ZAN-Tech-bd/WRO_Rizwanul-Rafeeul-Luban/PCB design/hub/RELEASE-2026-10-28.md

# Hub — repour after the user's final edits, 2026-10-28

> **Historical snapshot:** the synchronization finding in this review was subsequently traced to
>25J3property mismatches and fixed; [strict DRC/ ERC now pass](SYNC-FIX-2026-10-28.md). The user also
> added a raster image. [Latest standard files and the image-export warning](fabrication/20261028-sync-fixed/README.md)
> supersede this folder for the current board. The previous geometry/hardware evidence remains relevant.

## Current files and release status

**The ground is restored and the new fabrication files are generated.** The geometric checks below
pass for a **two-layer, 1 oz, hand-soldered bare PCB**. This is a fabrication-review package, not an
unconditional production release: one schematic/PCB synchronization finding remains, and the switch
fit/contact sequence and full-load thermal performance have not been physically qualified.

- [Latest Gerber ZIP](fabrication/20261028-after-user-edits/WRO_HUB_GERBER_20261028_AFTER_USER_EDITS.zip)
- [Matching complete project](fabrication/20261028-after-user-edits/WRO_HUB_PROJECT_20261028.epro2)
- [Raw EasyEDA BOM](fabrication/20261028-after-user-edits/WRO_HUB_RAW_BOM_20261028.csv)
- [Native geometry/preservation audit](fabrication/20261028-after-user-edits/AUDIT.json)
- [Gerber/drill/BOM inspection](fabrication/20261028-after-user-edits/MANUFACTURING-INSPECTION.json)
- [Checksums](fabrication/20261028-after-user-edits/SHA256SUMS.txt)
- [Independent review and verification-tool follow-ups](fabrication/20261028-after-user-edits/REVIEW.md)

These supersede all October 27 Gerbers. Earlier files actually written by the old finalizer were
under the repository-root `exports/`, despite some old handoff links saying `PCB design/exports/`.
Use only the dated folder linked above for this revision. Do not fabricate a pour-removed checkpoint
or either failed custom-device import package.

Current editable project remains **WRO_HUB_REPAIR_ISOLATED_20261027**, local file
[recovered/WRO_HUB_REPAIR_ISOLATED_20261027.eprj2](recovered/WRO_HUB_REPAIR_ISOLATED_20261027.eprj2).
Project UUID `ea32443fed8f1fd5989b3f8520da07a81d65c35e38ca7f144b04f7dc31730e1f`,
PCB UUID `8efe5b895e7646ea`, schematic UUID `a013c67bfde245d3`.
The original WRO_HUB project has damaged device metadata and is not the working copy.

## What the user changed; what the repour changed

The fresh pre-pour backup is
[WRO_HUB_REPAIRED_user_edited_20261027-2358.epro2](WRO_HUB_REPAIRED_user_edited_20261027-2358.epro2).
Relative to the pour-removed editing checkpoint, the user moved R5 to **(1605, 1305) mil, rotation 90°**,
rerouted SERVO_IN, SD_SCK and part of +5V, and moved the SD_SCK via. Ten tracks were added, seven
removed; pad-net assignments remained unchanged. R5 remains outside the modeled microSD-module strip.
The previous agent placement at (1890, 1335) is historical, not the current pose.

The agent regenerated GND from these edited native footprints, pads, tracks and vias. It did **not**
restore old polygons or move any component/via/route. Final snapshot:
[WRO_HUB_REPAIRED_repoured_20261028-0009.epro2](WRO_HUB_REPAIRED_repoured_20261028-0009.epro2).

Preservation was checked across all **86 project documents**:

- **2,331 GND fills added:** 682 top, 1,649 bottom.
- All 633 copper track bodies match the user's backup exactly as a multiset.
- Two +5V track IDs changed while their bodies remained identical; a batch guard stopped first.
  Only after full geometry equality was established was the guard refreshed and the pour resumed.
- Other non-fill bodies, including all placements, pad nets, footprints, source nets, schematic and
  device metadata, are unchanged. Allocator records changed as expected when fills were created.

## Current measured checks

| Check | Current result |
|---|---|
| Parts / component plus mounting pads / copper tracks / vias | 77 / 274 / 633 / 280 |
| Named nets | 74; all named routed networks connected, including the regenerated GND |
| Current schematic versus current PCB | **256 named pin memberships match**, zero differences |
| Fresh ERC | **true**, detailed findings empty |
| Strict PCB DRC | **0 physical findings; 1 Netlist Error / Import Changes finding** |
| Saved GND versus foreign copper | 0 overlaps, 0 clearance violations, 0 disconnected GND items or floating fill-only islands |
| Minimum new-fill clearances | 11.8998 mil normal, 39.8989 mil left, 49.8996 mil isolated source nets |
| GND to edge / conservative antenna keep-out | 16.0 mil / 7.9131 mil |
| Minimum other-net copper spacing | 0.152001 mm; four legacy pairs are just below nominal 6 mil but above JLC 1 oz 0.10 mm |
| Existing non-fill copper to board edge | 0.9130 mm minimum |
| Drill spacing / hole-to-foreign-copper limits | zero violations against checked 0.20/0.45 mm and 0.20/0.28 mm limits |
| Minimum component PTH ring | Q1, approximately 0.1825 mm; absolute 0.18 mm met, recommended 0.25 mm not met |
| Minimum existing via ring | 0.1525 mm (reported separately from component PTH rings) |
| Visible text | 187 objects; native size/stroke >=40/6 mil, measured pad/text/edge bounds pass |
| Actual antenna extension | no existing copper or new GND in the modeled radiating projection |

The plane design targets remain **12 mil normal / 40 mil left-power region / 50 mil to
BAT+/BAT−/DC+/DC−/V12**. The small differences in measured minima are polygon simplification/rounding
covered by a 0.2 mil geometric tolerance. Native pad offsets are below 0.007 mil; this is also much
smaller than that tolerance. These large new-plane gaps do not imply every pre-existing trace/via
in the power area has 1 mm spacing. BAT− and DC− remain distinct from GND except through J3.

The morphological filter discourages narrow plane features; it is **not** proof that every local
neck or thermal path meets a specified current capacity. Geometric connectivity does not qualify 8 A.

Rules were checked against [JLCPCB capabilities](https://jlcpcb.com/capabilities/Capabilities), using
the previously reviewed two-layer 1 oz limits. Changing to 2 oz needs another review: the 0.152 mm
legacy gaps do not meet the cited 0.16 mm 2 oz spacing.

## What was checked in the actual manufacturing output

- ZIP integrity and the exact expected 11-file set.
- Gerber outline is one closed rectangle, **136.398 × 100.965 mm**, bounds x −17.145..119.253 mm,
  y 0..100.965 mm; stale native outline line records are not extra exported outlines.
- **All 548 round holes and six plated slots** match native positions and dimensions. The standard
  separate via-drill file contains the same 280-via subset already present in the through-drill file.
- J1/J2/J4 have their approved **4.0 mm** drills; J5 has **2.5 mm** drills. Corrected Q1 copper aperture
  is present in the actual top-copper Gerber, not merely in editor getters.
- All six J3 slots are explicitly marked **PLATED**, 1.8 mm diameter with a 6.0 mm tool-centre travel:
  **7.8 mm total slot length**, matching the custom footprint and all six preserved pad-net assignments.
  Complete capsule geometry, including orientation, is matched one-to-one against native slot shapes.
- Raw BOM quantity totals 77 and J3 identifies as KCD4-203-B, without the old C20088586 supplier number.

## Remaining release gates — do not hide these

1. **Synchronization:** strict DRC is not entirely clean. There is one generic Netlist Error. Current
   electrical membership matches at every named pin, and native preservation is proven, but the API
   cannot enumerate the exact ECO discrepancy here; the direct PCB netlist call timed out. J3's
   retained library association and old BOM footprint alias are known metadata debt, not proof that
   this is the sole reason for the finding. Inspect the proposed differences manually before any
   full production release; do not apply an ECO that replaces J3's six custom plated slots. No
   schematic import, rule suppression, device standardization or library modification was used.
2. **Real parts / assembly:** verify KCD4 blade fit with a 1:1 print or actual prototype, slot tolerance
   with the fabricator, mechanical support and break-before-make/centre-off behavior. Retain the six
   pin/net mapping in the spec. Confirm the actual microSD module envelope/underside clearance and
   Q1 lead order. The BOM's SS8050 library alias is not the approved user-supplied 2N2222A selection.
3. **Power qualification:** source-track width, GND connectivity and thermal spokes do not prove the
   intended ≈8 A worst-case load safe. Measure voltage drop and temperature, including connectors,
   switch, vias and thermal necks, on the assembled prototype. No switch or PCB current rating is claimed.
4. **Human fabrication review:** inspect JLC's rendered layer/drill/slot preview and the complete PCB
   visually. No order, payment or procurement has been performed.

The Gerber is suitable for **fabrication review of this prototype geometry**. It is not labeled
"all blockers resolved" or "unconditionally safe to order" while the above checks remain open.

An independent read-only review confirmed the current package geometry and prompted two strengthened
acceptance checks (slot orientation/bijection and fill-only island rejection). Both fixes were verified
RED→GREEN without changing the PCB. Two minor checker improvements remain explicitly deferred;
see [the review record](fabrication/20261028-after-user-edits/REVIEW.md).

## How to reproduce the checks

Read the source headers before running anything. The release scripts are intentionally pinned to
this revision; never replay a historical writer on a newer user layout.

The final full Hub model suite reports **54 tests: 41 passed, 13 skipped**. The skips are historical
archive-acceptance cases requiring explicit before/after fixture paths, not executed passing tests.
The current release is checked separately by the direct archive/pin/geometry/output audits. Four
focused release regressions cover identity/body preservation, metric drill parsing, rotated/reused
slot rejection and fill-only island rejection.

- [release_audit_20261028.py](../scripts/hub/release_audit_20261028.py): saved-body preservation,
  ground/track/hole/ring/edge/connectivity/text checks and current schematic pin-net comparison.
- [publish_fabrication_20261028.py](../scripts/hub/publish_fabrication_20261028.py): actual Gerber/drill
  inspection and uniquely named package; retains raw BOM and its aliases rather than inventing parts.
- Current evidence and test logs: [release_20261028](../scripts/hub/data/blocker_fix_20261027/release_20261028/).
- Reusable [PCB review lessons](../PCB-REVIEW-LESSONS.md), especially the recovery/API and release gates.

For another edit cycle: full backup, fresh native and live snapshots, recompute the plan from the
edited geometry, guard every write, inspect a new saved export, rerun current checks, create a new
dated manufacturing folder, and mark this folder superseded. Do not overwrite old review evidence.
