ZAN-Tech-bd/WRO_Rizwanul-Rafeeul-Luban/PCB design/station/REVIEW-2026-10-26.md

# Station manual-layout review — 2026-10-26

> **RELEASED 2026-10-28:** findings 1–2 closed (J1 designator moved off the HUB CABLE label;
> identifier corrected to "Station PCB V0.4"); finding 4 closed — fresh Gerber/drill exported and
> CAM-audited into [fabrication/20261028-final/](fabrication/20261028-final/README.md) with a
> clean strict DRC in the same run. Copper untouched (59 tracks / 1 via / 209 fills verified).
> Findings 3 and 5 remain **hardware gates for the user** (1:1 print fit, BC557 C/B/E, buzzer
> polarity, bring-up). Upload set: `STATION_GERBER_20261028_FINAL.zip`.

## Verdict

The redesigned routing and regenerated bottom ground plane **pass the electrical layout checks performed**. No
electrical routing blockers were found. This is a prototype layout review, **not unconditional manufacturing approval**:
one silkscreen overlap needs cleanup, physical component fit/pin order still need confirmation, and the exported
Gerber/drill files have not been independently audited for this revision.

## Changes made

- Added bottom-only GND copper, regenerated from the user's current geometry rather than restoring stale polygons.
- Added 209 static, hole-free GND fill pieces. Together these form one electrically continuous network, not 209
  disconnected islands. Area: approximately 1246.57 mm².
- Thermal reliefs on all seven THT GND pads: nominal 10 mil gap and 15 mil spoke width.
- Saved the editor document. Made full project backups before and after; both archives passed integrity checks.
- **Preserved:** all 59 user track segments, one DIN via, eleven components, pads, board outline and silk polylines.
  Before/after geometry comparisons passed. Silkscreen text was not edited.

## Verified results

| Check | Result |
|---|---|
| Actual outline | 50.8 × 31.877 mm, two layers |
| Current strict EasyEDA DRC | Passed; zero error categories, including no unrouted connections |
| Pad net assignments vs station spec | Match; 12 nets, 34 wired pads, J4.4 intentionally NC |
| All 11 non-GND nets | One physically connected copper network each |
| Ground connectivity, including actual read-back fills | One network; BZ1.2, J1.2, J2.2, J3.2, J4.2, R3.2, U2.2 joined |
| Track/pad/via clearance below 6 mil | None detected by independent geometry checks |
| Copper-to-edge, mounting-hole, drill-spacing checks | No reported violations |
| Checked JLC drill-to-other-net copper rules | No reported violations |
| 5V and 3V3 track widths | 1.0 mm throughout; no thin power segments flagged |
| Component-pad annular ring | Minimum approximately 9.85 mil |
| Ground fill vs other-net copper | Zero overlaps; zero gaps below 10 mil |
| Ground fill vs board edge | Minimum 12 mil (0.3048 mm) |
| Read-back fill shape vs generated plan | 209/209 matched; no shape differences above 0.3 mil |
| Ground floating islands | None detected |
| Connector / rotated BC557 C-B-E labels | Coordinate/pad-map spot-check agrees |
| Silkscreen text on pads, holes or beyond the edge | None reported |
| Live-geometry adapter regression tests | Seven passed |

## Findings and remaining work

1. **Silkscreen cleanup:** J1's reference text overlaps **HUB CABLE (1:1)**. Move one label before fabrication. This does
   not affect electrical connectivity. The review did not change the user's labels.
2. **Identification:** the team marking is present, but no board name/revision string was found among the live silk
   text. Add an identifier to distinguish this manual layout from the older v0.4 geometry.
3. **Physical checks:** print 1:1 and check the actual upright IR module, cable access, connector orientation and screw
   heads. Confirm the purchased BC557's actual C/B/E order and the active buzzer's polarity. Geometric net checks do
   not validate a different locally purchased transistor/module pin-out.
4. **Fabrication gate outstanding:** export fresh Gerber/drill files and independently inspect them, especially GND
   copper and thermal spokes. No manufacturing files were approved or ordered during this review.
5. **Bring-up still required:** continuity/short tests before power, verify 5V/3V3 rails, then test the sensors, buzzer
   and LED chain per the [station specification](STATION-SPEC.md). Current capability and signal integrity have not
   been physically measured; 1.0 mm power tracks are encouraging but are not a thermal test or regulator/cable audit.

## Important: static ground copper

The existing bridge/pour-engine limitation is handled with static fill primitives and an independent read-back check.
These fills do **not automatically move out of the way of later track, via, pad or outline edits**. Regenerate from a
fresh live snapshot and recheck them after every such change. Restoring old polygons or merely rebuilding native
copper is not a safe substitute. The newly generated writer checks its source geometry immediately before writing
and refuses intervening changes. Historical placement/route/fill scripts do not describe this manual revision.

## Decisions and provenance

- User's manual placement/routing is the baseline; do not redraw or optimize it during a pour/review request.
- Keep the previously requested bottom-only GND policy. No extra GND vias or top copper were added.
- Reuse the existing thermal/fill algorithms, but supply absolute live pad geometry, the shortened outline and moved
  mounting holes. The old layout model would have poured against incorrect geometry.
- Use the absolute pad API's drill state: component-pad proxy drill values differed from absolute pad values in this
  editor. The adapter explicitly rejects the proxy format and unknown geometry rather than silently estimating it.

## Files and reproducibility

- Full project: [before GND](station_pcb_manual_before_gnd_20261026.eprj2),
  [reviewed with GND](station_pcb_manual_gnd_reviewed_20261026.eprj2).
- Exact live state: [before](../scripts/station/data/snapshot_before_gnd_20261026.json),
  [after](../scripts/station/data/snapshot_after_gnd_20261026.json).
- Read-only capture: [31_snapshot](../scripts/station/31_snapshot.js).
- Snapshot-based model: [manual_model](../scripts/station/manual_model.py),
  [regression tests](../scripts/station/test_manual_model.py).
- Offline review/generation: [32_review_manual](../scripts/station/32_review_manual.py).
- Machine-readable result: [geometry review](../scripts/station/data/manual_review_20261026/snapshot_after_gnd_20261026_review.json),
  [strict DRC](../scripts/station/data/manual_review_20261026/drc_after.json),
  [silkscreen](../scripts/station/data/manual_review_20261026/silkscreen_after.json).
- Images: [pour preview](../scripts/station/data/manual_review_20261026/data/fill_preview.png),
  [editor view](../scripts/station/data/manual_review_20261026/editor_after_gnd.png).
- Generated writer and polygon plan are kept in the
  [review artifact folder](../scripts/station/data/manual_review_20261026/). Do not apply them to changed geometry.
