ZAN-Tech-bd/WRO_Rizwanul-Rafeeul-Luban/findings.md

# Project Audit Findings

## 2026-08-13 — Primary Hub synchronization baseline

- The requested direction is one-way: use [`firmware/hub-ota/`](firmware/hub-ota/) as the newest feature reference and update [`firmware/hub/`](firmware/hub/) with all non-OTA behavior.
- The explicit exclusion boundary includes BLE OTA service code, NimBLE, authentication/password constants used only by OTA, uploader tooling, OTA write/pause hooks, and the dual-slot custom partition table. Generated `.pio` content is never a synchronization source.
- Initial Git baseline is clean: both `git diff --stat` and `git diff --cached --stat` are empty. This makes the coming Hub-only changes attributable to this synchronization task.
- Existing planning records show that the newer copy contains at least one post-copy feature family not present in the primary Hub documentation: the Hub DHT11/MQ pin scan, firmware-served `/scan` page, `/api/sensors`, sensor-to-artifact-health mapping, and corresponding admin UI. Exact file-level differences still require source classification before porting.
- Exhaustive non-generated inventory found 11 byte-identical shared files, including every deployed file under [`firmware/hub/data/`](firmware/hub/data/), [`PhotoStore.h`](firmware/hub/include/PhotoStore.h), and [`PhotoStore.cpp`](firmware/hub/src/PhotoStore.cpp). The browser bundle and gallery layer therefore need no byte changes.
- Exactly five shared paths differ: [`README.md`](firmware/hub/README.md), [`MuseumState.h`](firmware/hub/include/MuseumState.h), [`config.h`](firmware/hub/include/config.h), [`main.cpp`](firmware/hub/src/main.cpp), and [`platformio.ini`](firmware/hub/platformio.ini).
- Exactly seven non-generated/newer-only files were found. Two are reusable sensor implementation files ([`HubSensors.h`](firmware/hub-ota/include/HubSensors.h) and [`HubSensors.cpp`](firmware/hub-ota/src/HubSensors.cpp)); five are OTA-only/generated exclusions ([`ble_ota.h`](firmware/hub-ota/include/ble_ota.h), [`ble_ota.cpp`](firmware/hub-ota/src/ble_ota.cpp), [`partitions.csv`](firmware/hub-ota/partitions.csv), [`ble_ota_upload.py`](firmware/hub-ota/tools/ble_ota_upload.py), and its Python bytecode cache).
- [`MuseumState.h`](firmware/hub-ota/include/MuseumState.h) extends health rows with per-channel validity and simulated/interpolated provenance, and adds the fixed-size per-pin sensor scan table. These are application-domain changes, not OTA mechanics, and belong in the primary Hub.
- [`config.h`](firmware/hub-ota/include/config.h) contains a large reusable sensor configuration section followed by a clearly isolated BLE-only tail. The sensor section must be ported; the `BLE_DEVICE_NAME`, `BLE_MTU`, `BLE_OTA_PASSWORD`, and `BLE_OTA_STALL_MS` tail must not be ported.
- One diagnostic `wc` command used shell brace syntax that the executor did not expand, so its line-count subcheck failed without changing files. Do not repeat that form; use explicit paths or a Python inventory. The surrounding diff/grep operations still completed and exposed the needed classification.
- Function-level comparison of [`main.cpp`](firmware/hub/src/main.cpp) identifies only three actual OTA couplings in the newer entry point: the [`ble_ota.h`](firmware/hub-ota/include/ble_ota.h) include, the [`bleOtaBegin()`](firmware/hub-ota/src/main.cpp:1123) setup call, and the [`bleOtaInProgress()`](firmware/hub-ota/src/main.cpp:1182) Core-1 pause guard. Two nearby `/scan` comments also mention BLE deployment but do not affect behavior. This makes a copy-then-remove strategy precise and reviewable.
- All other entry-point changes are reusable application features: 56-pixel chain ownership and brightness, whole-station 8-pixel indication, idle color-flow effect, synchronized red emergency double-flash, local sensor state integration, null-safe health JSON with provenance/air-quality verdicts, sensor JSON, firmware-resident scan UI, two new HTTP routes, sensor initialization/update, and seven-station measured/interpolated health filling.
- [`HubSensors.cpp`](firmware/hub-ota/src/HubSensors.cpp) has no OTA dependency. It implements separate safe paths for DHT11 timing probes and MQ D0/ADC1 observation, explicit continuity/electrical-result diagnostics, mapped artifact-health updates, and derived rows for unmapped/stale stations. It depends only on the reusable sensor/state/config declarations and belongs unchanged in the non-OTA target.
- The reusable [`config.h`](firmware/hub-ota/include/config.h:19) delta is larger than sensors alone: it changes the physical LED chain from one pixel per station to 56 pixels (seven 8-pixel boards), adds a global brightness cap, idle comet timing, and synchronized red emergency double-flash timing. The configured sensor loom is eight GPIOs with explicit DHT11/MQ roles, per-pin artifact mapping, D0 polling, gas threshold/calibration constants, and stale-data timing. The BLE-only section begins cleanly at line 213, after all shared gallery configuration.
- [`MuseumState.h`](firmware/hub-ota/include/MuseumState.h:14) is entirely reusable and has no OTA symbols. Its health model prevents unmeasured channels from appearing as zero, records measured-versus-derived provenance and freshness separately for temperature/humidity and gas, adds the complete Hub-local pin state, and exposes [`healthRowLocked()`](firmware/hub-ota/include/MuseumState.h:100) for safe partial-channel updates.
- README classification is clean: copy the newer wiring/sensor diagnostics and API schema, retain the primary target's USB build/flash instructions, and omit the entire Bluetooth update and custom dual-slot partition chapters. Two sensor/scan sentences that currently describe BLE-only deployment must be rewritten generically for a firmware-resident route; the API should not claim a “BLE-only update.”
- [`platformio.ini`](firmware/hub/platformio.ini) needs no dependency or partition change: its existing single [`env:hub`](firmware/hub/platformio.ini:11), default partition behavior, LittleFS setting, common include path, and Adafruit NeoPixel dependency are sufficient for all reusable features. The newer common-section refactor, custom partition selection, and NimBLE dependency are OTA infrastructure and must stay out.
- During integration review, the newer [`MSG_HEALTH`](firmware/hub/src/main.cpp:206) path was found to populate numeric fields without setting the new `hasTH`/`hasGas`, provenance, or freshness fields. Under the new JSON/derivation model this would hide valid remote readings as `null` and let synthetic fallback overwrite them. The primary non-OTA target now marks both channels measured/fresh when a valid ESP-NOW health packet arrives. This is a compatibility fix required by the newer state model rather than an OTA exclusion.
- A clean project-owned exclusion audit scanned all 18 files under [`firmware/hub/`](firmware/hub/) while pruning `.pio` and `__pycache__`. All four forbidden paths are absent; core source/configuration assertions found no BLE service symbols, NimBLE/Bluetooth dependency, BLE-only constants, custom partition selection, uploader protocol, or OTA pause hook.
- The scoped text audit found one generic `OTA` word in a multipart-upload explanatory comment, not executable integration. It was reworded as a normal WebServer file-upload comment so the final source-level exclusion audit can require zero BLE/OTA candidates without exceptions.
- Initial mechanical parity already proves exact path accounting (18 primary files versus 18 reusable reference paths), SHA-256 equality for all 14 ordinary reusable files, and exact equality between the primary configuration and the reference prefix before its BLE-only section. Its first entry-point normalization stopped because the audit encoded the wrong literal formatting for the three known seams; source search confirmed the reference uses an inline-commented include, a commented setup call, and a one-line pause guard.
- Corrected mechanical entry-point normalization asserted and removed exactly one include, one setup call, and one Core-1 pause guard from the reference. The complete residual diff has only four expected hunks: the intentional `MSG_HEALTH` validity/provenance/freshness correction, the generic multipart-upload comment rewrite, the firmware-resident `/scan` deployment comment rewrite, and deletion of the now-orphaned flash-write pause comment. No reusable executable behavior is missing.
- Clean firmware build succeeds on the default non-OTA partition: Flash 71.8% (941,741 / 1,310,720 B), RAM 14.8% (48,528 / 327,680 B). The PlatformIO dependency graph resolves `Adafruit NeoPixel @ 1.15.5` plus the Arduino Wi-Fi/WebServer/LittleFS/SD/DNS stack only; `h2zero/NimBLE-Arduino` is absent, proving the OTA dependency did not transfer.
- LittleFS image builds from the 318,566-B data tree (9 files) into a 1,441,792-B `littlefs.bin`, so the deployed web bundle and optional SD-backed gallery remain valid under the unchanged [`platformio.ini`](firmware/hub/platformio.ini:1).
- Final `git status` scope is seven modified paths plus two new sensor-module files; [`firmware/hub-ota/`](firmware/hub-ota/) is untouched, so the feature reference is preserved for future comparison.
- Full review of [`firmware/hub/README.md`](firmware/hub/README.md) confirms it documents the reusable 56-pixel station boards, double-flash emergency display, explicit DHT/MQ roles and electrical limits, station mapping and measured/derived health semantics, firmware-resident `/scan`, expanded `/api/sensors` schema, and ordinary USB firmware/filesystem deployment. Its omission of the reference copy's BLE update and custom-partition chapters is intentional.
- Synchronization is complete: all five HUB-SYNC phases done, both builds pass on the default non-OTA partition, and the working tree contains only the intended Hub product files and planning records.

## 2026-08-11 — Diagram 6 production restoration

- Locked outputs are [`diagrams/06_protocol_interface_contract_map.drawio`](diagrams/06_protocol_interface_contract_map.drawio) and [`diagrams/06_protocol_interface_contract_map.png`](diagrams/06_protocol_interface_contract_map.png), with exact title `06 — Protocol & Interface Contract Map`.
- This is the sixth and final new parent-suite page. Accepted Diagrams 1–5, every alternate Draw.io/PNG pair, and [`diagrams/README.md`](diagrams/README.md) are immutable. [`diagrams/09_message_reference.drawio`](diagrams/09_message_reference.drawio) is a non-authoritative, ownership-unknown reference only and will not be edited, cloned, renamed, or claimed.
- The restored visual system is 1600×900 off-white landscape with 28 px navy title, current-source authority chip, rounded tinted subsystem cards, restrained shadows, transport-colored orthogonal connectors, compact code-font pills, white-backed labels, and line/text status semantics that remain understandable in grayscale.
- The restored working-combo interface matrix requires explicit separation of effective Hub→Robot EMERGENCY, ignored Camera IMAGE_READY, senderless Robot LOCATION, active Robot↔Nano UART, active one-way Robot→Camera SHOOT, active Camera→Hub multipart upload, independent Hub and Robot SoftAP/HTTP services, and standalone Mega commands with no runtime sender.
- Diagram 6 will be organized by transport rather than by controller. A field-diagnostic matrix will identify payload/contract, emitted-by, accepted-by, consumed/effect, and status; a bottom strip will carry channel/common-ground/authority/no-link constraints.
- Fresh shared-header verification corrects an important checklist mismatch: current [`MuseumMessage`](firmware/common/MuseumProtocol.h:36) is packed and exactly 24 bytes by field arithmetic, with wire order/types `uint16_t magic`, `uint8_t version`, `uint8_t messageType`, `uint8_t nodeId`, `uint8_t stationId`, `uint8_t flags`, `uint8_t reserved`, `int16_t tempX10`, `int16_t humidX10`, `uint16_t gasRaw`, `uint16_t visitorCount`, `uint16_t sequence`, `uint32_t uptimeMs`, `uint16_t checksum`. It does **not** contain literal `robotMoving` or generic `value` fields; motion is encoded by `FLAG_ROBOT_MOVING`. The diagram must follow this current source rather than repeat a stale field list.
- Packet validity is exact-length enforcement at each current receiver plus [`isValidMessage()`](firmware/common/MuseumProtocol.h:75): magic `0x4D53`, protocol version `1`, and 16-bit additive checksum over every byte before the checksum field. The packed declaration has no explicit `static_assert(sizeof(...))`; the 24-byte result is the source layout's field sum and is also enforced by receiver `sizeof` checks.
- The shared declaration contains seven message types: `MSG_LOCATION=1`, `MSG_EMERGENCY=2`, `MSG_HEALTH=3`, `MSG_VISITOR_COUNT=4`, `MSG_IMAGE_READY=5`, `MSG_COMMAND=6`, and `MSG_HEARTBEAT=7`. Flags are emergency bit 0, obstacle bit 1, alert bit 2, online bit 3, and robot-moving bit 4. Diagram emphasis will remain on the four working-combo-relevant types while labeling the remaining declared types as dormant in this protected combination.
- Robot↔Nano is confirmed as 9600 8N1, newline-delimited, case-insensitive at the Nano. Robot emits `START`, `STOP`, `GET`, `SET ML n`, `SET MR n`, and `SAVE`; Nano additionally accepts manual aliases `MAN`, `1/F/G/W`, `0/S/X`, plus `LOAD`, but the protected Robot does not emit those aliases.
- Nano replies are `READY:STOPPED`, `STATE:RUNNING`, `STATE:STOPPED`, `TUNE ML=n MR=n`, `OK ML=n`/`OK MR=n`, `SAVED`, `LOADED` or `LOAD:NONE`, and `ERR:SYNTAX`/`ERR:KEY`/`ERR:UNKNOWN …`. Robot behaviorally consumes only READY/STATE, valid TUNE, and any `ERR:` (to clear pending); `OK`, `SAVED`, `LOADED`, and other lines are retained in the bounded event log but otherwise ignored.
- ML/MR are constrained to `0..255`; each valid SET emits `OK` then a complete `TUNE`, applies both channels immediately when already driving, and SAVE persists EEPROM magic `0x524C` plus both `int16_t` values. Robot's service UI treats only valid `TUNE` as confirmed; requested web values remain pending until the complete reported pair matches.
- Robot→Camera is source-proven one-way `SHOOT <station>\n`, station `1..7`, 9600 baud, Robot software TX GPIO14 to Camera UART RX GPIO13. Robot has no receive/acknowledgement path. This is the active correction to stale GPIO27 documentation.
- Robot's independent service SoftAP is `ESP32-MP3-RAIL` on channel 1. Its HTTP surface is `GET /`, `GET /api/state`, and POST `/api/volume?v=0..30`, `/api/motors?ml=0..255&mr=0..255`, `/api/motors/save?...`, and `/api/log/clear`; motor calls return pending HTTP 202 until Nano `TUNE` confirms, while log clear removes the bounded RAM event tape.
- Fresh Hub configuration verification fixes the browser/radio plane constants at SoftAP `MuseumHub`, WPA2 password `museum2026`, IPv4 `192.168.4.1`, and channel `1`; [`HUB_CHANNEL`](firmware/hub/include/config.h:12) is explicitly shared by SoftAP and ESP-NOW. [`STATION_COUNT`](firmware/hub/include/config.h:17) is `7`, [`GALLERY_MAX_PHOTOS`](firmware/hub/include/config.h:74) is `12`, and optional SD storage falls back to LittleFS rather than becoming an upload or motion dependency.
- Camera's shared dispatcher accepts service/bench commands `CAPTURE [station]`, `SHOOT [station]`, `SEND [station]`, `WIFI`, `AUTO <ms>`, `STATUS`, `LIST`, `INIT`, `FLASH ON|OFF`, and `HELP` from its USB console as well as its Robot-UART parser. The active Robot implementation emits only `SHOOT <station>`; Diagram 6 must not imply it emits the rest of the Camera service vocabulary. [`handleCommand()`](firmware/cam/src/main.cpp:405) also proves Robot-triggered `SHOOT` requires Hub Wi-Fi before capture, whereas `CAPTURE` can remain local-only.
- Camera capture is GC2145 RGB565 converted in software with `frame2jpg()`, retained as the latest JPEG in RAM, and optionally backed up to local SD. The active Camera→Hub contract is HTTP POST multipart/form-data to `http://192.168.4.1/api/image/upload?station=N`, exact part name `image`, filename `cam.jpg`, MIME `image/jpeg`, and boundary `----MuseumCamBoundary`; Camera treats HTTP `200` as success and does not consume the response JSON.
- After a successful HTTP upload, Camera optionally broadcasts a checksum-valid `MSG_IMAGE_READY` as node `10` over the unencrypted broadcast peer. Hub's exact-length/checksum ingress accepts and queues that packet, but [`processMessage()`](firmware/hub/src/main.cpp:172) has no `MSG_IMAGE_READY` case, so it has no behavioral effect and must be styled active-but-ignored rather than as upload confirmation or motion feedback.
- Current Hub packet behavior is deliberately narrower than the declared vocabulary: it consumes `MSG_LOCATION`, `MSG_EMERGENCY`, and `MSG_HEALTH`; actively emits `MSG_EMERGENCY`; and defaults all other valid types to no effect. No protected rail-Robot `MSG_LOCATION` sender exists, so that handler is senderless in the working combination. There is no packet authentication, encryption, sender allowlist, replay rejection, application acknowledgement, or guaranteed delivery.
- Hub HTTP groups are state (`GET /api/state`), visitor workflow (`POST /api/checkin`, `GET /api/enter`, `GET /api/request?id=...`, `POST /api/approve?id=...`, `POST /api/deny?id=...`), emergency/admin (`POST /api/emergency?on=N`, test-only `POST /api/robot/advance`), and images (`POST /api/image/upload?station=N`, `GET /api/image[?seq=N]`, `GET /api/gallery`, `POST /api/gallery/clear`) plus static/captive content. These Hub APIs are independent from the Robot's own SoftAP service APIs and have no direct Camera/HTTP authority over Nano motion.
- Hub multipart intake requires exact field `image` and MIME `image/jpeg`, enforces the source-defined `65,535`-byte maximum while streaming, checks saved-byte equality and JPEG SOI/EOI markers, then commits before returning HTTP `200` JSON `{ok,bytes,station,seq}`. This is framing/completeness validation, not a full JPEG decode. Current station parsing accepts `0..7`; an absent/out-of-range query retains station `0` rather than rejecting an otherwise valid upload.
- Fresh Hub setup/static verification confirms wildcard DNS on port `53`, exact SoftAP startup on channel `1`, a 16-entry ESP-NOW queue, an unencrypted AP-interface broadcast peer, and route registration matching the handler inventory. Static LittleFS responses are explicitly no-cache; recognized captive-probe paths redirect to `http://192.168.4.1/`, while unknown paths return `404`.
- The deployed browser adapter selects the real backend only when [`location.hostname === "192.168.4.1"`](firmware/hub/data/js/hub.js:14); every other host/file origin uses a localStorage mock. Real browser state uses `GET /api/state` every `1500 ms`; visitor check-in/request, approve/deny, emergency, test advance, gallery/image, and clear calls match the registered Hub methods. Mutating calls are fire-and-forget and ordinary polling refreshes the UI; there is no WebSocket/SSE push or route authentication in this interface.
- Fresh standalone-Mega verification confirms both USB `Serial` and link `Serial1` accept newline-delimited commands at `9600` baud and dispatch through the same case-insensitive parser. The vocabulary is `FACE [HAPPY|NEUTRAL|ALERT|SLEEPY]`, `LANG <0|1>`, `STATION <id> <moving 0|1>`, `MENU`, `EMERGENCY`, and `BOOT|RESET`; unknown commands are ignored and logged to USB.
- Mega's implementation is a standalone renderer with no Wi-Fi or ESP-NOW. `Serial1` uses Mega pins `18/19`; comments propose ESP32 GPIO17 TX→Mega RX1 pin 19 with a 1 kΩ series resistor and common ground. However, the protected rail Robot assigns GPIO16/17 to DFPlayer UART2 and a fresh search finds no display-command sender in [`ESP32_RFID_MP3_RAIL/`](ESP32_RFID_MP3_RAIL/). Diagram 6 must therefore render the vocabulary as standalone/no active Robot sender and explicitly flag the GPIO16/17 ownership conflict instead of presenting a live wire.
- Mega parser bounds are permissive and must be represented accurately: `LANG` maps exactly `1` to Bangla and every other parsed/missing value to English; `STATION` does not reject malformed/out-of-range ids before rendering and shows `Unknown` outside `1..7`; its moving argument is Booleanized by nonzero `toInt()`. `FACE` defaults to happy when the optional emotion is absent or unrecognized. There is no UART acknowledgement/reply contract back to a Robot despite TX1 being physically available.
- Repository-wide sender search distinguishes protected working-combo authority from legacy/skeleton projects: the protected rail Robot contains no `esp_now_send`, `makeMessage`, or `MSG_LOCATION` emission; the only protected current sends are Hub `MSG_EMERGENCY` and Camera `MSG_IMAGE_READY`. A different legacy [`ESP32_RFID_MP3_LFR/`](ESP32_RFID_MP3_LFR/) source does emit LOCATION, but it is not the audited rail Robot and must not be used to activate the Diagram 6 edge. Skeleton emergency/health projects likewise do not expand the five-project working combination.
- Fresh deployed-page search confirms native QR entry uses exact URL `http://192.168.4.1/api/enter`; the visitor page polls request state and subscribes to the shared Hub cache; the admin page invokes approve/deny, emergency toggle, test-only robot advance, gallery list/image/clear, and the same 1.5 s state subscription. This locks the Browser↔Hub section to deployed calls rather than generic REST claims.

## 2026-08-11 — Diagram 5 production completion

- Published locked targets: [`diagrams/05_hub_software_concurrency_data_architecture.drawio`](diagrams/05_hub_software_concurrency_data_architecture.drawio) (51,314 bytes; SHA-256 `1574c3aa5d1fc8fc8b0d1eff837ddcbc4432938ad8a4c9dea7712a9562be3f97`) and [`diagrams/05_hub_software_concurrency_data_architecture.png`](diagrams/05_hub_software_concurrency_data_architecture.png) (1604×889, 373,921 bytes; SHA-256 `9b2c98aea7f42cd2adfbda3a84fbec8c546f9159c7cbaba1bd0f904ce871ad34`).
- The page is a single uncompressed Draw.io page (ID `EFE4jHzBdEskxg9Ux6jI`, `pageWithNumber`, ~51,171 page bytes) authored through official `@drawio/mcp` 1.5.0 `open_drawio_csv` and persisted/exported by official Draw.io Desktop 31.1.8. No Draw.io XML, Graphviz, or Mermaid was hand-authored; a deterministic Python generator emitted the CSV and a layout/edge pass applied geometry + materialized edges from the same MCP-imported model.
- Composition: five layered vertical zones — External actors (Visitor/Admin browsers on SoftAP `MuseumHub` @ `192.168.4.1`, ESP32-CAM multipart STA upload, GPIO21 button, rail Robot consumer), Core 0 `webTask` (captive DNS, WebServer, grouped HTTP routes, MultipartImageHandler, state read model), Callback boundary + synchronized state (recv cb → 16-slot queue → `processMessage`, mutex-protected `MuseumState`), Core 1 `loop()` (drain, settle, button FSM, annunciation, `pumpEmergencyBroadcast`, LEDs), and Storage + outputs (LittleFS + PhotoStore SD→LittleFS, SEQ.TXT, GPIO outputs, ESP-NOW TX). A lower notes panel records SD fallback, bounded gallery, concurrency safeguards, and the two working-combo gaps; a legend defines line/status semantics.
- All 32 source-authoritative semantic assertions pass, including the exact title, `MuseumHub`/`192.168.4.1`, Core 0 vs Core 1 split, callback→16-slot queue→drain boundary, `gState` under one FreeRTOS mutex, grouped routes (`/api/state`, check-in/enter/request/approve/deny, `/api/emergency`, test-only `/api/robot/advance`, image upload/gallery/clear, static/captive), multipart-only `MultipartImageHandler` with 65,535-byte cap + SOI/EOI validation + commit, SD-preferred→LittleFS-fallback PhotoStore with strict 8.3 `/photos/I00012S3.JPG` names, `/photos/SEQ.TXT` floor, bounded retention = 12, GPIO21/4/15 outputs, 6-frame 60 ms burst then 2 s periodic, NO ACK/AUTH, senderless `MSG_LOCATION · NO SENDER`, ignored `MSG_IMAGE_READY · HUB IGNORES`, volatile RAM, and no registered ESP-NOW peers.
- Visual QA from the native XML + pixel analysis + OCR: 0 genuine content overlaps (non-nesting), 46/46 nodes in correct zones, 29/29 edges, 0 % near-black pixels (mean brightness 229), all five zones populated (10–53 % colored), OCR confirmed exact title + five readable zone headers + distinct colored borders + no clipping. (Vision MCP hallucinated opaque "black blocks" twice; pixel analysis proved 0 black pixels.)
- Final integrity gate passes: all 24 accepted/alternate diagram artifacts + [`diagrams/README.md`](diagrams/README.md) byte-for-byte unchanged; all 5 protected product trees match their pre-task aggregate SHA-256; Diagram 6 was not begun.

## 2026-08-11 — Diagram 5 Hub source refresh

- Current [`firmware/hub/src/main.cpp`](firmware/hub/src/main.cpp) still implements one Core-0 network task and the Core-1 Arduino loop. [`webTask()`](firmware/hub/src/main.cpp:657) only services captive DNS and the synchronous HTTP server, while [`loop()`](firmware/hub/src/main.cpp:918) drains the 16-slot ESP-NOW queue, settles robot motion, synchronizes emergency state, debounces/handles the physical button, advances the nonblocking siren, transmits emergency state, renders LEDs, and delays about 5 ms.
- The Wi-Fi receive callback boundary remains deliberately small: [`enqueueMessage()`](firmware/hub/src/main.cpp:154) accepts only an exact, checksum-valid 24-byte packet, copies it to a local value, and performs a zero-wait queue send. No state handler, LED, siren, filesystem, or ESP-NOW transmission runs directly in that callback; queue-full loss remains silent.
- [`processMessage()`](firmware/hub/src/main.cpp:172) consumes only location, emergency, and health. The Hub therefore implements a location receiver even though the audited rail Robot has no sender; Camera image-ready packets have no case and no behavioral effect. These interfaces must use inactive/senderless styling rather than active-flow arrows.
- Cross-core [`gState`](firmware/hub/include/MuseumState.h:16) access remains serialized by [`stateLock()`](firmware/hub/src/main.cpp:124) and [`stateUnlock()`](firmware/hub/src/main.cpp:125). HTTP handlers mutate or snapshot under that mutex; Core 1 reads/updates the same model under the mutex. [`gPhotos`](firmware/hub/src/main.cpp:35) and multipart upload context are Core-0-only and intentionally have no independent mutex.
- Browser/admin emergency mutation in [`handleEmergency()`](firmware/hub/src/main.cpp:337) changes only the shared Boolean under lock and marks a dirty flag. Core 1 remains the sole ESP-NOW sender and output authority: it adopts shared state, updates annunciation, and runs [`pumpEmergencyBroadcast()`](firmware/hub/src/main.cpp:226). The diagram must not make a browser or callback directly drive radio, LEDs, or siren.
- Current HTTP registration at [`setup()`](firmware/hub/src/main.cpp:883) confirms grouped routes for state/check-in/request decisions, emergency, test-only robot advance, image retrieval/gallery/clear, and the dedicated multipart image handler. Static LittleFS content and recognized captive-probe redirects fall through [`handleFile()`](firmware/hub/src/main.cpp:631).
- Camera ingestion remains multipart-only. [`handleImageUploadForm()`](firmware/hub/src/main.cpp:395) checks field/MIME, enforces the 65,535-byte bound before each write, and streams to LittleFS scratch. [`handleImageUploadComplete()`](firmware/hub/src/main.cpp:466) validates nonempty size plus JPEG SOI/EOI, commits through the photo abstraction, then updates latest-image metadata under the shared-state mutex; rejection removes scratch and preserves the prior newest image.
- Current [`firmware/hub/src/PhotoStore.cpp`](firmware/hub/src/PhotoStore.cpp) confirms a single Core-0-owned storage abstraction: three SD mount attempts, LittleFS fallback, strict 8.3 names such as `/photos/I00012S3.JPG`, newest-first RAM index reconstruction, persistent `/photos/SEQ.TXT` floor, configured bounded retention, and LittleFS `/upload.tmp` staging even when final storage is SD.
- [`PhotoStore::commitUploadTemp()`](firmware/hub/src/PhotoStore.cpp:350) evicts to the configured limit before commit, copies validated scratch to SD or renames within LittleFS, inserts metadata, and writes the sequence floor. [`PhotoStore::clear()`](firmware/hub/src/PhotoStore.cpp:414) removes gallery images but deliberately retains the issued sequence floor so normal immutable image URLs are not reused; the source-proven 65,000-sequence reset remains an exceptional limitation.

## 2026-08-11 — OTA Hub flash-capacity analysis

- The copied target is [`firmware/hub-ota/`](firmware/hub-ota/); the original [`firmware/hub/`](firmware/hub/) was not edited for this request.
- Arduino-ESP32's active default 4 MiB partition table provides two 0x140000-byte (1.25 MiB) OTA app slots and a 0x160000-byte (1.375 MiB) SPIFFS/LittleFS region. The OTA-enabled Hub image is 955,125 bytes, or 72.9% of either default app slot.
- Exact project-owned/deployed files under [`firmware/hub-ota/data/`](firmware/hub-ota/data/) total 308,483 bytes. The largest asset is the offline decoder [`jsQR.js`](firmware/hub-ota/data/js/vendor/jsQR.js) at 256,885 bytes.
- Built-in `min_spiffs` is unsuitable because its filesystem cannot hold the current web bundle. Built-in `huge_app`/`no_ota` layouts are unsuitable because they remove the two-image OTA update model. A project-specific table is therefore the correct optimization, not arbitrary use of the largest app partition.
- Final [`partitions.csv`](firmware/hub-ota/partitions.csv) is contiguous and exactly fills 0x400000 bytes: NVS 0x9000–0xDFFF; OTA metadata 0xE000–0xFFFF; app0 0x10000–0x18FFFF; app1 0x190000–0x30FFFF; LittleFS 0x310000–0x3EFFFF; coredump 0x3F0000–0x3FFFFF.
- Each app slot is 1,572,864 bytes. PlatformIO's linked-section metric leaves 617,739 bytes; the stricter 961,696-byte OTA transfer artifact leaves 611,168 bytes of slot headroom. LittleFS is 917,504 bytes; subtracting raw deployed payload leaves a partition-level 609,021 bytes before filesystem metadata for upload scratch and gallery fallback.
- The configured 65,535-byte image ceiling is an acceptance bound, not the expected QVGA size. Physically verified Camera JPEGs are about 1.8–2.0 KiB, so 12 normal fallback photos plus scratch fit comfortably. The preferred gallery backend remains microSD.
- Application capacity failure is deterministic: PlatformIO/OTA rejects an image that does not fit the inactive app slot. It does not intentionally install half an image. Filesystem pressure is also checked: scratch open/write, byte-count, JPEG markers, and final commit must all succeed before image state is published; failure returns an HTTP error and discards scratch.
- Dual slots protect the running image from an interrupted transfer because ArduinoOTA writes the inactive slot before selecting it. Automatic rollback after a valid new image boots and later fails is not claimed; that would require an additional ESP-IDF rollback/health-confirmation policy.
- Changing partition geometry still requires one USB deployment because an already-running image cannot safely redefine its own flash map over OTA. The documented first deployment is erase → USB firmware upload → LittleFS upload; later firmware builds use authenticated `espota` to `192.168.4.1:8266`.
- Final clean validation passes for both environments. `hub` and `hub-ota` each use 51,736/327,680 B RAM (15.8%) and 955,125/1,572,864 B application space (60.7%); each generated firmware binary is 961,696 bytes.
- The two environment binaries have identical logic/payload bytes. Their only 65 byte differences are the expected 32-byte app ELF identity plus the 33-byte checksum/hash trailer, because PlatformIO builds each named environment separately.
- PlatformIO's generated `partitions.bin` decodes exactly to NVS 20 KiB, OTA metadata 8 KiB, app0 1536 KiB, app1 1536 KiB, SPIFFS-subtype LittleFS 896 KiB, and coredump 64 KiB at the intended offsets.
- `buildfs` succeeds and emits a 917,504-byte image. Unpacking it with the exact PlatformIO geometry (`4096` block, `256` page) reproduces all nine source files byte-for-byte, totaling 308,483 bytes.

## 2026-08-11 — Diagram 4 restoration

- Locked outputs: [`diagrams/04_emergency_authority_evacuation_behavior.drawio`](diagrams/04_emergency_authority_evacuation_behavior.drawio) and [`diagrams/04_emergency_authority_evacuation_behavior.png`](diagrams/04_emergency_authority_evacuation_behavior.png).
- Preserve every ownership-unknown alternate artifact; [`diagrams/05_emergency_path.drawio`](diagrams/05_emergency_path.drawio) is reference-only.
- The received request is truncated after the admin emergency endpoint, so omitted requirements must be recovered before authoring.
- The user authorized recovering the missing contract directly from current source. Hub HTTP implements `POST /api/emergency?on=N` by parsing `on` as an integer; `0` clears and any nonzero value raises, then marks the state dirty for Core 1 transmission on its next roughly 5 ms pass.
- Hub also adopts any checksum-valid incoming `MSG_EMERGENCY` Boolean and relays a real change. There is no sender-MAC/node allowlist, encryption, acknowledgement, or sequence/replay rejection. Therefore Hub is the runtime state owner/relay, not the exclusive origin.
- Physical GPIO21 is HIGH when pressed with internal pull-down backup and 50 ms debounce. A rising edge latches ON. Holding continuously for 3,000 ms clears; release cancels hold timing.
- Hub emergency outputs are nonblocking: all seven pixels toggle red/dark at about 250 ms, while a passive buzzer alternates 600 and 1,200 Hz every 400 ms. Browser pages receive the shared Boolean through ordinary `/api/state` polling; there is no push channel.
- Each state transition is announced immediately and as six total frames at 60 ms intervals, then the current Boolean is broadcast every 2 s. The code comment says immediate plus six repeats, but the implementation decrements `burstLeft` before each send, yielding six total transition frames; the diagram must use the implementation result.
- Robot's ESP-NOW callback only validates fixed packet shape/magic/version/checksum and copies the requested Boolean. [`applyEmergencyState()`](ESP32_RFID_MP3_RAIL/ESP32_RFID_MP3.ino:612) is first in the main loop before RFID and DFPlayer handling, so a newly received emergency outranks card/audio work.
- On raise Robot cancels a pending photo, clears narration and resume state, clears the normal stop latch, stops DFPlayer, and sends Nano `START`. While emergency is active every mapped card including START and stations is ignored except END UID `A3 C0 38 15`.
- END during emergency cancels any photo, sets the normal stop latch, stops DFPlayer, sends Nano `STOP`, and marks `emergencyStopReached`. Hub emergency remains ON, so Hub siren/red LEDs/browser banner continue; the Robot remains emergency-stopped at END and ignores all other cards.
- On clear Robot again cancels photo/audio activity, clears the emergency-END marker, sets `railStopLatched=true`, sends Nano `STOP`, and requires a fresh START card before normal motion can resume. Clearing never auto-resumes the tour.
- Safety/risk boundary recovered from source: channel 1 must match; ESP-NOW initialization/interference/mismatch can prevent behavior with no end-to-end confirmation; periodic state can resynchronize a late or rebooted Robot; Hub boots emergency false and initially broadcasts false; evacuation has no obstacle/end-position sensor beyond RFID END; Nano START/STOP is commanded but not acknowledged before the state transition proceeds; Mega display has no active integration edge.
- Visual comparison of accepted Diagrams 1–3 locks a consistent suite system: 1600×900 logical canvas exported near 16:9, off-white page, 28 px navy title, subdued subtitle, top-right current-source chip, rounded navy-framed major regions, 8–12% subsystem tints, restrained shadows on focal controllers only, white-backed compact technical labels, orthogonal transport-colored connectors, and bottom legend/authority material.
- Accepted Diagram 3 is the best layout predecessor for Diagram 4: a left-to-right time arrow, five compact numbered phase headers, seven actor lanes, two independent nested lifecycle boxes, and a lower full-width alternatives strip. Diagram 4 should reuse the title/phase/lane grammar but split the main body into a dominant crimson raise/evacuate path and a distinct green clear/recovery path rather than copying Diagram 3's normal-tour columns literally.
- The reference [`diagrams/05_emergency_path.png`](diagrams/05_emergency_path.png) is coherent but unsuitable as a base. It is very tall/dense, uses an oversized prose-heavy sequence, omits external-radio origin and risk/state insets, and incorrectly claims Hub-exclusive decision authority. Reusable concepts only are the numbered raise→broadcast→Robot→END→clear chronology, END-only card rule, and prominent manual START recovery. All wording and geometry must be rebuilt from current source in the new locked target.

## 2026-08-11 — Diagram 4 production completion

- Published locked targets: [`diagrams/04_emergency_authority_evacuation_behavior.drawio`](diagrams/04_emergency_authority_evacuation_behavior.drawio) (42,499 bytes; SHA-256 `461c95e6633275011bc8011eb1fded09dfdbbbe8112c95af9000ba88bca13b57`) and [`diagrams/04_emergency_authority_evacuation_behavior.png`](diagrams/04_emergency_authority_evacuation_behavior.png) (1602×902, 296,499 bytes; SHA-256 `79f70e3f4a52e1533fb2a8224f458749d1db44837c619b089e632c6635fe5285`).
- The page is a single uncompressed Draw.io page (ID `heWvcBr53x5kuSaETKAw`, `pageWithNumber`, ~42,394 page bytes) authored exclusively through official `@drawio/mcp` 1.5.0 `open_drawio_csv` (`isError: false`), then persisted/exported by official Draw.io Desktop. No Draw.io XML was hand-written; no Graphviz/Mermaid was used.
- The official Draw.io MCP native tool surface was not exposed in this session (`mcp__drawio__*` absent), so the same official `@drawio/mcp` server was driven over stdio with a small MCP-SDK client (the prior session's `wro-call-drawio-mcp.mjs` pattern), calling the identical `open_drawio_csv` / `list_pages` / `get_page` `tools/call`. This remains official Draw.io MCP authoring/inspection.
- Native XML geometry QA from the persisted model: 0 genuine content-content overlaps, 0 out-of-page nodes, 0 dangling edge refs, and all 29 required semantic IDs present. A downscaled-thumbnail visual sanity check confirmed the crimson raise/evacuate band, the green clear/recover band, the state-machine inset, and the risk panel with no severe defects. (Vision MCP timed out on the full-page render, as it did for Diagram 3.)
- All 68 source-authoritative semantic assertions pass: title; three origins (button GPIO21 50 ms debounce / 3 s hold clear, unauthenticated admin POST `/api/emergency?on=N`, any checksum-valid external ESP-NOW); Hub adopts the Boolean as runtime owner + relay but is NOT the exclusive origin; nonblocking 7× red LED ~250 ms + 600↔1200 Hz @400 ms siren; transition cadence of 6 total frames × 60 ms then current state every 2 s; channel-1 broadcast `FF:FF:FF:FF:FF:FF` node 10 with NO ACK / NO AUTH / no replay filter; Robot callback validates shape/magic/ver/checksum and `applyEmergencyState()` runs FIRST (before RFID/DFPlayer); on raise cancel photo + clear narration/resume + clear normal stop latch + stop DFPlayer + Nano START; every card ignored except END `A3 C0 38 15`; END hard-brakes (Nano STOP, set stop latch, `emergencyStopReached`) while Hub stays ON; clear via 3 s hold / admin on=0 / radio false → Hub `noTone()`/FALSE → Robot cancel + `railStopLatched=true` + Nano STOP; post-clear latched stopped (never auto-resumes); fresh START `18 C4 0F BA` required; state-machine inset (Robot normal-tour / emergency-running / stopped-@-END / post-clear-latched; Hub false↔true); risk boundary (no ACK/auth/replay, channel-1 dependency, Hub reboot→false, no obstacle/end-position sensor, Nano START/STOP not acknowledged before transition, Mega no integration edge).
- Final integrity gate passes: all 17 ownership-unknown alternate artifacts + [`diagrams/README.md`](diagrams/README.md) and all 6 accepted parent-suite diagrams are byte-for-byte unchanged; all 5 protected product trees ([`ESP32_RFID_MP3_RAIL/`](ESP32_RFID_MP3_RAIL/), [`firmware/display/`](firmware/display/), [`firmware/cam/`](firmware/cam/), [`NANO_LFR_RAIL/`](NANO_LFR_RAIL/), [`firmware/hub/`](firmware/hub/)) match their pre-task aggregate SHA-256. Diagram 5 was not begun (only the read-only alternate `05_emergency_path` exists).

## 2026-08-11 — Diagram 3 production restoration and immutable baseline

- The locked parent-suite targets are absent before production: [`diagrams/03_normal_tour_narration_photo_sequence.drawio`](diagrams/03_normal_tour_narration_photo_sequence.drawio) and [`diagrams/03_normal_tour_narration_photo_sequence.png`](diagrams/03_normal_tour_narration_photo_sequence.png). The new page will not overwrite an existing target file.
- A fresh byte-level baseline is saved outside the repository in `/tmp/wro_diagram3_alternate_before.sha256`. It records SHA-256 for the eight ownership-unknown alternate Draw.io/PNG pairs plus [`diagrams/README.md`](diagrams/README.md): 17 identities total, all matching the prior reconciliation record.
- A fresh protected-source baseline is saved outside the repository in `/tmp/wro_diagram3_protected_before.sha256`. Aggregate SHA-256 values are `c9ce21d4373c63c75f9583630a680bef80e831179c438b4c39a722569442c1dd` for [`ESP32_RFID_MP3_RAIL/`](ESP32_RFID_MP3_RAIL/), `526833561b7d7199704f2bcb1c5f26953a0ff495037b951c164930e0102fa298` for [`firmware/display/`](firmware/display/), `a4bef0d6c9028481a6407c894ac1f4f968e168a7a285646316d6246aac1ef663` for [`firmware/cam/`](firmware/cam/), `e3892b08b190365623314ec9f240bb9ccfd72f36db7227dff2f6b7ba24776553` for [`NANO_LFR_RAIL/`](NANO_LFR_RAIL/), and `6c5952cd815466188d6a504b5e15aff41676666057e67b2c10acb4ba8976ea4a` for [`firmware/hub/`](firmware/hub/). Generated `.pio` trees are excluded.
- Existing product-tree modifications are protected concurrent work, not Diagram 3 changes. The current Git diff remains the previously recorded Robot/Hub/shared-header/planning baseline; final integrity will compare exact byte hashes rather than assume a clean repository.
- Accepted Diagram 1/2 visual review confirms the shared language to retain: off-white landscape canvas, dark navy title, top-right current-source chip, rounded cards with restrained shadows, subsystem tints and borders, transport-colored orthogonal arrows, compact technical labels on white grounds, status chips, and a small authority/legend block.
- Repository configuration identifies the official server as [`@drawio/mcp`](.vscode/mcp.json:5), launched through `npx -y`. The accepted workflow uses official MCP `list_pages`, `get_page`, and `open_drawio_csv`; it does not hand-author Draw.io XML.
- Official MCP initialization reports `drawio-mcp` version 1.5.0. Its read-only `list_pages` operation on [`diagrams/03_normal_tour_narration_photo_sequence.drawio`](diagrams/03_normal_tour_narration_photo_sequence.drawio) returned `file not found` with `isError: true`, confirming there is no current target document/page to overwrite. This expected absence is the required pre-mutation canvas inspection, not a production failure.
- Robot source fixes the sequence timing and latch semantics. [`AUDIO_MIN_MS`](ESP32_RFID_MP3_RAIL/ESP32_RFID_MP3.ino:100) is 1,500 ms; [`AUDIO_MAX_MS`](ESP32_RFID_MP3_RAIL/ESP32_RFID_MP3.ino:101) is 90,000 ms; duplicate-card debounce is 1,500 ms; tracks 2–8 map to stations 1–7; the station photo is scheduled non-blockingly for 2,000 ms only when `narrating` is actually true.
- The Robot clears the pending photo before emitting exactly one one-way `SHOOT <station>` command; it has no Camera acknowledgement path. If narration is no longer active before the due time, the pending photo is cancelled. Audio finish/error handling runs before the camera-trigger pump, so a same-loop completion cancels rather than taking a late shot.
- Every mapped audio path sends Nano `STOP` before playback. START UID `18 C4 0F BA` clears the stop latch, cancels any photo, stops old audio, plays track 1, schedules no photo, and can resume only after guarded completion. END UID `A3 C0 38 15` cancels the photo, sets the latch, stops audio, sends `STOP`, selects no track, and has no automatic restart.
- [`finishAudio()`](ESP32_RFID_MP3_RAIL/ESP32_RFID_MP3.ino:545) sends Nano `START` only when completion is allowed, `resumeAfterAudio` is true, and `railStopLatched` is false. DFPlayer offline, error, or 90 s timeout clears narration/resume and leaves the rail stopped.
- Camera command dispatch proves `SHOOT <station>` is not a blind local capture: [`handleCommand()`](firmware/cam/src/main.cpp:405) calls `ensureWifi()` first and performs no capture if MuseumHub Wi-Fi cannot be joined. Camera unavailability or Hub reachability therefore cannot affect Robot/Nano motion; the Robot never waits for a return message.
- On a valid Camera trigger, [`doCapture()`](firmware/cam/src/main.cpp:240) discards stale frames, captures GC2145 RGB565, converts with `frame2jpg()`, retains the latest JPEG in RAM, optionally writes an onboard-SD backup when mounted, and uploads from RAM when connected. Optional SD failure is non-fatal.
- The Camera upload contract is `multipart/form-data`, field `image`, `Content-Type: image/jpeg`, POST to `/api/image/upload?station=N`. A successful HTTP 200 may cause the Camera to broadcast `MSG_IMAGE_READY`, but current Hub code has no behavioral consumer; Diagram 3 must not require this ping or depict it as rail feedback.
- Hub Core 0 receives multipart chunks into a LittleFS scratch file, enforces size/type, validates JPEG markers, commits through [`PhotoStore::commitUploadTemp()`](firmware/hub/src/PhotoStore.cpp:350), updates image state, and returns HTTP 200 JSON only after successful commit. Failed uploads discard scratch and preserve the previous gallery image.
- Hub serves the newest or immutable sequence image through `/api/image[?seq=N]` and exposes newest-first metadata through `/api/gallery`; the browser can poll/fetch these APIs. Gallery persistence is SD when available with LittleFS fallback. This storage/UI branch is downstream of Camera HTTP and has no rail authority.

## 2026-08-11 — Diagram 3 production completion

- Published locked targets: [`diagrams/03_normal_tour_narration_photo_sequence.drawio`](diagrams/03_normal_tour_narration_photo_sequence.drawio) (58,302 bytes; SHA-256 `57ce4269e5c83f586c67398a233c70e6323e1a83f9c4052940ec12b500c1b084`) and [`diagrams/03_normal_tour_narration_photo_sequence.png`](diagrams/03_normal_tour_narration_photo_sequence.png) (1641×932, 228,926 bytes; SHA-256 `b578ebc1d0dc0a962c2984c08cd679a5e6fb57759fd633c9a609ca62ef189306`).
- The page is a single uncompressed Draw.io page (ID `JWw6mATQHweUHtqM2wP4`) with 82 semantic nodes and 28 individually styled source-contract edges. It was authored exclusively through official Draw.io MCP 1.5.0 `open_drawio_csv`; no Draw.io XML was hand-written, and no Graphviz/Mermaid was used.
- Geometry QA from the persisted XML confirmed zero event-card-on-event-card overlaps after correcting seven inverted edge connection points and repositioning one boot-sync label. All 66 remaining reported overlaps are container/child nesting only.
- All 17 ownership-unknown alternate artifacts and [`diagrams/README.md`](diagrams/README.md) are byte-for-byte unchanged (`sha256sum -c` 17/17 OK). All 5 protected product trees match their pre-task aggregate SHA-256. Git product diff remains the pre-existing Robot/Hub/shared-header baseline.

## 2026-08-11 — Diagram artifact forensics and suite reconciliation

- Context restoration confirms that the authoritative architecture audit locked a **six-page** suite: system context; hardware ownership/wiring; normal tour sequence; emergency sequence; Hub runtime/APIs/persistence; and ownership/protocols/fallbacks/gaps. Diagram 1 and the intended Diagram 2 were subsequently produced and verified under that plan.
- [`diagrams/README.md`](diagrams/README.md:3) now declares a separate **nine-sheet** suite and links `02_board_wiring_map`, `03_radio_and_networks`, `04_one_station_stop`, `05_emergency_path`, `06_robot_states`, `07_photo_pipeline`, `08_hub_two_jobs`, and `09_message_reference`. This index was not reported by the Diagram 2 production log and conflicts with that task's explicit Diagram-2-only boundary.
- The README's topics appear to repartition the same audited source material rather than extend the locked six-page plan: wiring, normal station flow, emergency behavior, robot state, photo pipeline, Hub concurrency, and protocol reference all overlap one or more planned pages. Topic overlap alone does **not** establish authorship, freshness, source authority, or safe reuse.
- Ownership remains unknown pending non-mutating Git, timestamp, hash, Draw.io metadata/text, and PNG inspection. Preserve every unexplained artifact by default; no overwrite/deletion/renumbering is authorized.
- Git has no tracked path under [`diagrams/`](diagrams/), and `git log --all -- diagrams` is empty. Every Draw.io/PNG pair, the diagram README, and the older Graphviz files are untracked at branch `feature/mp3-rfid-nano-firmware` / commit `a4b77aa9e302daf208384cdd414a953770d3e0b1`. Git therefore supplies no author, commit, or historical provenance for the unexplained files.
- Filesystem birth times prove the alternate suite did **not** predate Diagram 1. The alternate editable files appeared sequentially during the Diagram 2 window: `02_board_wiring_map.drawio` at 18:37:03, `03_radio_and_networks.drawio` at 18:39:40, `04_one_station_stop.drawio` at 18:43:26, `05_emergency_path.drawio` at 18:46:11, `06_robot_states.drawio` at 18:48:49, `07_photo_pipeline.drawio` at 18:50:37, `08_hub_two_jobs.drawio` at 18:52:54, and `09_message_reference.drawio` at 18:55:02 Asia/Dhaka. The intended Diagram 2 pair was born at 18:56:25; the nine-sheet README followed at 18:56:05; all alternate PNG exports followed as one 18:58:10–18:58:36 batch.
- That sequence is strong evidence of a separate, coordinated nine-sheet generation/export run concurrent with the intended Diagram 2 work, not old repository history. It cannot identify whether the actor was another user, agent, editor, or process, so ownership remains **unattributed concurrent work** and must be preserved.
- The intended Diagram 1 editable file still matches its accepted SHA-256 `660aab8f...aacc`, but its PNG no longer matches the production record: it is now 3202×1804 / 640,086 bytes / SHA-256 `6598e168...0843`, modified in the same 18:58 export batch, instead of the recorded 1626×927 / 260,863 bytes / `0fbc27f3...f1aa`. This is direct evidence that the concurrent exporter also overwrote a previously validated review PNG. The editable Diagram 1 source was not overwritten.
- The intended Diagram 2 pair still exactly matches its accepted evidence: editable SHA-256 `f4b1aaf0...80c7`; PNG 1630×930 / 313,525 bytes / `90512614...01a`. It was not touched by the later alternate PNG batch.
- Alternate artifact hashes are now recorded for identity: `02_board_wiring_map` = Draw.io `8e4296e5...e65f`, PNG `86916493...65b`; `03_radio_and_networks` = `b614fe00...a142`, `59d7b3d2...e9b`; `04_one_station_stop` = `530f0f04...02a`, `6fbc71eb...535`; `05_emergency_path` = `c9f19921...245`, `f5dbc9e1...965`; `06_robot_states` = `06c103fc...4ba`, `222a6414...e6c`; `07_photo_pipeline` = `b260cbb6...d89`, `1e9b0130...b62`; `08_hub_two_jobs` = `f891edca...032`, `701a4f89...50d`; `09_message_reference` = `1c3d623c...10e`, `22f9109b...0de8`; README = `e14a97b2...c04`.
- Alternate PNG dimensions vary substantially rather than using the locked 1600×900 export geometry: 3602×2162, 3282×1922, 3682×2842, 3602×3142, 3442×2122, 3602×2002, 3442×2082, and 3442×2542 respectively. Visual suitability remains unproven.
- Native Draw.io metadata strengthens the separate-producer conclusion. Both accepted artifacts declare `mxfile host="Electron"`, generic page name `pageWithNumber`, and MCP/Desktop page IDs. Every alternate artifact declares `mxfile host="Claude Code" type="device"` and coordinated IDs/names `wro_rrl_02-wiring` through `wro_rrl_09-messages`. This identifies a common Claude Code authoring/export process for the alternate suite, but not a human owner or authorization to replace parent-task work.
- All ten inspected Draw.io files are one-page, uncompressed editable XML. Alternate page titles are `02 — How Every Board Is Wired`, `03 — Who Talks To Whom Without Wires`, `04 — One Station Stop, Start To Finish`, `05 — The Emergency Button, Press To All-Clear`, `06 — Every State The Robot Can Be In`, `07 — The Life Of One Photo`, `08 — The Two Jobs The Hub Runs At Once`, and `09 — Every Message The Boards Send Each Other`. Their page names are `02-wiring`, `03-radio`, `04-station-stop`, `05-emergency`, `06-robot-states`, `07-photo-pipeline`, `08-hub-two-jobs`, and `09-messages`.
- Direct visual inspection of `02_board_wiring_map.png` shows a coherent, highly legible build-reference composition and substantial overlap with planned Page 2, but it is not a drop-in replacement for the accepted Diagram 2: it uses a different title/scope, much larger 1840×1120 canvas exported at 3602×2162, prose simplified to Nano “GO and STOP,” omits the accepted page's full tuning/reply contract and explicit power-domain treatment, and would require complete semantic/visual validation before any optional reuse.
- Direct visual inspection of `03_radio_and_networks.png` shows a coherent 1680×1000 network explainer, not the planned Normal Tour Runtime Sequence. It focuses on the two SoftAPs, channel 1, Hub→Robot emergency radio, and ignored camera ping. Its page topic is supplementary and overlaps planned Pages 1, 4, and 6; it cannot satisfy planned Page 3.
- Visual inspection also found at least one statement requiring source revalidation before reuse: the radio sheet says “The hub is the only board allowed to decide this,” while the audit proved Hub also accepts any checksum-valid incoming EMERGENCY packet and adopts it without sender authorization. This reinforces the rule that attractive/consistent presentation is not semantic acceptance.
- Direct visual inspection of `04_one_station_stop.png` shows the closest alternate match to planned Page 3: an eight-lane station sequence with RFID→Robot→Nano/DFPlayer→Camera→Hub→staff polling, 1.5 s duplicate/minimum-finish timing, 2 s photo scheduling, 90 s stop-safe timeout, and Hub scratch/gallery behavior. However, it covers only a **single station stop**. It omits the locked suite page's boot brake/STOP+GET, START-card intro/resume path, END-card latch, optional camera SD branch, ignored IMAGE_READY step, explicit Hub-Wi-Fi/no-capture branch, HTTP-failure RAM retention, and the full requested alternative fragments. It is therefore a useful reference/reuse candidate only after detailed semantic and visual validation, not a substitute for planned Diagram 3.
- The station-stop PNG is also portrait-tall at 1880×1460 logical / 3682×2842 export and uses a top-to-bottom five-step layout, unlike the locked Page 3 1600×900 left-to-right success band with lower failure fragments. Reusing its components would require a new artifact and material restructuring; the ownership-unknown original must remain untouched.
- Direct visual inspection of `05_emergency_path.png` confirms substantial overlap with planned Page 4: alarm raise, 50 ms debounce, six-frame 60 ms burst, 2 s periodic radio state, robot priority application, audio/photo cancellation, evacuation START, END-only stop, three-second clear, STOP latch, and manual START recovery. It is a strong content reference but not yet accepted: the subtitle/state text overstates exclusive Hub decision authority, and the locked Page 4 also requires external-radio origin, explicit state-machine inset, authentication/replay/channel/reboot/obstacle risks, and the Mega footnote. Preserve and validate rather than renumber/reuse directly.
- Direct visual inspection of [`diagrams/06_robot_states.png`](diagrams/06_robot_states.png) shows a readable combined normal/emergency state reference: parked, parked-and-talking, moving, failed-talk parked, alarm-driving, and alarm-stopped, with START/station/END transitions, duplicate-card suppression, 90-second fail-safe, and post-clear STOP latch. It overlaps planned Pages 3 and 4 and could inform their state insets, but it does not satisfy either page: it mixes two planned narratives, says alarm input arrives from the Hub without the required external-radio origin, omits explicit controller/state ownership and Page 4's radio risks, and uses a dense 1760×1100 troubleshooting layout rather than the locked 16:9 narrative geometry. Preserve it as an unvalidated cross-page reference only.
- Direct visual inspection of [`diagrams/07_photo_pipeline.png`](diagrams/07_photo_pipeline.png) shows a coherent camera-to-Hub photo pipeline with frame flushing, RGB capture, software JPEG conversion, RAM retention, optional camera SD, multipart upload, Hub scratch-file validation, bounded gallery storage, and browser polling. This is strong component-level overlap with planned Pages 3 and 5, but not a replacement for either: it begins at SHOOT rather than covering the normal tour, omits the ignored IMAGE_READY ping, and omits the rest of Hub task/API/emergency/persistence architecture. Its broad claim that a Wi-Fi-down shot always waits in camera RAM conflicts with the locked source-authoritative distinction between no Wi-Fi at SHOOT time (no capture) and an HTTP failure after capture (RAM JPEG retained), so semantic reuse requires correction in a newly owned artifact while this original remains untouched.
- Direct visual inspection of [`diagrams/08_hub_two_jobs.png`](diagrams/08_hub_two_jobs.png) shows the closest alternate match to planned Page 5. It clearly separates the potentially slow web/photo half from the nonblocking alarm half, depicts the 16-slot radio inbox, shared locked state, emergency-change flag, 2.5-second motion expiry, button/siren/radio/light loop, six-frame burst plus two-second repeat, and single-owner gallery. It is a strong runtime/concurrency reference, but it is not the planned Hub page: it omits the complete API/browser-polling map, explicit persistence/rebuild paths, exact task/core ownership labels, and the planned authority/failure notes. Its 1760×1080 three-column explainer is also denser and taller than the locked 1600×900 page. Preserve it untouched; only independently validated concepts may be re-expressed later.
- Direct visual inspection of [`diagrams/09_message_reference.png`](diagrams/09_message_reference.png) shows a dense protocol/API reference overlapping planned Pages 5 and 6: a 24-byte radio layout, message kinds/flags, Robot↔Nano UART vocabulary, one-way Robot→Camera command, inactive Robot→Display vocabulary, Hub/Robot web endpoints, and matching-configuration cautions. This is the strongest alternate reference for planned Page 6's contract register, but it is not a reusable planned page without source-by-source validation: it combines active, ignored, senderless, and unwired contracts in one page; gives them prose status rather than the locked active/inactive/fallback/gap hierarchy; and makes broad “every message”/“everything you need” claims that require exact verification. Its 1760×1310 logical canvas and reference-table density do not match the locked 16:9 ownership/fallback design. Preserve it untouched as a validation aid only.

### Six-page reuse and conflict map

| Existing artifact | Six-page overlap | Ownership-safe disposition |
|---|---|---|
| [`diagrams/01_working_combo_system_context.drawio`](diagrams/01_working_combo_system_context.drawio) | Page 1 exact editable source | Canonical and byte-identical. Its PNG is visually related but no longer the accepted export identity; preserve the drifted current PNG and defer any restoration/re-export. |
| [`diagrams/02_robot_hardware_communication_topology.drawio`](diagrams/02_robot_hardware_communication_topology.drawio) | Page 2 accepted implementation | Canonical pair; both files remain byte-identical to the completion record. |
| [`diagrams/02_board_wiring_map.drawio`](diagrams/02_board_wiring_map.drawio) | Page 2 duplicate/repartition | Preserve alternate pair. Coherent build reference, but not a replacement for accepted Page 2 and not approved for direct reuse. |
| [`diagrams/03_radio_and_networks.drawio`](diagrams/03_radio_and_networks.drawio) | Cross-cutting Pages 1, 4, and 6 | Preserve alternate pair. It is a radio explainer, not Normal Tour Diagram 3; authority wording requires correction before any concept is reused. |
| [`diagrams/04_one_station_stop.drawio`](diagrams/04_one_station_stop.drawio) | Page 3 strongest partial match | Preserve alternate pair. Reference candidate for the middle station-stop band only; boot/START/END and required failure branches must come from source in a new page. |
| [`diagrams/05_emergency_path.drawio`](diagrams/05_emergency_path.drawio) | Page 4 strong partial match | Preserve alternate pair. Reference candidate for timing and recovery, not a complete/accepted emergency page; authority, external origin, state, and risk omissions remain. |
| [`diagrams/06_robot_states.drawio`](diagrams/06_robot_states.drawio) | Pages 3 and 4 state/troubleshooting overlap | Preserve alternate pair. Possible state-inset reference only; it mixes two planned narratives and omits ownership/risk detail. |
| [`diagrams/07_photo_pipeline.drawio`](diagrams/07_photo_pipeline.drawio) | Pages 3 and 5 photo/storage overlap | Preserve alternate pair. Component reference only; ignored IMAGE_READY and wider page context are absent, and its Wi-Fi fallback statement is overbroad. |
| [`diagrams/08_hub_two_jobs.drawio`](diagrams/08_hub_two_jobs.drawio) | Page 5 strongest runtime partial | Preserve alternate pair. Concurrency reference only; API, polling, persistence, task/core, and authority coverage is incomplete. |
| [`diagrams/09_message_reference.drawio`](diagrams/09_message_reference.drawio) | Pages 5 and 6, strongest Page 6 contract partial | Preserve alternate pair. Validation aid only; active, ignored, senderless, and standalone contracts require explicit status separation and exact source checks. |
| [`diagrams/README.md`](diagrams/README.md) | Index for the alternate nine-sheet repartition | Preserve unchanged. It does not list the accepted Diagram 2 and is not the parent six-page suite's canonical index. |
| [`diagrams/system_architecture.dot`](diagrams/system_architecture.dot), [`diagrams/sequence.dot`](diagrams/sequence.dot), and [`diagrams/tour_workflow.dot`](diagrams/tour_workflow.dot), plus PNGs | Legacy coarse context/sequence material | Outside the unexplained eight-pair set and not validated for current-suite reuse. Preserve unchanged; do not treat as Draw.io source. |

**Whole-artifact reuse decision:** no ownership-unknown alternate Draw.io/PNG pair is approved as a drop-in canonical page. The visual review found coherent work but incompatible geometry/scope, and semantic comparison found omissions or overstatements in every nearest match. The strongest **reference-only** candidates are station stop for Page 3, emergency path for Page 4, Hub two-jobs for Page 5, and message reference for Page 6; robot states and photo pipeline can support localized insets/fragments. Any future page must be newly authored from current source, not made by mutating or claiming the alternate XML.

### Diagram 3 collision resolution and exact next path

- Existing [`diagrams/03_radio_and_networks.drawio`](diagrams/03_radio_and_networks.drawio) and [`diagrams/03_radio_and_networks.png`](diagrams/03_radio_and_networks.png) retain their names and bytes as ownership-unknown alternate-suite work. Their `03` prefix does not make them the parent plan's Diagram 3.
- The parent six-page suite will use the full semantic basename as identity. Its next editable target is exactly [`diagrams/03_normal_tour_narration_photo_sequence.drawio`](diagrams/03_normal_tour_narration_photo_sequence.drawio), paired with [`diagrams/03_normal_tour_narration_photo_sequence.png`](diagrams/03_normal_tour_narration_photo_sequence.png). Both paths are currently absent and were not created during forensics.
- The new page's exact title remains `03 — Normal Tour, Narration & Photo Sequence`, with the locked Page 3 swimlanes, full boot-to-END path, alternative fragments, 1600×900 geometry, and shared visual system. [`diagrams/04_one_station_stop.drawio`](diagrams/04_one_station_stop.drawio), [`diagrams/06_robot_states.drawio`](diagrams/06_robot_states.drawio), and [`diagrams/07_photo_pipeline.drawio`](diagrams/07_photo_pipeline.drawio) are references only; current source and the six-page specification remain authoritative.
- This decision resolves the collision without destructive cleanup: two differently named `03_*` pairs may coexist, while planning records—not the alternate [`diagrams/README.md`](diagrams/README.md)—identify which one belongs to the parent suite.

### Final integrity result

- A corrected final SHA-256 gate passed all **21** recorded identities: accepted Diagram 1/2 artifacts, all eight alternate Draw.io/PNG pairs, and [`diagrams/README.md`](diagrams/README.md). This proves no inspected diagram/index byte changed during reconciliation. The gate intentionally treats the current drifted Diagram 1 PNG hash as its read-only forensic baseline; it does not mislabel that export as the previously accepted PNG.
- Both locked future paths—[`diagrams/03_normal_tour_narration_photo_sequence.drawio`](diagrams/03_normal_tour_narration_photo_sequence.drawio) and [`diagrams/03_normal_tour_narration_photo_sequence.png`](diagrams/03_normal_tour_narration_photo_sequence.png)—remain absent, proving Diagram 3 production did not begin.
- `git diff --check -- task_plan.md findings.md progress.md`, `git diff --cached --check`, and the no-tracked-diff-under-[`diagrams/`](diagrams/) gate all pass. Final Git status still contains the protected pre-existing Robot/Hub/shared-header work and unrelated untracked paths; this task neither reverted nor modified them. The only intentional writes were to [`task_plan.md`](task_plan.md), [`findings.md`](findings.md), and [`progress.md`](progress.md).

## 2026-08-11 — Diagram 2 production checkpoint

- Diagram 2 target is exactly `02 — Robot Hardware & Communication Topology`, in a 1600×900 16:9 physical wiring-board layout. It must use Diagram 1's off-white canvas, navy title, subsystem tints, rounded/shadowed primary cards, transport colors, status chips, clean orthogonal routing, and compact bottom legend/authority notes.
- Official Draw.io MCP inspection was completed before mutation: Diagram 1 contains one editable page (`OEfmg6SatXvFtA5Rl8QF`, about 44,961 bytes), while `diagrams/02_robot_hardware_communication_topology.drawio` does not exist. There is no prior target page to overwrite.
- Required focal chain: MFRC522 → Robot ESP32 ↔ DFPlayer, Robot ESP32 ↔ Nano → L298N → left/right motors, Robot ESP32 → ESP32-CAM → GC2145/optional SD, service browser ↔ Robot SoftAP, and Hub → Robot emergency radio. Mega/TFT remains in a dashed standalone boundary and is not wired into the combo.
- Exact electrical contracts to preserve visually: MFRC522 VSPI SS5/SCK18/MOSI23/MISO19; Robot UART2 RX16/TX17 with ~1 kΩ in Robot TX→DFPlayer RX; Robot UART1 RX25 receives Nano D1 TX through 10 kΩ upper/20 kΩ lower divider, and Robot TX26 drives Nano D0 RX; camera one-way Robot GPIO14 TX→Camera GPIO13 RX at 9600; Nano L298N ENA10/IN1=8/IN2=7 and ENB5/IN3=11/IN4=12; Camera SD_MMC one-bit GPIO2/14/15 and flash GPIO4.
- The page must state common signal ground, Nano D0/D1 programming-disconnect caution, ESP32/DFPlayer/camera logic concerns without inventing unsupported regulator ratings, logic versus L298N motor-supply separation, stable 5 V for Camera, and safe boot: Robot sends STOP while Nano boots hard-braked.
- Wireless semantics: Hub and Robot each run a separate same-channel SoftAP while ESP-NOW is fixed to channel 1; Hub broadcasts EMERGENCY one-way with no ACK/authentication. Do not imply the Robot sends Hub LOCATION or drives the Mega display.
- Documentation drift must be explicit but contained: active camera wiring is Robot GPIO14→Camera GPIO13, not stale README GPIO27. The isolated Mega warning must say the documented Robot GPIO16/17 UART collides with the active DFPlayer UART and must not be wired in the current combo.
- Official Draw.io Desktop 31.1.8 source inspection confirms CSV is a supported input (`expArgs.csv = fileContent`), CLI export requires `-x`, and `drawio` is not a valid `-f` export value. The supported persistence path is therefore MCP-native CSV → official Desktop `-f xml` → a `.drawio`-named editable XML document; no Draw.io XML is hand-authored.
- Restoration after the conversion diagnosis reconfirmed the protected working-tree baseline: only the previously recorded Robot/Hub/shared-header/planning changes are present, and the repository still has no Diagram 2 target artifact. The current `/tmp` CSV is 26,623 bytes; the temporary `.drawio` is a known-invalid PDF and must be replaced before repository publication.
- Corrected persistence succeeded: official Draw.io Desktop converted the MCP-authored CSV with `-x -f xml` into a real one-page 39,205-byte editable Draw.io XML document, then exported a 1630×930 PNG (298,093 bytes). This proves the MCP-native CSV can be persisted without hand-authored XML.
- First full-page visual inspection accepts the overall 16:9 hierarchy, palette, focal Robot card, grouped zones, power separation, emergency dominance, optional-storage style, and dashed standalone boundary. Remaining defects are localized: three left-side UART/SPI labels slightly intrude on the Robot card; the Nano↔divider and Robot→Camera purple routes are unnecessarily long; the Robot→Camera label collides with the documentation note; actuator edge labels cover the L298N/motor card tops; and the standalone collision warning is too narrow/small.
- Final visual revision must also add the source-proven Camera programming caution (disconnect Robot GPIO14→Camera GPIO13 while flashing Camera), state 3.3 V logic on the one-way camera trigger, and render the 10 kΩ/20 kΩ divider as an explicit node-to-ground schematic rather than an ambiguous resistor-library outline.
- Second full-page inspection confirms the structured revision fixed all three source omissions and most collisions: the explicit divider now shows 10 kΩ from Nano TX to the ≈3.3 V node and 20 kΩ from that node to common signal ground; the Camera card states 3.3 V one-way trigger logic; and the drift note contains the Camera flashing-disconnect caution. Signal labels no longer cover Robot text, the camera contract has its own lane, and the standalone warning is readable. One final localized layout pass remains: route Robot→Nano away from the actuator-zone heading and widen the Nano→L298N and L298N→motor label gaps.
- Third full-page inspection accepts the 1630×930 composition as final: Robot→Nano now drops at the zone edge without crossing the actuator heading; Nano/L298N/motor cards have distinct connector gaps; every primary node remains readable; orthogonal connectors avoid node text; exact pin labels stay near endpoints; and no clipping is visible. The small motor output labels remain intentionally compact but legible at full-page export, matching the diagram's secondary local-wire hierarchy.
- Final official MCP inspection passes: the repository editable artifact has exactly one page (`ihgNECXcmDLuDw5KwnlD`, approximately 38,960 page bytes), and `get_page(page=0)` returned the complete editable model. Native validation found all 32 required stable nodes and exactly `w01`–`w16` with the intended endpoint/status tuples, optional SD styling, bidirectional browser HTTP, dominant emergency styling, and no Robot→Hub or Robot→Mega edge.
- Direct source validation reconfirms Robot DFPlayer GPIO16/17, Nano UART GPIO25/26 at 9600, Camera TX GPIO14 at 9600, Robot `sendNano("STOP")`, Nano L298N D5/D7/D8/D10/D11/D12 plus HIGH/HIGH and PWM 255 hard brake, Camera receive-only GPIO13 at 9600 and flash GPIO4, Hub channel 1, and the absence of Robot `esp_now_send`/`MSG_LOCATION`.
- Published artifacts: editable `diagrams/02_robot_hardware_communication_topology.drawio` (39,065 bytes; SHA-256 `f4b1aaf07125d0ad92ac3efc5b6461c8480851064931a6169b8e2be58cc780c7`) and review `diagrams/02_robot_hardware_communication_topology.png` (1630×930, 313,525 bytes; SHA-256 `905126148da2740fbc548b9d21dcec037b1eba0102f9a59a4a3b499059cf401a`).
- Final protected-code integrity passes. Unstaged product-target names are exactly the previously recorded Robot and Hub files; staged protected-target names are empty; Nano, Camera, and Display patch streams each hash to the empty SHA-256; both Git whitespace checks pass; and exactly the requested Diagram 2 `.drawio` and `.png` files were added. No Diagram 3 work was started.

## 2026-08-11 — Diagram 1 production checkpoint

- Re-read the locked Page 1 specification before any canvas mutation: 22 stable nodes, 22 mandatory edges plus one optional USB-test-console edge, exact active/inactive semantics, shared 1600×900 visual system, discrepancy register, and active/inactive edge matrix.
- Non-negotiable semantic gates for the rendered page are: Hub→Robot EMERGENCY is the only effective five-target ESP-NOW edge; Camera→Hub JPEG upload is solid HTTP; Camera→Hub `MSG_IMAGE_READY` is gray dash-dot and explicitly ignored; Robot→Hub `MSG_LOCATION` is gray dashed with `NO SENDER`; Robot→Mega is red dashed/conflicting because no sender exists and GPIO16/17 belong to DFPlayer; Mega remains visibly standalone and USB-testable outside the active boundary.
- The protected baseline remains the pre-existing robot, Hub, shared-header, and planning-file work recorded by the architecture audit. Diagram production may add only the requested editable/PNG artifacts and planning-log updates; it must not alter product code or older diagram assets.
- Final CSV construction strategy: one row per stable node ID, nested `parent` containers, exact hand-authored x/y/width/height fields, `libavoid` routing, and one fixed `# connect` directive per source-truth edge. Each edge also carries an `edge_id`/status metadata pair, while a positioned child edge label preserves the exact transport/pin/payload wording and avoids the duplicate-source style-inheritance bug. This remains Draw.io's native CSV importer path and does not hand-author Draw.io XML.
- Latest full-page PNG inspection found that the topology and status hierarchy are correct, but the temporary render is not final-quality: Draw.io's browser mockup injects `Page 1`/`http://www.draw.io`; the Camera↔Hub, Robot↔Nano, Nano→motors, and inactive center-lane labels collide with nodes or one another; every edge label is only 9 px; and the 48 px authority card clips its final line.
- The final correction must be structural rather than another relative-offset experiment: replace browser mockups with clean rounded UI cards, reserve explicit multiline label lanes, restore the exact checklist wording for all 23 edges, raise transport text to 10–11 px, and enlarge/reflow the authority note while preserving the already-correct emergency dominance and active/inactive line styles.
- Final targeted source spot checks reconfirm the critical visual claims without relying on diagram metadata: Robot defines DFPlayer RX16/TX17 and a write-only Camera TX14 at 9600; Camera config defines receive-only GPIO13 at 9600 plus `MuseumHub` and `http://192.168.4.1/api/image/upload`; Camera source sends `MSG_IMAGE_READY`; Hub config fixes SoftAP/ESP-NOW channel 1; Hub source consumes LOCATION/EMERGENCY and sends EMERGENCY, while no `MSG_IMAGE_READY` case exists.
- Nano source confirms the active 9600 8N1 newline contract, START/STOP/GET/SET/SAVE commands, READY/STATE/TUNE/error replies, exact L298N outputs D5/D7/D8/D10/D11/D12, active hard brake, and EEPROM-backed ML/MR tuning. Mega source/config confirms 9600 USB and Serial1 parsers, the FACE/LANG/MENU/STATION/EMERGENCY vocabulary, and a directly attached MCUFRIEND 16-bit shield; the Robot source search still contains no matching display command sender.
- Final native-model validation passes: exactly one Draw.io page; all 22 mandatory stable IDs exactly once; optional `usb_console` exactly once; all 23 metadata edges `e01`–`e23` with exact endpoint pairs and exact source-truth contracts; exactly five project controllers; Mega parented under the standalone boundary, not the active boundary; solid blue Camera→Hub HTTP; thick solid crimson Hub→Robot EMERGENCY; gray dash-dot ignored IMAGE_READY; gray dashed/crossed LOCATION; red dashed/crossed Robot→Mega; no solid Robot→Hub or Robot→Mega edge; and no stale GPIO27 text.
- Final visual QA accepts the 1626×927 PNG after replacing browser mockups, restoring every exact contract, moving edge text into deterministic 10–11 px label cards, separating active and inactive lanes, enlarging/reflowing the authority note, and moving standalone USB/TFT contracts into a non-overlapping bottom strip. The emergency path remains the dominant connector and the standalone boundary remains visibly outside the active runtime.
- Final artifacts: editable `diagrams/01_working_combo_system_context.drawio` (45,066 bytes; SHA-256 `660aab8fbb892d6d04d4b20bbdecf4c22d8d97a61be4fab00c0fe413a693aacc`) and review `diagrams/01_working_combo_system_context.png` (260,863 bytes; SHA-256 `0fbc27f30b459bca103beae09453b1e034622991d1da1f7a96982e137e92f1aa`). No Diagram 2 artifact exists.

## 2026-08-11 — Working-combo architecture discovery (source audit complete)

### Authority and protected baseline

- The sole product source of truth for this audit is the current working combination: [`ESP32_RFID_MP3_RAIL/`](ESP32_RFID_MP3_RAIL/), [`NANO_LFR_RAIL/`](NANO_LFR_RAIL/), [`firmware/cam/`](firmware/cam/), [`firmware/hub/`](firmware/hub/), and [`firmware/display/`](firmware/display/). Earlier plans and other firmware variants are historical only and cannot establish current links.
- Git restoration found protected uncommitted work in the robot controller/field console/docs/config and Hub emergency/config/source/docs, plus root planning files and the shared ESP-NOW compatibility-header move. No tracked diff was present in the Nano rail, camera, or display targets. Nothing will be reverted, staged, normalized, or overwritten.
- [`ESP32_RFID_MP3_RAIL/EspNowCompat.h`](ESP32_RFID_MP3_RAIL/EspNowCompat.h) and [`ESP32_RFID_MP3_RAIL/MuseumProtocol.h`](ESP32_RFID_MP3_RAIL/MuseumProtocol.h) are symlinks into [`firmware/common/`](firmware/common/). Their resolved shared files are therefore directly referenced protocol dependencies, not separate robot-owned copies.
- Generated `.pio` trees are build artifacts and are excluded from architecture inventory. The remaining five-target inventory contains 34 relevant files: firmware sources, local/shared headers, PlatformIO configurations, READMEs, the camera helper, and the complete Hub-deployed browser bundle.
- The minified/vendor QR decoder is a deployed third-party implementation detail. It must be acknowledged as an offline QR-decoding dependency, but its 10,101-line internals do not define system architecture; the project-owned caller and deployment reference are the relevant integration surface.

### Initial proven topology from current source

- The robot ESP32 is the tour/application orchestrator: MFRC522 RFID over VSPI, DFPlayer over UART2, Nano motion slave over UART1, camera trigger over a separate transmit-only software serial link, local field-console SoftAP/HTTP, and Hub emergency receive over ESP-NOW.
- The Nano is a sensor-free, command-driven rail actuator. It owns L298N output state and persisted ML/MR PWM values; it starts in active hard brake and moves only on an explicit recognized command.
- The camera is a distinct ESP32-CAM node. The actual robot source sends it `SHOOT <station>` over a physical one-way UART-style link; the camera captures GC2145 RGB565, converts to JPEG in software, optionally backs up to onboard SD, and uploads multipart JPEG to the Hub over Wi-Fi.
- The Hub is the track/server authority: MuseumHub SoftAP + HTTP/captive portal, photo gallery, visitor/admin state, station LEDs, passive-buzzer siren, physical emergency button, and outbound emergency ESP-NOW broadcasts.
- The display is a distinct Mega 2560 renderer with a documented 9600-baud command protocol, but current robot source allocates GPIO16/17 exclusively to DFPlayer UART2 and contains no display command sender. Therefore the display is **not integrated into this working runtime combination**; it is a separately working/testable subsystem and must be drawn with an explicit inactive/planned boundary, never as an active robot edge.

### Shared ESP-NOW contract

- The active shared packet in [`firmware/common/MuseumProtocol.h`](firmware/common/MuseumProtocol.h:36) is a packed 24-byte fixed-width `MuseumMessage`: magic `0x4D53`, protocol version 1, type/node/station/flags, fixed-point health fields, visitor count, 16-bit sequence, 32-bit uptime, and a final 16-bit additive checksum. All ESP-NOW members are fixed to channel 1 and broadcast address `FF:FF:FF:FF:FF:FF`.
- Declared message types are LOCATION, EMERGENCY, HEALTH, VISITOR_COUNT, IMAGE_READY, COMMAND, and HEARTBEAT; flags include emergency, obstacle, alert, online, and moving. Declared vocabulary does not imply an active edge: each target's send/receive handlers must prove actual use.
- Validation checks only size at each receiver plus magic/version/additive checksum. The protocol carries no sender authentication, MAC allowlist, encryption, acknowledgement, or replay/sequence rejection in the current working combo.
- [`firmware/common/EspNowCompat.h`](firmware/common/EspNowCompat.h:23) only normalizes the Arduino-ESP32 2.x versus 3.x receive-callback first-argument type. It adds no transport behavior or security.

### Camera node — code-authoritative inventory

- Hardware/configuration: classic ESP32-CAM profile with PSRAM; GC2145 DVP sensor on the AI-Thinker pin map; 10 MHz XCLK; RGB565; QVGA 320×240; one framebuffer; two stale-frame flushes separated by 40 ms; software JPEG quality 15. The GC2145 has no native JPEG path.
- Camera DVP consumes GPIO0/5/18/19/21/22/23/25/26/27/32/34/35/36/39. Optional SD_MMC deliberately uses one-bit mode on GPIO2/14/15, leaving GPIO4 for the normally-off flash LED and GPIO13 for the robot link.
- Active trigger edge: robot GPIO14 software TX → camera GPIO13 hardware UART1 RX, 9600 baud, 8N1, newline-delimited `SHOOT <station>`, one-way, shared ground. USB Serial at 115200 is an independent command source with its own bounded 96-byte buffer; the two streams cannot splice partial lines together.
- State owned in RAM: camera/SD readiness, detected PID/card type/flash state, last JPEG pointer+length, optional last SD path, last station, and auto-capture interval/timestamp. The last RAM JPEG is replaced only after a new conversion succeeds and supports `SEND` retry; it is lost on reset.
- Capture pipeline: reject when camera uninitialized → flush stale frames → acquire RGB565 → `frame2jpg()` → return camera framebuffer → replace retained RAM JPEG → optionally save+flush+reopen-size-verify `/photos/IMG_####.JPG` on SD → if Wi-Fi is already connected, upload multipart JPEG → on HTTP 200, broadcast `MSG_IMAGE_READY` best-effort. A successful capture does not depend on SD.
- SD persistence: SD is **not mounted at boot** in current source despite the README's capture-to-SD emphasis; boot explicitly says to run `INIT`. When mounted, each save rescans `/photos` for the largest `IMG_####.JPG` and uses +1, so filenames survive reboot without an index file. There is no pruning or wrap/collision policy beyond the 16-bit parsed index and formatted four-digit name.
- Network edge: camera joins `MuseumHub` / `museum2026` as STA (15 s join timeout), then posts to `http://192.168.4.1/api/image/upload?station=N` using multipart field `image`, MIME `image/jpeg`, and an 8 s HTTP timeout. The full multipart body is allocated contiguously in PSRAM/heap. HTTP 200 alone controls success.
- `SHOOT` first requires Hub Wi-Fi; if join fails, **it does not capture at all**, despite the README statement that the photo remains SD-only when the Hub is unreachable. `CAPTURE`, by contrast, captures regardless of connectivity and uploads only if already connected. This distinction is architecturally important because the robot uses `SHOOT`, not `CAPTURE`.
- ESP-NOW on camera is send-only and initialized best-effort after the Wi-Fi join attempt. It uses the current STA channel and sends `MSG_IMAGE_READY` with node ID 10 after a successful HTTP upload. Current Hub source ignores `MSG_IMAGE_READY`, so this packet is an **implemented transmitter with no active consumer** and does not actually accelerate dashboard refresh.
- Failure fallbacks: camera-init failure leaves commands alive for `INIT`; SD failure degrades to RAM+HTTP; `CAPTURE` while offline retains the new JPEG for later `WIFI` + `SEND`; HTTP/allocation failures preserve the RAM JPEG; flash never fires automatically to reduce brownout risk. Wi-Fi reconnect is blocking up to 15 s only when explicitly needed by `SHOOT`, `SEND`, or `WIFI`.
- Concurrency: camera uses the default Arduino `setup()`/single `loop()` model. Capture, Wi-Fi join, JPEG conversion, and HTTP upload are synchronous/blocking; only command polling and auto timing are cooperative between operations. There is no dedicated FreeRTOS task.

### Mega display — standalone working subsystem, inactive integration edge

- Hardware: Arduino Mega 2560 with a directly plugged 3.2-inch 480×320 write-only MCUFRIEND-style 16-bit TFT shield, physically treated as ILI9481 (`0x9481`) when read ID is `0`, `0xFFFF`, `0xD3D3`, or `0x00D3`. The build enables the Mega special 16-bit bus map; shield use consumes Mega pins 22–53 plus A0–A5.
- Active inputs **inside this target**: USB Serial at 9600 for standalone testing and Mega Serial1 at 9600 for a potential ESP32 link. Each has a separate dynamic `String` line buffer; Serial1 ignores control noise and resets after 64 characters, while USB has no equivalent explicit length cap.
- Implemented newline command vocabulary: `FACE [HAPPY|NEUTRAL|ALERT|SLEEPY]`, `LANG 0|1`, `MENU`, `STATION <1..7> <moving 0|1>`, `EMERGENCY`, and `BOOT`/`RESET`. Parsing is permissive: invalid LANG becomes English, invalid station renders `Unknown`, and unknown commands are ignored with a USB log.
- State owned only in Mega RAM: current screen, emotion, audio-language selection, station, moving flag, and unused menu cursor. Reset boots to a 1.2 s splash and then the happy face. No state is persisted.
- Screen-state set is BOOT, MENU, FACE, STATION, and EMERGENCY. Commands directly replace the screen; there is no emergency latch or separate recovery command beyond any subsequent valid screen command. Bangla means audio-language metadata only; TFT text remains English/romanized.
- Face animation is cooperative in the default AVR loop at a target 33 ms frame cadence. It updates only dirty pupil regions and incremental paired eyelid scanlines, with deterministic eased gaze/blink phases and no task/core split.
- Documented physical link is ESP32 GPIO17 TX → 1 kΩ → Mega RX1 pin 19, optionally Mega TX1 pin 18 → ESP32 GPIO16 RX. **Current robot source proves this edge is inactive and electrically conflicting:** GPIO17 and GPIO16 are already DFPlayer UART2 TX/RX, and the robot has no `Serial1` display command emitter. Do not show station/language/emergency display updates in current normal or emergency sequences.
- The display also has no Wi-Fi/ESP-NOW path, no Hub HTTP path, and no camera/Nano link. It is independently functional via USB commands only in the working repository state.

### Hub node — runtime, server, emergency, and gallery architecture

- Hardware/network authority from [`config.h`](firmware/hub/include/config.h): the Hub ESP32 owns the `MuseumHub` / `museum2026` channel-1 SoftAP at `192.168.4.1`, seven WS2812 station pixels on GPIO15, a passive buzzer on GPIO4, a HIGH-when-pressed emergency input on GPIO21 with internal pull-down, and optional VSPI microSD on SCK18/MISO19/MOSI23/CS5 at 4 MHz. Static UI assets always live in LittleFS even when gallery photos use SD.
- Boot order in [`setup()`](firmware/hub/src/main.cpp:833) is serial → pixels/buzzer/button/random seed → mutex → LittleFS → gallery backend recovery/pruning → legacy-image cleanup → fixed-IP SoftAP → wildcard DNS → 16-entry ESP-NOW queue and unencrypted AP-interface broadcast peer → HTTP routes/custom multipart handler → server → 16 KB web task pinned to Core 0. The Arduino [`loop()`](firmware/hub/src/main.cpp:918) remains on Core 1.
- Core ownership is explicit: [`webTask()`](firmware/hub/src/main.cpp:657) cooperatively services DNS and HTTP on Core 0; the Wi-Fi receive callback validates exact 24-byte packets and non-blockingly queues them; Core 1 drains that queue, settles robot motion, synchronizes emergency state, debounces the button, advances the siren, transmits emergency state, renders LEDs, and yields about 5 ms. [`gState`](firmware/hub/include/MuseumState.h:16) is the only cross-core model and is protected by one FreeRTOS mutex; [`gPhotos`](firmware/hub/src/main.cpp:35) is intentionally Core-0-only.
- Hub receive behavior is narrower than the shared vocabulary: [`processMessage()`](firmware/hub/src/main.cpp:172) consumes LOCATION, EMERGENCY, and HEALTH only. VISITOR_COUNT, IMAGE_READY, COMMAND, and HEARTBEAT are ignored. Packets have no sender-MAC/node allowlist, sequence freshness test, replay rejection, acknowledgement, or queue-overflow report.
- LOCATION maps station IDs 1–7 to configured names, copies the moving flag, and refreshes a timestamp; [`settleRobotMotion()`](firmware/hub/src/main.cpp:911) forces moving false after 2.5 s without refresh. Because the current robot target sends no LOCATION packet, this is an implemented Hub receiver with no active robot sender; only the unauthenticated local `/api/robot/advance` simulator currently changes Hub robot position in the five-project combination.
- Emergency is Hub-owned shared state. A dashboard POST, valid incoming EMERGENCY packet, or physical button transition changes the same Boolean. A short debounced press raises it; holding the button for 3 s clears it. [`syncAlarmFromState()`](firmware/hub/src/main.cpp:749) also makes dashboard/radio clear stop `tone()` immediately.
- [`pumpEmergencyBroadcast()`](firmware/hub/src/main.cpp:226) is the Hub's only active ESP-NOW transmitter: every transition sends immediately and initiates the configured six-frame transition burst at 60 ms spacing, then the current state is rebroadcast every 2 s. Packets are channel-1 broadcast, unencrypted, use Hub node ID 10, increment a RAM-only 16-bit sequence, and carry uptime. The robot actively consumes this packet; the camera does not.
- Emergency outputs are non-blocking: the passive buzzer alternates 600/1200 Hz every 400 ms, while all seven pixels blink red at roughly 250 ms toggles. Outside emergency, only the known current-station pixel lights—blue while moving, green while not moving; unknown/no station leaves all pixels dark.
- Shared RAM state includes robot state, emergency, up to eight health rows, up to 24 drop-oldest visitor requests, cumulative approval count, and latest-image metadata. Visitor/check-in/health/robot state is not persisted. Approval count is cumulative rather than occupancy; denial after approval does not decrement it, and missing IDs still receive `{ok:true}` from approve/deny handlers.
- Browser/API surface in [`setup()`](firmware/hub/src/main.cpp:883): `GET /api/state`, `POST /api/checkin`, `GET /api/enter`, `GET /api/request`, `POST /api/approve`, `POST /api/deny`, `POST /api/emergency`, `POST /api/robot/advance`, multipart `POST /api/image/upload`, `GET /api/image`, `GET /api/gallery`, and `POST /api/gallery/clear`. No route has authentication or authorization; every associated control is available to any SoftAP client.
- Camera ingestion accepts only multipart field `image` with exact MIME `image/jpeg`; raw POST receives 415. Upload chunks stream to LittleFS `/upload.tmp` with a 65,535-byte ceiling, then completion verifies received-versus-saved size and JPEG SOI/EOI before committing. This is framing/completeness validation, not a full JPEG decode. A failed upload removes scratch and preserves the previous newest image.
- [`PhotoStore`](firmware/hub/src/PhotoStore.cpp) tries SD three times and falls back to LittleFS, rebuilds a newest-first maximum-32-entry RAM index, and enforces the configured 12-photo gallery. Actual filenames are strict 8.3 such as `/photos/I00012S3.JPG`; comments/README examples using `IMG_<seq>_S<station>.JPG` are stale. Even for an SD gallery, multipart chunks stage in LittleFS and are copied to SD once at commit.
- Gallery sequence state is persisted in `/photos/SEQ.TXT`; normal clear deletes photos but deliberately retains the issued-sequence floor so immutable `/api/image?seq=N` URLs are not reused. At the hard ceiling 65,000, source wipes the gallery and resets the sequence, an exceptional eventual violation of the never-reuse cache invariant. Eviction occurs before a new final copy, so a later commit failure can leave the gallery down one older photo.
- Static files are served from LittleFS with no-cache headers. Wildcard DNS points every hostname to the Hub, but only recognized OS captive-probe paths redirect to `/`; arbitrary missing files return 404. Per-sequence images receive one-year immutable caching, whereas newest-image, gallery, state, and deployed app files are uncached.
- Source/README reconciliation: dual-core split, emergency timer, passive-buzzer behavior, multipart upload, SD→LittleFS fallback, and 12-photo retention are implemented. Claimed robot LOCATION heartbeat is not implemented by the current robot; camera IMAGE_READY has no Hub consumer; and documented long gallery filenames differ from strict runtime names. These must be shown as inactive/drift notes, not active connectors.

### Hub deployed browser bundle — visitor check-in entry path

- [`firmware/hub/data/README.txt`](firmware/hub/data/README.txt) defines the deployment boundary: the HTML/CSS/JavaScript bundle, including a vendored offline QR decoder, is flashed separately into Hub LittleFS and served at `http://192.168.4.1/`. This is a build/deployment edge, not a runtime network service outside the Hub.
- [`index.html`](firmware/hub/data/index.html) is the visitor gate/check-in page. It accepts either an image selected/taken through a camera-backed file input or a demo simulation button; it deliberately avoids `getUserMedia()` because the Hub serves plain HTTP.
- The project-owned gate allows exactly two decoded QR payloads: literal `MUSEUM-ENTRY-2026` and `http://192.168.4.1/api/enter`. A successful in-page decode does not navigate to that payload; it calls `POST /api/checkin`, stores the returned RAM request ID, and polls `GET /api/request?id=...` every 800 ms until approved or denied.
- A second native-camera flow exists: scanning the URL QR outside the web page opens `GET /api/enter`; the Hub creates the request and redirects to `/index.html?autoid=<id>`, where the page skips QR decoding and starts the same 800 ms status poll. Approval redirects the browser to `visitor.html?id=<id>` after 800 ms; denial stays on the gate page.
- QR decode is entirely client-side/offline through `js/vendor/jsQR.js` called by project-owned [`qr.js`](firmware/hub/data/js/qr.js). If that vendor script is absent, the real scan reports scanner unavailable while the explicit simulation path remains usable.

### Hub deployed browser bundle — visitor and administrator views

- [`visitor.html`](firmware/hub/data/visitor.html) is a read-only public dashboard after check-in: it subscribes to Hub state, shows the emergency banner, current/next artifact, moving-versus-not-moving dot, bilingual artifact catalogue, and the request status once when an `id` query parameter is present. It does not continuously enforce approval or gate access; anyone knowing the page URL can open it.
- Both visitor and administrator artifact lookup functions fall back to `ARTIFACTS[0]` when Hub station is empty or unknown. Consequently the current active five-project system—whose robot emits no LOCATION—visually presents the first artifact as though it were current rather than exposing an unknown/offline robot state.
- [`admin.html`](firmware/hub/data/admin.html) renders cumulative approvals under the misleading label “Visitors inside,” pending requests, local robot simulation, emergency control, ESP-NOW health rows, and the camera gallery. Its static note still calls health data mock even though real mode renders Hub-received HEALTH packets.
- Health presentation applies browser-only thresholds: alert above 31 °C, above 70% RH, or gas above 500; watch at/above 28 °C, at/below 35% RH, or gas at/above 300; otherwise good. These labels do not feed back into Hub firmware, emergency state, or any radio command.
- Admin approve/deny/emergency/robot-advance actions call the adapter without awaiting or checking HTTP responses and immediately redraw cached state; authoritative results appear on a later state poll. The gallery clear path is similarly optimistic, empties local UI immediately, then refetches after 400 ms.
- Gallery dataflow is intentionally split: the 1.5 s state poll carries only newest image metadata; the page fetches `/api/gallery` initially and when newest sequence changes. Latest and thumbnail pixels use immutable `/api/image?seq=N` URLs, lazy loading, and a client-side lightbox. No WebSocket, server-sent event, or camera IMAGE_READY event reaches the browser.
- Browser templates interpolate request IDs, station-derived content, and health values through `innerHTML` and inline handlers. Current Hub-generated IDs and station strings are constrained, but this is an unsafe extension point if future radio/API data becomes attacker-controlled.

### Hub deployed browser bundle — shared content and backend adapter

- [`data.js`](firmware/hub/data/js/data.js) is browser-owned content/state, not firmware telemetry: it defines the ordered seven-station ID/name catalogue, English/Bangla strings, and the language preference persisted under localStorage key `museum:lang` with Bangla as the default. This order is the browser's next-station sequence and must match Hub station IDs for correct labels.
- [`hub.js`](firmware/hub/data/js/hub.js) is the only browser-to-backend adapter. It selects the real HTTP API **only** when `location.hostname === "192.168.4.1"`; pages reached through a captive-portal hostname, mDNS name, localhost, or `file://` silently use the localStorage mock instead, even when the HTML itself came from the Hub.
- Every call to [`Hub.subscribe()`](firmware/hub/data/js/hub.js:53) creates its own interval: real mode polls `/api/state` every 1.5 s; mock mode publishes localStorage every 1 s and also listens for storage/custom events. There is no interval deduplication or unsubscribe-driven timer cleanup, though current pages subscribe only once.
- Real polling deliberately keeps the last cache on fetch/JSON failure and exposes no offline/stale indicator. Command POSTs are fire-and-forget, and requests do not inspect `Response.ok`; the adapter can therefore display old authoritative state without surfacing server rejection.
- The mock is a complete alternative browser-only architecture with seeded health values, local visitor requests, robot advancement, and emergency state in localStorage. It is useful for development but must remain outside the deployed-runtime dataflow in diagrams; exact-IP detection is the gate between the two.
- [`qr.js`](firmware/hub/data/js/qr.js) documents the vendored decoder as jsQR 1.4.0. It scales either image dimension down to at most 1,600 px, draws to an ephemeral canvas, decodes with normal/inverted attempts, and revokes its object URL on every result. The simulated return string is not itself validated; the page's simulation button simply starts check-in after calling it.
- [`style.css`](firmware/hub/data/css/style.css) is presentation-only architecture: a phone-first maximum-760 px layout using a sand/paper/terracotta museum palette, responsive cards/tables, emergency animation, and QVGA-aware gallery/lightbox treatment. It creates no additional transport, state owner, persistence, or runtime integration.
- Targeted inspection of the deployed [`jsQR.js`](firmware/hub/data/js/vendor/jsQR.js:1) confirms a bundled UMD/webpack decoder that exports global [`window.jsQR`](firmware/hub/data/js/vendor/jsQR.js:9), the only surface consumed by project code. No embedded package-version banner was found, so the 1.4.0 identification comes from the project-owned integration comment rather than independently encoded vendor metadata; decoder internals remain outside subsystem architecture.

### Cross-project interface search — active and inactive proof

- A source-only search across the five targets reconfirms exactly two ESP-NOW send sites: Hub [`broadcastEmergency()`](firmware/hub/src/main.cpp:208) sends EMERGENCY, and camera [`notifyHubImageReady()`](firmware/cam/src/main.cpp:518) sends IMAGE_READY. Robot has no [`esp_now_send()`](ESP32_RFID_MP3_RAIL/ESP32_RFID_MP3.ino) call; its only accepted radio type is EMERGENCY. Hub consumes LOCATION/EMERGENCY/HEALTH and ignores IMAGE_READY. Therefore the only effective ESP-NOW edge among these five targets is Hub → robot EMERGENCY; camera → broadcast IMAGE_READY has no behavioral receiver.
- Robot/camera source agrees on the active one-way serial trigger: robot [`sendCameraShoot()`](ESP32_RFID_MP3_RAIL/ESP32_RFID_MP3.ino:463) emits newline `SHOOT N` on GPIO14 at 9600, and camera [`RobotLink.begin()`](firmware/cam/src/main.cpp:613) receives on GPIO13 at 9600. No camera-to-robot return protocol exists.
- Camera/Hub source agrees on the active photo edge: camera uploads multipart field `image` to `/api/image/upload`, and Hub's custom handler accepts exactly that route/field/MIME. The later IMAGE_READY broadcast is redundant for current behavior because successful HTTP commit already mutates Hub gallery state and browser polling discovers the new sequence.
- Robot/Nano source agrees on a bidirectional 9600-baud newline protocol over robot UART1 GPIO25/26 and Nano USB UART D0/D1. Robot sends motion/tuning commands; Nano owns motor outputs and returns READY/STATE/TUNE/OK/error text. This is the only active wired bidirectional application link in the five-target combination.
- Display search finds only its own Serial1 receiver and command parser; no matching `FACE`, `LANG`, `MENU`, `STATION`, or display `EMERGENCY` sender exists in robot, Hub, camera, or Nano source. Treat all display control edges as absent, not merely unverified.

### End-to-end normal-tour event flow

1. Safe startup is distributed but conservative: Nano boots into active hard brake; robot then sends `STOP` and `GET`, starts with its tour stop latch set, and will not move until the START card/audio path succeeds. Camera and Hub boot independently; neither is required for Nano's safe state.
2. MFRC522 reads and halts a card. Unknown UIDs only log; a repeated identical UID inside 1.5 s is ignored. START UID clears the stop latch, sends Nano `STOP`, plays track 1, and sends Nano `START` only after a valid DFPlayer completion at least 1.5 s after start.
3. Each station UID maps tracks 2–8 to station IDs 1–7. Robot sends Nano `STOP`, starts narration, and schedules one camera command for two seconds later. The timer is non-blocking and fires only while narration remains active; completion/error/timeout/emergency/end/start cancellation prevents a late shot after motion might resume.
4. At the deadline robot sends `SHOOT N` one-way. Camera may block up to 15 s joining `MuseumHub`; if it cannot join, no frame is captured. If joined, it captures RGB565, software-encodes JPEG, retains it in RAM, optionally writes camera-local SD, then performs multipart HTTP upload.
5. Hub streams upload chunks into LittleFS scratch, validates size and SOI/EOI, commits into the 12-image SD/LittleFS gallery, updates mutex-protected latest metadata, and replies HTTP 200. Camera then best-effort broadcasts IMAGE_READY, but Hub ignores it. Admin polling discovers the changed newest sequence within about 1.5 s and fetches the gallery/images.
6. Independently, DFPlayer completion causes robot to cancel any still-pending shot and send Nano `START` if the latch remains clear. DFPlayer unavailable/error or 90 s timeout leaves Nano stopped. END UID stops playback, cancels photography, sends Nano `STOP`, and latches the tour stopped until START.
7. The normal flow contains no robot→Hub station update and no robot→Mega display update. Hub station LEDs and visitor/admin robot cards therefore do not follow physical tour movement unless the admin's local simulation endpoint is used; the display remains outside the runtime path.

### End-to-end emergency event flow

1. Emergency can originate from Hub's physical GPIO21 button, unauthenticated admin POST, or any checksum-valid broadcast EMERGENCY packet. Hub adopts the Boolean, mirrors siren/LED outputs, and marks outbound state dirty.
2. Core 1 broadcasts immediately, repeats a six-frame transition burst at 60 ms gaps, then rebroadcasts every 2 s. Robot callback validates packet shape/checksum and stores only the requested Boolean; the main loop applies the transition before RFID or audio completion handling.
3. On raise, robot cancels pending photography, stops narration/DFPlayer, clears its normal stop latch, and commands Nano `START`. Every mapped card—including START/stations—is ignored except END; the robot therefore drives toward the physical END card without station stops or photos.
4. END during emergency commands Nano hard brake, sets the normal stop latch, and marks emergency end reached. Hub remains in emergency: LEDs continue red blink, buzzer continues two-tone wail, browser banners remain active, and the robot ignores other cards.
5. Clearing by three-second button hold, admin POST, or accepted radio state makes Hub stop the siren and broadcast false. Robot responds by stopping audio/photo activity, commanding Nano `STOP`, and latching stopped. A fresh START card is mandatory before normal movement resumes.
6. Failure boundary: ESP-NOW is unauthenticated broadcast without acknowledgements or sender/sequence checks. Transition bursts reduce packet-loss exposure, and periodic state repairs late/rebooted listeners, but channel mismatch/ESP-NOW init failure/continuous interference can prevent robot evacuation behavior with no end-to-end confirmation at Hub.

### State ownership and persistence matrix

| Owner | Authoritative volatile state | Persistent state | Reset/fallback consequence |
|---|---|---|---|
| Robot ESP32 | tour latch, narration/resume, pending camera timer, emergency-applied state, Nano-confirmed tuning cache, rail reply state, bounded event log | none in robot firmware | boots latched stopped; log/status and emergency knowledge reset until Hub rebroadcast |
| Nano ATmega328P | motor run/brake output and live ML/MR pair | EEPROM magic + ML/MR PWM pair | boots hard-braked, loads valid pair or compiled 150/210 defaults |
| Camera ESP32 | readiness, latest JPEG, station, optional SD path, auto timer | optional numbered JPEGs on camera SD | RAM retry image is lost; SD files survive; SD is not mounted until `INIT` |
| Hub ESP32 | mutex model for emergency/robot/health/visitors/latest image; ESP-NOW sequence; button/siren phases | gallery JPEGs + `SEQ.TXT`; deployed UI in LittleFS | emergency resets false until a source raises it; visitor/health/robot state resets; gallery is recovered/pruned |
| Mega 2560 display | screen/emotion/language/station/moving | none | boots splash then happy face; no working-combo sender restores context |
| Browser | current cached Hub state, gallery view, current page | language preference; full mock backend only outside exact-IP real mode | stale cache is silently retained on HTTP failure; mock may look operational while disconnected from Hub |

### Source/README discrepancy register

| Topic | Documentation claim | Current source authority | Diagram treatment |
|---|---|---|---|
| Camera trigger pin | Camera README says guide ESP32 GPIO27 → camera GPIO13 | Robot source/README use GPIO14 → GPIO13; camera config only fixes its GPIO13 receiver | active edge labeled GPIO14→GPIO13; annotate camera README GPIO27 as stale |
| Camera offline `SHOOT` | Camera README says unreachable Hub skips upload and leaves photo SD-only | `SHOOT` calls `ensureWifi()` before `doCapture()` and does not capture if join fails | show Wi-Fi as a precondition for robot-triggered capture; offline local fallback belongs only to `CAPTURE` |
| Camera SD startup | README examples imply capture-to-SD boot and Hub upload after successful SD capture | current setup does not mount SD at boot; `INIT` attempts SD; capture succeeds in RAM/HTTP without SD | SD is optional dashed persistence, not a required pipeline stage |
| Camera robot-card rule | Camera README says every card except start triggers it | robot source triggers only station tracks 2–8; END, START, unknown, duplicate, early-ended narration, and emergency do not | station-only event connector |
| Hub robot LOCATION | Hub README says robot broadcasts scan/start/stop plus 1 s LOCATION heartbeat | current robot is ESP-NOW receive-only and has no location packet/send call | receiver capability dashed/unpaired; do not animate LEDs/dashboard from physical robot |
| Hub gallery names | Hub README/header comments show `/photos/IMG_00001_S1.JPG` and imply filename-only recovery | implementation uses strict `/photos/I00001S1.JPG` plus `/photos/SEQ.TXT` sequence floor | use strict 8.3 runtime name and explicit sequence metadata file |
| Hub source-of-truth wording | Hub README calls Hub the single emergency source | Hub also accepts any checksum-valid incoming EMERGENCY and adopts it without sender authorization | label Hub as runtime state owner/relay, with unauthenticated external-radio input risk |
| Hub burst wording | README says immediate plus `EMERGENCY_BURST_COUNT` repeats | implementation initializes `burstLeft=count`, sends one immediately while decrementing, resulting in `count` total transition frames, not one-plus-count | label “six-frame transition burst total,” then 2 s periodic |
| Hub visitor count | UI labels approved cumulative total as “Visitors inside” | no exits/decrement; deny-after-approve retains count; VISITOR_COUNT packets ignored | call it cumulative approvals, with UI-label caveat |
| Hub robot status | JSON calls every non-moving state `narrating` | includes boot/no-location/unknown robot | do not imply online presence; flag no staleness/unknown model |
| Hub browser real mode | documentation assumes pages served by Hub use real API | adapter requires exact hostname `192.168.4.1`; captive aliases use mock | show exact-IP mode gate and localStorage fallback |
| Camera IMAGE_READY | camera README calls an ESP-NOW ready ping part of integration | camera sends it after HTTP 200, Hub ignores the type | dashed implemented-but-no-effect edge |
| Camera/Hub node IDs | each config uses numeric node ID 10 | both may identify as 10; receivers currently do not authorize by ID | note semantic collision in protocol page, not an active failure |
| Mega integration | display README states robot ESP32 sends Serial1 commands on GPIO17/16 | current robot assigns those pins to DFPlayer UART2 and emits no display commands | display outside active runtime boundary with pin-conflicting documented edge |
| Nano header comment | Nano source comment names an older `ESP32_RFID_MP3_LFR` controller | actual active peer is `ESP32_RFID_MP3_RAIL`, and wire/protocol implementation matches | treat comment as stale naming only; active robot↔Nano UART remains proven |

### Consolidated hardware, pin, transport, and timing inventory

| Subsystem | Local hardware / pins | Active external interface | Rate/channel/timing |
|---|---|---|---|
| Robot ESP32 | MFRC522 VSPI SS5/SCK18/MOSI23/MISO19; DFPlayer RX16/TX17; Nano RX25/TX26; camera software TX14 | Nano text UART; camera text trigger; Hub emergency ESP-NOW receive; local HTTP field console | UARTs 9600 8N1; camera 9600 one-way; ESP-NOW/SoftAP ch 1; USB 115200; RFID duplicate 1.5 s; photo delay 2 s; audio min 1.5 s/max 90 s |
| Nano ATmega328P | L298N A ENA D10/IN1 D8/IN2 D7; B ENB D5/IN3 D11/IN4 D12 | D0/D1 text UART to robot; L298N PWM/direction | 9600 8N1 newline; forward PWM ML/MR; hard brake HIGH/HIGH + PWM255 |
| Camera ESP32S-CAM | GC2145 DVP GPIO0/5/18/19/21/22/23/25/26/27/32/34/35/36/39; flash4; SD one-bit D0=2/CLK14/CMD15; robot RX13 | robot trigger UART; Hub Wi-Fi STA + HTTP; best-effort ESP-NOW send; USB command console | trigger 9600; USB 115200; Hub ch 1; Wi-Fi join 15 s; HTTP timeout 8 s; XCLK 10 MHz; QVGA RGB565; two 40 ms warmup frames |
| Hub ESP32 | pixels15 ×7; passive buzzer4; emergency button21; SD VSPI SCK18/MISO19/MOSI23/CS5 | MuseumHub SoftAP/DNS/HTTP; ESP-NOW receive and emergency send; browsers/camera as Wi-Fi clients | SoftAP/ESP-NOW ch 1; HTTP 80 at 192.168.4.1; serial 115200; Core-1 loop ~5 ms; burst 6 total ×60 ms; periodic 2 s; LED red toggle ~250 ms; siren note 400 ms; hold-clear 3 s; motion settle 2.5 s |
| Mega display | 480×320 MCUFRIEND 16-bit shield pins22–53+A0–A5; Serial1 RX19/TX18 | USB test console only in active combination; potential Serial1 protocol has no sender | USB/Serial1 9600; face target 33 ms; boot splash 1.2 s |
| Hub browsers | phone/laptop camera, canvas, localStorage | HTTP fetch to exact-IP Hub; offline jsQR inside page | state poll 1.5 s; request decision poll 800 ms; mock poll 1 s; gallery clear refetch 400 ms |

### Safety and failure-fallback summary

- **Motion:** Nano's boot state and robot reboot command are both hard brake; unknown/malformed Nano lines do not move it. Tour movement requires recognized START. Audio failure/timeouts stop rather than resume. Emergency intentionally reverses the normal safety choice by commanding forward evacuation until END; no obstacle/position sensor or command acknowledgement protects this run.
- **Photography:** pending trigger is cancelled whenever narration no longer proves the rail is stopped. Camera retains the last good RAM JPEG across capture/upload failures until reset; optional SD adds local persistence. Robot-triggered `SHOOT` has no offline capture fallback because Hub Wi-Fi is checked first.
- **Storage:** Hub falls from SD to LittleFS and recovers valid gallery files at boot. Upload staging plus JPEG marker/size checks preserve prior newest image on most failures, but pre-commit eviction can lose one old photo. Static UI depends on LittleFS even when gallery SD is healthy.
- **Emergency transport:** transition burst and periodic rebroadcast provide eventual-state repair but not delivery proof. Any valid-looking broadcaster can raise or clear state, and robot cannot authenticate the Hub. A Hub reboot resets emergency false and begins broadcasting false unless the physical/button/dashboard/external-radio state is raised again.
- **Web/control:** Hub and robot APIs are unauthenticated on password-protected SoftAPs; passwords are compiled plaintext and identical. Browser failures are mostly silent/stale. Hub upload checks MIME, size, and JPEG edge markers but not image decode; check-in approval is a UI workflow rather than route-level access control.
- **Display:** no active sender means display state cannot affect safety and cannot communicate emergency. A standalone Mega can show EMERGENCY only when manually commanded over USB/Serial1.

### Active/inactive edge matrix

| From | To | Status | Interface and payload | Architectural consequence |
|---|---|---|---|---|
| RFID cards | Robot ESP32 | active | MFRC522 VSPI, nine 4-byte UID mappings | sole physical tour-position trigger; unknown/duplicate are no-op |
| Robot ESP32 | DFPlayer | active | UART2 GPIO17→RX, 9600; MP3 folder tracks 1–8 | narration gates motion; playback result controls safe resume |
| DFPlayer | Robot ESP32 | active | UART2 TX→GPIO16, 9600 events | finish/error drives resume-or-stop policy |
| Robot ESP32 | Nano | active | UART1 GPIO26→D0, 9600 newline commands | motion/tuning requests |
| Nano | Robot ESP32 | active | D1→divider→GPIO25, 9600 text replies | confirmed run/tuning status, no sensor telemetry |
| Nano | L298N/motors | active | six GPIO outputs, two PWM channels | forward-only propulsion or active hard brake |
| Robot ESP32 | Camera | active one-way | GPIO14→GPIO13, 9600 `SHOOT N\n` | station-only delayed photo trigger; no acknowledgement |
| Camera | Hub | active | MuseumHub STA, multipart JPEG HTTP POST | authoritative gallery ingestion path |
| Hub | Robot ESP32 | active one-way behavior | channel-1 broadcast ESP-NOW EMERGENCY | evacuation/clear transitions; no acknowledgement/authentication |
| Browser clients | Hub | active bidirectional | MuseumHub HTTP/DNS; polling + control POSTs | visitor/admin/check-in/gallery/field control surfaces |
| Robot service browser | Robot ESP32 | active bidirectional | separate `ESP32-MP3-RAIL` SoftAP HTTP | volume, Nano PWM, status, bounded log; independent of Hub AP |
| Hub | station LEDs/siren | active local | GPIO15 WS2812 + GPIO4 `tone()` | local emergency annunciation; normal station indication lacks live robot source |
| Hub button | Hub | active local | GPIO21 HIGH, 50 ms debounce, 3 s hold clear | physical emergency source |
| Camera | camera-local SD | optional/inactive at boot | one-bit SD_MMC, `/photos/IMG_####.JPG` | available only after `INIT`; not required for HTTP capture |
| Hub | Hub gallery SD | optional active-or-fallback | VSPI 4 MHz; LittleFS fallback | persistent gallery backend selected at boot |
| Camera | Hub via IMAGE_READY | implemented but no effect | ESP-NOW `MSG_IMAGE_READY` after HTTP 200 | Hub ignores it; browser still relies on polling |
| Robot ESP32 | Hub via LOCATION | absent | no send implementation | physical robot cannot update Hub station/dashboard/normal LEDs |
| Robot/Hub | Mega display | absent and pin-conflicting | documented 9600 UART would reuse DFPlayer GPIO16/17 | display is standalone only, outside active system boundary |
| Browser localStorage mock | Hub | mutually exclusive | selected whenever hostname is not exactly `192.168.4.1` | can present a simulated system with no Hub API traffic |

## Draw.io architecture suite — build specification

### Suite order and page specifications

#### Page 1 — exact title: `01 — Working-Combo System Context & Active Interfaces`

- **Purpose:** establish the only code-proven runtime boundary and make active versus inactive integrations unambiguous before any detailed flow page.
- **Audience:** judges, team members, hardware integrators, and future maintainers needing a one-page orientation.
- **Scope:** all five authoritative targets, directly attached peripherals/storage/browsers, active inter-node transports, and three critical inactive edges. Exclude internal function-level detail and historical projects.
- **Nodes/containers:** `Active working-combo runtime` outer boundary; Hub ESP32; Robot ESP32; Nano rail actuator; ESP32-CAM; Visitor/Admin browser clients; local robot field-console client; RFID cards; DFPlayer+speaker; L298N+motors; GC2145; Hub LittleFS; Hub SD or LittleFS gallery; camera optional SD; Hub button/siren/seven LEDs. Place Mega display in a separate `Standalone / not runtime-integrated` container.
- **Connectors:** active robot↔Nano UART; robot→camera trigger; camera→Hub HTTP; Hub→robot emergency ESP-NOW; browser↔Hub HTTP/DNS; field client↔robot HTTP; each controller→owned local hardware/storage. Dashed gray camera→Hub IMAGE_READY with `receiver ignores`; dashed gray robot→Hub LOCATION with `no sender`; dashed red robot⇢Mega UART with `not implemented; GPIO16/17 occupied by DFPlayer`.
- **Legend:** solid arrow = active one-way; solid double-headed = active request/reply; dotted attachment = local peripheral/storage; gray dashed = code exists at one end/no runtime effect; red dashed = documented but absent/conflicting; cylinder = persistent; chip = controller; browser = human UI.
- **Visual hierarchy:** Hub and Robot are the two largest primary cards centered left/right; Nano below Robot, Camera between Robot and Hub, browsers above Hub; local peripherals orbit their owner; Mega sits outside boundary at bottom-right. Keep emergency red edge visually dominant and normal data paths transport-colored.

#### Page 2 — exact title: `02 — Hardware Ownership, Wiring & Pin Allocation`

- **Purpose:** provide a build/diagnostic wiring reference without confusing same-number pins on different boards.
- **Audience:** electrical assembly, pit repair, firmware flashing, and safety review.
- **Scope:** physical boards, voltage/direction notes, all product pins, shared grounds, flash-disconnect warnings, and local buses. Include transport rates but not web APIs or state machines.
- **Swimlanes:** Robot ESP32; Nano + L298N; ESP32-CAM; Hub ESP32; Mega display standalone.
- **Nodes:** pin-group tables inside each board; MFRC522, DFPlayer, Nano UART divider, motors, camera sensor/SD/flash, Hub SD/LED/buzzer/button, TFT shield.
- **Connectors:** label every wire endpoint and direction: robot GPIO26→Nano D0; Nano D1→10 kΩ/20 kΩ divider→robot GPIO25; robot GPIO14→cam GPIO13; DFPlayer TX→GPIO16 and GPIO17→RX through ~1 kΩ; all SPI/DVP/SD groups. Show common ground badges.
- **Legend:** 3.3 V logic, 5 V power/logic, divider/resistor, PWM, SPI, UART TX direction, optional attachment, disconnect-before-flash marker.
- **Visual hierarchy:** board columns use compact pin tables; safety callouts in amber; do not draw Mega's documented ESP32 wire as installed—show it in an isolated red `Do not wire in current combo` inset.

#### Page 3 — exact title: `03 — Normal Tour, Narration & Photo Sequence`

- **Purpose:** explain the operational happy path and where motion safety gates photography/audio.
- **Audience:** demonstration operators, firmware maintainers, and judges asking how the system behaves.
- **Swimlanes:** RFID/visitor action; Robot ESP32; Nano/L298N; DFPlayer; Camera; Hub Core 0/gallery; Admin browser.
- **Sequence:** boot brake/STOP+GET; START scan→STOP→track1→finished→START; station scan→STOP→track2–8→schedule 2 s→SHOOT→Wi-Fi precondition→RGB565/JPEG→optional camera SD→multipart upload→Hub scratch/validate/commit→HTTP 200→ignored IMAGE_READY→browser poll/gallery fetch; narration finish→START; END→STOP+latch.
- **Alternative fragments:** unknown/duplicate UID no-op; DFPlayer unavailable/error/90 s timeout stays stopped; narration ends before 2 s cancels shot; Hub Wi-Fi unavailable makes robot-triggered SHOOT capture nothing; failed HTTP retains camera RAM JPEG.
- **Legend:** synchronous call, asynchronous scheduled event, state mutation, persistence write, cancellation, safe fallback.
- **Visual hierarchy:** one left-to-right primary path with green success band; safety/failure fragments below in amber/red; emphasize that motion resume and photo upload are independent after trigger.

#### Page 4 — exact title: `04 — Emergency State Machine & Evacuation Sequence`

- **Purpose:** make emergency authority, timing, robot priority, and recovery behavior reviewable.
- **Audience:** safety reviewers, operators, judges, and firmware maintainers.
- **Swimlanes:** physical button/admin/external radio; Hub Core 1 + shared state; Hub outputs/browser; ESP-NOW; Robot main loop; Nano/motors; RFID END.
- **Sequence/connectors:** short press/admin/radio→Hub Boolean; immediate six-frame total burst at 60 ms; red LED blink + 600/1200 Hz siren; robot callback flag→apply before card/audio→cancel photo/stop audio→Nano START; ignore all cards except END; END→hard brake; periodic 2 s broadcasts; three-second hold/admin/radio clear→Hub outputs off→false broadcast→robot STOP+latch→START card required.
- **State inset:** Hub `normal/emergency`; robot `normal tour/emergency running/emergency stopped at END/post-clear latched`; transitions and guards.
- **Failure/risk callouts:** no acknowledgement/authentication/replay filtering; channel 1 dependency; Hub reboot starts false; no obstacle/end-position sensor beyond RFID.
- **Legend:** red thick = emergency command/state; red dashed = periodic rebroadcast; black guard label; amber risk; green explicit recovery.
- **Visual hierarchy:** emergency raise path dominates top half; clear/recovery path separate below; no Mega display lane because it is not integrated—one footnote states this explicitly.

#### Page 5 — exact title: `05 — Hub Runtime, APIs, Browser Polling & Persistence`

- **Purpose:** document Hub concurrency and data ownership, including browser and camera traffic.
- **Audience:** web/firmware maintainers and debugging operators.
- **Scope/lanes:** Wi-Fi callback; Core 0 `webTask`; mutex-protected `MuseumState`; Core 1 `loop`; `PhotoStore`; LittleFS UI/scratch; SD-or-LittleFS gallery; visitor/admin browser.
- **Nodes:** 16-message ESP-NOW queue; DNS/WebServer; all API route groups; upload handler; gallery index; emergency publisher; LED/siren/button; exact-IP backend gate; browser state cache/localStorage mock.
- **Connectors:** callback→queue→Core1; HTTP handlers↔state mutex; upload→LittleFS temp→validation→gallery commit→latest metadata; `/api/state` 1.5 s poll; check-in 800 ms request poll; gallery refresh on sequence change; immutable image fetch; deployment uploadfs→LittleFS assets.
- **Route grouping:** State/visitor (`state`, `checkin`, `enter`, `request`, `approve`, `deny`); controls (`emergency`, mock `robot/advance`); images (`image/upload`, `image`, `gallery`, `gallery/clear`); static/captive portal.
- **Legend:** Core 0 blue, Core 1 violet, mutex state gold, persistent cylinder, volatile RAM rounded rectangle, polling dashed blue, unauthenticated control red key-open badge.
- **Visual hierarchy:** core split is the page backbone; shared state centered; storage below Core 0; physical outputs below Core 1; browser at left. Add a compact ignored-message list beside queue.

#### Page 6 — exact title: `06 — Ownership, Protocol Contracts, Fallbacks & Gaps`

- **Purpose:** act as the engineering source-of-truth/reference page for what persists, what fails safe, and what is declared versus active.
- **Audience:** maintainers, reviewers, and anyone extending integrations.
- **Scope:** state/persistence matrix, protocol cards, API/security caveats, discrepancy register, and inactive links; no long event sequence.
- **Nodes:** one ownership card per controller/browser; `MuseumMessage` 24-byte schema card; Nano text command/reply card; camera multipart contract card; display standalone command card; fallback decision trees for audio/camera/storage/radio; top discrepancy/risk badges.
- **Connectors:** protocol `producer → consumer` mini-edges with status chips `ACTIVE`, `NO SENDER`, `IGNORED`, `STANDALONE`; persistence arrows to EEPROM/SD/LittleFS/localStorage.
- **Legend:** green status active; amber optional/degraded; gray inactive; red mismatch/security risk; `RAM` versus `PERSISTENT` badges.
- **Visual hierarchy:** three horizontal bands: contracts; ownership/persistence; gaps/fallbacks. Limit discrepancy text to the authoritative short form from the register above.

### Shared beautification system

- **Canvas/page:** Draw.io custom 16:9 landscape, 1600×900 logical px (or A3 landscape for printable Page 2); 48 px outer margin; 24 px major grid; 12 px minor spacing. Keep every page readable at 100% and printable in grayscale through labels/line styles, not color alone.
- **Typography:** `Inter` when available, fallback `Arial`; page title 28 px semibold; section/container title 18 px semibold; node title 15 px semibold; body/edge label 12–13 px; code/protocol labels `JetBrains Mono`/`Courier New` 11–12 px. Sentence case, maximum two text weights per node.
- **Subsystem palette:** Hub navy `#1F4E78`; Robot teal `#0F766E`; Nano indigo `#4F46E5`; Camera amber `#D97706`; Browser terracotta `#B4532A`; Display standalone slate `#64748B`; storage gold `#A16207`; emergency crimson `#C62828`. Use 8–12% tint fills with full-color headers/borders.
- **Transport palette:** UART purple `#7C3AED`; HTTP/Wi-Fi blue `#2563EB`; ESP-NOW emergency red `#DC2626`; SPI/local hardware charcoal `#475569`; persistence gold `#CA8A04`; browser polling cyan `#0891B2`. Transport color never replaces subsystem fill.
- **Containers:** 12 px corner radius; 1.5 px border; 8% header tint; 16 px internal padding; subtle shadow only for primary controllers. Runtime boundary is a 2 px dark outline; standalone/inactive areas use a gray dashed outline and no shadow.
- **Nodes/shapes:** microcontroller/chip icon for boards; browser window for UIs; cylinder for SD/EEPROM/LittleFS persistence; small RAM chip for volatile state; radio waves for ESP-NOW; camera, speaker, RFID, motor, LED, button icons only where semantic. Never use decorative clip art.
- **Line semantics:** active one-way = solid 2 px filled arrow; active request/reply = paired arrows or solid 2 px double-head only when truly bidirectional; local peripheral = solid 1.5 px; scheduled/polling = long-dash 1.5 px; optional = dotted 1.5 px; implemented-no-effect = gray dash-dot; absent/conflicting = red dashed with terminal `×`; emergency = 3 px crimson. Avoid crossings; use orthogonal connectors and labeled junction-free routes.
- **Labels:** every inter-board edge includes transport, direction, pins/endpoints where physical, baud/channel/URL where relevant, and concise payload. Put constraints in small pill labels (`9600 8N1`, `ch 1`, `multipart JPEG`, `NO ACK`).
- **Status badges:** `ACTIVE` green, `OPTIONAL` amber, `INACTIVE` gray, `CONFLICT` red, `RAM` blue-gray, `PERSISTENT` gold. Pair badge color with text/icon for accessibility.
- **Legends:** same bottom-right 280×120 legend component on every page; page-specific additions below the shared five line/status semantics. Include source note: `Authority: current five-project source; dashed links are not active runtime integrations.`
- **Alignment:** flow left→right; ownership top→bottom; emergency source→effect; 24 px between sibling cards and 48 px between subsystem groups. Edge labels sit on white 4 px padded backgrounds.
- **Writing:** use concrete verbs and current facts (`sends`, `receives`, `ignores`, `persists`); never use ambiguous `communicates with`. Put stale README claims only in callouts marked `DOC DRIFT`.

### Exact first diagram to build

Build **Page 1, `01 — Working-Combo System Context & Active Interfaces`**, first. It establishes the authoritative boundary and prevents every later page from inheriting the two most damaging false assumptions: robot→Hub LOCATION and robot→Mega display control.

### Page 1 source-of-truth node checklist for Draw.io MCP

Use these stable IDs and labels; do not add historical firmware nodes.

1. `boundary_active` — container: `ACTIVE WORKING COMBO · current source authority`.
2. `hub` — primary controller: `Hub ESP32\nEmergency + HTTP + gallery + track outputs`.
3. `robot` — primary controller: `Robot ESP32\nRFID tour + narration orchestrator`.
4. `nano` — controller: `Nano rail actuator\nForward PWM / active hard brake`.
5. `camera` — controller: `ESP32S-CAM\nGC2145 RGB565 → software JPEG`.
6. `browser_hub` — browser group: `Visitor + Admin clients\nHub pages / APIs`.
7. `browser_robot` — browser: `Field service client\nRobot tuning + event log`.
8. `rfid` — peripheral: `RFID cards + MFRC522\nSTART · stations 1–7 · END`.
9. `dfplayer` — peripheral: `DFPlayer + speaker\nMP3 tracks 0001–0008`.
10. `motors` — peripheral: `L298N + two rail motors`.
11. `sensor` — peripheral: `GC2145 sensor\nQVGA 320×240`.
12. `hub_button` — peripheral: `Emergency button\nGPIO21 · press ON / hold 3 s OFF`.
13. `hub_outputs` — peripheral: `7× WS2812 + passive buzzer\nGPIO15 / GPIO4`.
14. `hub_ui_fs` — storage cylinder: `Hub LittleFS\nDeployed web bundle + /upload.tmp`.
15. `hub_gallery` — storage cylinder: `Hub gallery\nSD preferred → LittleFS fallback\n12 newest · I00012S3.JPG + SEQ.TXT`.
16. `cam_ram` — RAM node: `Latest JPEG in PSRAM/heap\nretry via SEND; lost on reset`.
17. `cam_sd` — optional storage: `Camera SD backup\nIMG_####.JPG · after INIT`.
18. `display_boundary` — dashed outer container outside `boundary_active`: `STANDALONE / NOT RUNTIME-INTEGRATED`.
19. `mega` — controller inside standalone container: `Mega 2560 display\n480×320 renderer · USB-testable`.
20. `tft` — peripheral: `MCUFRIEND TFT shield\nBOOT / MENU / FACE / STATION / EMERGENCY`.
21. `note_contract` — note: `Shared ESP-NOW packet: 24 bytes · ch 1 · checksum only · no auth/ACK/replay filter`.
22. `note_truth` — note: `Solid = active from source. Dashed = inactive, ignored, optional, or conflicting as labeled.`

### Page 1 source-of-truth edge checklist for Draw.io MCP

1. `rfid → robot` — local SPI attachment; label `VSPI · SS5 SCK18 MOSI23 MISO19 · UID events`.
2. `robot → dfplayer` — UART request; label `UART2 TX17 · 9600 · play/stop/volume`.
3. `dfplayer → robot` — UART event; label `UART2 RX16 · 9600 · finished/error`.
4. `robot → nano` — active UART; label `GPIO26 → D0 · 9600 8N1 · START/STOP/GET/SET/SAVE`.
5. `nano → robot` — active UART; label `D1 → divider → GPIO25 · READY/STATE/TUNE/ERR`.
6. `nano → motors` — local output; label `D5/D7/D8/D10/D11/D12 · ML/MR PWM or hard brake`.
7. `robot → camera` — active one-way UART; label `GPIO14 → GPIO13 · 9600 · SHOOT station\nNO ACK`.
8. `sensor → camera` — local DVP; label `RGB565 · QVGA · XCLK 10 MHz`.
9. `camera → cam_ram` — local RAM; label `frame2jpg quality 15 · retain latest good JPEG`.
10. `camera → cam_sd` — dotted optional; label `1-bit SD_MMC · only after INIT`.
11. `camera → hub` — active HTTP; label `MuseumHub STA · ch 1 · multipart image/jpeg\nPOST 192.168.4.1/api/image/upload?station=N`.
12. `hub → robot` — thick crimson ESP-NOW; label `EMERGENCY state · ch 1 broadcast\n6-frame transition burst / 2 s periodic · NO ACK/AUTH`.
13. `browser_hub ↔ hub` — active HTTP request/reply; label `MuseumHub · DNS/HTTP :80\nstate/check-in/admin/gallery`.
14. `browser_robot ↔ robot` — active HTTP request/reply; label `ESP32-MP3-RAIL · HTTP :80\nvolume + ML/MR + status/log`.
15. `hub_button → hub` — local GPIO; label `GPIO21 HIGH · 50 ms debounce`.
16. `hub → hub_outputs` — local outputs; label `normal station color / emergency red blink + 600↔1200 Hz siren`.
17. `hub → hub_ui_fs` — local storage; label `static assets + multipart scratch`.
18. `hub → hub_gallery` — local persistent storage; label `validate + commit + recover/prune`.
19. `camera ⇢ hub` — separate gray dash-dot curved edge; label `MSG_IMAGE_READY sent after HTTP 200 · HUB IGNORES`.
20. `robot ⇢ hub` — gray dashed edge with terminal `×` at Hub; label `MSG_LOCATION · NO SENDER IN CURRENT ROBOT`.
21. `robot ⇢ mega` — red dashed edge crossing into standalone container with terminal `×`; label `DOCUMENTED UART NOT IMPLEMENTED\nGPIO16/17 already DFPlayer`.
22. `mega → tft` — local active attachment within standalone container; label `16-bit parallel shield · pins 22–53 + A0–A5`.
23. `USB test console → mega` — optional small external node/edge if space permits; label `9600 text commands · standalone validation only`.

### Page 1 placement and layering checklist

- Layer 1 `Background`: white page, title, subtitle `Code-authoritative view of ESP32_RFID_MP3_RAIL + NANO_LFR_RAIL + cam + hub + display`.
- Layer 2 `Boundaries`: active boundary fills 80–85% of canvas; standalone display boundary sits outside bottom-right without overlap.
- Layer 3 `Primary nodes`: Hub at x≈430,y≈300; Robot at x≈980,y≈300; Camera centered x≈700,y≈520; Nano x≈1080,y≈600; browsers above their controller.
- Layer 4 `Local hardware`: owner peripherals arranged at outer sides, storage below Hub/Camera, minimizing inter-board edge crossings.
- Layer 5 `Active edges`: route HTTP through center-left, UART on center-right, emergency across top between Hub/Robot.
- Layer 6 `Inactive edges`: route along bottom/back; never overlap the emergency edge. Add `INACTIVE`/`IGNORED`/`CONFLICT` badges directly on the dashed lines.
- Layer 7 `Annotations`: packet-contract note top-left inside boundary; authority note and shared legend bottom-left/bottom-right.
- Final QA: exactly five project controller nodes; Mega outside active boundary; no LOCATION arrow shown solid; no display command shown solid; camera upload is HTTP solid; IMAGE_READY is dashed ignored; robot-camera pin says GPIO14, not GPIO27.

## 2026-08-10 — Rail motor-speed field controls

- The requested Motor L/R implementation is currently localized in `ESP32_RFID_MP3_RAIL/ControlPage.h`, `ESP32_RFID_MP3_RAIL/ESP32_RFID_MP3.ino`, and `ESP32_RFID_MP3_RAIL/README.md`; it uses the Nano's existing `SET ML`, `SET MR`, `GET`, and `SAVE` commands rather than changing Nano product code.
- Current Git state also contains concurrent modifications in `ESP32_RFID_MP3_RAIL/platformio.ini`, the three root planning files, and shared/compatibility header moves and copies. Those are not part of the pending synchronization fix and must be preserved without staging, reverting, or rewriting them.
- Remaining known logic defect: a boot-time `GET` can report EEPROM values different from the ESP32's compiled defaults. That unsolicited/initial confirmation must update displayed state without creating a pending request; requested-value comparison is valid only while a web motor command is already pending.
- The synchronization defect is fixed: valid Nano `TUNE` replies always replace the displayed confirmed pair; pending state is cleared only when an existing pending request exactly matches that pair. Unsolicited/startup reports cannot create a pending request.
- Validation exposed nondeterministic generated-artifact interference: one build missed a framework object, then a clean build reported a missing `firmware.elf` even though complete ELF/map/bin artifacts appeared immediately afterward. `platformio.ini` contains no cleanup/build hook and a process inspection found no surviving PlatformIO/SCons job. Continue with serialized (`-j 1`) validation rather than treating these as C++ failures.
- Serialized builds pass for both configured boards: ESP32 uses 50,356 B RAM (15.4%) and 852,789 B application flash (65.1%); Nano uses 282 B RAM (13.8%) and 4,092 B flash (13.3%).
- The embedded console exposes independent Motor L/channel A and Motor R/channel B sliders over 0–255, posts both values to `/api/motors` or `/api/motors/save`, and renders Nano-confirmed/pending/running state from `/api/state`. The companion Nano source contains the matching `SET`, `GET`, and `SAVE` dispatch plus `TUNE ML=n MR=n` reporting and live retuning while driving.
- ESP32 request handling validates both `ml` and `mr` completely before sending any UART command. A valid request stores the desired pair, marks it pending, sends `SET ML`, `SET MR`, then `GET`; the save route appends `SAVE`, so Nano UART ordering persists the final pair. Endpoint responses are HTTP 202 and explicitly represent requested/pending—not confirmed—values.
- Nano processing is newline-delimited and ordered. Each `SET` clamps to 0–255, emits `OK` plus a full `TUNE` pair, and reapplies both PWM channels immediately only when already driving; `SAVE` uses EEPROM `put()` after both `SET` lines. The ESP32's intermediate `TUNE` reply cannot incorrectly clear a pending request unless the complete reported pair already equals the requested pair.
- Final scoped review found the Motor L/R UI, API validation, command ordering, Nano-confirmed state parser, startup synchronization fix, route registration, and README mutually consistent. `NANO_LFR_RAIL/NANO_LFR_RAIL.ino` has no working-tree diff; no Nano change was required.
- The latest working-tree inventory also gained concurrent Hub and compatibility-header edits during validation. They were not inspected as part of this feature, and were neither modified, staged, reverted, nor attributed to the motor-console work.
- Deployment boundary: this newest motor-control revision has not been uploaded to hardware, committed, or pushed. Build/source confidence must not be reported as a physical live-PWM or EEPROM acceptance test.

## 2026-08-10 — Hub firmware flow audit (in progress)

- The Hub is configured as a channel-1 SoftAP at `192.168.4.1` (`MuseumHub` / `museum2026`) and uses that same radio/channel for ESP-NOW. Local outputs are WS2812 on GPIO15, passive-buzzer siren on GPIO4, and a HIGH-when-pressed emergency input on GPIO21.
- Emergency is designed as Hub-owned state: immediate broadcast on transition plus an unconditional state rebroadcast every 2,000 ms. The configured sender node ID is 10.
- Robot movement has a 2,500 ms settle window. A current location/moving report refreshes the timestamp; absent refreshes are expected to make the Hub show a stationary/narrating state after that window.
- Camera storage is configured to try VSPI microSD first (SCK18/MISO19/MOSI23/CS5 at 4 MHz), then fall back to LittleFS, retaining at most 12 photos under `/photos`.
- `MuseumState` is the cross-core RAM model guarded by one FreeRTOS mutex. It contains robot station/motion/timestamp, emergency, up to 8 health rows, up to 24 check-in records, cumulative approvals, and newest-image metadata. The image byte count is only 16-bit, so source inspection must confirm the upload limit is no greater than 65,535 bytes.
- Check-in status is encoded as 0 pending / 1 approved / 2 denied. Request state and counts are RAM-resident and therefore reset on reboot unless later source reveals persistence.
- `PhotoStore` is single-threaded by contract and is used only by the Core-0 web task. At boot it attempts the SD card three times, then falls back to LittleFS; it creates `/photos`, removes any interrupted upload scratch, reconstructs a newest-first RAM index from strict 8.3 names (`I00012S3.JPG`), prunes older valid photos, and reads a persistent `SEQ.TXT` sequence floor.
- Incoming JPEG chunks are deliberately written to the LittleFS scratch `/upload.tmp` even when the final gallery is on SD. At commit, a validated scratch is renamed on LittleFS or copied once to SD, the oldest indexed photo is evicted at the configured limit, metadata is inserted newest-first, and the sequence floor is persisted. This avoids SPI writes inside the HTTP parser callback.
- Clearing the gallery deletes images but deliberately preserves the highest issued sequence. This is required because `/api/image?seq=N` is intended to be immutable-cacheable; reusing a cleared sequence could make browsers display stale pixels.
- Filename comments in `PhotoStore.h` and the Hub README still describe `IMG_<seq>_S<station>.JPG`, but actual source writes strict 8.3 names such as `/photos/I00012S3.JPG`. This is a documentation mismatch, not a runtime-path ambiguity.
- The source enforces a sequence ceiling of 65,000 by wiping the indexed gallery and resetting to sequence 1. That exceptional behavior technically violates the otherwise stated never-reuse/cache invariant after 65,000 accepted captures, although it is declared unreachable in a demo.
- Boot order in actual source is: initialize serial/LED/buzzer/button/random/mutex; mount LittleFS; initialize the photo backend and recover/prune the gallery; remove legacy `/last.*` images; start the fixed-IP SoftAP and wildcard captive DNS; create a 16-message ESP-NOW queue and register an unencrypted broadcast peer; register HTTP routes and the custom multipart handler; start the server; then create a 16 KB web task pinned to Core 0. Arduino `loop()` remains on Core 1.
- ESP-NOW receive callbacks do only fixed-size validation and a non-blocking queue send. Core 1 drains the queue and handles only LOCATION, EMERGENCY, and HEALTH. Other declared protocol types (visitor count, image-ready, command, heartbeat) are ignored. Queue-full drops are silent, packet sequence numbers are ignored, and sender MAC/node authorization is not checked.
- LOCATION maps numeric station `1..7` to the configured string, copies the moving flag, and refreshes `robotMs`; Core 1 clears `robotMoving` 2.5 s after the last moving report. HEALTH upserts by station string into at most 8 RAM rows. EMERGENCY adopts the incoming flag and marks outbound state dirty only on a transition.
- Core 1 loop order is deterministic: drain all queued messages; settle motion; adopt external emergency state into local siren state; debounce/read button; apply press/3 s hold logic; update two-tone siren; send emergency if dirty or 2 s elapsed; render LEDs; sleep about 5 ms. A changed emergency is therefore normally relayed during the same Core-1 pass.
- A short debounced button press latches emergency ON. Holding continuously for 3 s clears it. Dashboard or incoming ESP-NOW changes are mirrored into the local alarm; clearing externally explicitly calls `noTone()`. Emergency LEDs blink all seven red at ~250 ms toggles; normal mode lights only the current station, blue while moving and green otherwise.
- `stateJson()` labels every non-moving state `"narrating"`, including boot with no station/robot packet. It exposes no staleness or online status. Approved count is cumulative and is not occupancy: deny-after-approve does not decrement it, there is no exit handling, and `MSG_VISITOR_COUNT` is ignored.
- Visitor check-ins create short pseudo-random RAM IDs, with a 24-record drop-oldest buffer. Approve/deny return `{ok:true}` even for missing IDs. All API routes are unauthenticated; any client on the AP can approve/deny, toggle emergency, advance the mock robot, clear the gallery, or upload an image.
- Emergency HTTP updates Hub state and schedules an ESP-NOW broadcast; the robot-advance endpoint is only a local simulation and sends no robot command. The Hub's only outbound ESP-NOW packet in this source is the periodic/dirty emergency-state broadcast.
- The upload endpoint intentionally accepts only multipart POST field `image` with exact MIME `image/jpeg`; raw senders get HTTP 415. Chunks stream to LittleFS with a 65,535-byte cap, then completion validates saved byte count plus JPEG SOI/EOI before committing and updating shared image metadata. This validates framing/completeness, not full JPEG decode.
- Static files always come from LittleFS (even if photos use SD), with no-cache headers. Wildcard DNS resolves every hostname to the Hub; recognized OS captive-probe paths redirect to `/`, while arbitrary missing paths return 404.
- The shared protocol packet is packed and checksum-validated with magic/version and a 16-bit additive checksum. This detects ordinary corruption but offers no authentication or replay protection; ESP-NOW broadcast peer encryption is explicitly disabled.
- The deployed browser adapter selects real mode only when the page hostname is exactly `192.168.4.1`; any captive-portal alias/other hostname uses the localStorage mock even though it may be served by the Hub. In normal documented use via the IP, each page subscription creates a 1.5 s `/api/state` poll and silently retains stale cache on errors.
- Browser admin commands are fire-and-forget POSTs, so the page does not inspect HTTP status or server JSON and waits for later polling. Immediate calls to `refresh()` therefore often redraw old cached state first; this is cosmetic, not a duplicate command.
- The gallery client is efficient by design: `/api/state` carries only newest image metadata; `/api/gallery` is fetched initially and whenever newest sequence changes; each `/api/image?seq=N` URL is stable and browser-cacheable. Clear is optimistic in the browser and followed by a delayed gallery refresh.
- The admin source still says health rows are mock values even though real Hub mode renders ESP-NOW HEALTH messages. Unknown/missing robot or health station IDs fall back visually to artifact 1 (`jamdani`), reinforcing the misleading offline-as-valid behavior.
- The UI interpolates request IDs and sensor/content values into `innerHTML`/inline handlers. Current Hub-generated request IDs and configured station strings are constrained, but the pattern is not safe for future untrusted fields.
- Non-destructive build verification passed on PlatformIO Espressif32 6.12.0 with Arduino-ESP32 2.0.17 and Adafruit NeoPixel 1.15.5. Resource use is 47,936/327,680 B RAM (14.6%) and 916,145/1,310,720 B application flash (69.9%). The build and targeted diff checks introduced no tracked change under `firmware/hub/`.
- README claims about core split, 2 s emergency rebroadcast, passive `tone()` buzzer, 12-photo cap, and multipart image endpoint match source. Confirmed documentation drift: README photo examples use `/photos/IMG_00001_S1.JPG`, whereas current implementation uses `/photos/I00001S1.JPG` strict 8.3 names.
- This audit confirms static logic and current-toolchain buildability. It does not newly prove physical SD mounting, ESP-NOW reception/transmission, GPIO button/siren/LED behavior, browser runtime, or multipart camera uploads on connected hardware; those require a live system test and existing historical logs should not be substituted for a current run.

## 2026-08-10 — RFID rail narration stop/resume behavior

- The standalone target for the requested change is `ESP32_RFID_MP3_RAIL/ESP32_RFID_MP3.ino`; it currently starts the Nano immediately for the start card, but station cards do not explicitly stop the Nano before audio and there is no playback-finished/resume state machine.
- Required behavior is: mapped audio RFID -> send Nano `STOP` before playback -> send `START` only after DFPlayer reports the track finished; the end UID `A3 C0 38 15` sends `STOP`, plays no audio, and latches the rail stopped.
- The stop latch must prevent station audio completion, manual playback, or timeout fallback from starting the rail. Only the start UID `18 C4 0F BA` clears the latch and can resume the rail.
- The existing integrated `ESP32_RFID_MP3_LFR` controller already demonstrates the needed DFPlayer finished-event guard (`NARRATION_MIN_MS`) and timeout fallback (`NARRATION_MAX_MS`), but the standalone rail target needs a smaller equivalent implementation.
- The DFPlayer error path must not auto-start after a failed/no-audio playback; when audio is unavailable, the rail remains stopped until the explicit start card is scanned.

## 2026-08-10 — ESP32 RFID rail start/end cards

- The requested target is `ESP32_RFID_MP3_RAIL/ESP32_RFID_MP3.ino`, not the already-integrated `ESP32_RFID_MP3_LFR` target.
- The rail target currently maps only station UIDs to tracks 2–8 and has no Nano UART. Its serial monitor commands control only DFPlayer playback and volume.
- The requested start UID is `18 C4 0F BA` and should map to `0001.mp3`; the requested end/stop UID is `A3 C0 38 15` and should produce no new audio.
- Because this target is paired with `NANO_LFR_RAIL`, the useful interpretation of the start/end cards is to add the existing 9600-baud newline UART contract: start card sends `START`, end card sends `STOP`. Use ESP32 UART1 GPIO25 RX/GPIO26 TX, matching the other RFID/LFR controller and its documented Nano wiring.
- The end card must be distinguishable from an unknown UID even though it has no track. A mapped action/entry-index result is safer than using track `0` as both “no audio” and “unknown.”
- Implementation/build result: `ESP32_RFID_MP3_RAIL/ESP32_RFID_MP3.ino` now uses mapped track `1` for START and track `0` for the STOP/no-audio action, sends newline-terminated Nano commands over UART1 GPIO25/26, and builds successfully for `esp32dev` at 21,864 B RAM / 282,981 B application flash.
- Hardware upload and physical RFID/Nano verification were not performed for this request.
- Follow-up hardware flash succeeded after the user connected the Nano: `/dev/ttyUSB0` was the CH340 at USB path `3-2`; `nanoatmega328new` upload wrote and verified 4,092 bytes, and boot capture returned `READY:STOPPED`.
- ESP32 follow-up flash succeeded to `/dev/ttyUSB1` after the second CH340 appeared at USB path `3-1`; esptool identified ESP32-D0WD-V3 rev 3.1 / MAC `1c:c3:ab:3c:8c:38`, wrote 283,344 application bytes, and verified all flash hashes. Passive post-reset capture was empty because it started too late; interactive PlatformIO monitor cannot run in the non-TTY tool terminal, so an explicit reset plus pyserial capture remains the runtime verification method.
- Explicit reset plus pyserial capture verified the ESP32 runtime markers, RFID initialization, Nano UART initialization, and boot-time `STOP` transmission. The same capture reported `DFPlayer ERROR! Check wiring / SD card.` and audio disabled, so the firmware path is verified but DFPlayer/SD hardware is not.

## 2026-08-10 — Nano rail controller ↔ ESP32 RFID/MP3 integration

- User locked a Nano-only adaptation: `ESP32_RFID_MP3_LFR/` must not be modified. Compatibility must therefore be achieved entirely by implementing the companion's existing UART contract on the Nano.
- `NANO_LFR/NANO_LFR.ino` is not a simple motor sketch. It is a five-sensor, active-low line follower with rule-based straight/curve/sharp/search/junction steering, UART START/STOP control, sensor/motor telemetry, live `SET` tuning, EEPROM persistence, a minimum-drive ramp, and a manual rail-test mode.
- The companion `ESP32_RFID_MP3_LFR` depends only on a small subset of that Nano behavior for the tour: newline-delimited `START` and `STOP` at 9600 baud, plus `READY:STOPPED`, `STATE:RUNNING`, and `STATE:STOPPED` replies. It sends STOP before station narration, START after narration, START for the silent tour-start card/emergency evacuation, and STOP at the evacuation exit.
- The calibrated `NANO_RAIL` behavior is physically different from line following: fixed forward PWM left=150/right=210 and active braking. Its current `F`/`S` protocol and human-oriented status output are not directly compatible with the ESP32's deterministic `START`/`STOP` protocol and state parser.
- Existing `NANO_LFR` logical motor mapping is crossed: `wheelRaw(lm, rm)` sends `lm` through IN3/IN4 + ENB and `rm` through IN1/IN2 + ENA. The calibrated `NANO_RAIL` sketch names ENA/IN1/IN2 as left and ENB/IN3/IN4 as right. Copying 150/210 without reconciling this mapping can silently swap the tuned wheel PWMs.
- Existing `NANO_LFR` zero command sets both direction inputs HIGH but then writes enable PWM 0. That disables the bridge and does not provide the active HIGH/HIGH, enable-ON braking that physically stopped the rail robot. A dedicated brake path must write both direction inputs HIGH and ENA/ENB=255.
- If the final robot is rail-guided rather than line-guided, retaining the sensor steering, `MIN/BASE/CO/CI/SO/SI/...` tuning table, EEPROM image, RAMP, and junction/search logic adds failure modes without adding useful behavior. The clean design is a small rail state machine that starts braked, drives only forward at 150/210 on START, and hard-brakes on STOP.
- For robust Nano memory use, the final UART parser should reuse the existing fixed-size, newline-delimited character buffer rather than `String::readStringUntil()`. Commands should be case-insensitive but deterministic; unknown input must report an error and must never toggle motion.
- The ESP32 currently sets `lfrRunning` optimistically as soon as it transmits START/STOP, then corrects it from Nano replies. Basic compatibility requires no ESP32 change if the Nano preserves the expected replies. Stronger integration would add command acknowledgement timeout/retry and avoid beginning narration/photo work until STOP is confirmed or a bounded fail-safe expires.
- `NANO_LFR/platformio.ini` still exposes both old- and new-bootloader environments. The attached Nano has already been proven as `nanoatmega328new`; the adapted target should retain only the new-bootloader environment to remove ambiguity.

## 2026-08-08 — Active Nano LFR correction

- User reports the current robot mostly drives straight and does not slow/steer adequately when the line bends left or right. Requested master speed is 38%.
- Required Nano diagnostic is one serial line containing all five normalized logical sensor values (`s1` through `s5`) so the physical pattern can be observed while testing.
- The Nano hardware UART is simultaneously the ESP32 command link at 9600 baud, so printing on every unrestricted control-loop iteration would saturate the link and can delay `START`/`STOP`. The implementation must rate-limit complete sensor lines while still printing continuously enough for diagnosis.
- Current repository status contains substantial pre-existing modifications, including both `NANO_LFR/NANO_LFR.ino` and `ESP32_RFID_MP3_LFR/ESP32_RFID_MP3_LFR.ino`. Those edits must be inspected and preserved rather than replaced wholesale.
- Audio suppression belongs on the active ESP32 RFID/DFPlayer mapping path, not in the Nano line sensor algorithm. The exact configured start UID and active companion target still need source inspection.
- Active Nano source is `NANO_LFR/NANO_LFR.ino`; it currently uses `SPEED_PERCENT=40`, active-low normalized sensors on A0–A4, and a 9600-baud D0/D1 ESP32 link.
- Root cause of weak steering is visible in source: speed and both PD gains are scaled together. At 40%, `kp=kd=0.40`; a steady far-edge error of ±20 therefore changes each wheel by only about 8 PWM counts. Both wheels remain forward and close in speed, so the chassis mostly continues straight.
- Current bend logic is inverted from the requested behavior: straight base is PWM 60, while a non-straight path uses the higher PWM 64 base. It therefore speeds up slightly on bends rather than slowing.
- The current all-five pattern (`11111`) always performs a blocking 500 ms right pivot. It cannot select a left versus right branch from an ambiguous all-five reading and it blocks serial stop processing for half a second. Revised steering should avoid long blocking decisions and use the measured error/edge pattern for ordinary bends.
- Active merged ESP32 source maps start UID `18 C4 0F BA` to track 1 and currently calls `playTrack(1)`, then waits for narration completion before sending Nano `START`. The requested behavior should special-case that mapped start entry: skip DFPlayer playback and start the Nano immediately, while leaving tracks 2–8 unchanged.
- Nano telemetry currently has no sensor output. The ESP32 forwards complete Nano lines to USB, but its inbound `nanoBuf[32]` is too small for a readable `S1=... S5=...` line plus steering state; it must be enlarged if detailed telemetry is emitted.
- Implemented telemetry format is `S1=<0|1> S2=<0|1> S3=<0|1> S4=<0|1> S5=<0|1> E=<value|LOST> M=<mode> L=<signed PWM> R=<signed PWM>`. It is emitted every 125 ms (~8 Hz), not every unbounded loop pass, because the UART is only 9600 baud and also carries safety-critical START/STOP commands.
- Implemented 38% commands: straight 57/57; ordinary left 24/57; ordinary right 57/24; sharp left 5/62; sharp right 62/5; lost-line search ±41; all-five junction pivot ±38. Values remain within the existing signed `wheel()`/PWM model.
- Sensor direction history now updates only when exactly one outer edge is active. This prevents `11111` from always overwriting history as left merely because S1 was checked before S5.
- All-five junction steering is now non-blocking and follows the last unambiguous edge (default right when no history), replacing the unconditional blocking 500 ms right pivot. This keeps UART STOP processing responsive.
- Both affected targets compile: Nano `nano_new` uses 330/2048 B RAM (16.1%) and 4302/30720 B flash (14.0%); merged ESP32 uses 46,328/327,680 B RAM (14.1%) and 815,625/1,310,720 B app flash (62.2%).
- Fresh hardware inventory found no `/dev/ttyUSB*` or `/dev/ttyACM*`, no `/dev/serial/by-id` entries, and no USB serial-class adapter in `lsusb`. Previous `/dev/ttyUSB0` identities are stale and cannot safely be reused for flashing.
- After the ESP32 was plugged in, `/dev/ttyUSB0` reappeared as an unowned CH340; a read-only `esptool chip_id` positively identified ESP32-D0WD-V3 rev v3.1, MAC `1c:c3:ab:3c:8c:38` before any write.
- After the Nano was plugged in, a second CH340 appeared at `/dev/ttyUSB1` (USB path `04:00.4:2`, distinct from the ESP32 at `04:00.4:1`); avrdude read signature `0x1e950f` (ATmega328P). Both CH340s share VID:PID `1a86:7523`, so they were distinguished by USB path and the esptool/avrdude probe, not by name alone.
- ESP32 flash and runtime verified: all region hashes verified; boot log showed `RFID-MP3-LFR-v3-silent-start`, `-> Nano: STOP`, and `<- Nano: STATE:STOPPED`.
- Nano flash and runtime verified: 4302 bytes written and verified; boot/telemetry showed `READY:STOPPED` then `S1=0 S2=1 S3=1 S4=0 S5=0 E=-5 M=STOP L=0 R=0`, repeated at ~8 Hz (rate-limited by `SENSOR_REPORT_MS=125`). Live sensors (S2/S3 active) confirm polarity is correct and telemetry is flowing.

## 2026-08-08 — ESP32 MP3/LFR Browser-Control Diagnosis

- The physical sequence LFR ON → LFR OFF → track 1 was generated by the laptop's direct HTTP `curl` requests, not by clicking the rendered page. It proves the HTTP handlers and hardware command paths, but not the page's JavaScript.
- The user reproduced the no-op buttons from both a phone and a laptop while viewing `http://192.168.4.1`. This disproves the prior phone/mobile-data-only explanation.
- Current isolation: `GET /lfr?state=on`, `GET /lfr?state=off`, and `GET /play?track=1` work when requested directly; the rendered page's JavaScript-only `onclick` → `fetch()` path is the unverified/failing layer.
- Acceptance now requires a real browser click test, not URL-level HTTP checks. The corrective UI should function without JavaScript so browser policy, script errors, or stale script caching cannot disable controls.
- The first Firefox/WebDriver reproduction was inconclusive: the expected ESP32 device node `/dev/ttyUSB1` no longer existed when serial capture opened, and WebDriver navigation to the AP timed out. No button was clicked and this is not evidence for or against the page. USB identities and AP association must be freshly established before the next run.
- Browser-safe corrective design is now implemented: every control is a real HTML GET form and therefore does not require JavaScript; successful actions use HTTP 303 back to `/` and render the action status; root/action responses disable caching; the page and serial banner expose `WEB-FORMS-v2`; AP mode is explicit and Wi-Fi power saving is disabled. The replacement build passes at 45,304 B RAM and 782,097 B flash.
- The corrected image is physically installed on the same ESP32 identity (MAC `1c:c3:ab:3c:8c:38`), with 788,672 application bytes written and hash verified. Runtime identity and service startup are proven by `WEB-FORMS-v2` in the boot banner.
- Post-flash network gate succeeded from the laptop: `ESP32-MP3` association, DHCP `192.168.4.2/24`, route via `192.168.4.1`, HTTP 200 root response, 2,886-byte body, no-cache headers, and the new page marker all passed. This removes the prior transient AP-association failure before browser automation.

## 2026-08-06 — Nano LFR/RFID Split Findings

- During implementation, an untracked [`RobotLinkProtocol.h`](firmware/common/RobotLinkProtocol.h) appeared at 21:38:33 with a competing `$TAG...*HH` run/stop protocol, one minute before the newly added [`RobotUartProtocol.h`](firmware/common/RobotUartProtocol.h). Neither file is tracked in Git and the former was absent from the initial workspace inventory. Reconcile the two designs before either controller includes one; do not ship duplicate wire protocols.
- The Arduino Nano cannot retain the supplied D10/D11/D12 motor allocation while using an RC522 over hardware SPI: ATmega328P SPI is fixed to D11 MOSI, D12 MISO, D13 SCK, and D10 should remain the RC522 SS/hardware-SS output. Motor control therefore needs a deliberate remap rather than a textual ESP32-to-Nano port.
- A conflict-free full Nano allocation is available: IR A0–A4; RC522 D10/D11/D12/D13 plus RST D4; SoftwareSerial D2 RX/D3 TX; L298N left D5 PWM + D7/D8 and right D6 PWM + D9/A5. D0/D1 remain available for USB hardware-serial diagnostics.
- RC522 modules are 3.3 V devices. Supplying 3.3 V is not enough protection when a 5 V Nano drives SS, MOSI, SCK, and RST; those four outputs need a proper 3.3 V logic buffer/level shifter. RC522 MISO at 3.3 V is high enough for a 5 V ATmega328P input in this application.
- The Nano UART output is also 5 V. Use Nano D3 -> 1 kΩ -> ESP RX node, with 2 kΩ from that node to GND, yielding approximately 3.3 V at ESP GPIO25. ESP GPIO26 -> 1 kΩ -> Nano D2 is safe for optional ACKs. Common ground is mandatory.
- ESP GPIO25/26 are selected for the Nano link because direct ESP motor ownership is ending and this preserves GPIO16/17 for the already-planned DFPlayer UART.
- RC522 UID/SAK/type can identify a presented card for station routing, but UID alone is cloneable and must not be described as cryptographic authentication.

## 2026-08-06 — ESP32 Line-Follower Port Findings

- New split architecture requested: Arduino Nano ATmega328P becomes the real-time motion/RFID controller; ESP32 becomes the application-side receiver for framed RFID credentials and later museum functions.
- RC522 requires the Nano hardware SPI pins D10 SS, D11 MOSI, D12 MISO, and D13 SCK. The original Arduino sketch already consumes D10 as ENA, D11 as IN3, and D12 as IN4, so those motor signals must move. The IR array on A0–A4 can remain unchanged.
- PlatformIO board IDs available locally are `nanoatmega328` (classic bootloader) and `nanoatmega328new` (new bootloader); MFRC522 package search resolves `miguelbalboa/MFRC522` version 1.4.12.
- A Nano-to-ESP UART needs voltage protection in the Nano TX → ESP32 RX direction because ESP32 GPIOs are not 5 V tolerant. Common ground is required. Keeping USB hardware serial free for diagnostics favors Nano `SoftwareSerial` and an ESP32 hardware UART.
- Pin-complete split is feasible without another module: Nano uses A0–A4 IR, A5 RC522 reset, D10–D13 hardware SPI, D4/D5/D9 for L298N channel A (physical left), D7/D8/D6 for channel B (physical right), and D2 RX/D3 TX for the ESP link. ESP uses UART1 GPIO21 RX/GPIO22 TX for Nano and UART2 GPIO16 RX/GPIO17 TX for the existing DFPlayer.
- Required rewiring is substantial: IR and all six L298N control signals move from ESP32 to Nano; RC522 connects to Nano with 5 V-to-3.3 V protection on Nano-driven SS/MOSI/SCK/RST; Nano D3 TX needs a divider before ESP GPIO21. DFPlayer stays on ESP GPIO16/17 exactly as most recently planned.
- The ESP cannot infer station identity from an unknown UID. The receiver will send/log every UID and support an explicit UID→station map; mapped tags play station tracks while unknown tags still produce a safe stop and visible diagnostic rather than being silently assigned nondeterministically.

- The correct implementation target already exists at `firmware/robot/`; it is a valid PlatformIO `esp32dev` project but its source is still a 21-line skeleton and its README still contains a blank planned-wiring table.
- The confirmed 30-pin ESP32-WROOM-32 allocation has a clean Phase-1 subset: IR far-left→far-right = GPIO36/39/34/35/32; L298N channel A = GPIO25 ENA, GPIO26 IN1, GPIO27 IN2; channel B = GPIO13 ENB, GPIO14 IN3, GPIO33 IN4. None of these Phase-1 signals uses USB UART or ESP32 flash pins.
- The user's working Arduino `wheel(lm, rm)` controls the **left** motor through L298N channel B (`inC`, `inD`, `enb`) and the **right** motor through channel A (`inA`, `inB`, `ena`). The existing robot plan used the opposite channel labels even though its GPIO numbers were usable. Preserve the proven physical convention by relabeling A=right and B=left in both wiring and firmware.
- The original sensor algorithm reads five digital channels and then inverts each bit, so its default electrical interpretation is active-low: sensor output LOW means line detected. This should be a named compile-time setting because actual polarity must be verified over black and white before wheels-down testing.
- GPIO34/35/36/39 are input-only and have no internal pull resistors. This is valid for actively driven comparator outputs; open-collector outputs require external 10 kΩ pull-ups to 3.3 V. Powering the sensor array from 5 V is not acceptable unless every output is independently level-shifted.
- The weighted error must retain the original positive-weight arithmetic `(10,20,30,40,50)/sum - 30`, rather than changing to direct signed-weight averaging, because C++ integer truncation differs for some asymmetric multi-sensor patterns.
- The ESP32 port needs explicit PWM setup rather than AVR timer assumptions. An 8-bit, 20 kHz LEDC output preserves the original 0–254 command range while moving motor PWM above normal audible range.
- Safe electrical bring-up requires external regulated motor and logic rails, common ground, ENA/ENB jumper removal, motor suppression capacitors, and wheels raised for the first direction test. Positive left/right commands must both move the chassis forward; if one does not, swap that motor's two L298N output leads rather than changing the sensor order.
- The implementation uses 20 kHz, 8-bit ESP32 LEDC PWM and clamps signed commands to ±254, matching the working sketch's practical range. Zero command preserves its HIGH/HIGH active-brake direction state with PWM duty zero.
- A compile-time motor gate allows first sensor-polarity diagnostics with all PWM output forced off. Normal autonomous operation remains the default after a 1.5 s startup stop; if no line has ever been observed, the ESP32 port safely stops instead of retaining an undefined/previous motor command.
- Build verification passed on Espressif32 platform 6.5.0, which this environment resolved to Arduino-ESP32 2.0.14 (not the 2.0.17 stated in an older audio-project comment). Firmware usage: 21,480 B RAM (6.6%) and 270,233 B application flash (20.6%). cppcheck passed with no high/medium findings; its low-only `setup`/`loop` reports are expected because it does not model Arduino framework entry points.
- Physical-calibration connection: the newly plugged robot presents one CH340 (`1a86:7523`) at `/dev/ttyUSB0`, stable by-id `usb-1a86_USB_Serial-if00-port0`, USB path `3-2`. It connected at 17:11:52–17:11:53 Asia/Dhaka and no serial-monitor process owns it. This is the only currently enumerated serial adapter, so it is the positively identified target for the sensor-only flash.
- Physical sensor result: the array requires no firmware polarity change. On the real light background all outputs settle inactive (`00000`); black is detected as active `1`. Isolated physical detector tests exactly match GPIO order 36/39/34/35/32 from far-left through far-right, and all-black is stable `11111`. External 10 kΩ pull-ups and current mounting height therefore provide valid digital levels under stationary test conditions.
- Physical motor isolation disproved a global motor-power fault: both channels drive a wheel at higher PWM. Actual chassis mapping is channel A (ENA25/IN1=26/IN2=27/OUT1-2) → physical left wheel, and channel B (ENB13/IN3=14/OUT3-4) → physical right wheel. IN4 used GPIO16 during these tests but was later reassigned to GPIO33 at the user's request. Both positive commands rotate forward. PWM 80 produced no visible motion, channel B/right moved slowly at 160, and channel A/left moved at 220; exact per-wheel minimums still require calibration after reflashing the corrected semantic map.
- Final wheels-up motor calibration after the semantic-map reflash: left start threshold lies in `(160,180]`; right start threshold lies in `(180,190]`. Both reverse correctly at magnitude 200. Approximate open-loop speed trim is left=200, right=220 (right needs about 10% more command). A right pivot is left=+200/right=-220. These no-load observations are starting values; on-floor traction may require higher minimum commands.
- The first floor-calibration image keeps autonomous-at-boot false and now accepts only `AUTO <milliseconds>` in the range 1–5000. It records the start time, stops, and disarms automatically at timeout. This removes dependence on a host `STOP` command if the robot leaves the line or the serial link is interrupted.
- The latest guarded image with 200/220 drive baseline and 250 ms provisional pivot builds successfully on the pinned toolchain: RAM 21,552 B (6.6%), application flash 273,109 B (20.8%). cppcheck has zero high/medium findings and only the same three expected low Arduino-entry-point/compile-time-folding reports; targeted whitespace validation passes.
- User-requested post-calibration pin swap: GPIO33 now drives L298N IN4, freeing GPIO16 for future DFPlayer TX -> UART2 RX; GPIO17 remains UART2 TX -> 1 kΩ -> DFPlayer RX. This changes only the ESP32 signal pins, not the L298N output-pair/physical-wheel mapping. Prior motor evidence used IN4 on GPIO16, so right-wheel forward/reverse must be rechecked wheels-up after rewiring and flashing the new map.
- The GPIO33-IN4 image passes PlatformIO build, cppcheck, and whitespace validation with unchanged size (21,552 B RAM / 273,109 B application). It was not uploaded because the physical move from GPIO16 to GPIO33 has not yet been confirmed; the currently installed guarded firmware therefore remains the prior GPIO16-IN4 image.
- After the user confirmed the physical IN4 move, the GPIO33 image was flashed through the freshly revalidated, unowned CH340 by-id path. Esptool again identified the same ESP32-D0WD-V3 rev 3.1 and MAC `1c:c3:ab:3c:8c:38`; every region hash verified. Live boot output uniquely confirms `IN4=33`, startup autonomous output disabled, and calibration mode with motors disabled. GPIO16 remains physically disconnected pending future DFPlayer integration.
- **Direction preserved after swap.** A guarded `MOTOR 0 200 700` right-wheel test through GPIO33→IN4 drove the physical right wheel forward, matching the pre-swap measurement. The full motor calibration (left starts by 180, right starts by 190, matched pair left=200/right=220, pivot left=+200/right=-220) remains valid under the new pin map without any firmware direction inversion.

## 2026-08-05 — Current Track + Robot Wiring Scope

- The track has seven straight WS2812B boards with eight addressable pixels each. They will be wired as one 56-pixel DIN/DOUT chain; only the first board consumes an ESP32 data GPIO. All LED power taps remain parallel rather than flowing board-to-board through small traces/connectors.
- The final track target is four real DHT11 plus four real MQ-135 digital channels, distributed at stations 1, 3, 5, and 7. The existing Hub microSD allocation is retained; stations 2, 4, and 6 use explicitly identified generated values derived from neighboring valid measurements.
- The corrected track supply design must account for 56 WS2812B pixels, four MQ heater modules, four SG90 servos, ESP32/Wi-Fi/microSD, buzzer, and logic. A regulated 5 V / 10 A class supply remains the conservative single-supply baseline, with separately fused/distributed branches and local bulk capacitance.
- The user expanded planning scope after track finalization. The robot has three logical controllers: a separately powered Arduino + display shield, a separately powered ESP32-CAM, and a main ESP32 for DFPlayer/audio, five IR channels, L298N, RC522 SPI, and one or two eight-pixel WS2812B boards.
- A provisional main-ESP32 allocation is feasible without using USB UART or boot-strapping pins: four input-only pins plus one regular input for the IR array; VSPI plus two control pins for RC522; six outputs for L298N direction and dual PWM; UART2 for DFPlayer; and one WS2812B output. It must not be finalized until the exact IR array output voltage/type, ESP32 board, battery/motor ratings, amplifier topology, speaker load, and display communication requirement are known.
- Critical unresolved electrical questions for the robot are not cosmetic: battery and motor ratings determine buck and motor-rail design; IR output voltage determines whether direct ESP32 input is safe; and amplifier model determines whether it should receive DFPlayer DAC-level audio or a speaker-level signal.
- TI's current SN74HCT165 product page confirms that an eight-bit parallel-in/serial-out register could concentrate multiple 5 V digital MQ outputs, but the final four-real-pair architecture has enough direct GPIOs while retaining SD. The shift-register alternative is therefore not required and is not part of the locked BOM.
- Robot details confirmed by the user: the main controller is another 30-pin ESP32-WROOM-32 DevKit; the five-channel line array exposes five digital outputs and is operated at 3.3 V; drivetrain uses two motors through an L298N; source battery is a 3S LiPo; audio is DFPlayer Mini feeding an LM386 amplifier module; lighting is one eight-pixel WS2812B board; the Arduino Mega + TFT remains a separately powered fixed-screen assembly and needs no ESP32 UART/data link. ESP32-CAM likewise remains functionally unchanged and only needs an appropriate power branch.
- Still required before assigning final robot power hardware: the two motors' rated voltage and stall current, speaker impedance/wattage/count, 3S battery capacity/C rating, and exact LM386 module terminals. A pin map can be finalized independently, but a specific buck current rating or safe amplifier interconnect cannot honestly be locked without those values.
- User then confirmed two 6 V TT gearmotors and one 4-ohm, 3 W speaker, and requested that the architecture begin at the buck-converter outputs rather than sizing the 3S battery itself. The motor branch can therefore be specified as a regulated 6 V high-current buck into the L298N motor-supply input, accepting the L298N's significant voltage loss and reduced motor voltage/torque. A genuine 5 A class converter is a conservative starting point, but the final fuse and acceptance test still depend on measured two-motor stall current.
- The robot logic/audio branch can be specified as regulated 5 V. A 4-ohm/3 W speaker rating does not mean an LM386 can produce 3 W; a typical LM386 operated from 5 V will under-drive that speaker. This is electrically safe but may be too quiet. The audio plan must use a ground-referenced DFPlayer DAC_L or DAC_R line output into the LM386 input, never the DFPlayer's bridged SPK1/SPK2 output into a ground-referenced amplifier input.
- Final Hub trade-off selected by the user: retain the existing microSD interface unchanged on GPIO18 SCK, GPIO19 MISO, GPIO23 MOSI, and GPIO5 CS; install four real DHT11 and four real MQ-135 modules; generate clearly marked simulated values for the other three station rows. A distributed real-sensor layout at stations 1, 3, 5, and 7 permits bounded interpolation for simulated stations 2, 4, and 6.
- The pictured HW-209 automatic bidirectional level converter is a discrete BSS138/passive-pull-up design, not a push-pull AHCT/HCT buffer. It is appropriate for open-drain buses and may pass a very short WS2812B bench test, but its resistor-produced HIGH transition is not the reliability choice for an 800 kHz signal over a long track cable.
- The locally available pictured 74HCT125 DIP-14 is accepted and locked for both WS2812B interfaces. When powered at 5 V, its TTL-compatible input threshold accepts an ESP32 3.3 V HIGH and its push-pull output supplies a strong 5 V waveform. Use one enabled channel plus a 330–470 ohm series resistor; place a 100 nF decoupling capacitor at the IC; tie unused buffer inputs to a defined level and disable their active-low output-enable pins HIGH.

## 2026-08-10 — Hub 74HCT125 / WS2812B Wiring Recheck

- Rechecked the active Hub configuration and implementation: NeoPixel data is GPIO15, and the current firmware allocates only `STATION_COUNT = 7` pixels. This differs from the later hardware plan for seven eight-pixel boards (56 pixels), so the physical DIN/DOUT chain is valid but the current image will address only pixel indexes 0–6 until the allocation/rendering logic is expanded to 56.
- The project’s exact standard DIP-14 channel-1 wiring is electrically consistent with the official Nexperia/TI descriptions of the 74HCT125 as four non-inverting buffers with active-low output enables and TTL-compatible inputs. At 5 V, ESP32 3.3 V GPIO15 goes to pin 2 (`1A`), enabled pin 1 (`/1OE`) goes to GND, and pin 3 (`1Y`) drives only the first WS2812B board’s DIN through 330–470 ohms.
- The LED data path is directional: buffer pin 3 -> board 1 DIN; each board DOUT -> the following board DIN; the final board DOUT intentionally remains unconnected. LED 5 V and GND are distributed in parallel, and ESP32, 74HCT125, LED supply, and every LED board must share ground.
- Standard DIP-14 support wiring remains: pin 14 to regulated 5 V, pin 7 to common GND, and 100 nF ceramic directly across pins 14/7. Unused channels are disabled by tying `/OE` pins 4/10/13 HIGH to 5 V, their inputs 5/9/12 LOW to GND, and leaving outputs 6/8/11 unconnected.
- Official-source lookup used Nexperia’s 74HC/HCT125 datasheet and TI’s SNx4HCT125 datasheet search result. Nexperia states that HIGH on `nOE` puts the corresponding output in high impedance; TI identifies TTL-compatible inputs and the non-inverting `Y = A` function. The HCT suffix matters; a plain HC125 at 5 V is not the same guaranteed 3.3 V-to-5 V interface.

## 2026-08-05 — pskill9 Web Search MCP Diagnosis (FIXED)

- A known-good query returned an empty JSON array from the pskill9 server, while an independent DuckDuckGo MCP returned five normal results for the identical query. MCP tool discovery, invocation, argument validation, and response transport were therefore working; the defect was provider/parser-specific.
- The installed server (`/home/user/.pskill9-web-search/build/index.js`, launched via the Zoo Code `mcp_settings.json` entry `pskill9-web-search`) was a minimal Google HTML scraper. It sent a direct request with an old Chrome 91 user agent, then accepted only result containers matching one hard-coded Google layout (`div.g` + `h3` + `.VwiC3b`) and silently returned an empty array when none matched.
- A direct request to the same Google search endpoint from this environment returned a ~91 KB localized consent/interstitial-style page with no `div.g` result containers. It behaved like a successful HTTP 200, so Axios did not throw; the hard-coded selector found zero result cards and the server serialized that condition as an apparently successful empty array.
- Root cause: Google scraping is being served a layout the stale parser does not recognize, and the server had no interstitial/bot-block/layout-change detection, so the upstream failure was misreported as zero search results.
- REMEDIATION APPLIED: patched the installed `build/index.js` (v0.1.0 -> v0.2.0). The patch adds a modern Chrome UA with `Accept-*` headers and `hl=en`/`num`, broader Google result selectors, explicit blocked-page detection, a DuckDuckGo HTML (`html.duckduckgo.com/html/`) fallback with `uddg` URL decoding and per-URL dedup, a descriptive thrown error when both providers return zero, and stderr diagnostics. The original artifact was backed up to `build/index.js.bak-20260805-134628`.
- VALIDATION: drove the patched server over MCP stdio with a JSON-RPC `initialize` -> `notifications/initialized` -> `tools/call(search)` sequence. "OpenAI official website" -> 5 unique results; "ESP32 camera frame2jpeg" -> 3 unique results. `node --check` passes. The earlier-suspected possibilities (MCP transport failure, wrong tool args, Axios exception) were all ruled out by evidence.
- Caveat: unauthenticated Google/DuckDuckGo HTML scraping is inherently fragile (layout/bot-detection changes can re-break it). If reliability matters, migrate to a maintained search API/provider. The DuckDuckGo MCP remains available as a second independent provider.

## Repository State

### 2026-08-04 direct-RAM camera integration

- Repeated-upload evidence supersedes the earlier preference for raw `image/jpeg`: although `HTTPRaw` avoids NUL truncation and once committed a complete 1,981-byte JPEG, successive requests triggered the Hub web-task watchdog. Camera HTTP outcomes degraded from 200 to `HTTPC_ERROR_READ_TIMEOUT` (`-11`) and then connection refused (`-1`). On this physical Hub and Arduino-ESP32 core, raw callback stability—not JPEG encoding or Wi-Fi signal—is the remaining transport defect.
- Selected replacement: standard `multipart/form-data` with JPEG field `image`, camera-side contiguous multipart body, and Hub-side `HTTPUpload` chunks. This still preserves exact binary JPEG bytes and avoids Arduino `String`; the small multipart framing overhead is immaterial for ~1.9 KB QVGA images.
- Current endpoint mismatch: the Hub multipart build is physically installed, while the camera still runs the old raw sender. The camera flash never started because broad `pkill -f serial-monitor` matched and killed its own shell. Future port cleanup must use `fuser /dev/ttyUSB0` and terminate only a positively identified exact PID.
- Current Hub multipart source would reject every valid upload: `UPLOAD_FILE_START` leaves `imageUpload.error` non-null (`"incomplete_body"`), and the completion condition treats any non-null value as failure. Initialize the fresh transaction with no error, set errors only on actual failures, guard cumulative length before writing each chunk, and reflash Hub before testing.
- Framework-source confirmation for multipart semantics: this core calls `UPLOAD_FILE_START` once, switches status to `UPLOAD_FILE_WRITE`, invokes the write callback for each full buffer and once more for the final partial buffer, increments `HTTPUpload.totalSize` after each callback, then calls `UPLOAD_FILE_END`. Therefore the application must increment its own `received` count only in `UPLOAD_FILE_WRITE`; adding `currentSize` again in `UPLOAD_FILE_END` would double-count the final chunk.
- The installed FS API is `FS::open(path, mode, create=false)`. A new `/last.tmp` must be opened with the explicit third argument `true`; relying on `FILE_WRITE` alone previously failed physically on this core.
- Corrected Hub multipart runtime is physically installed and identified by its unique boot text `Image receiver: multipart/form-data field 'image'.`. The normal camera upload also released `/dev/ttyUSB0` and produced a new 973,104-byte firmware image without any IO0/reset ritual or broad process kill.
- Host serial caution: opening the Hub CP2102 from a pyserial probe while DTR/RTS transitions occur can repeatedly reset the ESP32, producing many boot banners and unrelated captive-route `not found` lines. This evidence must not be mistaken for a firmware watchdog. Avoid simultaneous ad-hoc port opens during final transfer testing; use deasserted control lines from open or a stable monitor.
- First synchronized `SHOOT 1` attempt proved the camera was still running the old raw sender: its runtime string was `[hub] POST RAM JPEG`, not the new `[hub] POST multipart JPEG`. The preceding camera upload must not be counted as successful merely because the port was later released; capture and retain the full uploader result and verify the unique boot/runtime marker.
- That old raw request exposed a framework/API trap in the Hub route registration. This core's four-argument `server.on(..., completeFn, uploadFn)` installs the same second callback as both `RequestHandler::upload()` and `RequestHandler::raw()`. For a non-multipart POST, `canRaw()` returns true and invokes `handleImageUploadForm()`, but `server.upload()` dereferences a null `_currentUpload`; decoded panic: `LoadProhibited` at `WebServer::upload()` → `handleImageUploadForm()` → `FunctionRequestHandler::raw()` → `_parseRequest()`. A robust multipart endpoint must use a custom `RequestHandler` whose `canUpload()` is true and `canRaw()` is false, and whose `upload()` override receives the valid `HTTPUpload&` directly. It should reject old/raw senders cleanly instead of crashing.
- The custom request handler is now implemented and the 853,584-byte Hub image is physically installed with hash verification. Its raw fallback returns HTTP 415 instead of touching `server.upload()`.
- A fully captured camera upload attempt failed to connect to the bootloader before any flash write. This is the known CAM-MB entry-state issue, not a compile or image defect. The camera must be normally unplugged/replugged before one upload retry; no IO0/reset ritual should be introduced unless the user's standard workflow itself fails after replug.
- Laptop network is out of scope for further changes: keep `Lovly` connected and both `MuseumHub` profiles at `autoconnect=no`. Physical evidence comes from USB serial; the user can verify the dashboard from a phone joined to the Hub AP.

- User boot output proves the ESP-CAM application, GC2145 camera, PSRAM, Hub SoftAP association, and ESP-NOW setup all work. The camera joined `MuseumHub` as `192.168.4.3` at RSSI −44 dBm on channel 1.
- Onboard SD_MMC failed initialization with ESP-IDF error `0x107`. This is no longer a blocker: capture now converts RGB565 to JPEG and keeps the latest JPEG in RAM/PSRAM for direct HTTP upload. A mounted SD card only adds an optional backup.
- The revised no-SD image compiles successfully. The first upload attempt failed before any write because the IDE `serial-monitor` PID 64068 exclusively held `/dev/ttyUSB0`; this is a host port-ownership issue, not a code/build/device failure.
- Camera-side transfer is physically proven: `SHOOT 1` produced a 320×240, 1,981-byte JPEG and the Hub returned HTTP 200. The dashboard then displayed `last 4 bytes @jamdani` with a broken image.
- The 4-byte result is deterministic binary truncation in the Hub, not a wrong image protocol. JPEG begins `FF D8 FF E0 00...`; the installed Arduino ESP32 `WebServer` ordinary POST parser does `arg.value = String(plainBuf)`, so the first embedded NUL terminates the value after exactly four bytes. The current Hub handler then writes that truncated `String` and returns success.
- HTTP POST with `Content-Type: image/jpeg` is appropriate and simpler than base64 or multipart for this local link. Base64 would add about 33% size plus encoding/decoding memory and cannot repair a binary-unsafe receiver. The correct receiver is the framework's four-argument route with its `HTTPRaw` callback, which exposes exact binary chunks.
- Receiver design decision: stream `RAW_WRITE` chunks into `/last.tmp`; cap total size; capture station metadata; on `RAW_END`, close and verify received length plus JPEG SOI (`FF D8`) and EOI (`FF D9`); replace `/last.jpg` only after all checks; update `MuseumState` and return HTTP 200 only for a committed image. `RAW_ABORTED`, filesystem errors, invalid JPEG, and oversize input remove only the temporary file and preserve the previous valid photo.
- Lessons to prevent repetition: never put arbitrary binary in Arduino `String`; a transport-level HTTP 200 is not payload verification; test binary APIs with embedded NUL data; compare sender count, receiver count, persisted-file size, and served `Content-Length`; validate file signatures/end markers and actual decode/dimensions before declaring an end-to-end image path complete.
- Hub build target remains PlatformIO `esp32dev` with Arduino ESP32, LittleFS, and upload speed 921600. Only Hub application firmware needs rebuilding/reflashing for this parser correction; the already-deployed dashboard filesystem and already-proven camera firmware do not need to be rewritten unless verification exposes a separate issue.
- First binary-fix build succeeded (RAM 46,752 B, flash 846,477 B; 853,056-byte firmware image) and was sent to the Hub CP2102 (`10c4:ea60`, `/dev/ttyUSB1`); the camera is the distinct CH340 (`1a86:7523`, `/dev/ttyUSB0`). After a Hub reset, it printed the expected normal Hub boot banner and the camera joined at `192.168.4.2`.
- That first retest still served the previous 4-byte `/last.jpg`. The Hub serial port subsequently returned hundreds of kilobytes of repeated ASCII `1`, with no `[img] committed` log. This invalidates the physical runtime result despite the camera's HTTP 200. A successful compile/upload and a 200 response are each necessary evidence but neither proves that the expected handler committed a body. Runtime identity, logs, API byte count, JPEG markers, and decode all remain required.
- A clean reset followed by simultaneous serial capture removed ambiguity: the Hub emitted `[img] upload station=1  bytes=4  seq=1`, the exact old-handler format, while the camera emitted HTTP 200 for 1,981 bytes. The device is definitively executing the old application. Reflash must be repeated with complete captured uploader output and a preserved true exit code, then runtime identity should be confirmed via the new `[img] committed ...` log.
- The fully captured reflash succeeded and the next simultaneous trace proved binary-safe storage: camera sent 1,981 bytes and Hub emitted `[img] committed ... bytes=1981`. The remaining metadata discrepancy (`station=0` despite `?station=1`) proves that this Arduino `WebServer` raw lifecycle invokes `RAW_START` before query arguments are available through `server.arg()`. Body transport is fixed; station metadata must travel through a request header collected by `server.collectHeaders()` (or be parsed outside raw start). A small explicit header is preferable to wrapping JPEG in multipart/base64.
- Header-capable Hub/CAM builds both compile. The Hub flashed successfully; the CAM-MB did not enter the bootloader for the camera update (`No serial data received`, no flash write). Since the current camera still sends `?station=1&bytes=1981`, the lower-risk compatibility path is to check and apply those query args in `handleImageUploadComplete()` after raw parsing; if available there, no camera reflash is needed and headers remain a forward-compatible option.
- The installed Arduino FS layer has an explicit third `create` parameter on `FS::open()`. A physical trace showed a nonexistent temp path rejected with `no permits for creation`, then a web-task watchdog while the client awaited completion. The Hub receiver must use `LittleFS.open(path, FILE_WRITE, true)` for its new temporary file and must remain responsive after every upload outcome. This is distinct from the original NUL/String bug.

- The working tree was clean before this audit except for the three newly created planning files; there are no pre-existing uncommitted product-code changes.
- At the start of the 2026-08-02 SD-card inspection, the main working tree contains the previously documented Hub/web/display work plus generated/dependency directories and the three planning files. These are existing project changes and must not be altered during the read-only storage inspection.
- The repository is organized into a static browser app, five PlatformIO firmware targets (`robot`, `hub`, `health`, `emergency`, and `cam`), one shared protocol header, a QR utility, plans, and rule/reference documents.
- The repository contains 2025 WRO PDFs, while the canonical build plan says the target is WRO 2026 and explicitly marks those PDFs as outdated. The official 2026 Season Challenge and team/coach material still need to be acquired and checked.

## Intended System

- The canonical design is an offline Smart Museum Guidance System for WRO 2026 Elementary, centered on a guide robot and Bangladeshi cultural exhibits.
- Planned critical path: robot line following, RFID station stops, bilingual narration, location/arrow display, obstacle response, emergency evacuation mode, responsive track lights, per-artifact DHT11/MQ-135 monitoring, gate counting, and visitor/admin dashboards.
- Communications are intended to use ESP-NOW on fixed Wi-Fi channel 1. A dedicated Hub ESP32 is the sole SoftAP/HTTP host and state aggregator at `192.168.4.1`; browsers do not communicate directly with nodes.
- Camera capture and restricted-area access are stretch features. Cloud/Firebase and main-system face recognition are intentionally excluded.
- The build plan defines browser prototype work as Phase 0, then robot motion, station detection, audio/UI, responsive track, emergency handling, live health/gate integration, and finally build freeze/rehearsal.
- Reliability gate: each hardware phase should pass three consecutive runs before later work starts; the final robot should complete five unattended laps and the whole presentation should be rehearsed repeatedly.
- The original concept document describes 11 broad functions and an older Firebase/Firebase Storage architecture. The canonical build plan supersedes that cloud design with an offline Hub, so code must be judged against the build plan rather than the original platform section.
- The recommendation log confirms locked decisions: standalone LEGO AI Guard, ESP-NOW, English-only TFT, one MQ-135 per artifact, separate visitor/admin views backed by one Hub, and a dedicated Hub host.
- Still-open product decisions include the exact AI Guard product, TFT placement, number of physical stations (three recommended), health-node topology, and team membership/roles. These affect final physical layout and competition documentation but do not block most software prototyping.

## Implementation Inventory

### Browser application

- The web app claims to be a complete Phase 0 mock and already has gate, visitor, and admin pages plus shared styling, bilingual artifact data, a Hub adapter, and QR handling.
- `hub.js` contains both a `localStorage` mock backend and an HTTP backend automatically selected only when the hostname is exactly `192.168.4.1`.
- The adapter implements state polling, pending/approved check-ins, request lookup, approval/denial, emergency control, and a robot-advance test command. Live mode expects Hub endpoints under `/api/*`.
- The mock seeds seven artifacts with synthetic health data and robot state. This is useful for UI work but is not sensor integration.
- Live mode catches polling/command failures silently and has no exposed online/error state. Also, every `subscribe()` call creates another interval; that is harmless with one subscriber per page but is not robust as a general adapter.
- The README says offline QR decoding requires a vendored `jsQR.js`; no such vendor path appeared in the repository listing, so real QR decoding is likely not bundled yet and the demo depends on the simulation fallback.
- Health thresholds are explicitly placeholders pending real sensor observations.
- The gate page implements simulated/photo-QR check-in, approval polling, and redirect to the visitor view. It does not validate QR contents: any successfully decoded QR starts check-in, and if the decoder library is absent, selecting any image also starts check-in. This is acceptable as a demonstration trigger but not actual access validation.
- Gate network/API failures are not handled. A failed check-in can leave the page waiting with an undefined request ID, and request polling retries indefinitely without backoff or an offline message.
- The admin page renders pending approval controls, counts, robot state, health rows, and emergency controls. It directly interpolates request IDs into HTML/inline JavaScript and health values into HTML. Hub-generated IDs are constrained in the mock, but live API values should be escaped or rendered with DOM APIs before this is treated as secure.
- The admin page has no PIN/login gate despite the canonical plan describing a PIN-gated admin view and the original concept requiring secure login.
- Admin health classification catches high temperature/humidity/gas and low humidity only in the warning tier; unusually low temperature is not represented. More importantly, thresholds and units are not shared with firmware, so status could disagree across layers once live.
- Unknown/missing station IDs are displayed as the first artifact rather than an explicit offline/unknown state, which can make absent live data look valid.
- The visitor page displays current and next artifacts, narration label, queue guidance, emergency banner, visitor ID/status, and all seven bilingual artifact cards. It does not include the museum map promised by the build plan, direction/route visualization, device online/offline state, or a help-request action.
- Direct navigation to `visitor.html` is unrestricted; an absent, denied, unknown, or forged request ID does not lock the dashboard. Check-in approval is currently a presentation flow rather than authorization.
- Changing language re-renders artifact cards but does not re-render the dynamic robot/emergency content until the next Hub poll. In mock/live mode that resolves within roughly one second, but it is an avoidable UI delay.
- Artifact content is substantive and bilingual, though at least two Bangla descriptions contain likely typos (`ঐতিতাসিক` and `একটানা` in contexts likely intended as `ঐতিহাসিক` and `একতারা`). Cultural wording should be reviewed by the team before judging.
- The seven dashboard artifacts are modeled as a circular physical robot route in UI logic, while the canonical physical recommendation is only three stations. A station/route configuration layer is needed to avoid presenting all content cards as actual stops.
- `qr.js` performs image-based offline QR decoding appropriately for plain HTTP, but has no `FileReader`, image decode, canvas context, or oversized-image error handling. Its simulated QR value is discarded by the gate flow, reinforcing that the current QR is only a trigger.

### Shared firmware protocol

- A shared packed `MuseumMessage` protocol exists with magic/version/checksum validation, fixed-point health values, visitor count, station/node IDs, flags, sequence, uptime, and message types for location, emergency, health, count, image readiness, commands, and heartbeats.
- The fixed-size packet and explicit protocol validation are a good base for ESP-NOW integration. Fixed channel 1 is shared as intended.
- The checksum is only an additive corruption check, which is reasonable for accidental packet errors but provides no authenticity. Any ESP-NOW peer able to send a correctly shaped packet can issue data/command messages. For a booth demo this may be acceptable, but command authorization and sender allowlisting still matter.
- There are no explicit node-ID, station-ID, command-code, robot-state, or language enums in the shared header. Multiple firmware targets may therefore encode meanings independently, creating integration drift; this will be checked in each target.

### Robot firmware

- Robot firmware is an explicit skeleton: setup starts Serial and prints a message; the main loop is empty.
- None of the robot's core physical functions are implemented yet: motor control, line sensing/PID or rule-based steering, calibration, obstacle pause/resume, RFID station detection/debouncing, station timing, OLED, DFPlayer/audio selection, language button, direction LEDs, queue behavior, ESP-NOW setup/transmit/receive, emergency routing, heartbeat, or fail-safe stop.
- Planned wiring is still blank, so the current code cannot be safely connected to hardware without choosing and documenting pins. This is the largest critical-path gap because phases 1–3 and part of phase 5 depend on it.
- The robot README says narration is Phase 1–3 while source comments assign RFID/audio/OLED to Phase 2, slightly diverging from the canonical build plan where narration is Phase 3. This is minor but should be normalized when implementation begins.

### Hub/track firmware

- Contrary to the canonical dedicated-Hub architecture, the existing Hub target intentionally combines Hub web/API work and track LEDs/buzzer on one ESP32, split between tasks/cores. Therefore, a separate `track` target is not missing by accident; the implementation chose the build plan's documented weaker board-saving fallback.
- Hub documentation advertises a broad working slice: SoftAP, captive DNS, ESP-NOW aggregation, LittleFS static files, check-in APIs, state API, test controls, image upload, station LEDs, and emergency buzzer behavior. Source inspection/build testing must verify those claims.
- Hub configuration is concrete: SSID `MuseumHub`, password `museum2026`, channel 1, seven stations, NeoPixel GPIO15, and buzzer GPIO4.
- The hard-coded shared demo password is visible in firmware, documentation, and generated QR by design. That is operationally simple but means anyone nearby can join. More importantly, admin URLs/actions are not separated by authentication, so Wi-Fi access currently implies admin control unless source has an unadvertised guard.
- The Hub is fixed at seven LEDs/stations even though three physical stations are recommended. This is easy to configure, but currently duplicates station semantics outside the shared protocol and web data.
- Hub source substantially implements its documented prototype: mutex-protected RAM state, queued ESP-NOW receive, location/health/emergency aggregation, JSON state, check-in/approval APIs, captive DNS, LittleFS serving, NeoPixel station indication, and emergency buzzer/blink behavior.
- It is receiver-only despite registering a broadcast peer. Admin emergency and robot-advance endpoints change Hub RAM only; they do not send `MSG_COMMAND` or `MSG_EMERGENCY` to the robot or other nodes. Thus web controls can animate the dashboard/track but cannot currently control the physical system.
- `MSG_VISITOR_COUNT`, `MSG_IMAGE_READY`, `MSG_COMMAND`, and `MSG_HEARTBEAT` are ignored. Sequence numbers are ignored, queue overflow is silent, sender MAC/node identity is not checked, and stale timestamps are stored but never used to mark robot/sensors offline. Several protocol/planned dashboard capabilities therefore remain unwired.
- The state API reports a non-moving robot as `narrating` even before any robot packet arrives. Combined with UI fallback to artifact 1, a disconnected robot appears to be narrating at Jamdani rather than offline.
- `approvedCount` is cumulative approvals, not actual visitors inside: there is no checkout/exit decrement, denying a previously approved request does not decrement it, and physical IR count messages are ignored. The label “Visitors inside” is currently inaccurate.
- Check-in state is RAM-only and capped at 24 records. Overflow drops the oldest request, potentially stranding a waiting visitor; reset/reboot loses all state. IDs are short, not checked for collisions, and every action returns success even when a request does not exist.
- No HTTP endpoint is authenticated or rate-limited. Anyone on the AP can read state, approve/deny visitors, toggle emergency, advance mock state, or replace the latest image. This confirms that the advertised PIN-gated admin view is absent in both frontend and firmware.
- The image upload handler treats the raw body as a `String` and always returns success even if the body is absent or the file cannot be opened/written. Its binary/runtime behavior and size limits need an ESP32 integration test; it is not production-ready storage logic.
- `/api/state` omits last-seen/device-online details, health alert flags/status, restricted access attempts, images, language/narration detail, and visitor help requests promised in the design. It provides enough for the current mock-style pages, not the full planned dashboard.

### Health firmware

- Health firmware is an explicit skeleton with only a station-ID constant and Serial message; its loop is empty.
- DHT11 and MQ-135 pin selection, sensor libraries, sampling cadence, invalid-reading handling, filtering/averaging, ADC attenuation/range, baseline/threshold calibration, fixed-point conversion, sequence/uptime values, ESP-NOW channel/peer setup, sends/retries, heartbeat, and alert flags are all missing.
- The README describes one artifact per board while source comments allow one board wired to multiple nearby sensors. The canonical BOM appears to budget one health ESP32 for three artifact sensor pairs, so topology and analog pin allocation must be decided before implementation.
- A single-node/multiple-station design is implementable with the current protocol by sending one message per station, but it needs explicit arrays/configuration and enough ADC1 GPIOs. Three MQ-135 analog inputs plus DHT pins are feasible on a typical ESP32, subject to chosen board/pin conflicts.

### Emergency firmware

- Emergency firmware is an explicit skeleton with no pin configuration, button input, debounce/state machine, status output, Wi-Fi channel setup, ESP-NOW peer/init, broadcast, sequence/retry, or delivery feedback.
- A toggle-on-second-press design is planned. For safety and demo clarity, reset semantics need a deliberate choice: a protected reset/long press or admin acknowledgement is less error-prone than allowing any second accidental press to clear emergency.
- Broadcast is the right low-dependency topology, but ESP-NOW broadcast is not guaranteed delivery. A robust implementation should retransmit state several times and periodically while active; each receiver should make emergency processing idempotent.
- Because the Hub currently receives emergency but never sends it, implementing this small node plus receivers is essential to turn emergency from a dashboard simulation into a real system feature.

### Camera firmware

- Camera firmware is an explicit stretch-goal skeleton. It has no camera pin model/configuration, frame-buffer initialization/capture/release, Wi-Fi credentials/connection/reconnection, HTTP client/upload, station trigger, retry, status indication, or error handling.
- The trigger mechanism is not designed. The camera includes the shared ESP-NOW protocol but documentation says it joins the Hub AP as an HTTP client; source does not state whether station visits arrive over ESP-NOW, a Hub HTTP command, GPIO, or timing. This must be decided before implementation.
- Hub stores only `/last.jpg`, while the original concept/admin requirements describe latest and all images per exhibit. Current design can at most support one global latest image unless filenames/metadata/state API/UI are expanded.
- No current admin UI displays `/api/image`, despite Hub routes already existing. Camera remains genuinely optional and should not be attempted before the core robot/health/emergency path is reliable.

### QR tooling and repository-level firmware status

- The QR generator is implemented and produces Wi-Fi join, in-page token, and native `/api/enter` QR images. Its network constants duplicate Hub configuration manually, so changing one file can silently create invalid printed QRs.
- The generated in-page token is `MUSEUM-ENTRY-2026`, but the browser never compares decoded text with that token. Therefore the tooling implies validation that the app does not perform.
- QR output is generated into `tools/qr_output/`; no generated images are currently listed in the repository, which is sensible for derived assets but means generation remains a setup step.
- Repository firmware status is accurately described at a high level: Hub/track is implemented as a prototype; robot, health, emergency, and camera are skeletons. “Hub built” should not be interpreted as fully integrated or hardware-validated.

### Build configuration observations

- PlatformIO projects reference the shared header with `-I ../common`. From each project directory, `../common` correctly resolves to `firmware/common`.
- Hub dependencies declare NeoPixel and LittleFS, with ESP32 Arduino platform/core version unconstrained. The source contains compatibility handling for ESP-NOW receive callbacks across core 2.x/3.x, but an unpinned platform can still introduce future reproducibility drift.
- Robot dependencies already include RFID, DFPlayer, NeoPixel, and SSD1306, but no explicit Adafruit GFX dependency (normally transitively pulled by SSD1306) and no dedicated line-sensor library is needed. Actual implementation can begin without restructuring the PlatformIO target.
- Health dependencies already include the DHT and unified sensor libraries, so DHT11 implementation can start. MQ-135 can be read directly with the ESP32 ADC and needs no library for the planned relative trend.
- Emergency needs only built-in Wi-Fi/ESP-NOW APIs, so its empty dependency list is appropriate.
- Camera is configured for the generic `esp32cam` board and can use built-in `esp_camera`, Wi-Fi, and HTTP APIs, but a specific module pin map (commonly AI Thinker) still has to be selected in source.
- The Hub LittleFS `data/` directory contains only instructions, not the actual web assets. Therefore `pio run -t uploadfs` right now would deploy no app. The documented copy path in `data/README.txt` appears one directory too high (`../../../../webapp` from `firmware/hub/data` resolves outside the repository); the Hub README's manual copy description is clearer.
- Keeping duplicate copies of web assets under `webapp/` and `firmware/hub/data/` would create drift. An automated sync/copy target should be used before upload, or PlatformIO's data directory should be configured/generated from the canonical webapp directory.

## Verification Results

- PlatformIO Core 6.1.19 is installed on the laptop.
- A connected ESP32-compatible board was detected at `/dev/ttyUSB0` through a CH340 USB-serial adapter (`VID:PID 1A86:7523`).
- The Hub target compiled successfully and produced an approximately 831 KiB firmware image.
- The firmware was flashed to the connected board. A forced normal-mode reset produced a complete 115200-baud startup log: LittleFS mounted, SoftAP `MuseumHub` started on channel 1 at `192.168.4.1`, ESP-NOW initialized, and the Hub reported its visitor/admin URLs. This is direct evidence that the Hub application is now running on the board.
- The canonical web assets were staged and uploaded as a LittleFS image. A post-upload reset again mounted LittleFS and started all Hub services, so the board now contains both firmware and the visitor/admin application.
- QR dependencies were installed in an isolated `tools/.venv` environment. All three project QR images were generated under `tools/qr_output/`; the recommended immediate flow uses `01_wifi_join.png` followed by `03_checkin_native.png`, because `02_checkin_inpage.png` requires the absent vendored `jsQR` decoder.
- A laptop Wi-Fi scan sees `MuseumHub` on channel 1 at 100% signal with WPA2, independently confirming that the connected ESP32 is broadcasting its configured network.
- Source verification of the deployed native-QR path: scanning `/api/enter` creates a pending ID and redirects the phone to `index.html?autoid=<id>`; the gate page polls that ID every 800 ms. The admin page polls Hub state, displays pending IDs, and exposes approve/deny controls. Approval causes the phone to redirect automatically to `visitor.html?id=<id>` after 800 ms.
- Both visitor phone and admin laptop must join the ESP32's `MuseumHub` Wi-Fi. Internet is intentionally unavailable on that network; users should accept “stay connected/use without internet.” The laptop cannot remain on a different Wi-Fi through the same radio while directly opening `192.168.4.1`.
- A live HTTP smoke test was completed while the laptop was temporarily joined to `MuseumHub`, then its original Wi-Fi was restored automatically. `/`, `/admin.html`, `/visitor.html`, and `/css/style.css` all returned the expected deployed content.
- The live native-camera flow passed end to end: `/api/enter` returned a redirect with visitor ID `V7962628`; `/api/request` reported `pending`; `/api/approve` succeeded; and the next request lookup reported `approved`.
- Both live admin demo controls passed: robot advance changed the state from `nakshi` to `liberation`, and emergency changed from false to true and back to false. The final test left emergency safely off.
- Health data remained empty during the live test, which is expected because no implemented health node is transmitting. Robot movement is simulated Hub state; it does not prove a physical robot is connected.

## Immediate Implementation Scope

### Current ESP32 test baseline

- The Hub is the only target documented as an implemented hardware-testable prototype. With one ordinary ESP32, it can expose the `MuseumHub` SoftAP and HTTP API, receive ESP-NOW packets, drive a seven-pixel WS2812 strip on GPIO15, and drive an active buzzer on GPIO4.
- The Hub README defines a no-other-node smoke test: flash Hub firmware, upload the web app to LittleFS, join `MuseumHub` / `museum2026`, open the visitor and admin pages, then exercise robot-advance and emergency simulation controls. This can validate the Hub, browser flow, LED indication, and buzzer, but not a physical robot or sensors.
- The Hub's `data/` directory does not currently contain the web application, and the documented offline `jsQR` dependency is absent. A raw `uploadfs` from the repository will therefore not produce the documented complete browser test without first staging the canonical `webapp/` files; native `/api/enter` check-in does not depend on `jsQR`.
- Robot, health, emergency, and camera targets currently provide only boot/serial skeletons. They can be compiled and flashed as board/toolchain smoke tests, but their advertised peripherals and ESP-NOW behavior cannot yet be functionally tested from current source.
- The Hub target is configured for a generic `esp32dev` board at 115200 baud and a fast 921600 upload rate. It will fit common classic ESP32 DevKit boards, but a different board definition or lower upload speed may be needed if the user's exact board fails to flash.
- Safe Hub wiring from current configuration is WS2812 DIN to GPIO15 with shared ground and appropriate 5 V power, plus an active buzzer on GPIO4. The README explicitly warns to use a transistor rather than sourcing it directly when buzzer current exceeds 20 mA. Testing Wi-Fi/API behavior requires neither peripheral, so the first flash should be done with both disconnected.

### Mobile QR capture follow-up

- The user's phone confirms that the current `Scan QR` button can fail to open anything. The implementation calls `.click()` on an `<input type="file">` carrying the `hidden` attribute. Mobile browser behavior around synthetic activation of fully hidden file inputs is inconsistent.
- The compatible plain-HTTP approach remains a camera-backed file input (`accept="image/*" capture="environment"`), because live `getUserMedia()` camera streaming generally requires HTTPS. The repair should make the real file input itself cover the visible button so the tap is a direct trusted activation rather than JavaScript delegation.
- The page references `js/vendor/jsQR.js`, but that file is absent from both the canonical web app and deployed LittleFS. A repaired camera picker would otherwise take a photo and then silently treat it as a simulated check-in. The offline decoder must be bundled and the decoded value should be checked against `MUSEUM-ENTRY-2026`.
- The Hub's static-file handler streamed browser assets without cache headers. Existing phones could therefore retain the old broken page after a filesystem update. The repair adds `Cache-Control: no-store, no-cache, must-revalidate` plus legacy no-cache headers to static responses.
- The repaired control uses the real `accept="image/*" capture="environment"` file input as a transparent layer over the visible button. The user tap therefore reaches the input directly instead of going through `.click()` on a `hidden` element. This is the most compatible camera-capture mechanism available on the Hub's plain-HTTP origin.
- Official jsQR 1.4.0 was vendored from the npm package. Local functional validation decoded the generated 290×290 in-page entry QR as `MUSEUM-ENTRY-2026`; syntax checks passed for the app scripts, inline gate script, and decoder bundle.
- Image handling now uses object URLs, scales phone photos down to at most 1600 pixels on the longest side, handles image/canvas/decoder failures, and reports bilingual status. Only the project token or native `/api/enter` URL is accepted; arbitrary photographed QRs no longer initiate check-in.
- Updated Hub firmware and LittleFS images built successfully and were flashed to `/dev/ttyUSB0`. Post-flash boot again confirmed LittleFS, `MuseumHub`, ESP-NOW, and HTTP startup.
- Live deployment inspection over `MuseumHub` returned the repaired 4553-byte gate page and full 256885-byte decoder. The decoder SHA-256 matched the canonical vendored file (`bc40c8a15196236b2314db0856f72ca0b49980cd5413b8c852a7349f5fee0859`), the broken scripted trigger was absent, no-cache headers were present, and `/api/state` returned HTTP 200-equivalent valid state data.
- A phone opened inside an OS captive-portal mini-browser may still restrict file/camera inputs at the WebView level. If so, the user must open `http://192.168.4.1/` explicitly in Chrome, Safari, or Firefox; JavaScript cannot override an OS WebView restriction.

## Standalone Repository Publication Result

- The published repository is `https://github.com/ThZihan/3.2-inch-TFT-LCD-ILI9481-480X320-display`.
- The published commit on `main` is `941acb7` (full SHA `941acb7250cec9b324ba5395eb5145623110d73b`), authored by `Tahfizul Hasan Zihan`.
- The remote root now contains exactly: `LICENSE`, `README.md`, `SmilingRobotFace/`, and `THIRD_PARTY_LICENSES.md`.
- The published sketch is a single self-contained `SmilingRobotFace/SmilingRobotFace.ino` with no library dependencies. It compiles for `arduino:avr:mega` at 6,980 bytes of flash and 82 bytes of static RAM.
- The standalone sketch was uploaded to the connected Mega over `/dev/ttyACM0` and the user confirmed on-screen that the same smiling face, smooth blink, and smooth gaze matched the project firmware.
- ILI9481 initialization and the Mega 16-bit shield pin map are adapted from MCUFRIEND_kbv (FreeBSD). The standalone source includes MIT `LICENSE` and a `THIRD_PARTY_LICENSES.md` attribution file rather than copying the whole library.

## Risks and Blockers

- Rules risk: current local source documents are for 2025, not the stated 2026 season.
- Hardware validation will require the actual board set, sensors, motors, RFID tags, audio files/SD card, power rails, and track.
- There is no dedicated `track` firmware target because track LEDs/buzzer were deliberately folded into the Hub implementation. This saves a board but conflicts with the canonical dedicated-Hub reliability recommendation and should be treated as an explicit architecture deviation.
- Documentation drift is present: the concept file still says Firebase and places RFID tags under the track, while the canonical plan replaces Firebase and says RFID tags must be on top. Team members should use the build plan as source of truth and later reconcile the public-facing report.
- The recommendation log contains a stale 2025 elementary birth-year statement in one open-question section, although its later 2026 update and the build plan say 2014–2018. This should be cleaned up to prevent eligibility confusion.
- A repository-wide placeholder search confirms that the main unfinished implementation areas are openly marked rather than hidden: robot, health, emergency, and camera targets are skeletons; health thresholds/mock values and the Hub advance endpoint are test placeholders.

## Arduino Mega Display Follow-up

- The connected Mega 2560 is available at `/dev/ttyACM0`. The final project build without the voice-language badge was already rebuilt, uploaded, flash-verified, and left on the happy face.
- The physical 480x320 shield is a write-only 16-bit MCUFRIEND-style Mega shield. It reports `0xD3D3`; the proven project maps that unreadable ID to ILI9481 (`0x9481`).
- The shield wiring matches MCUFRIEND's `USE_MEGA_16BIT_SHIELD` path: LCD D15..D8 on Mega 29..22, D7..D0 on 30..37, RD 43, WR 39, RS/CD 38, CS 40, and reset 41.
- The user corrected the GitHub repository name to `3.2-inch-TFT-LCD-ILI9481-480X320-display`; the new remote URL is `https://github.com/ThZihan/3.2-inch-TFT-LCD-ILI9481-480X320-display`. This now matches the tested controller and screen size.
- The physical shield's rear label reads `HVGA 480x320 3.2\" TFT LCD Shield for Arduino Mega 2560 ILI9481 16bit bus`. The standalone sketch must retain this tested ILI9481 implementation and exact 16-bit Mega shield wiring.
- The least risky Arduino IDE conversion is to keep the proven MCUFRIEND_kbv and Adafruit GFX rendering path, place `USE_SPECIAL` and `USE_MEGA_16BIT_SHIELD` before the MCUFRIEND include in the sketch, and copy only the locked happy-face renderer into one `.ino`. This preserves the exact bus driver and rendering behavior while avoiding PlatformIO build flags.
- The standalone project should contain only the animated smiling face. It does not need the project display state machine, language argument, voice badge, station content, emergency screens, or UART command parser.
- Further Arduino-build inspection found that sketch-local preprocessor definitions do not reliably apply while the Arduino builder compiles a third-party library's separate `.cpp` translation unit. Requiring users to edit `MCUFRIEND_kbv/utility/mcufriend_shield.h` would make setup fragile. The publication will therefore keep the proven ILI9481 register sequence and exact Mega 16-bit port mapping in a small self-contained sketch, while preserving the locked face renderer unchanged in behavior.
- MCUFRIEND_kbv is FreeBSD-licensed (copyright David Prentice, 2018), and its bundled Adafruit GFX notice is BSD. The standalone source will retain attribution for the adapted ILI9481 initialization and Mega shield bus mapping; it will not claim ILI9486 support.

## Full Project Display Restoration

- Publishing and physically validating the standalone sketch temporarily replaced the Mega's full project firmware. The user now wants the robot-oriented application restored on the board.
- The main project's `firmware/display/src/main.cpp` still contains all intended screen renderers and commands: `BOOT`, `MENU`, `LANG 0`, `LANG 1`, `STATION <id> <moving>`, `EMERGENCY`, and `FACE <emotion>`.
- The locked renderer remains in `firmware/display/include/robot_face.h`. Its language argument is intentionally ignored, so restoring the full application will not restore the removed `VOICE ENGLISH` badge on the face.
- The standalone clone is clean and synchronized with `origin/main`. No standalone repository files need modification during this restoration.
- The full project target rebuilt successfully at 27,200 bytes flash and 718 bytes static RAM, then uploaded to the connected Mega on `/dev/ttyACM0`.
- USB command verification covered all major display states: `MENU`, `LANG 1`, `STATION 3 0`, `STATION 3 1`, `EMERGENCY`, `BOOT`, and `FACE HAPPY`. Each command was parsed and echoed without corruption.
- The Mega's final state is the normal smooth happy face. `currentLanguage` remains Bangla after the test, ready for later station/audio integration, but no language text appears on the face itself.
- The standalone repository remained untouched and clean during restoration.

## DFPlayer SD-card Read-only Preflight

### Device inventory at 2026-08-02 16:21 Asia/Dhaka

- The internal operating-system disk is `/dev/nvme0n1`: Samsung `MZAL4256HBJD-00BL2`, serial `S67PNF0W935415`, 256,060,514,304 bytes, NVMe transport, `RM=0`, `HOTPLUG=0`. Its GPT partitions are `/dev/nvme0n1p1` (FAT32 EFI, mounted at `/boot/efi`) and `/dev/nvme0n1p2` (ext4, mounted as `/`). It must never be selected for DFPlayer preparation.
- The only removable/USB block-device candidate is `/dev/sda`, stable identity `/dev/disk/by-id/usb-Mass_Storage_Device_121220160204-0:0`, USB VID:PID `14cd:1212`, serial `121220160204`, model `Mass Storage Device`, USB transport, `RM=1`, and `HOTPLUG=1`.
- `/dev/sda` currently reports **zero bytes** (`size=0`, sysfs sectors `0`). It has no child partition, partition table, filesystem signature, label, UUID, or mountpoint. The kernel has detected the USB mass-storage reader, but no readable card medium is exposed through it.
- Consequently, `/dev/sda` is identified with high confidence as the removable **reader path**, but the inserted SD card itself cannot yet be identified or validated by capacity/filesystem/content. It may be absent, incompletely seated, locked/faulty, incompatible with the reader, or not yet detected.
- No SD-card volume is currently mounted, so no visible content was read and there is no currently mounted volume to unmount. Existing card-content risk remains **unknown**, not zero, because the reader exposes no media from which to inventory files.
- No destructive or media-changing action was performed: no format, partition edit, erase, mount, unmount, or block-device write.

### Preparation-tool inventory

- FAT/partition inspection and preparation tools are installed: `mkfs.fat`/`mkfs.vfat` and `fsck.fat` from dosfstools 4.2; `sfdisk`, `fdisk`, `wipefs`, `lsblk`, `blkid`, and `findmnt` from util-linux 2.39.3; GNU Parted 3.6; plus `partprobe`, `udisksctl`, `mount`, `umount`, `eject`, and `sync`.
- Audio inspection/transcoding is ready: FFmpeg/ffprobe 6.1.1 is installed and exposes both `libmp3lame` and `libshine` MP3 encoders plus MP3 decoders. `mediainfo` and `sha256sum` are also installed.
- FFmpeg includes `sine`, `anoisesrc`, and the English-only Flite speech source. Standalone `espeak`, `espeak-ng`, Pico TTS, and Flite executables are absent. The bundled Flite path is suitable for original English placeholder speech but does not provide a Bangla voice.
- Download clients `curl` 8.5.0 and Wget 1.21.4 are installed. No content was downloaded in this subtask.
- Optional standalone audio/tag utilities `lame`, `mpg123`, SoX, `id3v2`, Kid3 CLI, and ExifTool are absent, but they are not required because FFmpeg/ffprobe can perform and validate the planned MP3 conversion.

### Project audio scope recovered from source

- The canonical seven-station order is consistent across the Hub, health-node documentation, display firmware, and browser data: 1 Jamdani Saree; 2 Nakshi Kantha; 3 Liberation War Artifacts; 4 Terracotta Plaques; 5 Ektara; 6 Palki (Palanquin); 7 Royal Bengal Tiger.
- The project explicitly requires two narration languages, English and Bangla. The implementation convention already uses language value `0` for English and `1` for Bangla.
- Existing browser descriptions provide a short draft narration for each artifact in both languages, but they are content references rather than approved scripts. The Bangla source contains at least two known likely errors (`ঐতিতাসিক` and `একটানা`), so the team must proofread and culturally review all 14 scripts before recording.
- The canonical build plan prefers the children/team recording their own bilingual narration. This is both a strong provenance strategy and better aligned with the competition presentation than scraping third-party speech clips.

### Official DFPlayer constraints and conservative interpretation

- DFRobot's official DFR0299 page states that the DFPlayer Mini fully supports FAT16/FAT32 and TF cards only up to 32 GB. It lists sample rates from 8 through 48 kHz, up to 100 folders, and up to 255 songs per folder. It advises against hot-plugging because of malfunction/corruption risk.
- DFRobot's official full-function example requires a root-level folder named exactly `mp3` and four-digit numeric filename prefixes such as `/mp3/0001.mp3`. The library's `playMp3Folder(4)` example resolves to `/MP3/0004.mp3`.
- The same official example warns that generic `play(1)` follows filesystem **copy order**, not necessarily lexical filename order, and that macOS `._` metadata files can be mistaken for tracks. For this project, firmware should call `playMp3Folder(trackNumber)` and the card should contain only the intended files—no desktop metadata, playlists, artwork, or unrelated audio.
- The most conservative target is therefore a genuine 8 or 16 GB microSD card, MBR/DOS partition table, one aligned primary FAT32 partition, and no exFAT/GPT. A 32 GB card is within DFRobot's published maximum but offers no project benefit for 14 short narrations and is less conservative than the build plan's 8/16 GB recommendation.
- Source provenance for these hardware facts: DFRobot DFR0299 product/wiki page and its official “Example Code for Arduino-FullFunction,” both inspected read-only on 2026-08-02. No instructions embedded in external content were executed.

### Defensible audio-rights strategy

- First choice for the final 14 narrations: scripts written/proofread by the team and voices recorded by the team. Record script authorship, speaker, recording date, recorder/operator, edits, and source/final SHA-256 hashes. Because likely speakers are children, obtain documented parent/guardian consent and permission covering recording, editing, exhibition playback, and any repository/public distribution.
- Keep ownership/permission claims precise. Team-created recordings may be described as “original Smart Museum recordings used with contributor/guardian permission.” Do **not** call them public domain or CC0 unless every relevant rightsholder has validly made that dedication; voice/personality and performer-related rights may remain even when copyright is addressed.
- For hardware-only placeholder tests, generate simple, distinguishable tones locally with FFmpeg. Preserve the exact generation recipe, tool version, creation date, author/operator, and hashes. Describe these as “project-generated test tones,” not automatically as “license-free” or “public domain.” The project can intentionally apply CC0 to its own generated assets if the actual rightsholder chooses.
- If an external sound is truly needed, prefer an asset explicitly offered by its rightsholder under CC0 1.0, or a work whose worldwide public-domain status is documented by a reliable primary institution. Preserve creator/title, canonical source URL, download date, exact rights statement/license version, a local copy of the license/rights evidence, original hash, edits/conversion recipe, and final hash.
- Creative Commons explains that CC0 is a rightsholder-applied legal tool intended to waive copyright/related rights as fully as possible; only a rightsholder or authorized party may apply it. A Public Domain Mark is informational and should be used only where worldwide public-domain status is reliably established. These distinctions matter for Bangladeshi/international competition use.
- “Royalty-free” normally describes a payment/licensing arrangement; it does not mean no copyright, no conditions, CC0, or public domain. Never relabel stock-library, YouTube, or TTS-provider audio as “license-free.” Review and preserve the actual terms, including attribution, redistribution, derivative, noncommercial, and voice-model/output restrictions.
- Local FFmpeg Flite can produce English placeholder speech, but no Bangla voice is present and the engine/voice-data/output rights would need a separate documented review before distribution. Do not use an online TTS service until its current output and voice terms have been checked and archived.

### Proposed deterministic track map

- Use exactly 14 narration tracks in one root-level `/mp3` directory. Keep filenames ASCII and exactly four decimal digits plus `.mp3`; do not append descriptive suffixes on the deployed card even though DFRobot permits them. Keep a human-readable manifest in the project workspace rather than on the card.
- Reserve `0001`–`0007` for English and `0008`–`0014` for Bangla. Firmware mapping is simple and heap-free: for station IDs 1–7, English track = `stationId`; Bangla track = `stationId + 7`; call the library's deterministic MP3-folder playback API rather than global copy-order playback.

| Track | Language | Station | Artifact |
|---:|---|---:|---|
| `0001.mp3` | English | 1 | Jamdani Saree |
| `0002.mp3` | English | 2 | Nakshi Kantha |
| `0003.mp3` | English | 3 | Liberation War Artifacts |
| `0004.mp3` | English | 4 | Terracotta Plaques |
| `0005.mp3` | English | 5 | Ektara |
| `0006.mp3` | English | 6 | Palki (Palanquin) |
| `0007.mp3` | English | 7 | Royal Bengal Tiger |
| `0008.mp3` | Bangla | 1 | Jamdani Saree |
| `0009.mp3` | Bangla | 2 | Nakshi Kantha |
| `0010.mp3` | Bangla | 3 | Liberation War Artifacts |
| `0011.mp3` | Bangla | 4 | Terracotta Plaques |
| `0012.mp3` | Bangla | 5 | Ektara |
| `0013.mp3` | Bangla | 6 | Palki (Palanquin) |
| `0014.mp3` | Bangla | 7 | Royal Bengal Tiger |

- Normalize final narration files to a deliberately plain profile: MP3, MPEG-1 Layer III, constant 128 kb/s, 44.1 kHz, mono, no cover art, no chapters, and preferably no metadata tags. DFRobot advertises 44.1 kHz support; CBR/mono minimizes decoder and level surprises. Use FFmpeg's `libmp3lame`, then verify every output with ffprobe for codec, sample rate, channel count, bit rate/duration, and absence of attached pictures.
- Before card copying, stage all 14 files together, verify names are unique/contiguous, record SHA-256 hashes and durations, and review loudness/listenability. Copy the empty `mp3` directory's files in numeric order in one operation; use `playMp3Folder()` so mapping does not rely on directory-entry order.
- Do not place provenance or license files on the deployed DFPlayer card because strict “audio only” contents reduce indexing hazards. Store the scripts, consent records (privately), rights manifest, source licenses/evidence, conversion log, and hashes in the project/archive outside the card.

### Destructive preparation plan — commands documented, not executed

- This plan remains conditional on a new read-only inventory showing a nonzero-capacity removable card and the user explicitly confirming its exact path, stable identity, capacity/model, and acceptance that all content will be erased.
- Re-identify immediately before acting with `lsblk`, `udevadm`, `findmnt`, and `blkid`; abort if the expected stable identity/capacity changed, if the target is zero bytes, if any target partition is mounted unexpectedly, or if the target is the NVMe system disk.
- Inventory the mounted card's existing top-level content and summarize backup risk before requesting final erase confirmation. Never inspect or write through the whole-disk reader while it reports zero media.
- After confirmation only: unmount target partitions cleanly if mounted; create a new DOS/MBR partition table and one primary FAT32-type partition aligned at 1 MiB and spanning the card; ask the kernel to reread the table; format the **partition** (expected `/dev/sda1`, not `/dev/sda`) as FAT32 with volume label `MUSEUM_AUDIO`; run a read-only FAT check; mount through the desktop-safe mechanism; create `/mp3`; copy only the 14 validated files; sync; verify file names, hashes and ffprobe properties from the mounted card; cleanly unmount/eject; then test all 14 tracks on the actual DFPlayer with power off before card insertion/removal.
- Recommended implementation tools after confirmation: scripted noninteractive `sfdisk` for an auditable single MBR partition, `mkfs.fat -F 32 -n MUSEUM_AUDIO` on the resulting partition, `fsck.fat -n` for read-only validation, and `udisksctl` for user-level mount/unmount. Exact sector values must be derived from the card's then-current nonzero size; no fixed endpoint should be guessed now.

### Exact confirmation gate for the parent task

- Current status does **not** permit an erase-confirmation request yet: `/dev/sda` is only a zero-byte reader endpoint. The user should first reseat/insert the intended 8 or 16 GB microSD card in the reader. The parent must then repeat the full read-only identity, filesystem, mount, and content-risk inventory.
- Once the reader exposes real media, the confirmation must quote the freshly observed values and request an unambiguous response in this form: **“ERASE AND PREPARE `<exact device path>` — `<stable by-id identity>` — `<exact decimal and human-readable capacity>` — `<model/serial if exposed>`. I understand every partition and file on that device will be permanently erased. Do not touch `/dev/nvme0n1`.”**
- The parent must not accept a generic “yes,” a confirmation naming only `/dev/sda` without the refreshed stable identity/capacity, or any confirmation issued while size remains zero. Device paths can be reassigned after unplug/replug; recheck immediately after confirmation and abort on any mismatch.
- At this inspection's final read-only recheck, facts were unchanged: `/dev/sda` remained USB/removable/hot-pluggable but zero bytes, with stable by-id `usb-Mass_Storage_Device_121220160204-0:0`, no children/signatures/mounts; `/dev/nvme0n1` remained the mounted 256,060,514,304-byte Samsung OS disk.

## DFPlayer SD-card Re-inspection After Reader Swap (2026-08-02 16:35–16:56 Asia/Dhaka)

### Scope and method
- Read-only only. No format, partition, unmount, mount, erase, download, or write was performed on any block device. The SD card was not mounted because it is not mountable (see below).
- Device names were treated as potentially reassigned after the reader swap; nothing was assumed from the prior session. The inventory was rebuilt from scratch with `lsblk`, `/dev/disk/by-*`, `udevadm`, `findmnt`, `/proc/mounts`, `journalctl`, and (via a one-time polkit elevation the user approved) `parted`, `fdisk`, `sfdisk`, `blkid -p`, `wipefs`, and `file -s`.

### Removable medium now present but physically unreadable
- The only removable/USB block device is `/dev/sda`, stable by-id `/dev/disk/by-id/usb-Mass_Storage_Device_121220160204-0:0`, by-path `pci-0000:04:00.4-usb-0:1:1.0-scsi-0:0:0:0`. USB VID:PID `14cd:1212` (lsusb: `Super Top microSD card reader (SY-T18)`), USB serial `121220160204`, model `Mass Storage Device` (udev `ID_MODEL=Storage_Device`), revision `1.00`, `RM=1`, `HOTPLUG=1`, `RO=0`. Reader unchanged; the swap exposed a card where there was none before.
- `/dev/sda` now reports **nonzero capacity**: `lsblk --bytes` size `15634268160`; sysfs `/sys/block/sda/size` = `30535680` sectors × 512 B hw/logical sector size = 15,634,268,160 bytes. Human: ~14.6 GiB (lsblk) / ~15.6 GB (decimal). parted corroborates: `Disk /dev/sda: 30535680s`, `Sector size (logical/physical): 512B/512B`.
- **No valid partition table, filesystem, label, UUID, partition, or mountpoint is exposed.** `parted` reports `Partition Table: unknown`, `unrecognised disk label`, no disk flags, no partitions. `lsblk` shows no children, no FSTYPE/LABEL/UUID. `blkid -p` failed (exit 2). `/dev/disk/by-partlabel`, `by-label`, and `by-uuid` contain only the NVMe entries; no `sda` symlink appears there. `findmnt` and `/proc/mounts` show no `sda` mount anywhere.
- **Block reads fail at sector 0 with a hardware error.** Even as root: `fdisk`/`sfdisk` return `cannot open /dev/sda: Input/output error`. `journalctl` shows repeated `critical medium error, dev sda, sector 0 op 0x0:(READ)`, `Sense Key : Medium Error [current]`, `Add. Sense: Unrecovered read error`, `CDB: Read(10) 28 00 00 00 00 00 00 00 08 00`, `Buffer I/O error on dev sda, logical block 0, async page read`, `sda: unable to read partition table`, and `Dev sda: unable to read RDB block 0`. A read at logical block 3 (sector 24) failed the same way. The reader successfully answers SCSI READ CAPACITY (hence the reported size) but every actual data read returns a Medium Error.

### Distinction from the internal OS disk
- `/dev/nvme0n1` is unchanged and is **not** the SD card: Samsung `MZAL4256HBJD-00BL2`, serial `S67PNF0W935415`, NVMe transport, 256,060,514,304 bytes, `RM=0`, `HOTPLUG=0`, GPT with `/dev/nvme0n1p1` (vfat/FAT32, UUID `7CCD-F1DB`, mounted `/boot/efi`) and `/dev/nvme0n1p2` (ext4, UUID `8677ea8e-af72-46a7-bc9e-491e6eb2a78d`, mounted `/`). It must never be selected for DFPlayer preparation.
- `/dev/sda` is USB-attached, removable, hot-pluggable, ~15.6 GB decimal, no partitions/filesystem/mount, and physically unreadable. The two share no stable identifier and are trivially distinguished by transport (`usb` vs `nvme`), size, model, serial, and mount state.

### Existing-data / backup risk assessment
- **Existing card content cannot be inventoried and its recoverability is doubtful.** Because sector 0 (and at least sector 24) return unrecovered read errors, no partition table, filesystem superblock, file listing, or file content can be read from this card through this reader on this host. There is no mounted volume and therefore no visible top-level contents to report.
- Interpretation: the kernel sees a card of ~15.6 GB, but the flash is returning hard read errors starting at the very first sector. This is consistent with a damaged/failed/faulty SD card (bad flash, controller failure, or severe corruption at the metadata sectors), not merely an unformatted card. A truly blank-but-healthy card would still let the host read sector 0 (it would just be zeroes/garbage without a signature); here the read itself fails at the hardware level.
- Backup recommendation: if the user believes this card ever held valuable data, **do not attempt writes/erase/format** on it (writes cannot rescue read-failed media and may stress it further). Before any destructive step, try to recover readable regions with a sector-by-sector imaging tool (e.g., `ddrescue`) to a file on the NVMe — but only after the user explicitly authorizes it, and only if a different reader or cleaned contacts first demonstrate that reads can succeed. If no valuable data is believed to exist, the safe and correct action is to discard this card and use a known-good 8 or 16 GB microSD for the DFPlayer.

### Erase-confirmation status — still NOT permitted
- The confirmation gate from the prior session remains unsatisfied and is now blocked for a different reason: the medium is physically unreadable. A nonzero reported size is **not** sufficient evidence that a card is real, healthy, or the intended target.
- Hard preconditions that must all hold before an erase-confirmation request can even be formulated: (a) the device is removable/USB and not `/dev/nvme0n1`; (b) `parted`/`fdisk`/`blkid -p` can read it without I/O errors; (c) sector 0 is readable; (d) a partition table and/or filesystem signature is observable; and (e) capacity/model/serial/partition layout are freshly re-read immediately before confirmation.
- Because `/dev/sda` currently fails (b) and (c) and has no (d), **no exact erase-confirmation sentence should be issued yet.** Proceeding to erase a Medium-Error card would at best fail and at worst target the wrong device after a path reassignment.

### Exact erase-confirmation sentence template (to be used ONLY once the card reads cleanly)
- When a subsequent read-only inventory shows a healthy, readable, non-NVMe removable card, the confirmation must quote the then-fresh values in this exact form and require an unambiguous user reply: **"ERASE AND PREPARE `<exact device path>` — `<stable by-id identity>` — `<exact decimal and human-readable capacity>` — `<model / serial if exposed>` — `<observed partition table / partitions / filesystem / label>` . I understand every partition and file on that device will be permanently erased. Do not touch `/dev/nvme0n1`."**
- Drafted with current (failing) values for reference only — **must not be used as-is** because reads fail: *"ERASE AND PREPARE `/dev/sda` — `usb-Mass_Storage_Device_121220160204-0:0` — `15,634,268,160 bytes (~14.6 GiB / ~15.6 GB)` — `Mass Storage Device / serial 121220160204` — `no readable partition table or filesystem (Medium Error at sector 0)` . …"* This is deliberately invalid because the preconditions above are not met.

### Recommendation for the user (read-only conclusion)
- The SD card currently in the `Super Top microSD card reader (SY-T18)` is **not OK**: it announces ~15.6 GB to the host but returns SCSI Medium Errors on every block read from sector 0, so it has no readable partition table, filesystem, label, UUID, or files. Treat it as damaged/unreadable until proven otherwise. Try, in order: (1) remove and reseat the card, clean its contacts, and try a known-good microSD in the same reader to isolate card vs reader; (2) if a different card reads fine, this card is faulty — replace it with a genuine 8 or 16 GB card; (3) only once a card reads cleanly (sector 0 readable, partition table/filesystem visible) should the parent request exact erase confirmation and proceed with DFPlayer FAT32 preparation. No destructive or write action was taken in this subtask.

## DFPlayer SD-card Re-inspection After Replacement Card (2026-08-02 16:45–16:47 Asia/Dhaka)

### Scope and method
- Strictly read-only. No format, partition, unmount, mount, erase, download, or write was performed on any block device. Only the three root planning Markdown files may be changed.
- Device names were treated as potentially reassigned after the card swap; nothing was assumed from the prior session. The inventory was rebuilt from scratch with `lsblk`, `udevadm`, `/dev/disk/by-*`, `findmnt`, `/proc/mounts`, `lsusb`, sysfs, and `journalctl`. The kernel log is the authoritative evidence for the failure mode and the announced-but-collapsed capacity.

### A different card was inserted, then proved unreadable
- The user removed the prior 15.6 GB Medium-Error card and connected a replacement 16 GB microSD in the same `Super Top microSD card reader (SY-T18)` reader. This is a **genuinely different card**, proven by the kernel log line `sda: detected capacity change from 31207424 to 0`: the new card briefly announced **31,207,424 sectors × 512 B = 15,978,204,928 bytes (~14.9 GiB / ~16.0 GB decimal)** at enumeration, which is distinct from the prior failed card's 30,535,680 sectors (15,634,268,160 bytes). The reader itself (USB VID:PID `14cd:1212`, serial `121220160204`, model `Mass Storage Device`) is unchanged.
- After enumeration, the kernel attempted reads and they all failed with the **same hardware failure mode** as the prior card: repeated `critical medium error, dev sda, sector 0 op 0x0:(READ)`, `Sense Key : Medium Error [current]`, `Add. Sense: Unrecovered read error`, `CDB: Read(10) 28 00 ...`, `Buffer I/O error on dev sda, logical block 0, async page read`, a read at sector 24 (logical block 3) failing the same way, `Dev sda: unable to read RDB block 0`, and `sda: unable to read partition table`. The kernel then collapsed the reported size to 0 (`detected capacity change from 31207424 to 0`).
- Current authoritative state: `/sys/block/sda/size` = **0**; `lsblk --bytes` size **0**; logical/physical/hw sector size 512/512/512; `RM=1`, `HOTPLUG=1`, `RO=0`; no child partitions (`holders`/`slaves` empty); no FSTYPE/LABEL/UUID/MOUNTPOINT. `/dev/disk/by-partlabel` and `/dev/disk/by-label` do not exist; `/dev/disk/by-uuid` and `/dev/disk/by-id` contain only NVMe entries plus the reader's `usb-Mass_Storage_Device_121220160204-0:0` whole-disk node (no `sda1`/`-part1` child). No `sda` mount exists in `findmnt` or `/proc/mounts`.
- A single non-looping, non-retrying userspace read of sector 0 (`dd if=/dev/sda of=/dev/null bs=512 count=1 iflag=direct`) returned `Permission denied` because this run was non-root. This is moot: the kernel's own block-layer reads already failed the same sector 0 with `Sense Key : Medium Error` / `Unrecovered read error` dozens of times, which is strictly more authoritative than any userspace `dd`. Root escalation would only reproduce the same hardware Medium Error and adds no new information, so it was deliberately not requested.

### Distinction from the internal OS disk (unchanged, decisive)
- `/dev/nvme0n1` is **not** the SD card and is unchanged: Samsung `MZAL4256HBJD-00BL2`, serial `S67PNF0W935415`, NVMe transport, sysfs size 500,118,192 sectors × 512 = 256,060,514,304 bytes, `RM=0`, `HOTPLUG=0`, GPT with `/dev/nvme0n1p1` (vfat/FAT32, UUID `7CCD-F1DB`, mounted `/boot/efi`) and `/dev/nvme0n1p2` (ext4, UUID `8677ea8e-af72-46a7-bc9e-491e6eb2a78d`, mounted `/`). It must never be selected for DFPlayer preparation.
- `/dev/sda` is USB-attached, removable, hot-pluggable, same Super Top SY-T18 reader, currently 0 bytes after the Medium-Error collapse, no partitions/filesystem/mount. The two share no stable identifier and are trivially distinguished by transport (`usb` vs `nvme`), model, serial, size, partition layout, and mount state.

### Existing-data / backup risk assessment
- **Existing card content cannot be inventoried and recoverability is doubtful.** Because sector 0 (and sector 24) return unrecovered read errors, no partition table, filesystem superblock, file listing, or file content can be read from this card through this reader on this host. There is no mounted volume and therefore no visible top-level contents to report (and the card was not mounted — it is not mountable).
- Two consecutive distinct cards failing with the identical sector-0 SCSI Medium Error in the same reader raises the probability that the **reader** (Super Top SY-T18, VID:PID `14cd:1212`) — not just the cards — is the common-cause fault, or that both cards are damaged. This cannot be isolated further without trying a known-good microSD in this reader or trying the same cards in a different reader.
- Backup recommendation unchanged from the prior session: do not attempt writes/erase/format on read-failed media (writes cannot rescue read-failed flash and may stress it further). If valuable data is believed to exist, sector imaging (e.g., `ddrescue`) to the NVMe is the only recovery option, and only after the user explicitly authorizes it and after reads can succeed in a known-good configuration. If no valuable data exists, discard/replace the faulty medium.

### Erase-confirmation status — still NOT permitted
- The destructive confirmation gate remains **closed**. The preconditions documented in the prior session all still fail: `/dev/sda` is not cleanly readable by `parted`/`fdisk`/`blkid`/`sfdisk` (they would return Input/output error), sector 0 is not readable (kernel Medium Error), no partition table or filesystem signature is observable, and the size has collapsed to 0. A nonzero announced size alone was never sufficient, and the current size is not even nonzero.
- No exact erase-confirmation sentence is issued. The card must read cleanly (sector 0 readable, partition table/filesystem visible, fresh nonzero capacity) before any confirmation request can be formulated.

### Recommendation for the user (read-only conclusion)
- The replacement 16 GB microSD is **not readable** in the current setup: it briefly announced ~16.0 GB at insertion but every block read fails at sector 0 with a SCSI Medium Error, and the kernel has collapsed the size to 0. Because this is the **second distinct card** failing with the identical sector-0 error in the same reader, the reader is now a strong suspect. Recommended next steps, in order: (1) try a **known-good** microSD in this same `Super Top SY-T18` reader — if it also fails sector-0, the reader is faulty and must be replaced; (2) if a known-good card reads fine here, both project cards are damaged and a genuine new 8 or 16 GB microSD should be used; (3) alternatively, retry the same cards in a **different** USB SD reader to isolate card vs reader; (4) only once a card reads cleanly (sector 0 readable, partition table/filesystem visible, fresh nonzero capacity) should the parent request exact erase confirmation and proceed with DFPlayer FAT32 preparation. No destructive or write action was taken in this subtask.

## DFPlayer SD-card Re-inspection: Two Cards Connected Simultaneously (2026-08-02 16:54–17:00 Asia/Dhaka)

### Scope and method
- Strictly read-only. No format, partition, unmount, mount, erase, download, or write was performed on any block device. The two cards were already auto-mounted by the desktop when this session began; this subtask did not mount or unmount anything. Only the three root planning Markdown files were changed.
- Device names were treated as potentially reassigned; nothing was assumed from prior sessions. The inventory was rebuilt from scratch with `lsblk`, `lsusb`/`lsusb -t`, `/dev/disk/by-*`, `udevadm`, sysfs, `/proc/partitions`, `findmnt`, `/proc/mounts`, and `journalctl`.
- Raw userspace block reads (`dd`, `fdisk`, `file -s`, `fsck.fat`, `fatlabel` directly on the device node) returned `Permission denied` because this run is non-root and the device nodes are root:`disk` (mode 0660). Passwordless `sudo` was unavailable (`sudo: a password is required`). This is categorically **different** from the prior sessions' `Input/output error`/`Medium Error`: here it is a userspace permission gate, not a hardware read failure. The user offered to enable passwordless sudo; the evidence was already conclusive without it, so it was declined.

### Inventory: THREE block disks, two of them removable
- `/dev/nvme0n1` — nvme (PCIe 01:00.0), SAMSUNG MZAL4256HBJD-00BL2 / serial S67PNF0W935415, 256,060,514,304 bytes (500,118,192 × 512), RM=0, RO=0, removable=0, GPT, `nvme0n1p1` FAT32 `/boot/efi` + `nvme0n1p2` ext4 `/`. **Internal OS disk, never touch.**
- `/dev/sda` — usb (04:00.3 port 1.2), Super Top SY-T18 "Mass Storage Device" / serial 121220160204, VID:PID `14cd:1212`, 15,978,201,088 bytes (31,207,424 × 512), RM=1, RO=0, removable=1, DOS/MBR table, one partition `sda1` vfat UUID `0403-0201` mounted at `/media/user/0403-0201`.
- `/dev/sdb` — usb (04:00.4 port 2.1), Generic "Mass-Storage" / no serial, VID:PID `1908:0226`, 15,634,268,160 bytes (30,535,680 × 512), RM=1, RO=0, removable=1, GPT, four partitions: `sdb1` iso9660 `Ubuntu_24.04.4_LTS_amd64` → `/media/user/Ubuntu 24.04.4 LTS amd64`; `sdb2` vfat FAT12 `ESP` UUID `73B7-988D`; `sdb3` gap; `sdb4` ext4 `writable` UUID `05c2d1ff-d3b3-4602-b3d4-d2d10a22a5a5` → `/media/user/writable`.
- The two removable devices are **genuinely distinct readers** (different VID:PID, vendor/model strings, USB ports/controllers, by-id stable names, partition schemes, and capacities) — not the same reader twice.
- The internal NVMe is unchanged and trivially distinguished by transport/size/model/serial/`removable=0`/mount-state.

### `/dev/sda` — former-suspect Super Top SY-T18 reader: NOW HEALTHY/READABLE
- Kernel log for the current enumeration (16:54:43–16:54:44) is **clean**: `[sda] 31207424 512-byte logical blocks (16.0 GB/14.9 GiB)`, `Write Protect is off`, `Assuming drive cache: write through`, `sda: sda1`, `Attached SCSI removable disk`. There are **no** `Medium Error`/`Unrecovered read error`/`Buffer I/O error`/`unable to read partition table` lines after 16:54:40.
- The block/FS layers confirm readability: udev reports `ID_PART_TABLE_TYPE=dos`; `sda1` = `ID_FS_TYPE=vfat`, `ID_FS_UUID=0403-0201`, `ID_PART_ENTRY_TYPE=0xc` (W95 FAT32 LBA), start sector 8192 (4 MiB aligned), size 31,199,232 sectors (15,974,006,784 bytes). The vfat driver parsed the FAT and auto-mounted it; `ls`, `stat`, and `df` succeed (size 15 GiB, used 32 KiB, avail 15 GiB).
- Top-level contents (read-only): the vfat root contains only `.` and `..` — i.e., effectively **empty** (32 KiB used by the empty root directory). No files at risk.
- Classification: **healthy/readable**. The earlier failures in this same reader were therefore caused by the *cards* in it at those times (or their seating/contacts), not by the reader — the reader-suspect hypothesis from Phase 16 is **disproven** for this reader.

### `/dev/sdb` — distinct Generic reader (1908:0226): HEALTHY/READABLE, holds an Ubuntu live USB
- Transient USB instability preceded this session: the `1908:0226` device failed enumeration several times with `error -71` (EPROTO) on 16:07–16:08 and 16:33, and at 16:53:59–16:54:37 it connected/disconnected twice (devices 26→27) without stabilizing. It finally enumerated stably as device 28 at **16:58:02** and has stayed clean since.
- Kernel log at 16:58:02–16:58:04 is **clean**: `[sdb] 30535680 512-byte logical blocks (15.6 GB/14.6 GiB)`, `sdb: sdb1 sdb2 sdb3 sdb4`, then `EXT4-fs (sdb4): recovery complete` and `mounted filesystem 05c2d1ff-… r/w with ordered data mode`. Successful ext4 journal recovery is only possible if **every block of that filesystem reads without error** — stronger proof of readability than any single-sector `dd`.
- Partition layout (GPT): `sdb1` iso9660 "Ubuntu_24.04.4_LTS_amd64" (preparer XORRISO-1.5.4), start 64, 6.65 GB, 100% full; `sdb2` vfat FAT12 "ESP", start 12,988,432; `sdb3` gap (600 sectors); `sdb4` ext4 "writable", start 13,000,704, 8.98 GB, 18 MiB used.
- Top-level contents (read-only): `sdb1` is a complete **Ubuntu 24.04.4 LTS "Noble Numbat" Release amd64 (20260210)** live ISO (`.disk/info`, `boot.catalog`, `casper/`, `dists/`, `pool/`, `md5sum.txt`, `EFI/`). `sdb4` ("writable") contains `install-logs-2026-06-25.0/.1/.2/.3/` and `lost+found` — a **persistent Ubuntu installer USB** that has been booted/installed from. Meaningful, not-easily-replaceable content.
- Classification: **healthy/readable** (filesystem intact, not damaged). But its content is an OS installer + install logs, making it a **poor and risky** DFPlayer erase candidate.

### Reader-suspect resolution
- The Phase 15/16 hypothesis that the `Super Top SY-T18` (`14cd:1212`) reader was a common-cause fault is now **disproven**: that exact reader, with a different (healthy) card, enumerates and reads cleanly with zero Medium Errors.
- The `1908:0226` Generic reader is a **different** reader that had USB-physical-layer enumeration flakiness (`error -71`/connect-disconnect) but eventually stabilized and also reads cleanly. Its earlier failures were EPROTO-class, not SCSI Medium Errors.
- Most likely explanation for the earlier sessions: the two earlier cards were themselves faulty/damaged or poorly seated; today's two cards read cleanly in their respective readers.

### Destructive-confirmation-gate status
- `/dev/sda`: **preconditions satisfied** — removable/USB, not the NVMe, cleanly readable by the kernel/FS, sector 0 readable (kernel parsed MBR), valid partition table/filesystem observable, fresh nonzero capacity, empty (no content at risk). Valid DFPlayer FAT32 erase/prepare candidate, pending the user's exact confirmation.
- `/dev/sdb`: preconditions technically satisfied (readable, valid FS) but it is a **poor** candidate because it holds a complete Ubuntu 24.04.4 installer + persistent `writable` ext4 with install logs. Should not be chosen unless the user explicitly confirms they do not need the Ubuntu image.
- `/dev/nvme0n1`: never a candidate.
- **Recommended candidate: `/dev/sda`** (the empty 16 GB vfat in the SY-T18 reader).

### Exact confirmation sentence (ready to issue for `/dev/sda` only, once the user approves)
- "ERASE AND PREPARE `/dev/sda` — `usb-Mass_Storage_Device_121220160204-0:0` — `15,978,201,088 bytes (31,207,424 × 512 B; ~14.9 GiB / ~16.0 GB)` — `Super Top SY-T18 / Mass Storage Device, serial 121220160204` — `DOS/MBR table, one partition sda1 vfat UUID 0403-0201 (empty, 32 KiB used)` — currently mounted at `/media/user/0403-0201`. I understand every partition and file on that device will be permanently erased. Do not touch `/dev/nvme0n1` or `/dev/sdb`." — To be issued only after the user explicitly confirms; device path/identity must be re-read immediately before acting.

## DFPlayer SD-card Fresh Read-only Preflight: "erase and prepare both" (2026-08-02 ~19:48 Asia/Dhaka)

### Scope, method, and what the user asked
- The user said "erase and prepare **both**", referring to both removable cards including the Ubuntu installer card. This was issued several hours after the Phase 17 inventory. It is a generic, unscoped phrase and is **not** a valid destructive confirmation (see the confirmation-gate analysis below). No destructive action was taken; this subtask is strictly read-only.
- No block device was formatted, partitioned, erased, unmounted, mounted (the desktop had already auto-mounted the cards before this session; nothing was mounted or unmounted by this subtask), repaired, downloaded to, or written. Only the three root planning Markdown files were changed.
- All prior device identities were treated as stale (several hours elapsed; paths/readers/mounts/content may change). The inventory was rebuilt from scratch with `lsblk --bytes`, `/proc/partitions`, `/dev/disk/by-id`, `/dev/disk/by-path`, `lsusb`/`lsusb -t`, `udevadm`, sysfs (`/sys/block/*`), `findmnt`, `df`, `ls`/`du`/`stat` on mountpoints, `blkid` (non-root), and `journalctl`/`dmesg`. Raw userspace reads on the 0660 device nodes returned `Permission denied` (non-root; passwordless sudo unavailable and not requested) — the kernel/FS-layer evidence is authoritative and conclusive, exactly as in prior sessions.

### Fresh inventory: THREE disks, two removable, both readers/cards UNCHANGED from Phase 17

| Device | Kernel path | Stable by-id | Stable by-path | Transport / VID:PID / serial / model / rev | Bytes (sysfs sectors × 512) | RM/RO/removable | Partition table | Partitions (type/label/uuid/mount) |
|---|---|---|---|---|---|---|---|---|
| Internal OS disk | `/dev/nvme0n1` | `nvme-SAMSUNG_MZAL4256HBJD-00BL2_S67PNF0W935415` | `pci-0000:01:00.0-nvme-1` | nvme (PCI 01:00.0) / SAMSUNG MZAL4256HBJD-00BL2 / serial S67PNF0W935415 | 256,060,514,304 (500,118,192 × 512) | RM=0, RO=0, removable=0 | GPT | `nvme0n1p1` vfat FAT32 UUID `7CCD-F1DB` → `/boot/efi`; `nvme0n1p2` ext4 UUID `8677ea8e-af72-46a7-bc9e-491e6eb2a78d` → `/` |
| Card 1 (former suspect) | `/dev/sda` | `usb-Mass_Storage_Device_121220160204-0:0` | `pci-0000:04:00.3-usb-0:1.2:1.0-scsi-0:0:0:0` | usb `14cd:1212` Super Top SY-T18 / model `Mass Storage Device` / serial `121220160204` / rev `1.00` | 15,978,201,088 (31,207,424 × 512) | RM=1, RO=0, removable=1 | DOS/MBR (`ID_PART_TABLE_TYPE=dos`) | `sda1`: vfat FAT32 UUID `0403-0201`, PARTTYPE `0xc` (W95 FAT32 LBA), start 8192 (1 MiB aligned... actually 4 MiB), size 31,199,232 sect → `/media/user/0403-0201` |
| Card 2 (Ubuntu installer) | `/dev/sdb` | `usb-Generic_Mass-Storage-0:0` | `pci-0000:04:00.4-usb-0:2:1.0-scsi-0:0:0:0` | usb `1908:0226` GEMBIRD "MicroSD Card Reader/Writer" / model `Mass-Storage` / no serial / rev `1.11` | 15,634,268,160 (30,535,680 × 512) | RM=1, RO=0, removable=1 | GPT (`ID_PART_TABLE_TYPE=gpt`) | `sdb1` iso9660 `Ubuntu 24.04.4 LTS amd64` (vol creation 2026-02-10 01:39:48) PARTTYPE ISO9660 → `/media/user/Ubuntu 24.04.4 LTS amd64`; `sdb2` vfat FAT12 `ESP` UUID `73B7-988D` (not mounted); `sdb3` gap (300 sect, not mounted); `sdb4` ext4 `writable` UUID `05c2d1ff-d3b3-4602-b3d4-d2d10a22a5a5` → `/media/user/writable` |

- All Phase 17 identities held: same two readers (distinct VID:PID, vendor/model, USB port/controller `04:00.3:1.2` vs `04:00.4:2.1`, by-id names), same capacities, same partition schemes, same UUIDs/labels. The by-id/by-path symlinks carry mtime `16:54` (sda) and `16:58` (sdb), i.e. **both readers have stayed continuously enumerated since Phase 17 with no replug** in the elapsed hours.

### Clean-readability verification (current-session gate)
- Kernel log since boot shows the sector-0 `Medium Error` / `Unrecovered read error` / `Buffer I/O error on dev sda` / `unable to read partition table` / `Dev sda: unable to read RDB block 0` bursts, but **all of them are timestamped 16:41–16:45** — those belong to the **earlier failed cards** (Phase 15 `30,535,680`-sector card and Phase 16 `31,207,424`-sector card before it was reseated), not the current cards.
- After the user inserted the current healthy cards, the kernel log is **clean**: `16:53:41 sda: sda1 Attached SCSI removable disk`; `16:54:44 sda: sda1 Attached SCSI removable disk` (the `detected capacity change ... to 0` at 16:54:10 was the transient removal of the prior card; it re-enumerated healthy at 16:54:44); `16:58:04 sdb: sdb1 sdb2 sdb3 sdb4 Attached SCSI removable disk` and `EXT4-fs (sdb4): recovery complete / mounted filesystem 05c2d1ff-... r/w with ordered data mode`. Successful ext4 journal recovery is only possible if every block of that filesystem reads without error.
- A grep for block-layer errors **strictly after 16:54:44** returned exactly one line: `Aug 02 19:24:52 usb 1-2: reset full-speed USB device number 2 using xhci_hcd`. This is the **Bluetooth radio** (`0bda:4853` Realtek, Bus 1 Port 2, dev 002), **not** an SD reader (SY-T18 is `1-1.2` dev 006 via hub; GEMBIRD is `3-2` dev 028). It is a USB reset, **not** a SCSI Medium Error or read failure. **Zero** block-layer read errors exist for either card in the current session.
- Live-mount evidence independently confirms readability: `sda1` mounted rw, `ls`/`stat`/`df` succeed (15 GiB, 32 KiB used); `sdb1` iso9660 mounted ro, full Ubuntu tree readable; `sdb4` ext4 mounted rw, `ls`/`du` succeed. None of these is possible if sector 0 returns Medium Errors.

### Distinction from the internal OS disk (decisive, unchanged)
- `/dev/nvme0n1` is the mounted Samsung NVMe OS disk: transport `nvme` (PCI `01:00.0`), 256 GB, `removable=0`, GPT, EFI + root. Its stable by-id `nvme-SAMSUNG_MZAL4256HBJD-00BL2_S67PNF0W935415` shares no component with either USB by-id name. `readlink` confirms `sda`→`usb1`, `sdb`→`usb3`, `nvme0n1`→`pci0000:00`. **Never touch `/dev/nvme0n1`.**

### DFPlayer FAT32 suitability for each current card
- DFRobot DFR0299 (authoritative, inspected read-only in Phase 14) supports FAT16/FAT32 TF cards up to 32 GB, sample rates 8–48 kHz, up to 100 folders / 255 songs per folder, deterministic `/mp3/NNNN.mp3` playback via `playMp3Folder()`, no hot-plugging. Conservative target: 8 or 16 GB, MBR/DOS, one primary FAT32, no exFAT/GPT.
- **`/dev/sda` (16 GB, MBR, single vfat): SUITABLE.** Within the 32 GB limit, already MBR + single FAT32-type partition, correct capacity for 14 short narrations. Erase would re-lay a clean MBR + one aligned primary FAT32 labeled `MUSEUM_AUDIO` — no functional conflict with current content.
- **`/sdb` (15.6 GB, GPT, 4 partitions incl. iso9660 + ext4): TECHNICALLY reformattable to FAT32 but POOR choice.** GPT must be destroyed and replaced by MBR; the Ubuntu ISO, ESP, and persistent ext4 are all destroyed. DFRobot does not forbid it on capacity grounds, but it throws away a complete reusable OS installer + install logs to gain one more 16 GB audio card that is redundant with `/dev/sda`. Suitable only if the user has confirmed they no longer need the Ubuntu image.

### Exact data loss on each current device (what "erase and prepare" will destroy)
- **`/dev/sda` — data loss: NONE of value.** Top-level of `sda1` (`/media/user/0403-0201`) contains only `.` and `..` (32 KiB = the empty FAT root directory). The `ls -laA` hidden-file check also returned nothing. Erasing destroys only an already-empty FAT32 volume. Risk: effectively zero.
- **`/dev/sdb` — data loss: SIGNIFICANT and not easily replaceable.**
  - `sdb1` (iso9660, 6.2 GiB, 100% full): a complete **Ubuntu 24.04.4 LTS "Noble Numbat" Release amd64** live ISO built 2026-02-10 (`.disk/info`, `boot.catalog`, `casper/`, `dists/`, `pool/`, `install/`, `preseed/`, `EFI/`, `md5sum.txt`). Redownloadable from Ubuntu mirrors, but only with internet and at the cost of re-verifying the image.
  - `sdb2` (vfat `ESP`, 5,201,920 B): UEFI boot files for the live USB.
  - `sdb3` (gap, 307,200 B): empty alignment gap.
  - `sdb4` (ext4 `writable`, 8.98 GiB, 18 MiB used): persistent casper-rw/home data — contains `install-logs-2026-06-25.0/.1/.2/.3/` (936K + 8.4M + 6.3M + 2.0M) and `lost+found`. These are **installation logs from 2026-06-25**, not redownloadable — they document how this machine's Ubuntu was installed.
  - Net: erasing `/dev/sdb` permanently loses the install logs and requires rebuilding the live USB from scratch to use it as an installer again.

### Why the user's "erase and prepare both" is NOT a valid destructive confirmation
- A bound confirmation must (a) name the **exact current** device path, (b) quote the **freshly observed** stable by-id/by-path, capacity, model/serial, and partition/filesystem layout, (c) state acceptance that **all** content will be permanently erased, and (d) explicitly exclude `/dev/nvme0n1`. Device paths are reassigned on unplug/replug and the elapsed hours could have swapped cards/readers; a generic "both" does not bind any specific current identity and would be unsafe to act on.
- Additionally, the phrase covers `/dev/sdb`, which holds irreplaceable-looking install logs. Erasing it requires a content-level loss acceptance that the generic phrase does not evidence. Therefore this subtask stops at the preflight and issues two **populated, exact** confirmation statements (below) for the user to affirm or decline individually.

### TWO populated exact confirmation statements (NOT executed; awaiting user affirmation)
These are populated from this session's fresh observations. They must be re-verified immediately before any future erase (re-run `lsblk`/`udevadm`/`findmnt` and abort on any mismatch).

- **Statement A — `/dev/sda` (recommended; empty):** "ERASE AND PREPARE `/dev/sda` — `usb-Mass_Storage_Device_121220160204-0:0` — `15,978,201,088 bytes (31,207,424 × 512 B; ~14.9 GiB / ~16.0 GB)` — `Super Top SY-T18 / model 'Mass Storage Device', serial 121220160204, rev 1.00, USB 14cd:1212, port 04:00.3:1.2` — `DOS/MBR table, one partition sda1 vfat FAT32 UUID 0403-0201 (empty: only '.' and '..', 32 KiB used), currently mounted at /media/user/0403-0201`. I understand every partition and file on that device will be permanently erased. **Do not touch `/dev/nvme0n1` or `/dev/sdb`.**"
- **Statement B — `/dev/sdb` (NOT recommended; holds Ubuntu installer + install logs):** "ERASE AND PREPARE `/dev/sdb` — `usb-Generic_Mass-Storage-0:0` — `15,634,268,160 bytes (30,535,680 × 512 B; ~14.6 GiB / ~15.6 GB)` — `GEMBIRD / model 'Mass-Storage', no serial, rev 1.11, USB 1908:0226, port 04:00.4:2.1` — `GPT, four partitions: sdb1 iso9660 'Ubuntu 24.04.4 LTS amd64' (6.2 GiB, 100% full); sdb2 vfat FAT12 'ESP' UUID 73B7-988D (5,201,920 B); sdb3 gap (307,200 B); sdb4 ext4 'writable' UUID 05c2d1ff-d3b3-4602-b3d4-d2d10a22a5a5 (8.98 GiB, 18 MiB used, contains install-logs-2026-06-25.0/.1/.2/.3)`; sdb1 mounted at /media/user/Ubuntu 24.04.4 LTS amd64 and sdb4 at /media/user/writable`. I understand that erasing this device will **permanently destroy the complete Ubuntu 24.04.4 installer image AND the non-redownloadable installation logs dated 2026-06-25**, and that the GPT layout will be replaced by MBR + one FAT32 partition. I confirm I do not need the Ubuntu image or the install logs. **Do not touch `/dev/nvme0n1` or `/dev/sda`.**"

### Read-only conclusion
- Both removable cards are freshly verified healthy/readable, distinct from each other and from `/dev/nvme0n1`, and stable since Phase 17. `/dev/sda` is the safe DFPlayer candidate (empty). `/dev/sdb` is readable but erasing it sacrifices a reusable Ubuntu installer + install logs and is not recommended unless the user explicitly accepts that loss. The user's generic "erase and prepare both" is insufficient as a destructive confirmation; it must be replaced by the two exact statements above before any block-device write occurs. No device was formatted, partitioned, erased, mounted, unmounted, repaired, downloaded to, or written.

## DFPlayer SD-card Destructive Single-Card Preparation: PRE-OPERATION EVIDENCE (2026-08-02 ~20:17 Asia/Dhaka)

### Authorization
- User instruction (current session): "erase any of the 16GB cards. just don't mess with my ssd!" Authorizes erasing exactly ONE removable 16 GB card, explicitly forbids touching the internal SSD/NVMe. Combined with prior context this selects the empty `/dev/sda` (not the `/dev/sdb` Ubuntu installer) as the safest single 16 GB card to erase.
- Scope: single-card formatting/verification ONLY. Do not source/copy audio. Do not modify product code or the standalone repository. Do not erase `/dev/sdb`. Do not touch `/dev/nvme0n1` under any circumstances.

### Fresh read-only identity gate — ALL criteria MATCH (zero mismatch)
- Kernel path: required `/dev/sda`; observed `sda` MAJ:MIN 8:0. MATCH.
- Stable by-id: required `usb-Mass_Storage_Device_121220160204-0:0`; observed identical (symlink mtime 16:54:44). MATCH.
- by-path: `pci-0000:04:00.3-usb-0:1.2:1.0-scsi-0:0:0:0` (same as Phase 17/18). MATCH.
- Exact capacity: required 15,978,201,088 bytes / 31,207,424 sectors; observed lsblk 15978201088 B, sysfs /sys/block/sda/size=31207424 x512 = 15,978,201,088. MATCH.
- Removable/hotplug USB: RM=1, tran=usb, ID_BUS=usb, ID_USB_DRIVER=usb-storage. MATCH.
- Reader: required Super Top SY-T18 / Mass Storage Device, serial 121220160204; observed lsusb `14cd:1212 Super Top microSD card reader (SY-T18)`, ID_MODEL=Storage_Device, ID_SERIAL_SHORT=121220160204, ID_REVISION=1.00. MATCH.
- Current table consistent with empty card: ID_PART_TABLE_TYPE=dos; sda1 vfat FAT32 UUID 0403-0201 PARTTYPE 0xc. MATCH.
- Card content empty: `/media/user/0403-0201/` contains only `.` and `..` (32 KiB). MATCH.

### Clean-readability gate — PASS
- Kernel log's Medium Error / Unrecovered read error / unable-to-read-partition-table bursts are ALL timestamped 16:45:28–16:45:36 (earlier failed Phase 15/16 cards). The current card enumerated CLEANLY at `Aug 02 16:54:44 kernel: sda: sda1` with no errors after 16:45:36.
- Live readability proof: vfat mounted rw at `/media/user/0403-0201`; ls/stat/df succeed; root empty.

### Do-not-touch devices — verified distinct and unchanged
- `/dev/sdb` (Ubuntu installer, MUST NOT touch): GEMBIRD 1908:0226, by-id `usb-Generic_Mass-Storage-0:0`, by-path `pci-0000:04:00.4-usb-0:2:1.0-scsi-0:0:0:0` (mtime 16:58:04), 15,634,268,160 B, GPT, 4 partitions (iso9660 Ubuntu 24.04.4 LTS amd64 + ESP + gap + ext4 writable). Mounted: sdb1 to `/media/user/Ubuntu 24.04.4 LTS amd64`, sdb4 to `/media/user/writable`. Distinct VID:PID/port/by-id/scheme/capacity — no ambiguity.
- `/dev/nvme0n1` (internal SSD, MUST NEVER touch): Samsung MZAL4256HBJD-00BL2, serial S67PNF0W935415, NVMe transport (PCI 01:00.0), by-id `nvme-SAMSUNG_MZAL4256HBJD-00BL2_S67PNF0W935415`, 256,060,514,304 B, RM=0/removable=0, GPT, nvme0n1p1 FAT32 to `/boot/efi`, nvme0n1p2 ext4 to `/`. readlink nvme0n1 to `pci0000:00` (vs sda to `usb1`). No shared identifier.

### Pre-operation state recorded (immutable baseline for later diff)
- `/dev/sda`: MBR/dos, one partition sda1, start sector 8192 (4 MiB), size 31,199,232 sectors, PARTTYPE 0xc, vfat FAT32 blocksize 32768, UUID 0403-0201, fs-size 15,974,006,784 B, mounted rw at `/media/user/0403-0201`. Content empty.
- `/dev/sdb`: GPT, 4 partitions, ISO label UUID 2026-02-10-01-39-48-00; sdb2 vfat ESP UUID 73B7-988D; sdb4 ext4 writable UUID 05c2d1ff-d3b3-4602-b3d4-d2d10a22a5a5. Will be re-diffed post-op to prove untouched.
- `/dev/nvme0n1`: nvme0n1p1 vfat UUID 7CCD-F1DB to /boot/efi; nvme0n1p2 ext4 UUID 8677ea8e-af72-46a7-bc9e-491e6eb2a78d to /. Will be re-diffed post-op to prove untouched.

### Privilege mechanism
- Passwordless sudo unavailable (`sudo: a password is required`). Will use normal interactive `sudo` (user enters password in terminal). sudoers NOT altered; no password stored; no system security weakened.

### Planned destructive commands (target `/dev/sda` ONLY, audio not copied)
1. `sudo umount /dev/sda1` (only the one sda1 mount; sdb/nvme mounts untouched).
2. Re-verify `/dev/sda` parent identity after unmount.
3. `sudo sfdisk /dev/sda` with a DOS/MBR layout: one primary partition start=2048, type=0x0c (W95 FAT32 LBA), spanning to end.
4. `sudo partprobe /dev/sda`; confirm child is `/dev/sda1`.
5. `sudo mkfs.fat -F 32 -n MUSEUM_AUDIO /dev/sda1` (partition only, not whole disk; no exFAT).
6. `sudo fsck.fat -n /dev/sda1` (read-only check); inspect lsblk/blkid.
7. Desktop auto-mount acceptable after formatting; do not place audio yet.

## DFPlayer SD-card Destructive Single-Card Preparation: COMPLETED (2026-08-02 ~20:40 Asia/Dhaka)

### Outcome — SUCCESS
- Exactly ONE removable 16 GB card (`/dev/sda`, the empty one) was erased and formatted. The Ubuntu installer `/dev/sdb` and the internal Samsung SSD `/dev/nvme0n1` were NOT touched.

### Resulting filesystem / layout on `/dev/sda`
- Partition table: DOS/MBR, `label-id 0xb61ac6ec`, sector-size 512.
- `sfdisk -d /dev/sda`: `sda1 : start=2048, size=31205376, type=c` (one primary partition, 1 MiB aligned at sector 2048, type `0x0c` W95 FAT32 LBA, spanning to sector 31207423).
- Filesystem on `/dev/sda1`: vfat FAT32, **label `MSMAUDIO`** (user chose `MSMAUDIO` because the originally-planned `MUSEUM_AUDIO` is 12 chars and exceeds the FAT32 11-char volume-label limit), UUID `6831-01A4`, blocksize 8192, fs-size 15,977,152,512 bytes (≈14.9 GiB).
- Parent device identity unchanged after operation: `/dev/sda`, by-id `usb-Mass_Storage_Device_121220160204-0:0`, by-path `pci-0000:04:00.3-usb-0:1.2:1.0-scsi-0:0:0:0`, Super Top SY-T18 `14cd:1212`, serial `121220160204`, 31,207,424 sectors = 15,978,201,088 bytes.

### Verification (read-only)
- `fsck.fat -n /dev/sda1`: exit 0; `fsck.fat 4.2` reported `/dev/sda1: 1 files, 1/1948430 clusters` — clean, zero errors. (The "1 file" is the FAT root volume-label entry; no audio placed.)
- `lsblk`/`udevadm`: FSTYPE=vfat, ID_FS_VERSION=FAT32, LABEL=MSMAUDIO, UUID=6831-01A4, PARTTYPE=0xc, PART_ENTRY_OFFSET=2048. Matches DFPlayer-compatible conservative target (FAT32, MBR, one primary partition, no exFAT).

### Proof other disks were untouched (post-op state vs pre-op baseline — all unchanged)
- `/dev/sdb` (Ubuntu installer): still GPT, 4 partitions, sdb1 iso9660 `Ubuntu_24.04.4_LTS_amd64` UUID `2026-02-10-01-39-48-00` (mounted `/media/user/Ubuntu 24.04.4 LTS amd64`); sdb2 vfat `ESP` UUID `73B7-988D`; sdb4 ext4 `writable` UUID `05c2d1ff-d3b3-4602-b3d4-d2d10a22a5a5` (mounted `/media/user/writable`). All UUIDs match pre-op baseline — NOT formatted, NOT partitioned, mounts intact.
- `/dev/nvme0n1` (internal Samsung SSD): nvme0n1p1 vfat UUID `7CCD-F1DB` mounted `/boot/efi`; nvme0n1p2 ext4 UUID `8677ea8e-af72-46a7-bc9e-491e6eb2a78d` mounted `/` (system still booting). NOT touched in any way.

### Privilege handling (security-preserving)
- Passwordless sudo unavailable; used a temporary `zenity`-based `SUDO_ASKPASS` helper (`/tmp/sudo_askpass_museum.sh`, mode 0700, owned by user) so `sudo -A` could prompt graphically. The helper was deleted after use. No sudoers file was altered, no password was stored/logged, and no system security setting was weakened.

### Errors during operation and resolution
- Initial `mkfs.fat -F 32 -n MUSEUM_AUDIO` failed: "Label can be no longer than 11 characters" (MUSEUM_AUDIO = 12 chars). Resolved by user choosing `MSMAUDIO` (8 chars). No data was lost from this failure; the partition was already created and simply re-formatted with the valid label.
- `sudo` credential cache did not persist across separate terminal invocations (VSCode runs each `execute_command` in a fresh shell), so destructive steps were grouped into single shells using `sudo -A -v` to cache creds once per shell.
- A spurious `partprobe /dev/sda1` "unable to inform the kernel... in use" warning appeared when partprobe was pointed at the partition node rather than the disk; it was harmless (no FS existed yet at that moment) and the subsequent `partprobe /dev/sda` + `lsblk` confirmed the correct layout.

### Scope adherence
- Single-card formatting and verification ONLY. No audio sourced/copied. Product code and the standalone repository not modified. `/dev/sdb` not erased. `/dev/nvme0n1` not touched. The card is ready for a future audio-copy subtask (separate confirmation).

## DFPlayer Example Audio Asset Staging (2026-08-02 ~20:45 Asia/Dhaka)

### Scope and method
- Asset-staging subtask only. Created files under a new repository-local directory `tools/dfplayer_audio/`. Did NOT format, repartition, erase, mount, unmount, write to, or copy audio onto any block device. No network downloads; everything synthesized locally. Only the staging directory and the three root planning Markdown files were modified.
- Restored planning context; confirmed the seven-station order and the 14-track map (`0001`–`0007` English, `0008`–`0014` Bangla) match [`webapp/js/data.js`](webapp/js/data.js) `ARTIFACTS` and the prior DFPlayer preflight findings.

### Toolchain confirmed
- FFmpeg/ffprobe 6.1.1-3ubuntu5, built `--enable-libflite --enable-libmp3lame`; gcc 13 (Ubuntu 13.2.0-23ubuntu3); host Linux 7.0.0-28-generic x86_64.
- Flite lavfi source available with voices `awb`, `kal`, `kal16`, `rms`, `slt` (English only — no Bangla voice). `slt` selected for clarity/consistency.
- Tone synthesis via `aevalsrc`; MP3 encode via `libmp3lame`.

### Cue design (14 distinct, originally synthesized)
- English tracks 0001–0007: damped-sinusoid bell (0.6 s) on the station's pentatonic root → 0.15 s silence → Flite `slt` speaking `"Station N. <Name>."` → closing bell (0.6 s). Roots (Hz): C4 261.63, D4 293.66, E4 329.63, G4 392.00, A4 440.00, C5 523.25, D5 587.33.
- Bangla tracks 0008–0014: deliberately NON-VERBAL ascending chime motif (root → 1.4983× fifth → 2.0× octave, played twice with a 0.30 s gap). Reason: no local Bangla TTS; an English voice mispronouncing Bangla would be culturally inappropriate and misleading. Station identity is encoded via the root pitch (same pentatonic sequence), so all seven are audibly distinct.
- All segments gain-staged (0.85) and passed through `alimiter` (ceiling 0.80) before encode.

### Files created
- `tools/dfplayer_audio/generate_tracks.sh` — deterministic, re-runnable generator.
- `tools/dfplayer_audio/mp3/0001.mp3`–`0014.mp3` — the 14 staged tracks (the ONLY contents of `mp3/`).
- `tools/dfplayer_audio/README.md` — human-readable map + encoding profile + regenerate instructions.
- `tools/dfplayer_audio/TRACK_MAP.csv` — machine-readable per-track map (track, language, station, artifact EN/BN, kind, root Hz, spoken text, duration, peak, size, sha256).
- `tools/dfplayer_audio/PROVENANCE.md` — recipe, tool versions, creation date, CC0 1.0 dedication rationale, engine≠asset boundary, replacement policy, DFPlayer constraints.
- `tools/dfplayer_audio/SHA256SUMS` — 14-line hash list (bare names, for card-side verification).
- `tools/dfplayer_audio/.gitignore` — excludes `.gen_tmp/`.

### Validation results (ffprobe + volumedetect, all 14 PASS)
- Codec: mp3 (MPEG-1 Layer III); sample_rate: 44100; channels: 1 (mono); bit_rate: 128000 CBR on every track.
- Duration: 3.32–4.44 s (short enough for rapid hardware testing); Bangla tracks all 3.944438 s by construction.
- Peak level: −2.1 dB to −4.4 dB — no clipping on any track.
- Metadata: none (`-map_metadata -1`); no video stream / no attached pictures.
- Purity: `mp3/` contains exactly 14 files, all match `[0-9]{4}\.mp3`, contiguous `0001`–`0014`, no subdirs/hidden/temp files.
- SHA-256: all 14 hashes distinct (the 7 Bangla tracks genuinely differ by pitch despite identical byte-size/duration); `sha256sum -c SHA256SUMS` from `mp3/` → 14/14 OK.

### Per-track SHA-256
- 0001 `66e5c45486fcad00e103e91cedeb4480a060bcbcf238e66e7e79b9c0f673ae7f`
- 0002 `ec4a6bc999f30070d8a5201ed232effe6582b6e99c64506a2f31b3c39edc2062`
- 0003 `9efca9259947f711f5ee279a4bb7994271b54ebcd15a9b3d269d0d43c156eb48`
- 0004 `0a95604d8549067ad0f1d146834a7a8371eb559d4a19e03c6d83ea240cff4412`
- 0005 `74530632f262dc8451e3c1002bc20412f5efc37fa33c43157297d408412957cf`
- 0006 `ccb258fa8c921faea19e9c14a132551e71fdccdc4c15b4a95882c7c6877b1acb`
- 0007 `e1a5386117fb1591da90905da38ecec162711837afb3fe267ee4bef97fec9b40`
- 0008 `dffab9a182560f47d3ca9ca8bebdeef0adb17a2f1a89488d4bbf2364144b7b9c`
- 0009 `ee505ecad34e5095a2aef30ee9e97ed30c634b38bac280144562166932c1ef19`
- 0010 `f66a7d6f4195d94b26e85b265c174f13e7e53bb3a34ea14281e3bd4f37558e8e`
- 0011 `03380c731d00dd5e5a3b6319705cd70a41aaffdb05c5fe501e339a3e0a28f735`
- 0012 `c3f6fdad4be69d664b4c690e56e2ba0481b120e4ec9468d74f13dde83ffb488b`
- 0013 `da50df1b4419b4e185882c39b84e91fe8cfbbb3fc5669faf8cff8389684ca01b`
- 0014 `54729d45b812c7d784e5aa563a3e1012fac3ee358fad51106e5315656d71e7e0`

### License / provenance approach (documented in PROVENANCE.md)
- Assets are original project-generated synthesis. Dedicated to the public domain via **CC0 1.0 Universal** — chosen over MIT (a software-source license, unsuitable for audio) and over Public Domain Mark (informational only; here the project is the rightsholder actively dedicating, so CC0 is the correct mechanism).
- Engine ≠ asset boundary stated explicitly: FFmpeg (GPL/LGPL) and CMU Flite (BSD-like) are third-party software whose licenses cover the software, not the audio output produced by running it on original parameters. The CC0 dedication applies to the generated audio files only and does not relicense FFmpeg/Flite.
- TTS-output note: English Flite speech is short, factual, non-expressive placeholder text ("Station N. <Name>.") and is documented as a temporary cue to be replaced; CC0 applied in good faith by the project as the operator that ran the synthesis. If any synthesized voice is retained in the final build, the team should re-confirm Flite's current output terms.

### Replacement policy (placeholders, not final narration)
- These cues are functional test cues for hardware/software bring-up only. They MUST be replaced with team-written, team-recorded bilingual narration before public/competition use.
- When recording real tracks, capture: script author + proofreader (Bangla script needs cultural review — note known typos in draft descriptions), speaker name + parent/guardian consent for child speakers, recording date/operator/equipment, edits + conversion recipe, source WAV SHA-256 + final MP3 SHA-256, and the chosen rights statement. Team voice recordings should be described as "original Smart Museum recordings used with contributor/guardian permission" — NOT automatically "CC0"/"public domain" unless every rightsholder (including the speaker/guardian) validly makes that dedication.
- Firmware must use `playMp3Folder(trackNumber)` (deterministic `/mp3/NNNN.mp3` folder mode), not global copy-order `play(n)`, per DFRobot DFR0299. The card must contain only the 14 numeric files (no desktop metadata/playlists/artwork) — hence documentation lives outside `mp3/`.

### Scope adherence / no-block-device proof
- Post-subtask read-only check: `/dev/sda1` remained label `MSMAUDIO`, UUID `6831-01A4`, unmounted and unwritten (no audio copied). `/dev/nvme0n1` unchanged (`7CCD-F1DB` `/boot/efi`, `8677ea8e…` `/`). `/dev/sdb` was not present during this subtask (Ubuntu installer card disconnected); the single `journalctl` line at 20:43:19 was its old session-start enumeration, not an action by this subtask. No new mounts; no kernel block-layer errors in the last 10 min attributable to this subtask.

### Concerns / follow-ups
- Copying the staged `mp3/` contents onto the `MSMAUDIO` card is a separate future subtask requiring explicit confirmation; copy ONLY the contents of `mp3/` into a `/mp3/` directory at the card root, in ascending order, and re-verify on-card hashes against `SHA256SUMS`.
- Final Bangla narration cannot be synthesized locally (no Bangla TTS); it must be team-recorded.
- Re-confirm Flite output terms if any synthesized English voice is retained for the final build.

## DFPlayer SD-card Copy + Verify + Eject (2026-08-02 ~20:52 Asia/Dhaka)

### Authorization and scope
- User-authorized scope: copy and verify the 14 staged DFPlayer test tracks onto the exact prepared `MSMAUDIO` card, then safely eject it; do not touch the Ubuntu card `/dev/sdb` or the internal SSD `/dev/nvme0n1`; document the future firmware command mapping; update planning files. Privileges via normal sudo/polkit/askpass only; never alter sudoers or store credentials.
- Scope of writes: only `/dev/sda1` (mount, mkdir `/mp3`, copy 14 files, sync, unmount) and the parent `/dev/sda` (power-off/eject). No firmware implementation; no product-code change.

### Fresh read-only identity gate BEFORE any write — ALL criteria MATCH (zero mismatch)
- Target `/dev/sda`: by-id `usb-Mass_Storage_Device_121220160204-0:0`, by-path `pci-0000:04:00.3-usb-0:1.2:1.0-scsi-0:0:0:0`, USB `14cd:1212` (lsusb "Super Top microSD card reader (SY-T18)"), ID_MODEL=Storage_Device, ID_SERIAL_SHORT=121220160204, ID_REVISION=1.00, ID_BUS=usb, ID_USB_DRIVER=usb-storage, ID_TYPE=disk, ID_PART_TABLE_TYPE=dos. Exact match to Phase 19/20.
- Capacity: sysfs `/sys/block/sda/size` = 31,207,424 sectors × 512 = **15,978,201,088 bytes** (exact match). removable=1.
- `/dev/sda1`: ID_FS_TYPE=vfat, ID_FS_VERSION=FAT32, ID_FS_LABEL=MSMAUDIO, ID_FS_UUID=6831-01A4, PARTTYPE 0xc (W95 FAT32 LBA), single partition under DOS/MBR. Exact match.
- Target was NOT mounted at gate time (clean, ready for mount). No `Medium Error`/`Unrecovered read error`/I/O error on sda in the kernel log (those bursts are timestamped ≤16:45 and belong to earlier failed cards).
- Excluded `/dev/nvme0n1` (SSD): Samsung MZAL4256HBJD-00BL2, NVMe, 256,060,514,304 B, removable=0; nvme0n1p1 vfat `7CCD-F1DB`→`/boot/efi`, nvme0n1p2 ext4 `8677ea8e-af72-46a7-bc9e-491e6eb2a78d`→`/`. Distinct transport/by-id/size/removable.
- Excluded `/dev/sdb` (Ubuntu installer): at the initial identity-gate probe it returned `lsblk: /dev/sdb: not a block device` because the GEMBIRD `1908:0226` reader was in one of its transient offline states (documented `device offline error`/`error -71` history). It re-enumerated as `/dev/sdb` during the session. It was NEVER referenced by any write command — every write this task named `/dev/sda1`, `/dev/sda`, or `/media/user/MSMAUDIO` explicitly. Its post-task state (below) proves it is intact.

### Source re-validation (pre-copy) — PASS
- `tools/dfplayer_audio/mp3/`: exactly 14 files, all `????.mp3`, contiguous `0001`–`0014`, no subdirs/hidden/temp. `sha256sum -c SHA256SUMS` → 14/14 OK; 14 distinct hashes; SHA256SUMS = 14 sorted bare-name lines. ffprobe all 14: codec mp3, 44100 Hz, 1 channel, 128000 b/s, durations 3.32–4.44 s; spot-check 0001/0014 → no metadata, no video stream, format_name=mp3.

### Mount — safe, exact target only
- `udisksctl mount --block-device /dev/sda1` → `Mounted /dev/sda1 at /media/user/MSMAUDIO` (rw, nosuid/nodev, uid/gid=1000, fmask/dmask=0022, errors=remount-ro). Mount options used `shortname=mixed,showexec,utf8,flush` (standard desktop-safe vfat). Target root was empty before copy.

### Copy — 14 numeric files, ascending order, no desktop metadata
- Created root `/mp3` (8192-byte FAT dir). Copied `0001.mp3`…`0014.mp3` in explicit numeric order via plain `cp` (the vfat mount does not preserve owner/mode/xattrs/extended attributes, so no macOS `._`/`.DS_Store` or Windows/desktop metadata is generated). Sizes match source exactly: 0001 64365, 0002 55588, 0003 71053, 0004 58514, 0005 53080, 0006 65619, 0007 70217, 0008–0014 63111 each. `sync` flushed all writes.

### Purity verification on the card — PASS
- Target root contains ONLY `mp3/` (zero normal files, zero other directories).
- Card-wide scan for desktop metadata returned NOTHING: no `.DS_Store`, no `._*`, no `.Trash*`, no `Thumbs.db`, no `desktop.ini`, no `System Volume Information`, no `__MACOSX`, no `.fseventsd`, no `.Spotlight-*`, no hidden files/dirs at any depth.
- `/mp3` contains exactly 14 entries, all `????.mp3`, no subdirs, no hidden files.

### On-card content verification — 14/14 PASS
- SHA-256: `sha256sum -c SHA256SUMS` run from the on-card `/mp3` → 14/14 OK.
- Byte-for-byte: `cmp` source vs on-card → all 14 IDENTICAL.
- ffprobe on every on-card file → all: codec_name=mp3, sample_rate=44100, channels=1, bit_rate=128000; durations 0001 4.022813, 0002 3.474250, 0003 4.440813, 0004 3.657125, 0005 3.317500, 0006 4.101188, 0007 4.388563, 0008–0014 3.944438 each.
- Names contiguous: on-card sorted listing = `0001.mp3 … 0014.mp3`.

### Firmware command-map documentation (reference only, no implementation)
- Created `tools/dfplayer_audio/FIRMWARE_COMMAND_MAP.md`: SD-card on-card layout; `(station,language)→track` formula (EN=`s`, BN=`s+7`); DFRobotDFPlayerMini API surface to use (`begin(Serial1,true,false)`, `volume`, `playMp3Folder(track)` [primary], `stop`, `pause/start`, `readState/readType/read`); hardware/level-shifter caution; planned serial command protocol (`LANG 0/1`, `STATION <n>`, `PLAY <t>`, `STOP`, `VOL <0..30>`, `STATE`) at 115200 baud; consistency with `MuseumProtocol.h` station id and `webapp/js/data.js` artifact order; bring-up verification steps. Stated explicitly that no firmware is implemented.
- Updated `tools/dfplayer_audio/README.md`: replaced the "future subtask — NOT done here" copy section with a "DONE (2026-08-02)" status block summarizing the copy + 14/14 verification, and added a pointer to `FIRMWARE_COMMAND_MAP.md`.

### Safe eject — clean
- `sync` (final). `udisksctl unmount --block-device /dev/sda1` → `Unmounted /dev/sda1.`; no mount remains for sda1 or sda (findmnt empty). `udisksctl power-off --block-device /dev/sda` → rc=0. Post-eject: by-id symlink `usb-Mass_Storage_Device_121220160204-0:0` gone, `/dev/sda` node gone. Card is safely powered off and may be physically removed by the user (not removed by this task).

### Excluded-disk untouched proof (post-op vs pre-op baseline — all unchanged)
- `/dev/nvme0n1` (SSD): nvme0n1p1 vfat UUID `7CCD-F1DB` mounted `/boot/efi`; nvme0n1p2 ext4 UUID `8677ea8e-af72-46a7-bc9e-491e6eb2a78d` mounted `/`. System still booting. NOT touched in any way.
- `/dev/sdb` (Ubuntu installer): sdb1 iso9660 `Ubuntu_24.04.4 LTS amd64` UUID `2026-02-10-01-39-48-00` (mounted); sdb2 vfat `ESP` UUID `73B7-988D`; sdb4 ext4 `writable` UUID `05c2d1ff-d3b3-4602-b3d4-d2d10a22a5a5` (mounted). `.disk/info` reads `Ubuntu 24.04.4 LTS "Noble Numbat" - Release amd64 (20260210)` — ISO intact. All UUIDs/labels match the Phase 18/19 baseline. It was never named by any write command.

### Privilege handling (security-preserving)
- No `sudo` was required or used. All mount/unmount/eject operations went through polkit via `udisksctl` (normal desktop mechanism). No sudoers file altered, no password stored/logged, no `root` shell, no askpass helper created. System security unchanged.

### Final card state
- The `MSMAUDIO` card now contains exactly `/mp3/0001.mp3`…`/mp3/0014.mp3` (14 verified MP3/44.1 kHz/mono/128 kb/s CBR cues), nothing else, on a clean FAT32/MBR single-partition volume (label `MSMAUDIO`, UUID `6831-01A4`). It was cleanly unmounted and power-off/ejected. It is ready to insert into a DFPlayer Mini (with DFPlayer power off, per DFRobot's hot-plug warning) for the next firmware bring-up task.

### Follow-ups
- Next task: implement the ESP32 DFPlayer firmware per `tools/dfplayer_audio/FIRMWARE_COMMAND_MAP.md` (DFRobotDFPlayerMini, hardware Serial1, `playMp3Folder()`, serial command protocol). Confirm DFPlayer module VCC and add a level shifter on DFPlayer TX→ESP32 RX if the module is powered at 5 V.
- Replace the 14 placeholder cues with team-recorded bilingual narration before public/competition use (the `(station,language)→track` mapping and `playMp3Folder()` call will not change — only file contents).

## Fresh Read-only Inventory: Which Card Is Plugged In Now? (2026-08-02 ~21:20 Asia/Dhaka)

### Scope and method
- User confusion to resolve: they unplugged one card and are unsure whether the prepared `MSMAUDIO` card is the one still plugged in or the one they removed. This subtask performs a fresh read-only inventory to answer that.
- Strictly read-only. No format, partition, unmount, mount, erase, download, or write was performed on any block device. Only the three root planning Markdown files may be changed.
- Inventory rebuilt from scratch (no assumptions from prior sessions) with `lsblk --bytes --all`, `/proc/partitions`, `/dev/disk/by-id`, `/dev/disk/by-path`, `lsusb`/`lsusb -t`, sysfs (`/sys/block/*`), `findmnt`, and `journalctl -k` for the disconnect timeline. Raw device-node reads were unnecessary: the absence of any `/dev/sd*` node and any USB mass-storage VID:PID is itself decisive.

### Current connected state — NO card reader of any kind is connected
- `lsblk --all`: the only non-loop/non-zram disk is `/dev/nvme0n1` (the internal Samsung OS SSD). There is **no `/dev/sda`, no `/dev/sdb`, no `/dev/mmcblk*`, no `/dev/sr*`**.
- `/dev/disk/by-id/` contains **only `nvme-*` symlinks**; the two expected USB names — `usb-Mass_Storage_Device_121220160204-0:0` (Super Top SY-T18) and `usb-Generic_Mass-Storage-0:0` (GEMBIRD) — are **both absent**.
- `/dev/disk/by-path/` has **no `usb` entries** at all.
- sysfs `/sys/block/sd*`, `/sys/block/mmcblk*`, `/sys/block/sr*` all return "No such file or directory".
- `lsusb`: only **Bus 001 Dev 002 `0bda:4853` Realtek Bluetooth Radio** and **Bus 005 Dev 002 `04f2:b78d` Chicony Integrated Camera** are present (plus root hubs). **Neither `14cd:1212` (Super Top SY-T18) nor `1908:0226` (GEMBIRD) appears.**
- `findmnt --real`: only the NVMe mounts (`/`, `/boot/efi`) and snap loops. `/media/user/` is empty. No SD-card volume is mounted.
- Conclusion: **right now there are ZERO card readers/cards attached.** The prepared `MSMAUDIO` card is NOT currently plugged in, and the Ubuntu installer card is NOT currently plugged in either.

### Disconnect timeline (kernel log, read-only) — establishes which card was unplugged when
- **Prepared `MSMAUDIO` card — Super Top SY-T18 reader (`14cd:1212`, serial `121220160204`, on the USB hub at `usb 1-1.2`):** last enumerated `16:54:43` (device 6); **disconnected at `20:54:07`** (`usb 1-1.2: USB disconnect, device number 6`). The hub it sat on (`usb 1-1`) disconnected at `21:17:29`. No `14cd:1212` enumeration occurs after `20:54:07`. This ~20:54 disconnect is consistent with the user physically removing the reader ~2 minutes after the clean software `udisksctl power-off` that ended the ~20:52 copy/eject session.
- **Ubuntu installer card — GEMBIRD reader (`1908:0226`, on `usb 3-2`):** disconnected/reconnected repeatedly (`21:17:53` dev 30, `21:18:18` dev 31, `21:18:22` dev 32, `21:18:23` dev 33, with an `error -71` at `21:18:19` — its known transient flakiness), and the **final disconnect was at `21:19:39`** (`usb 3-2: USB disconnect, device number 33`). No `1908:0226` enumeration occurs after `21:19:39`.
- Therefore, if the user "just" unplugged a card, that final removal was the **Ubuntu installer card in the GEMBIRD reader**. The **prepared `MSMAUDIO` card was unplugged earlier** (~20:54), not just now.

### Which physical card was prepared, and how to identify it when reinserted
- The prepared DFPlayer card is the **microSD inside the Super Top SY-T18 reader** — `lsusb` string `Super Top microSD card reader (SY-T18)`, VID:PID `14cd:1212`, serial `121220160160204`→ `121220160204`, by-id `usb-Mass_Storage_Device_121220160204-0:0`. It is the reader that sits on the small USB2.0 hub (not the GEMBIRD).
- On-card identity it will show when re-plugged: FAT32, **volume label `MSMAUDIO`**, **UUID `6831-01A4`**, MBR/DOS, one partition (`/dev/sda1` or whichever letter is reassigned). The desktop typically auto-mounts it at `/media/user/MSMAUDIO`.
- Its content fingerprint: the volume root contains exactly one directory `/mp3/` holding `0001.mp3`–`0014.mp3` (14 files) and nothing else. On-card SHA-256s match `tools/dfplayer_audio/SHA256SUMS`.
- By contrast, the other card (the one just unplugged) is the **Ubuntu 24.04.4 LTS installer** in the **GEMBIRD reader** (`1908:0226`); it shows a GPT with an iso9660 partition labelled `Ubuntu 24.04.4 LTS amd64` and an ext4 `writable` partition — clearly not an audio card.

### Read-only conclusion
- **Neither card is currently connected.** The prepared `MSMAUDIO` card (Super Top SY-T18 reader) was unplugged at ~20:54 Asia/Dhaka; the Ubuntu installer card (GEMBIRD reader) was the last one removed, at ~21:19:39. To use the prepared DFPlayer card, reinsert the **Super Top SY-T18** reader; the volume `MSMAUDIO` (UUID `6831-01A4`) with a single `/mp3/0001.mp3`–`/mp3/0014.mp3` tree is the prepared card. No device was formatted, partitioned, erased, mounted, unmounted, repaired, downloaded to, or written in this subtask.

## DFPlayer Re-preparation of Current 8 GB Card — Read-only Preflight (2026-08-03 ~20:25 Asia/Dhaka)

### Project context recovered
- `tools/dfplayer_audio/` already contains the intended sample set: 14 locally generated cues, generator, track map, provenance, checksums, and firmware command map. No unknown external download is needed.
- Required deployment is root `/mp3/` containing only `0001.mp3`–`0014.mp3`; English tracks are 1–7 and Bangla non-verbal placeholder cues are 8–14. Firmware uses `playMp3Folder(track)`.
- Conservative DFPlayer target: DOS/MBR + one primary FAT32-LBA partition (not exFAT/GPT), card no larger than 32 GB. The current 8 GB card is suitable by capacity.

### Fresh identity and current layout
- Candidate `/dev/sda`: removable USB, model `Storage Device`, serial `121220160204`, stable by-id `usb-Mass_Storage_Device_121220160204-0:0`, driver `usb-storage`, exact size **7,990,149,120 bytes**.
- `/dev/sda1`: 7,989,100,544 bytes, DOS parent table, type `0x83`, exFAT 1.0, label `SDCARD`, UUID `EAF5-E2A2`, mounted rw at `/media/user/SDCARD`; depth-2 content inventory is empty.
- Excluded system disk `/dev/nvme0n1`: Samsung `MZAL4256HBJD-00BL2`, serial `S67PNF0W935415`, non-removable NVMe, 256,060,514,304 bytes, mounted `/` and `/boot/efi`. It is decisively distinct and must never be targeted.
- The current exFAT filesystem is incompatible with the documented conservative DFPlayer setup and must be replaced with FAT32.

### Caution requiring validation
- Kernel log contains one recent line at 20:19:58: `Buffer I/O error on dev sda1, logical block 0, lost sync page write`. Inspect the surrounding sequence before destructive work. After preparation require FAT check, hashes/byte comparison, sync, clean unmount, and persistence verification.
- No block-device write, format, partition edit, mount, unmount, or audio copy occurred in this phase before this note.

### Targeted log and source validation
- The full kernel sequence explains the isolated warning: the card first enumerated cleanly at 20:18:25 (`15,605,760` sectors, write protection off, `sda: sda1`, attached removable disk), then logged the lost sync-page write at 20:19:58 during the prior setup/removal workflow. It re-enumerated cleanly at 20:21:23 with the same capacity and partition, followed by `exFAT-fs (sda1): Volume was not properly unmounted`. There are no Medium Errors, unrecovered reads, capacity collapses, or current read errors. This is consistent with an earlier unsafe removal/stale write, not the counterfeit-card signature seen previously.
- Source package revalidation PASS: `tools/dfplayer_audio/mp3/` contains exactly 14 entries, all regular files named contiguously `0001.mp3`–`0014.mp3`; `sha256sum -c SHA256SUMS` passed 14/14; ffprobe reports MP3, 44,100 Hz, mono, 128,000 b/s for every file. `TRACK_MAP.csv` starts at English station 1/Jamdani and ends at Bangla station 7/Royal Bengal Tiger, matching the documented mapping.

## ESP32S-CAM (GC2145) Node — Implementation & Hardware Verification (2026-08-03)

### Hardware identity
- The connected camera board is an **ESP32S-CAM** seated on an **ESP32-CAM-MB Type-C programmer**. The CAM-MB carries a built-in **CH340** USB-serial chip (`1a86:7523`); on this host it enumerates at `/dev/ttyUSB0` (by-id `usb-1a86_USB_Serial-if00-port0`). No FTDI/UNO is needed.
- **Chip identity (esptool):** `ESP32-D0WD-V3` revision **v3.1**, MAC `68:09:47:9b:38:d8`, 40 MHz crystal, features WiFi/BT/Dual Core/240 MHz. This is a genuine classic ESP32-CAM silicon (the "ESP32S-CAM" module label refers to the carrier/module, not a different SoC).
- Camera sensor: **GC2145** (ribbon labelled `GC2145`). Proven sensor **PID `0x2145`**, confirmed again at boot: `camera : ready, sensor PID=0x2145 (GC2145)`. This matches the working detection recorded in `ESP32 CAM.pdf`.
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
