ZAN-Tech-bd/WRO_Rizwanul-Rafeeul-Luban/diagrams/01_working_combo_system_context.png

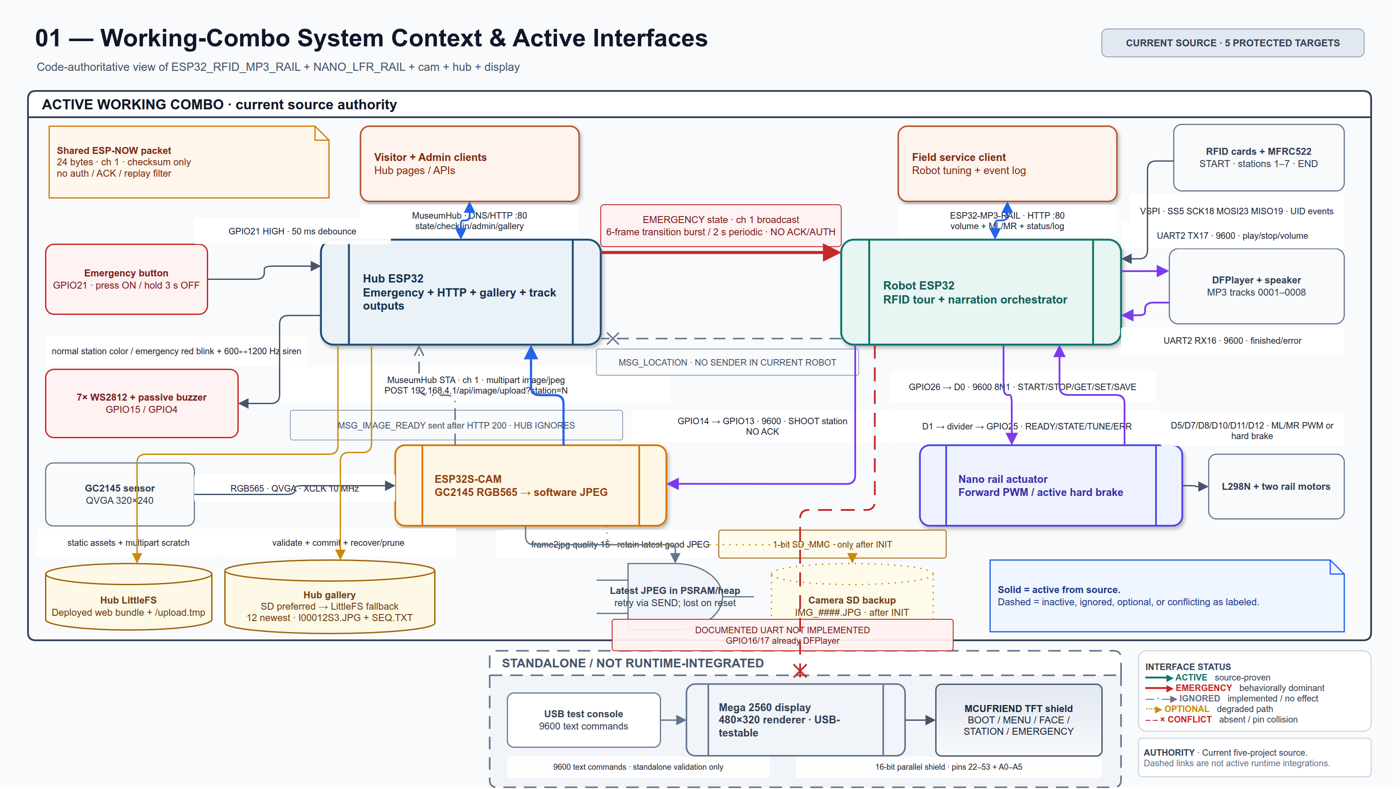
diagrams/01_working_combo_system_context.png
