ZAN-Tech-bd/WRO_Rizwanul-Rafeeul-Luban/diagrams/02_robot_hardware_communication_topology.png

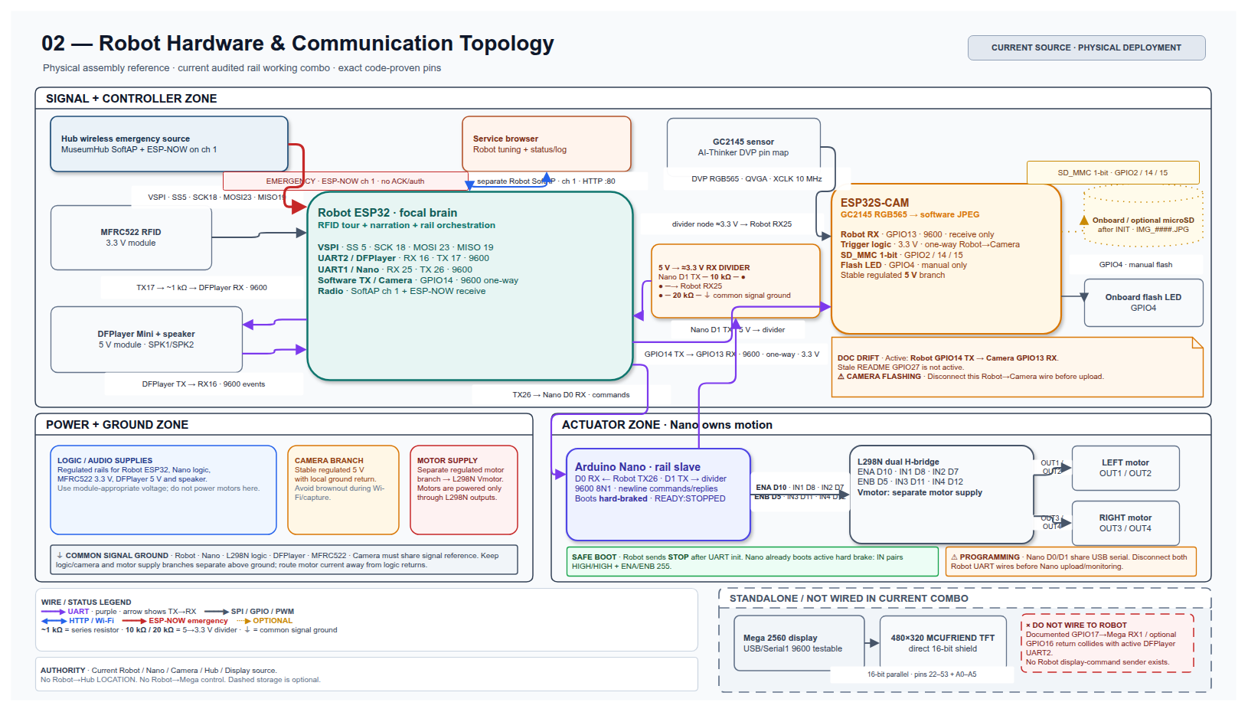
diagrams/02_robot_hardware_communication_topology.png
