ZAN-Tech-bd/WRO_Rizwanul-Rafeeul-Luban/diagrams/03_normal_tour_narration_photo_sequence.png

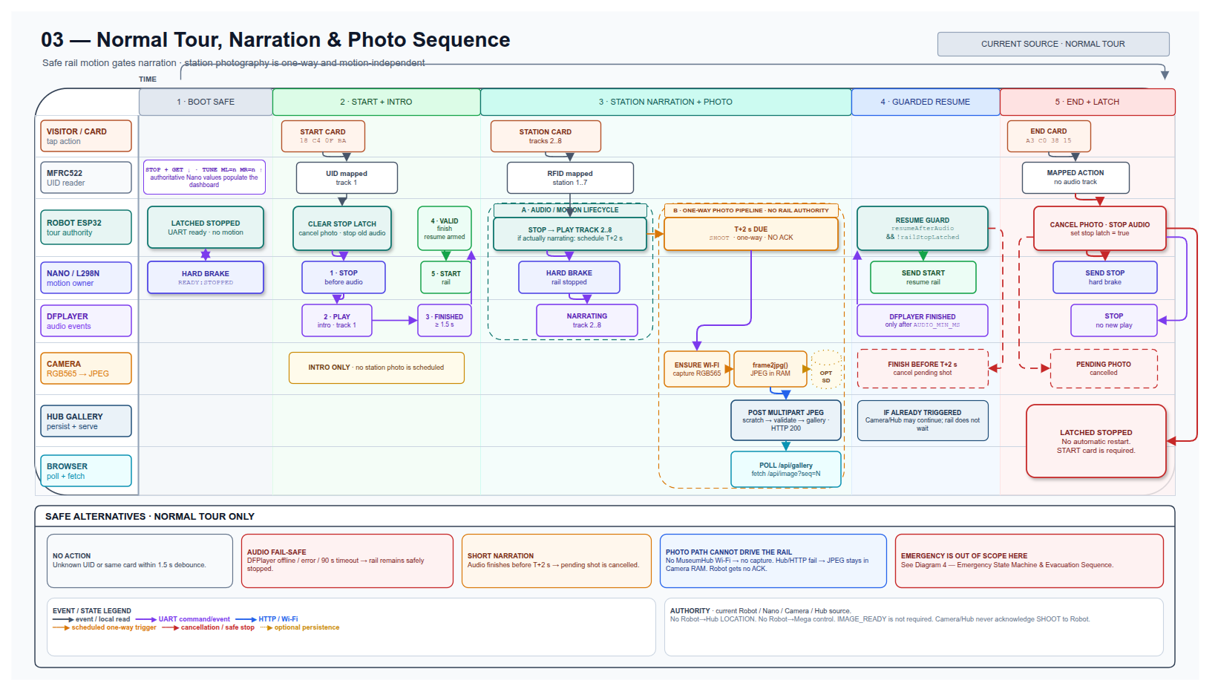
diagrams/03_normal_tour_narration_photo_sequence.png
