ZAN-Tech-bd/WRO_Rizwanul-Rafeeul-Luban/diagrams/03_radio_and_networks.png

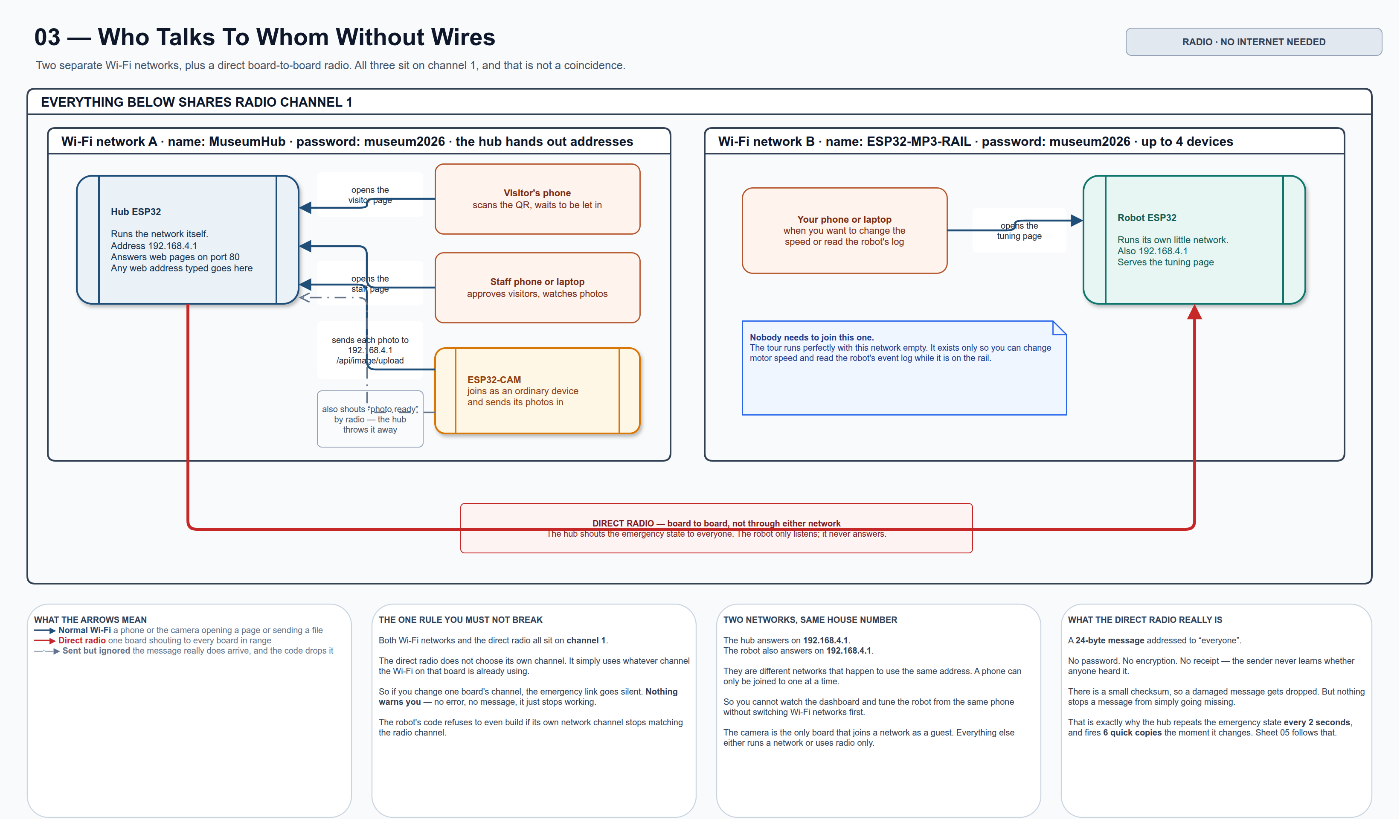
diagrams/03_radio_and_networks.png
