ZAN-Tech-bd/WRO_Rizwanul-Rafeeul-Luban/diagrams/04_emergency_authority_evacuation_behavior.png

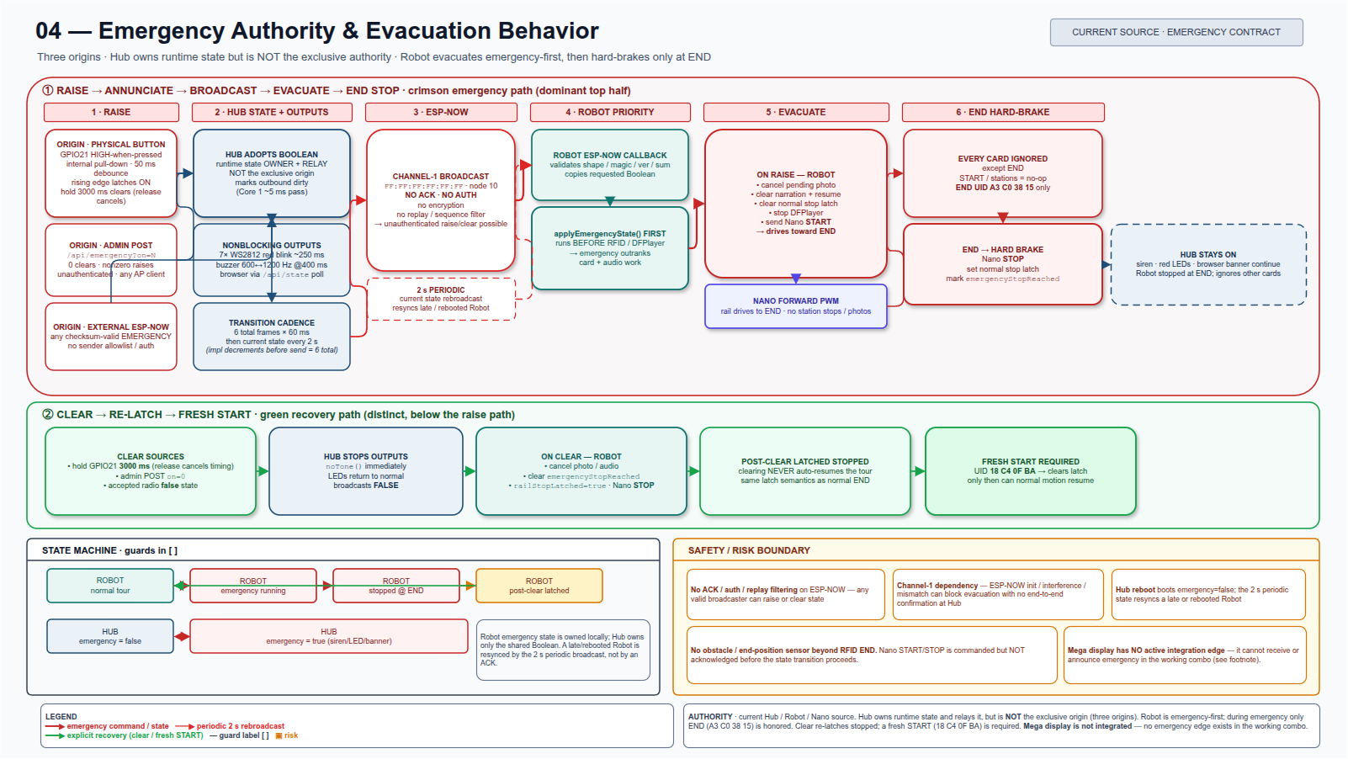
diagrams/04_emergency_authority_evacuation_behavior.png
