ZAN-Tech-bd/WRO_Rizwanul-Rafeeul-Luban/diagrams/04_one_station_stop.png

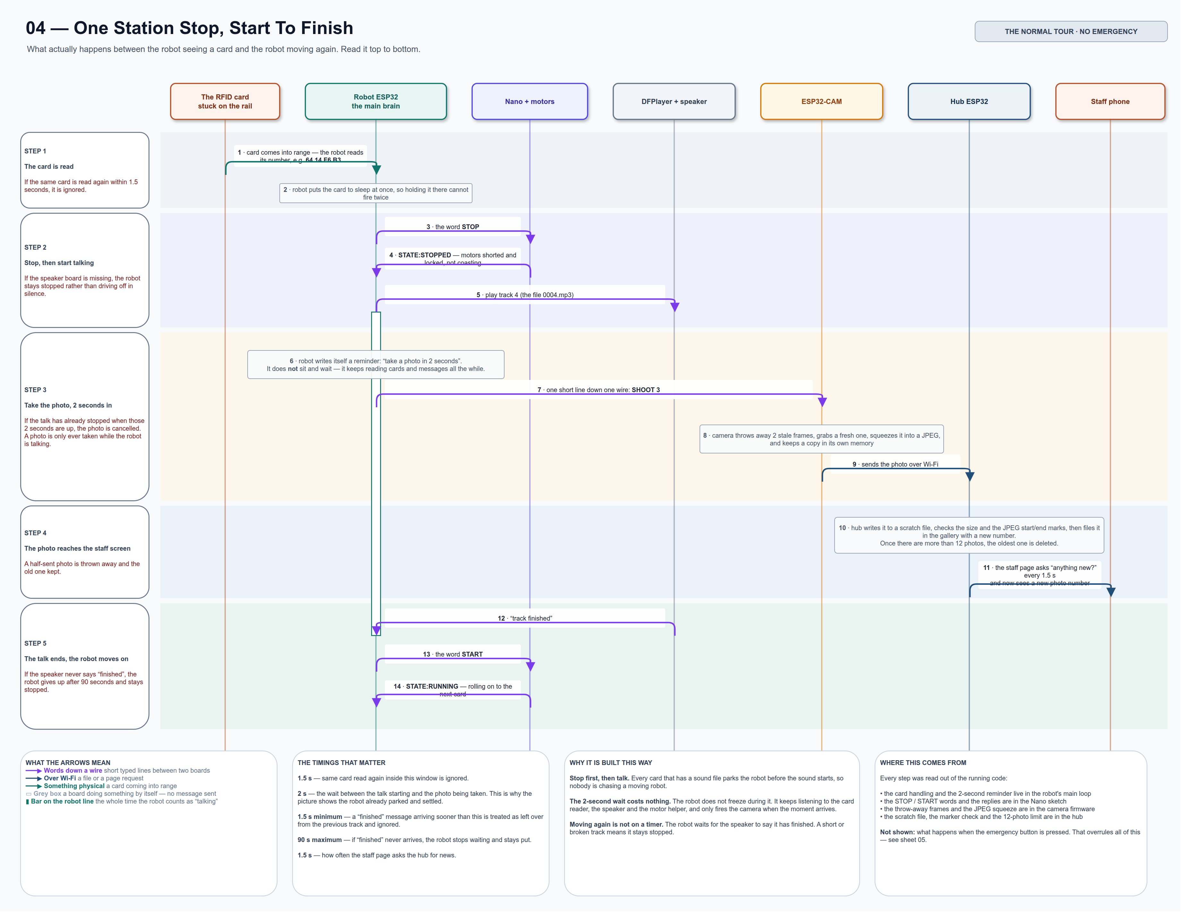
diagrams/04_one_station_stop.png
