ZAN-Tech-bd/WRO_Rizwanul-Rafeeul-Luban/diagrams/05_emergency_path.png

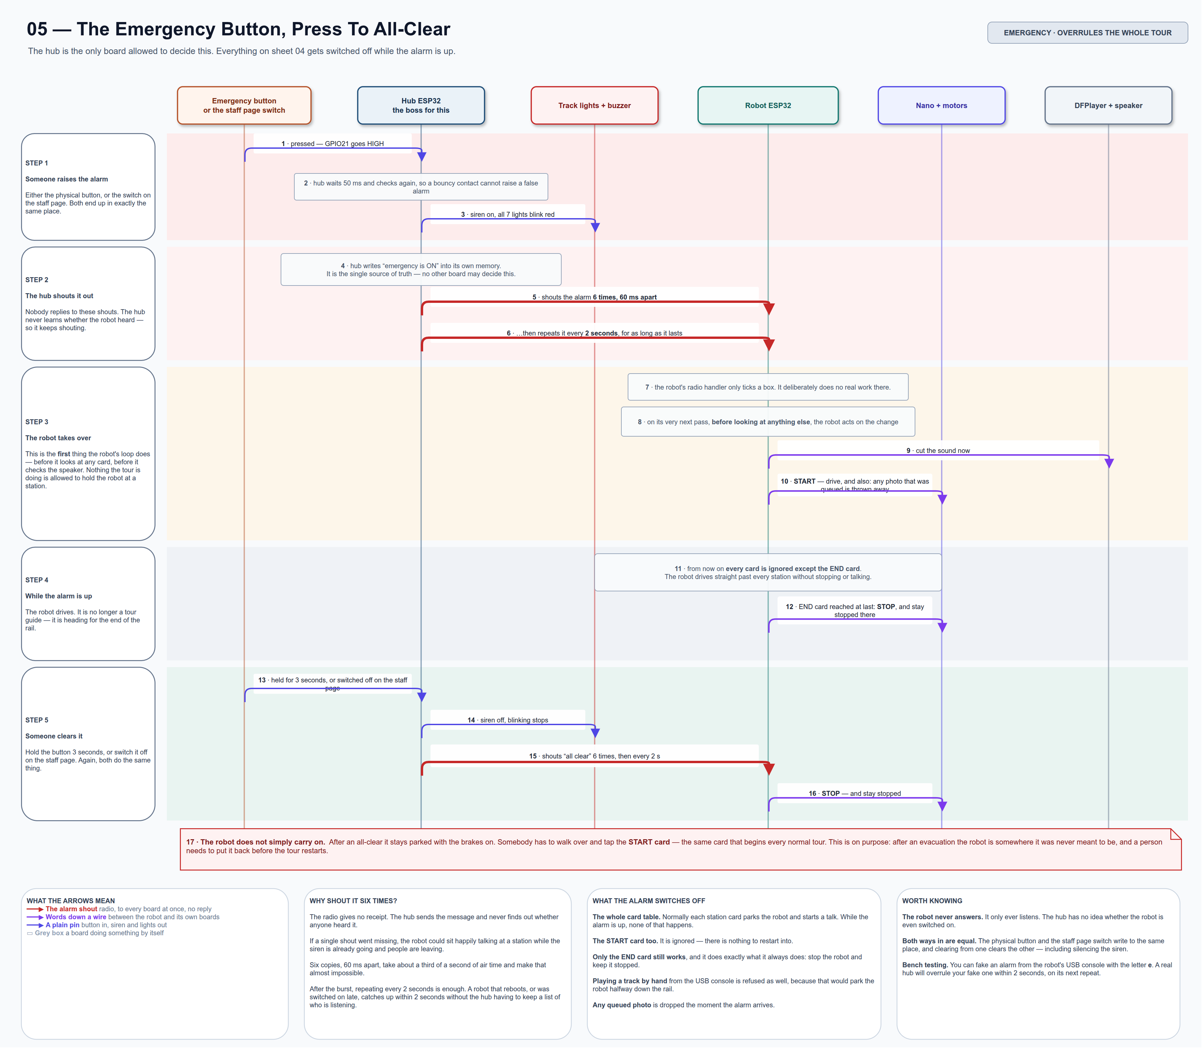
diagrams/05_emergency_path.png
