ZAN-Tech-bd/WRO_Rizwanul-Rafeeul-Luban/diagrams/05_hub_software_concurrency_data_architecture.png

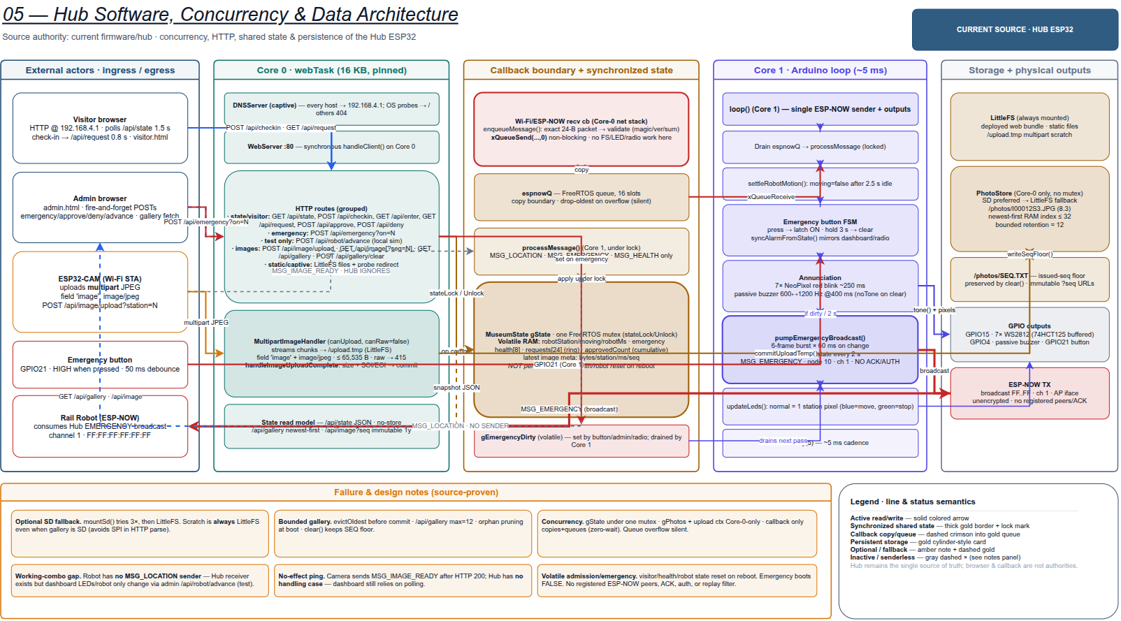
diagrams/05_hub_software_concurrency_data_architecture.png
