ZAN-Tech-bd/WRO_Rizwanul-Rafeeul-Luban/diagrams/06_robot_states.png

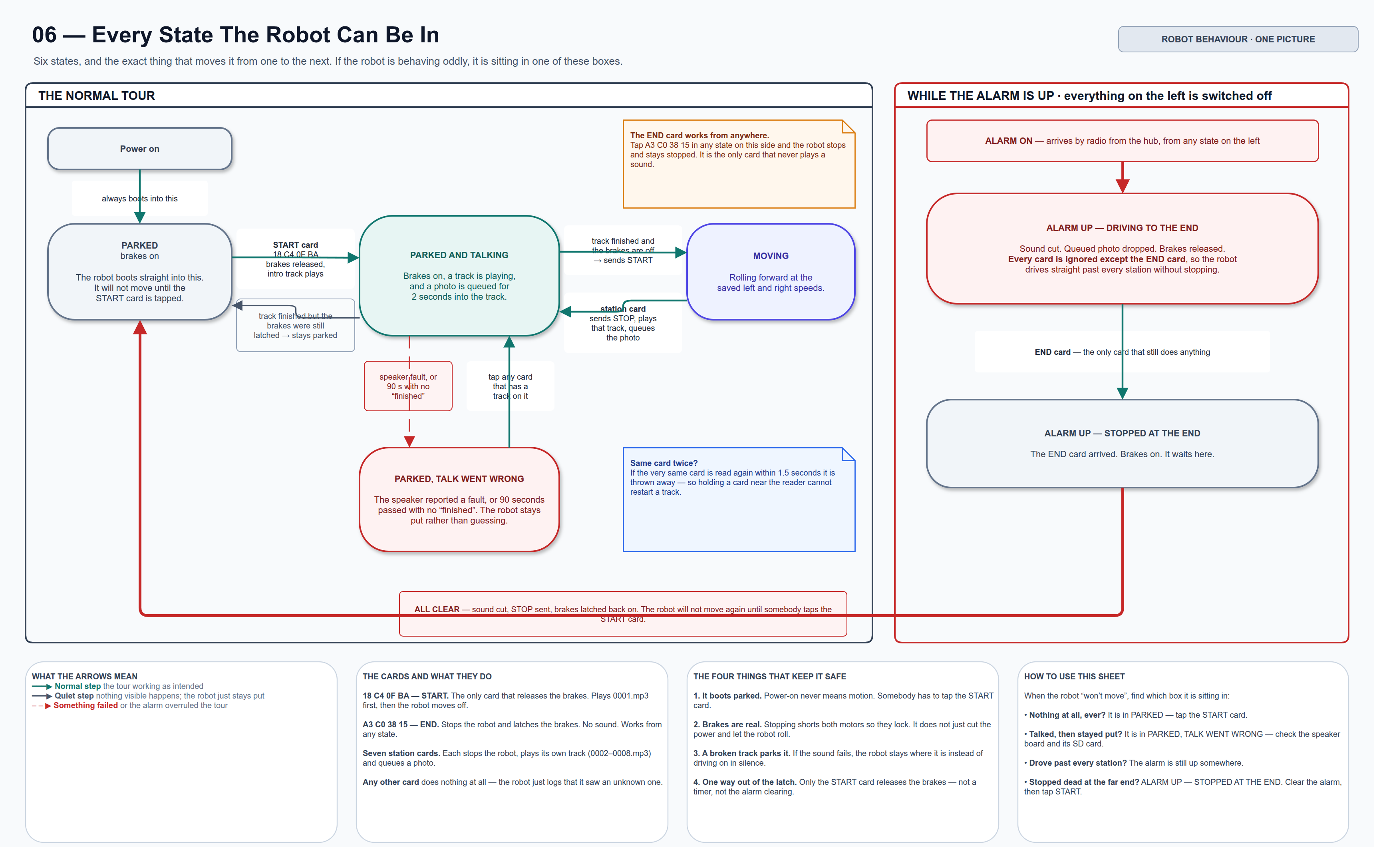
diagrams/06_robot_states.png
