ZAN-Tech-bd/WRO_Rizwanul-Rafeeul-Luban/diagrams/07_photo_pipeline.png

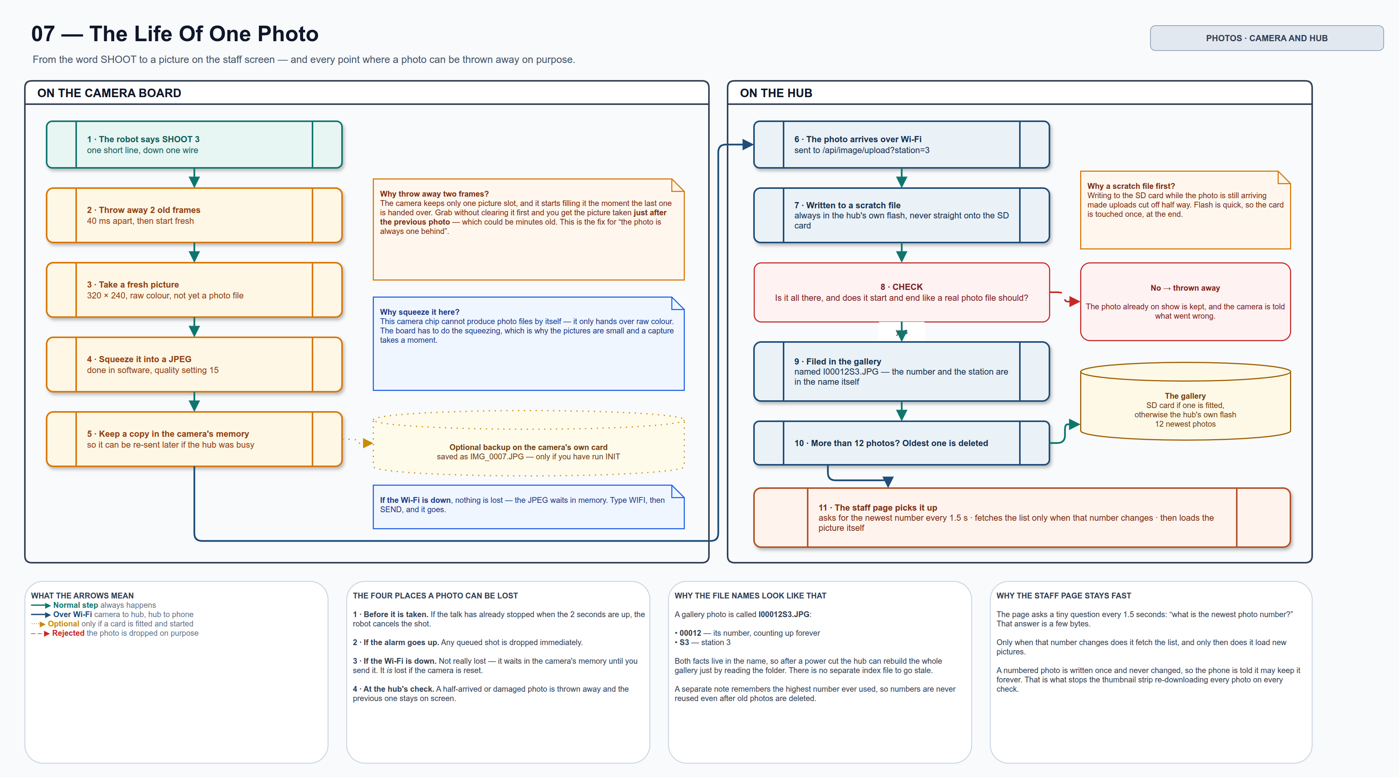
diagrams/07_photo_pipeline.png
