ZAN-Tech-bd/WRO_Rizwanul-Rafeeul-Luban/diagrams/08_hub_two_jobs.png

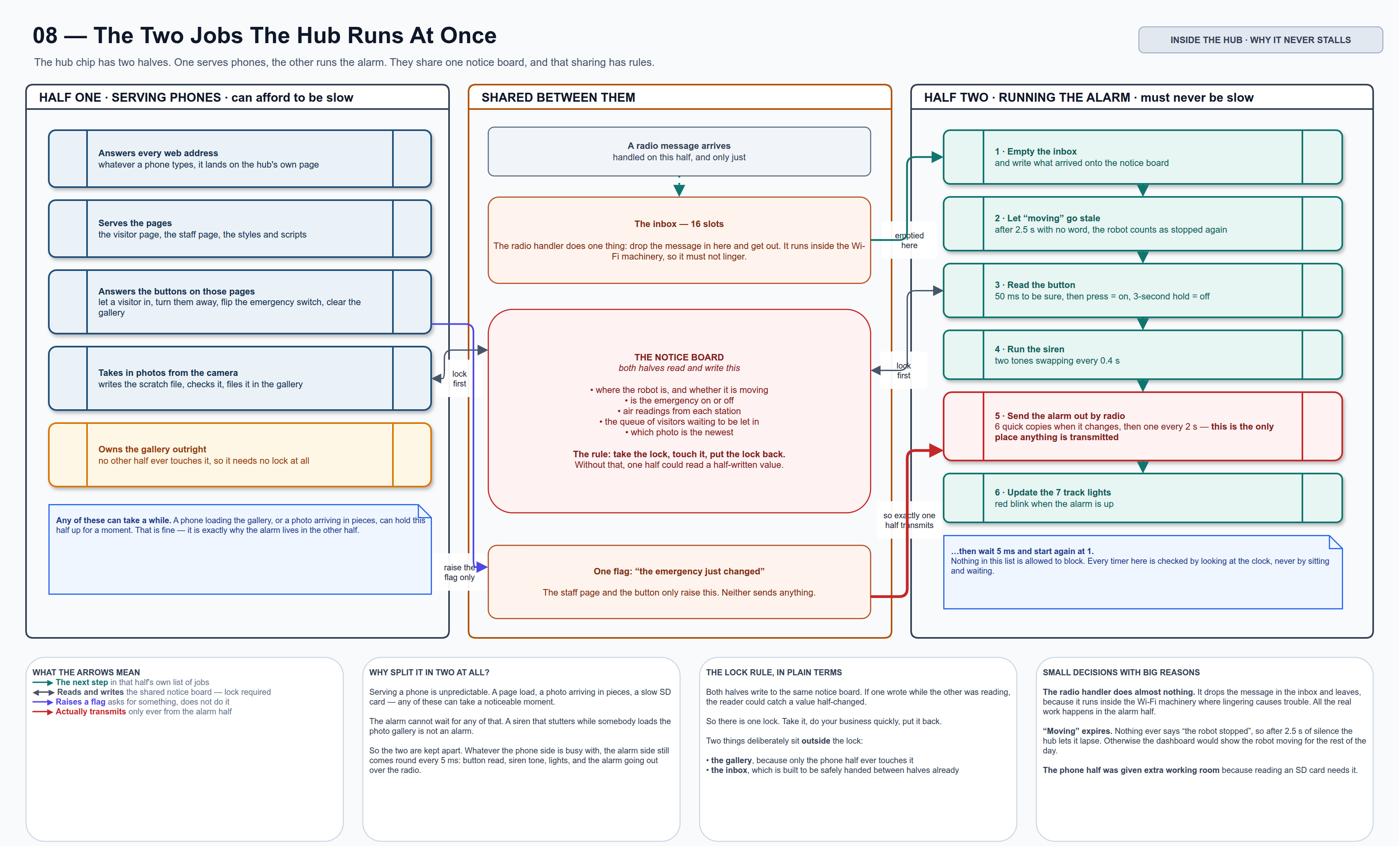
diagrams/08_hub_two_jobs.png
