ZAN-Tech-bd/WRO_Rizwanul-Rafeeul-Luban/diagrams/09_message_reference.png

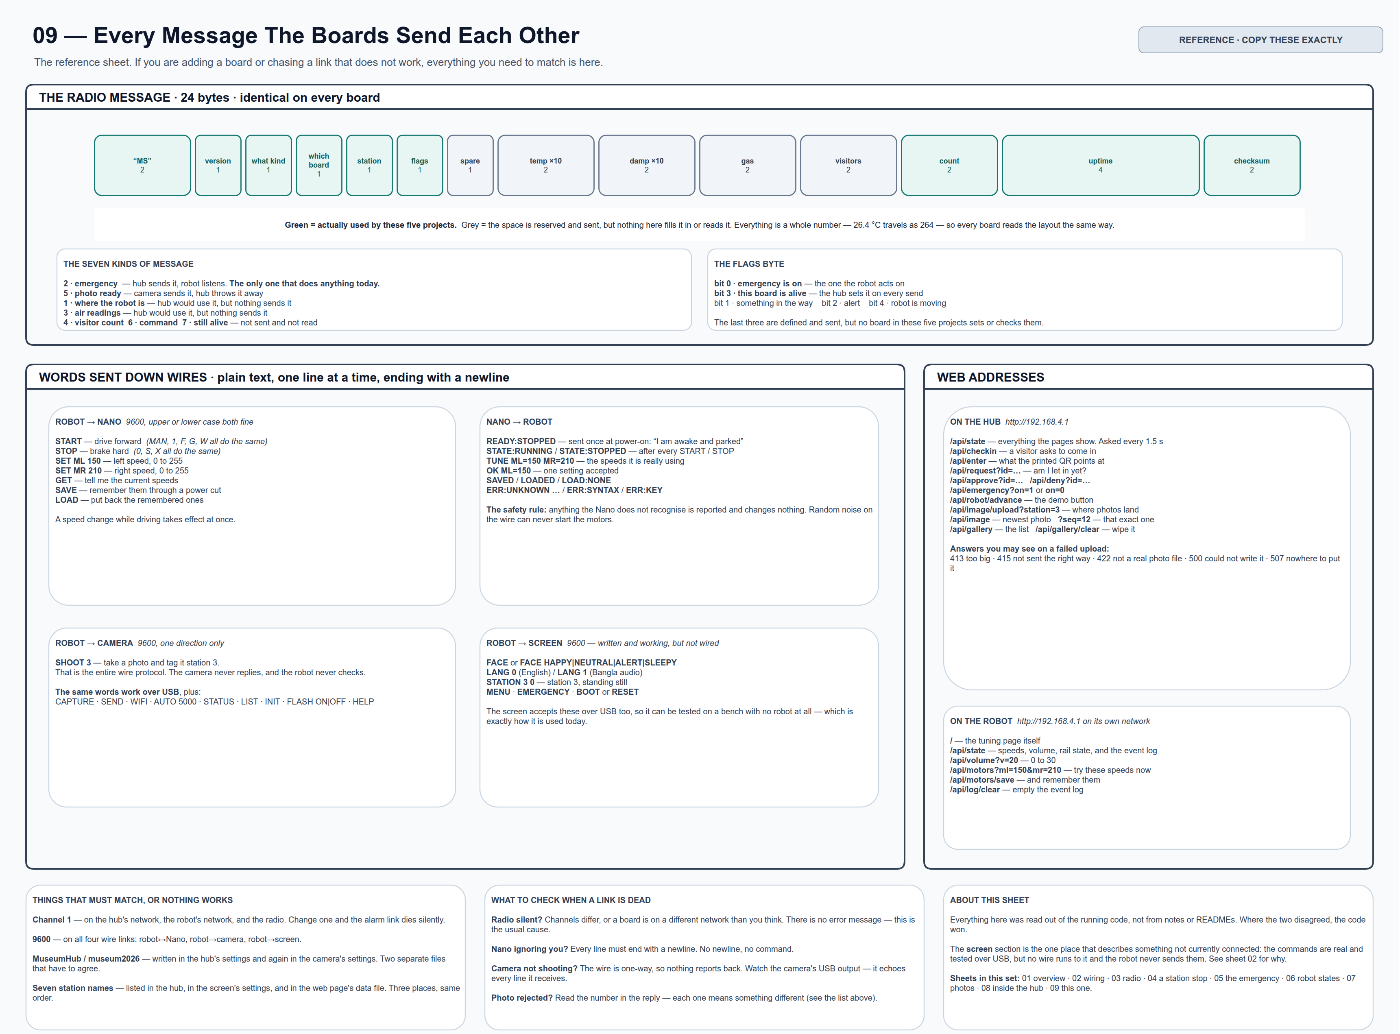
diagrams/09_message_reference.png
