ZAN-Tech-bd/WRO_Rizwanul-Rafeeul-Luban/diagrams/sequence.png

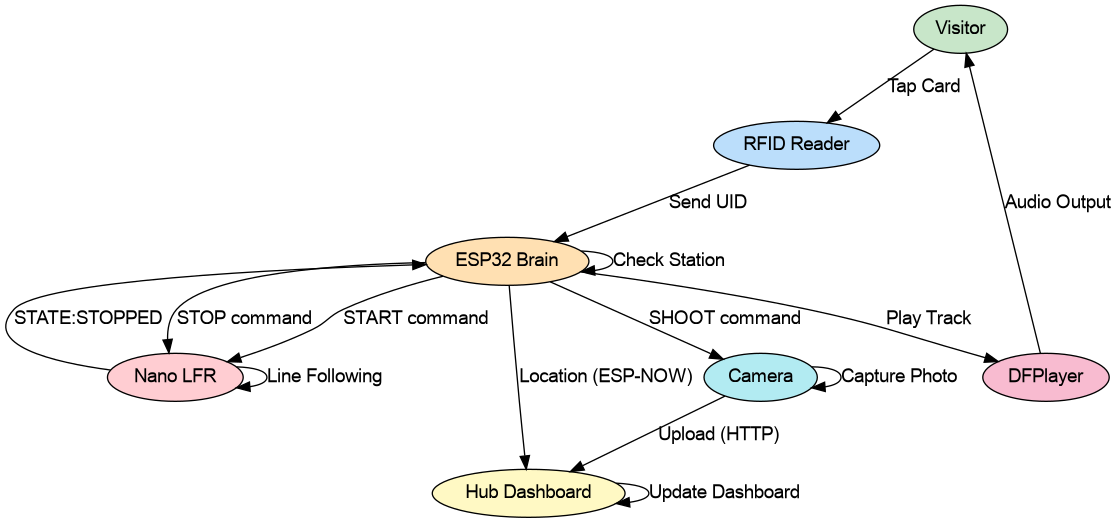
diagrams/sequence.png
