ZAN-Tech-bd/WRO_Rizwanul-Rafeeul-Luban/diagrams/system_architecture.png

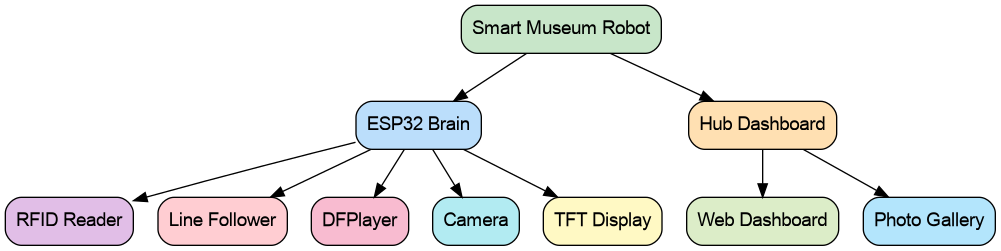
diagrams/system_architecture.png
