ZAN-Tech-bd/WRO_Rizwanul-Rafeeul-Luban/PCB design/hub/Switch_KCD4-203-B-dimension.jpg

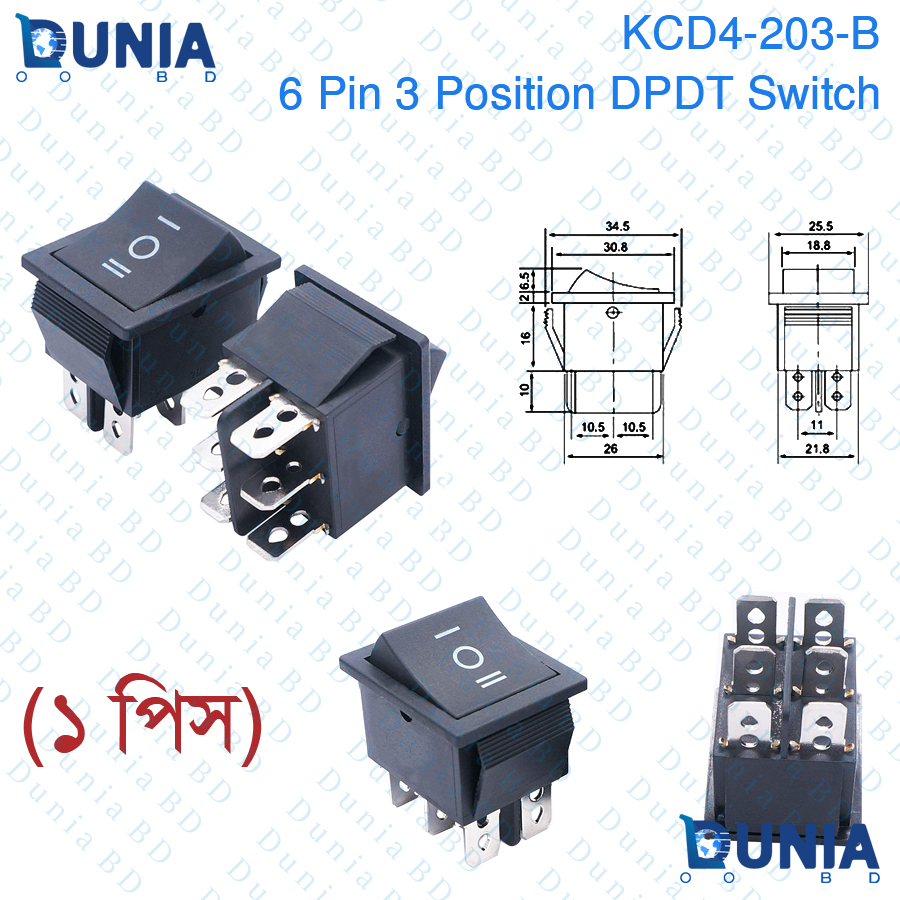
PCB design/hub/Switch_KCD4-203-B-dimension.jpg
