ZAN-Tech-bd/WRO_Rizwanul-Rafeeul-Luban/PCB design/hub/YD-ESP32-S3 N16R8_footprint.png

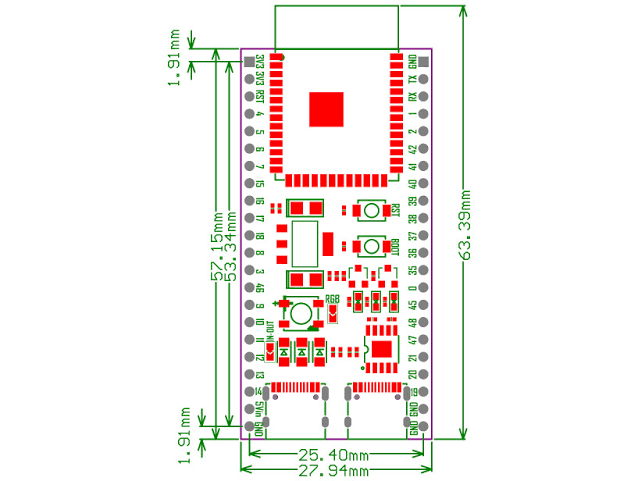
PCB design/hub/YD-ESP32-S3 N16R8_footprint.png
