ZAN-Tech-bd/WRO_Rizwanul-Rafeeul-Luban/PCB design/Robot/lm386_amplifier.jpg

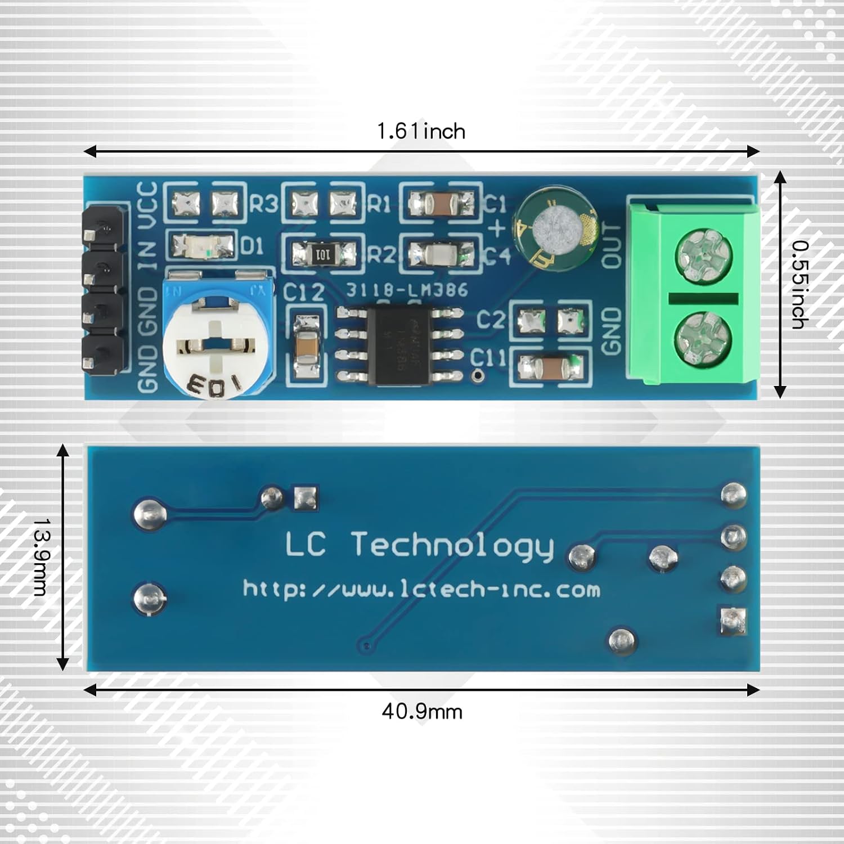
PCB design/Robot/lm386_amplifier.jpg
