ZAN-Tech-bd/WRO_Rizwanul-Rafeeul-Luban/PCB design/scripts/hub/data/final_review_20261027/ground_preview.png

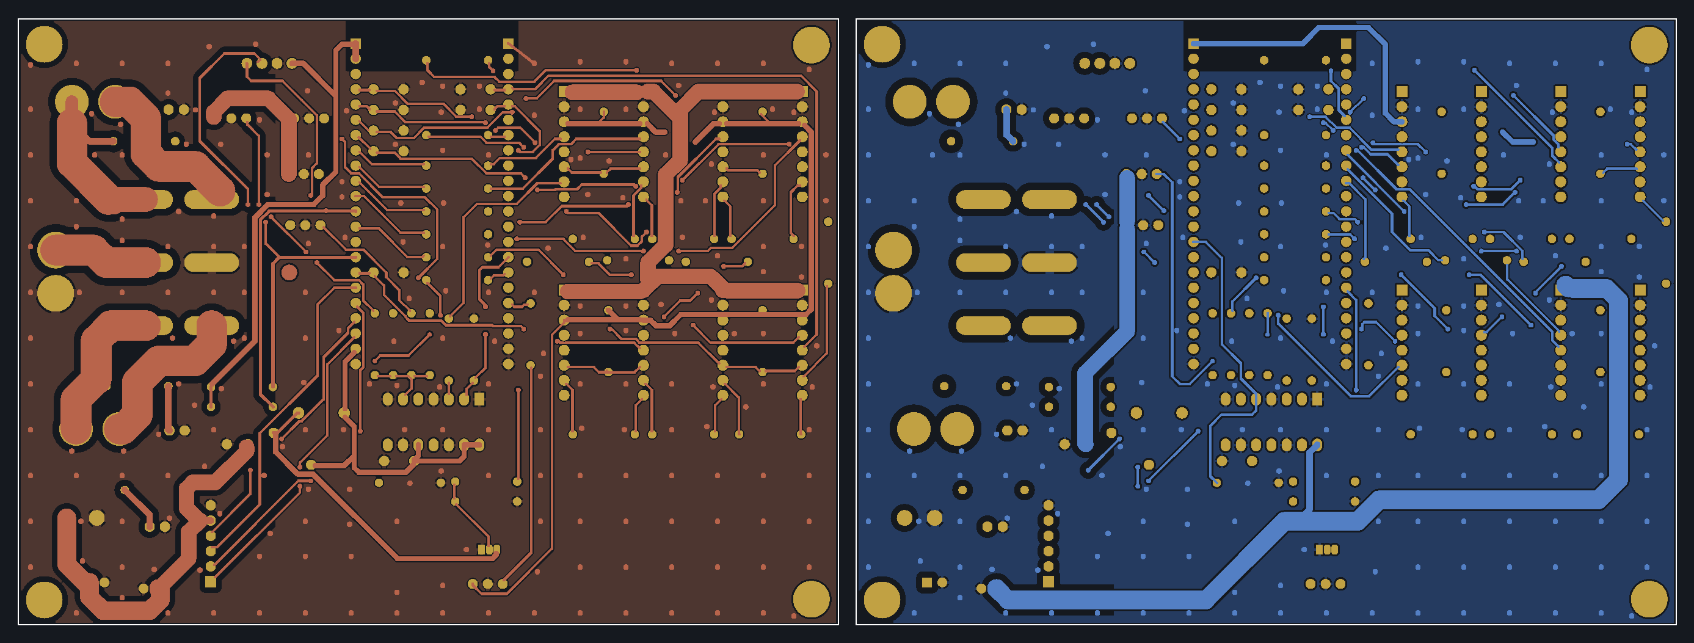
PCB design/scripts/hub/data/final_review_20261027/ground_preview.png
