ZAN-Tech-bd/WRO_Rizwanul-Rafeeul-Luban/PCB design/scripts/hub/data/layout_new.png

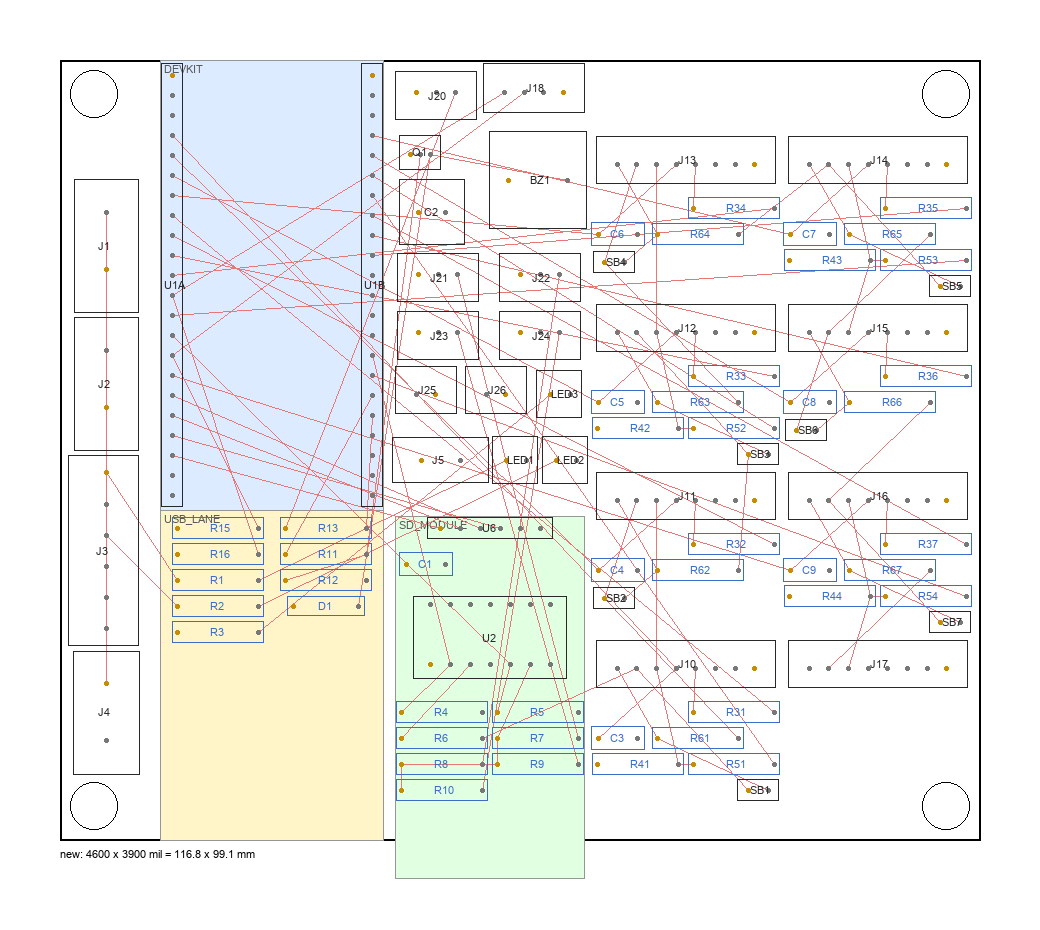
PCB design/scripts/hub/data/layout_new.png
