ZAN-Tech-bd/WRO_Rizwanul-Rafeeul-Luban/PCB design/scripts/hub/data/live_space_after_moves.png

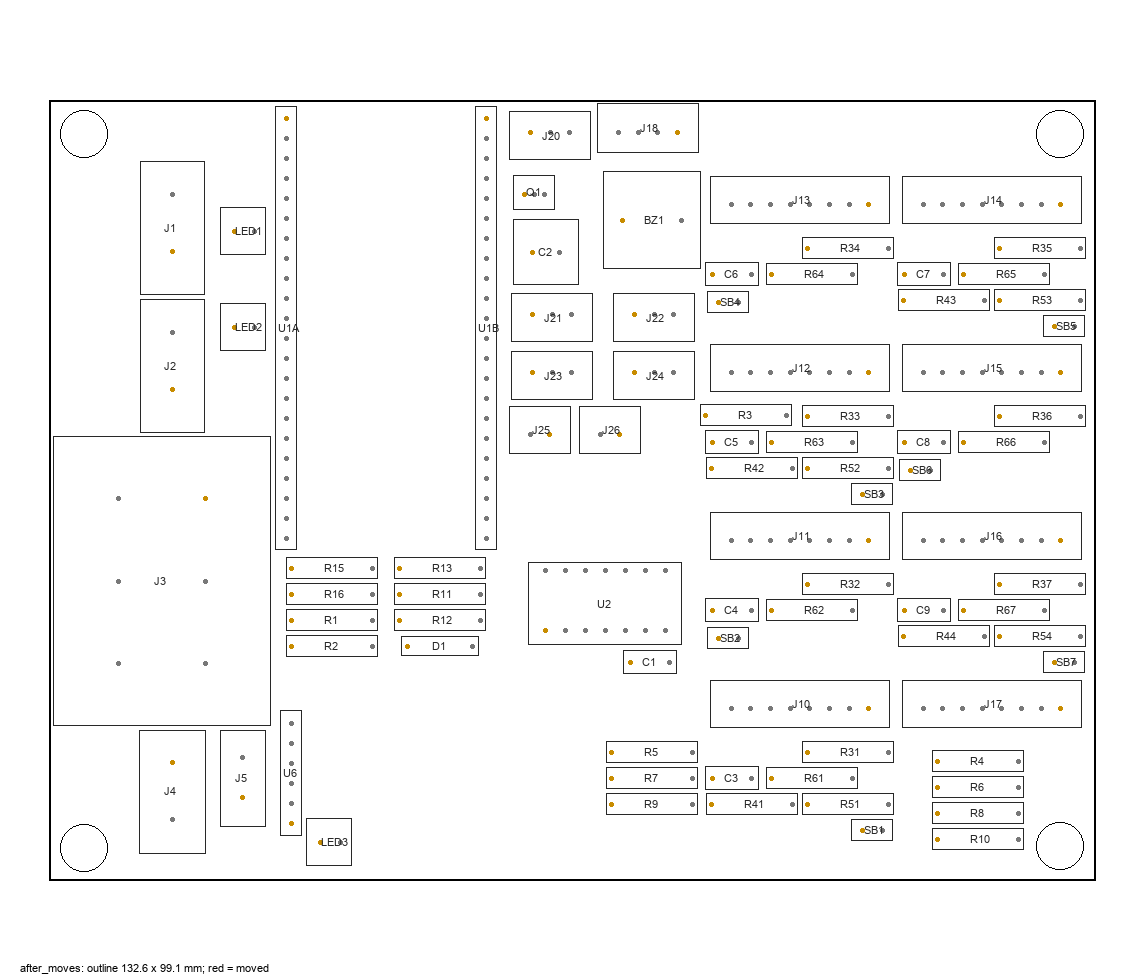
PCB design/scripts/hub/data/live_space_after_moves.png
