ZAN-Tech-bd/WRO_Rizwanul-Rafeeul-Luban/PCB design/scripts/hub/data/live_space_current.png

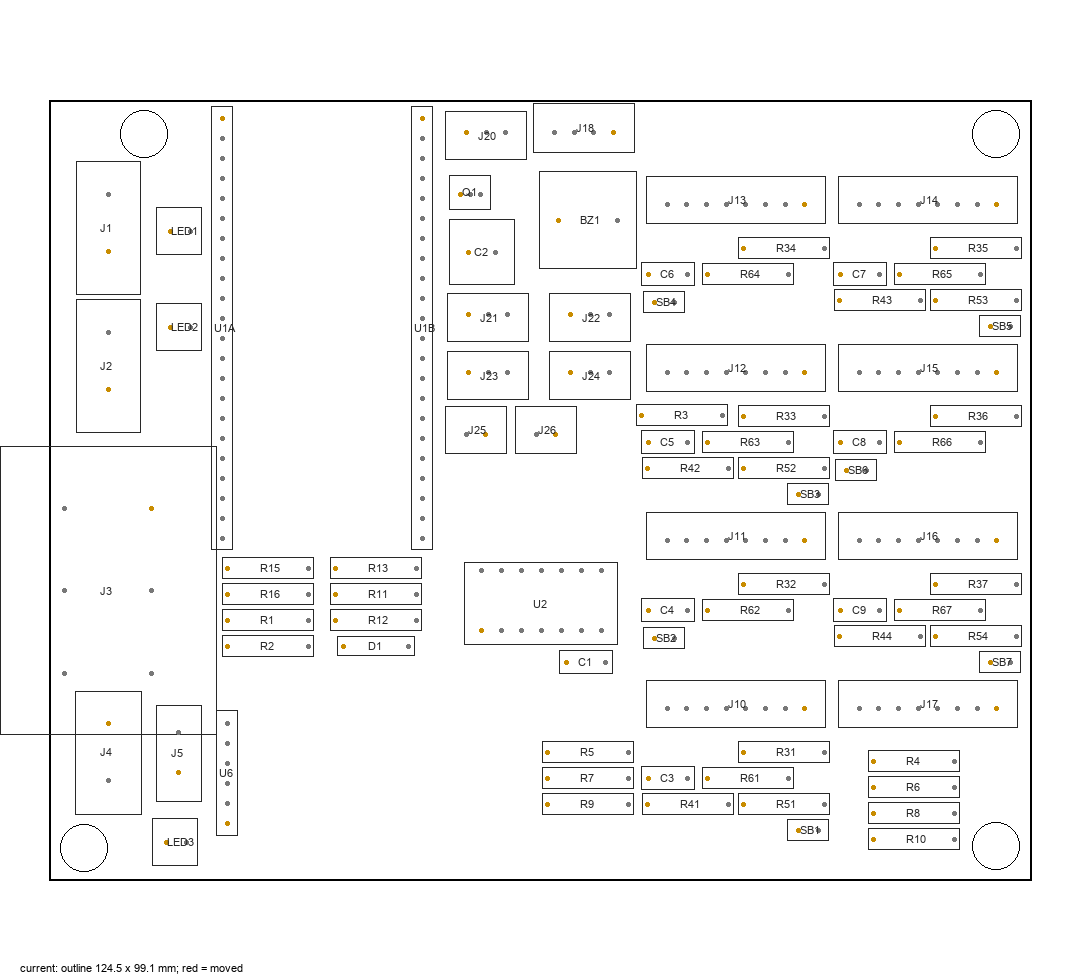
PCB design/scripts/hub/data/live_space_current.png
