ZAN-Tech-bd/WRO_Rizwanul-Rafeeul-Luban/PCB design/scripts/hub/route/data/fill_preview.png

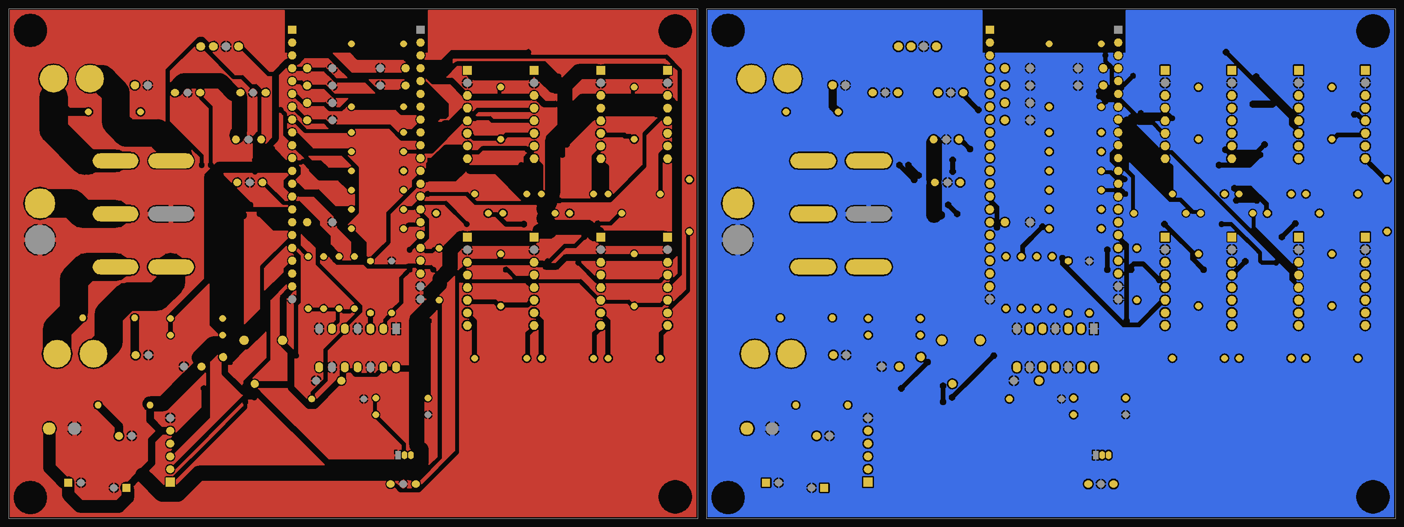
PCB design/scripts/hub/route/data/fill_preview.png
