ZAN-Tech-bd/WRO_Rizwanul-Rafeeul-Luban/PCB design/scripts/hub/route/data/route_bot_labeled.png

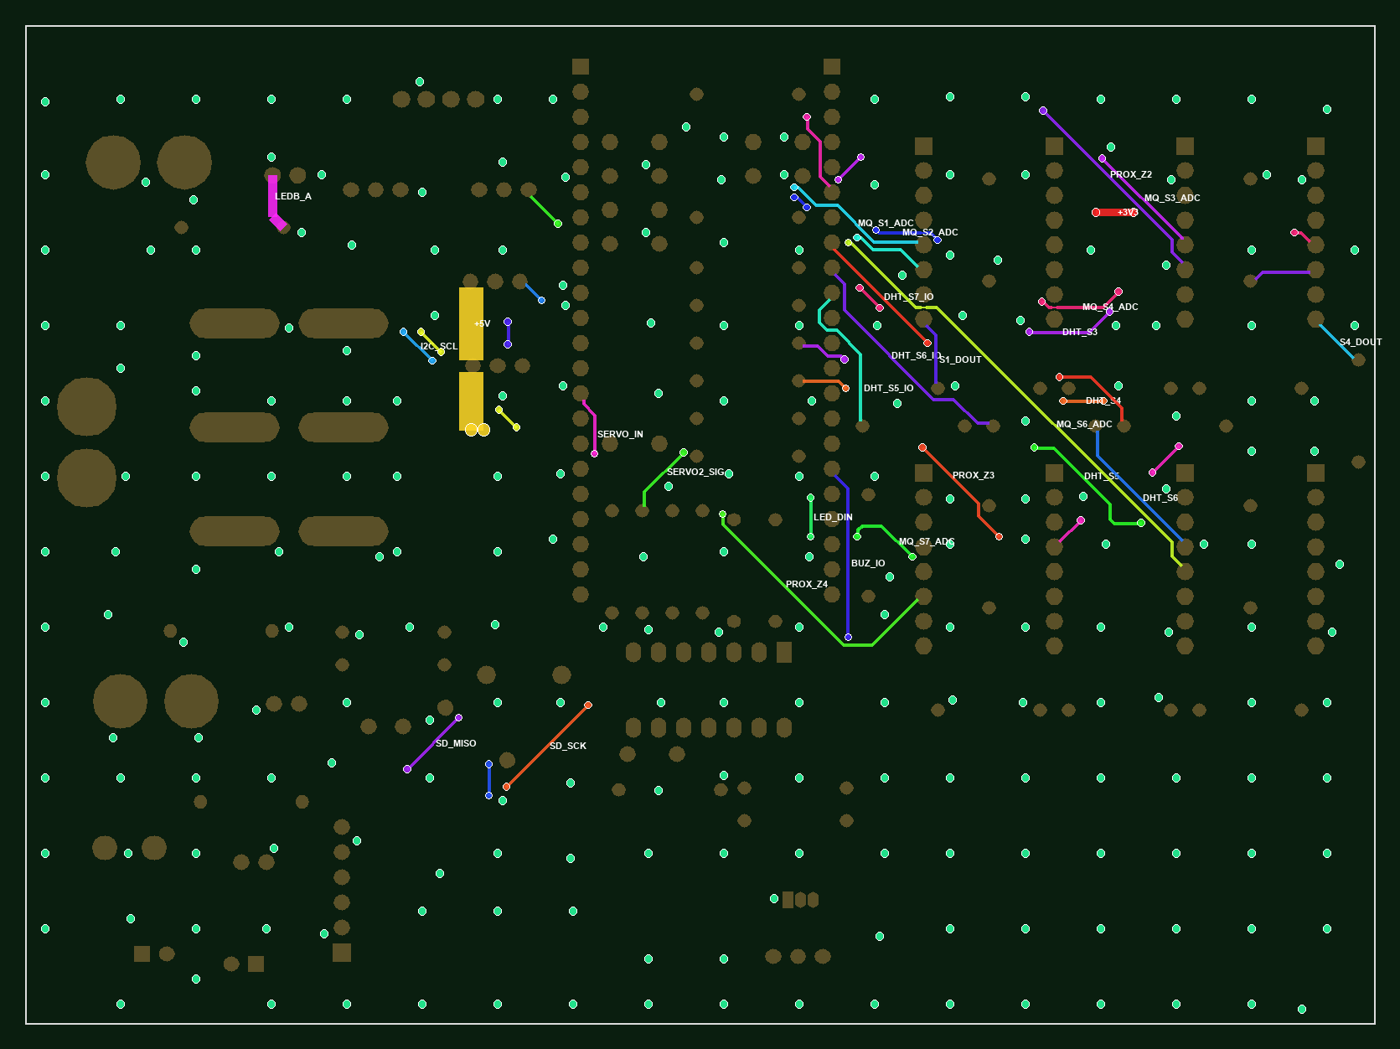
PCB design/scripts/hub/route/data/route_bot_labeled.png
