ZAN-Tech-bd/WRO_Rizwanul-Rafeeul-Luban/PCB design/scripts/hub/route/data/route_top_labeled.png

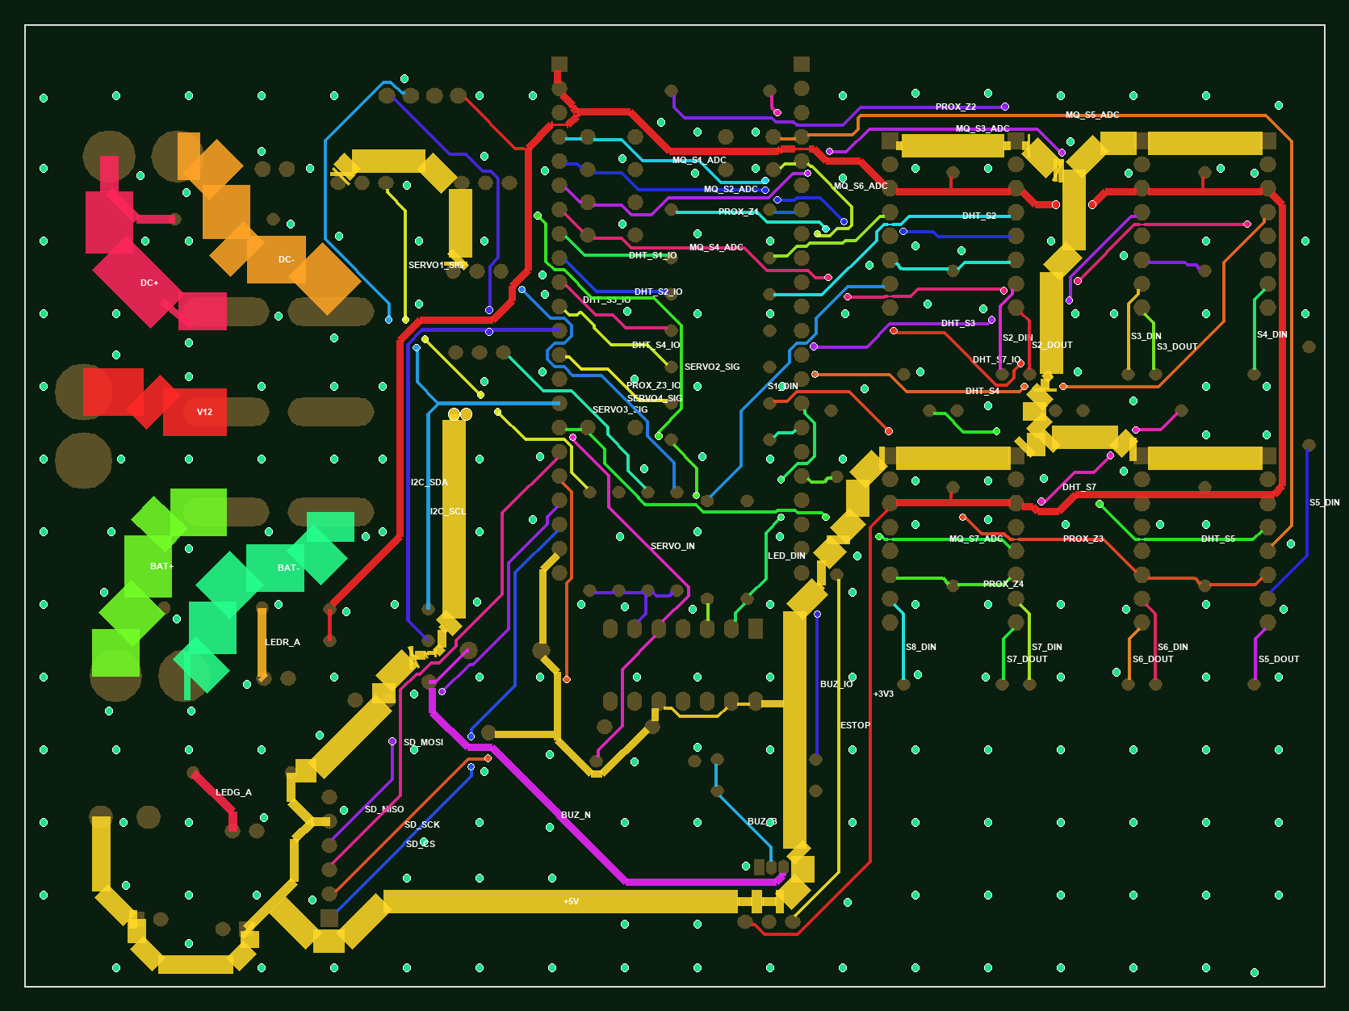
PCB design/scripts/hub/route/data/route_top_labeled.png
