ZAN-Tech-bd/WRO_Rizwanul-Rafeeul-Luban/PCB design/scripts/hub/route/data/user_copper.png

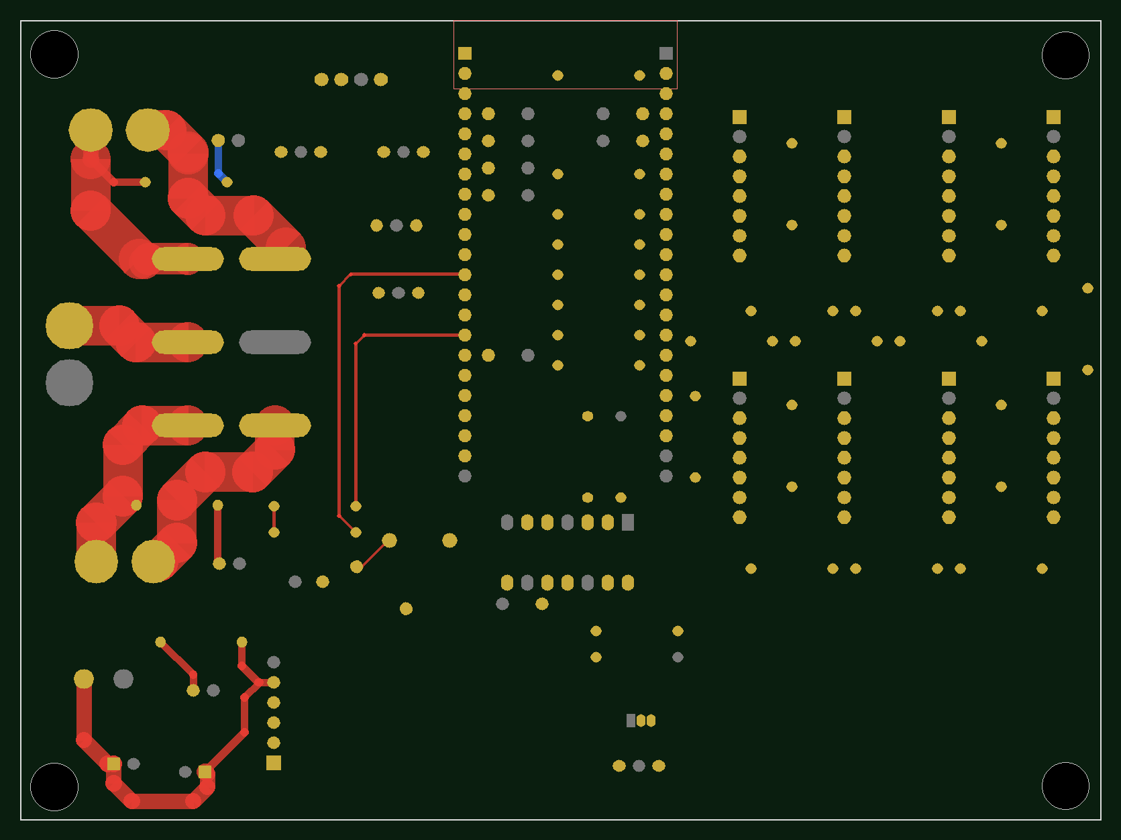
PCB design/scripts/hub/route/data/user_copper.png
