ZAN-Tech-bd/WRO_Rizwanul-Rafeeul-Luban/PCB design/scripts/robot/data/crop_right.png

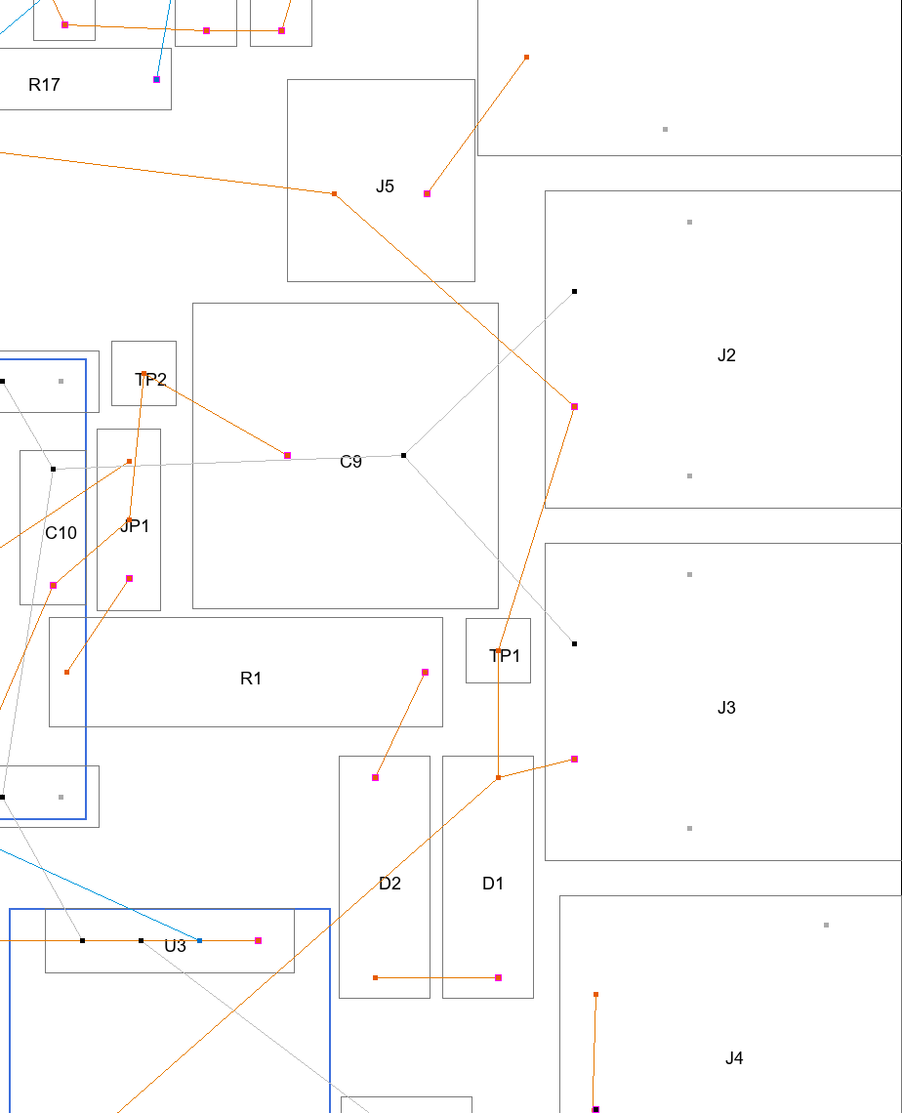
PCB design/scripts/robot/data/crop_right.png
