ZAN-Tech-bd/WRO_Rizwanul-Rafeeul-Luban/PCB design/scripts/robot/data/fill_preview.png

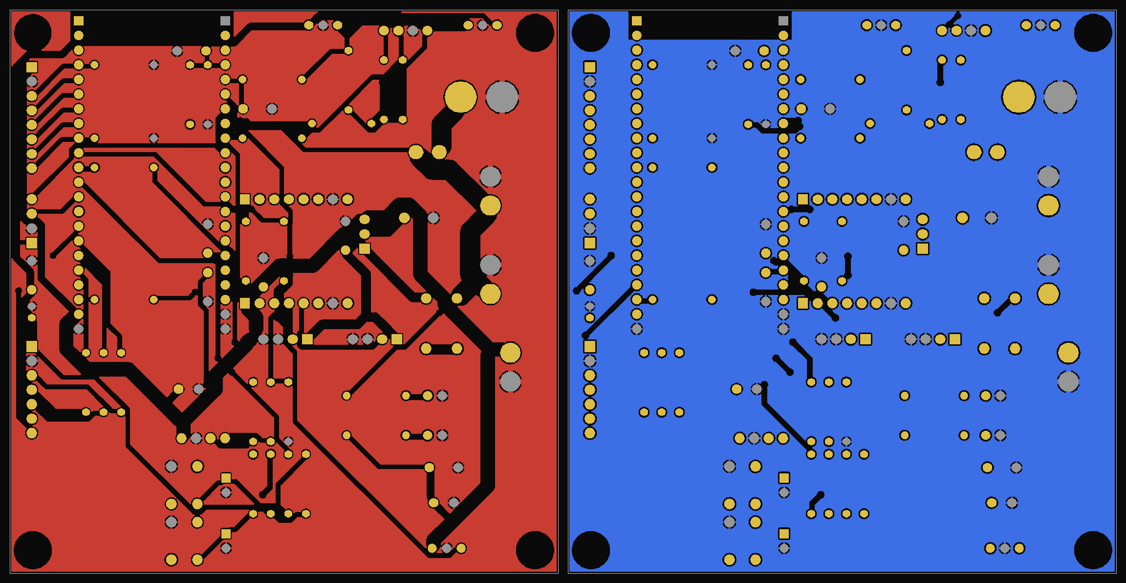
PCB design/scripts/robot/data/fill_preview.png
