ZAN-Tech-bd/WRO_Rizwanul-Rafeeul-Luban/PCB design/scripts/robot/data/layout_v06_cur.png

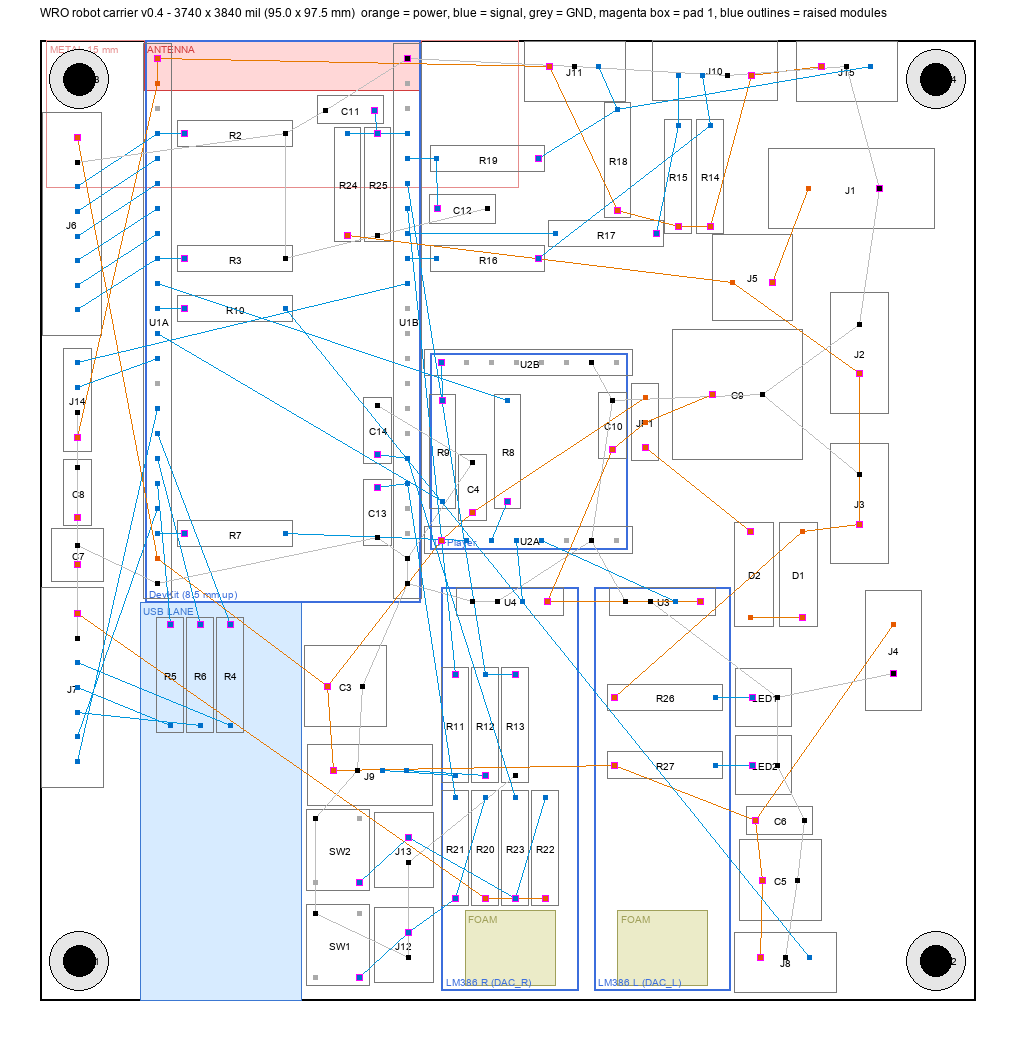
PCB design/scripts/robot/data/layout_v06_cur.png
