ZAN-Tech-bd/WRO_Rizwanul-Rafeeul-Luban/PCB design/scripts/robot/data/route_preview.png

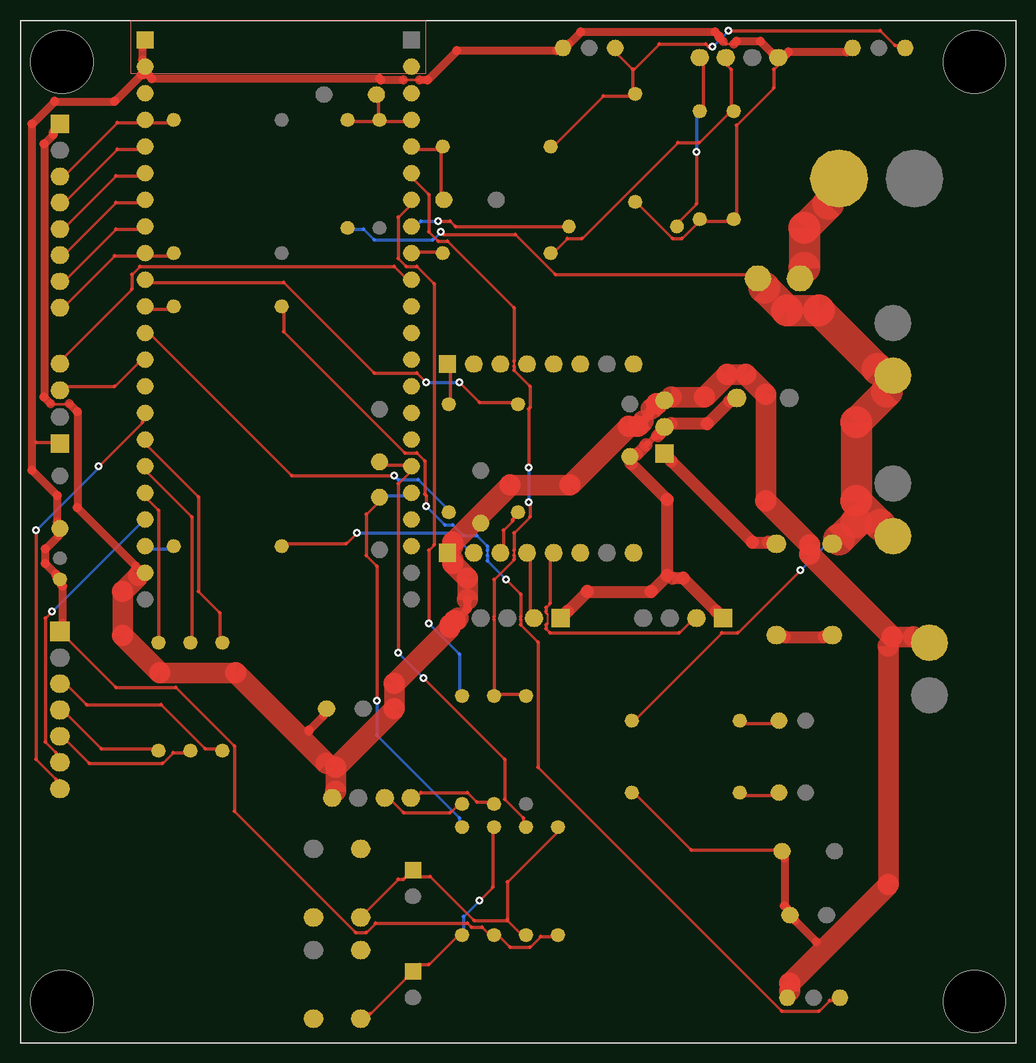
PCB design/scripts/robot/data/route_preview.png
