ZAN-Tech-bd/WRO_Rizwanul-Rafeeul-Luban/PCB design/scripts/robot/data/route_top_labeled.png

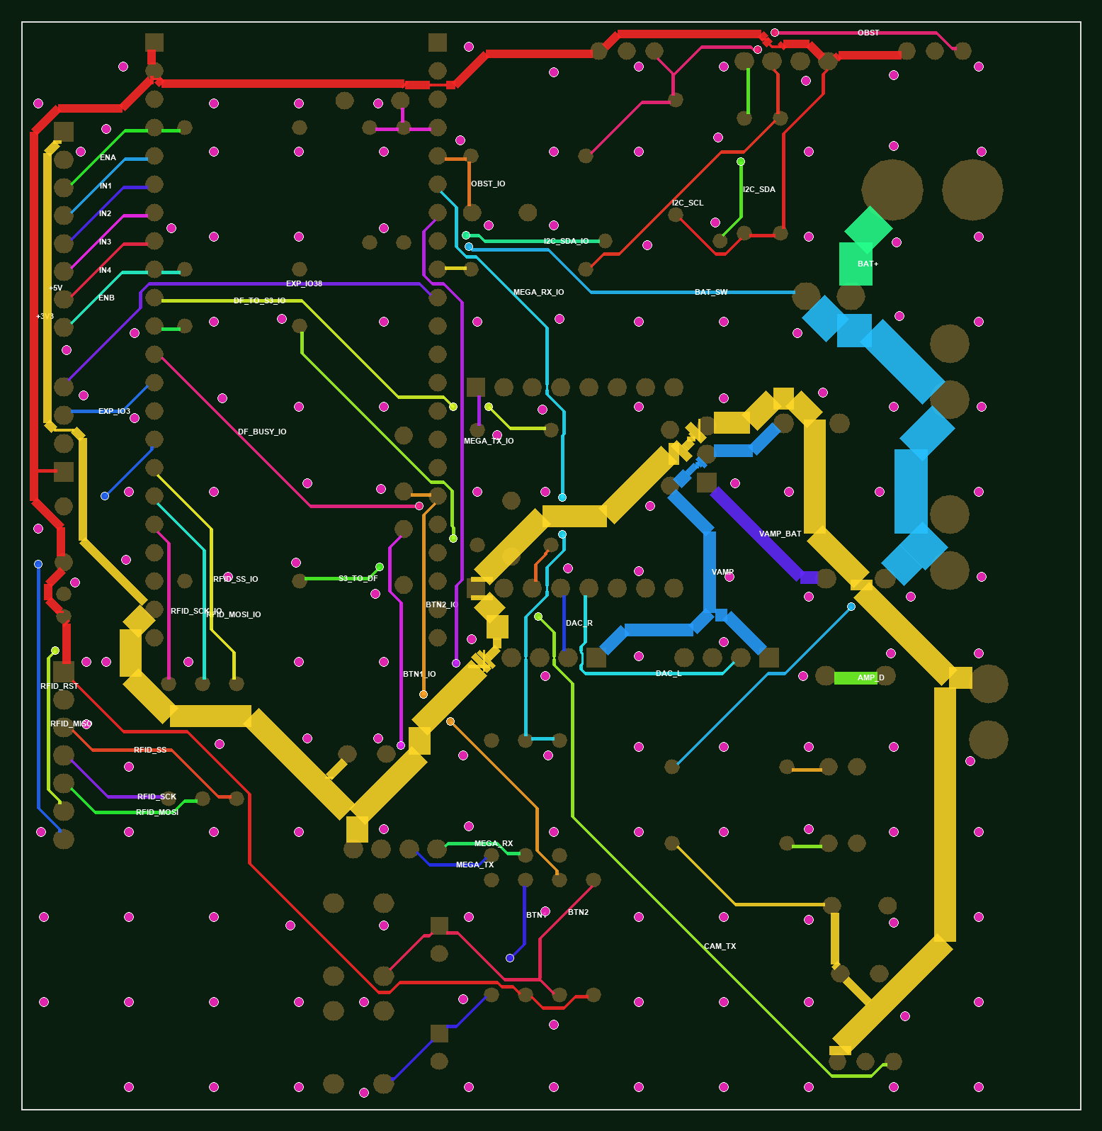
PCB design/scripts/robot/data/route_top_labeled.png
