ZAN-Tech-bd/WRO_Rizwanul-Rafeeul-Luban/PCB design/scripts/robot/data/silk_preview.png

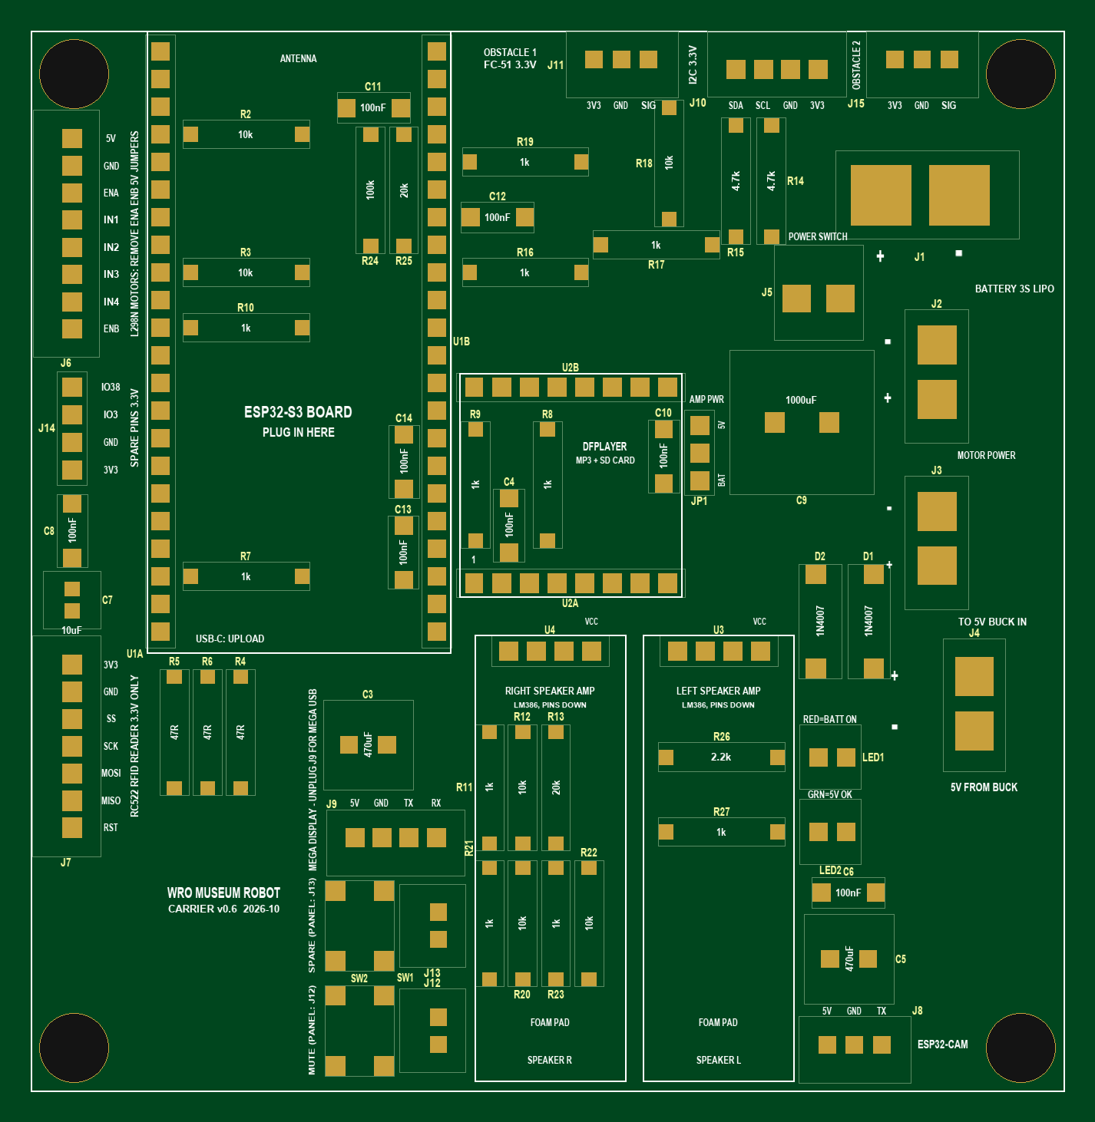
PCB design/scripts/robot/data/silk_preview.png
