ZAN-Tech-bd/WRO_Rizwanul-Rafeeul-Luban/PCB design/scripts/station/data/layout_preview.png

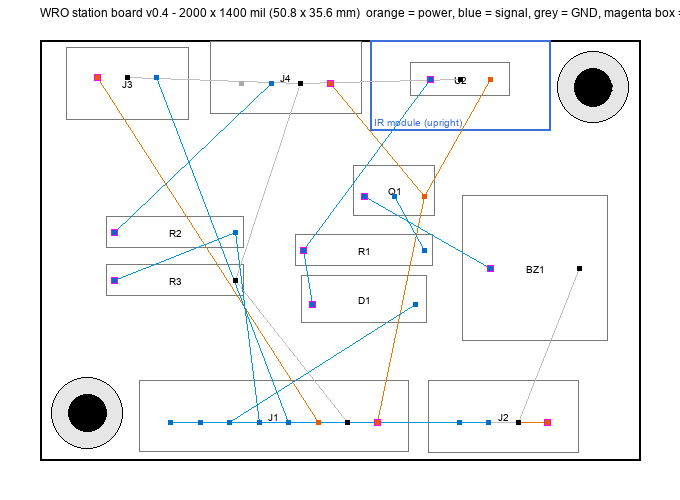
PCB design/scripts/station/data/layout_preview.png
