ZAN-Tech-bd/WRO_Rizwanul-Rafeeul-Luban/PCB design/scripts/station/data/route_preview.png

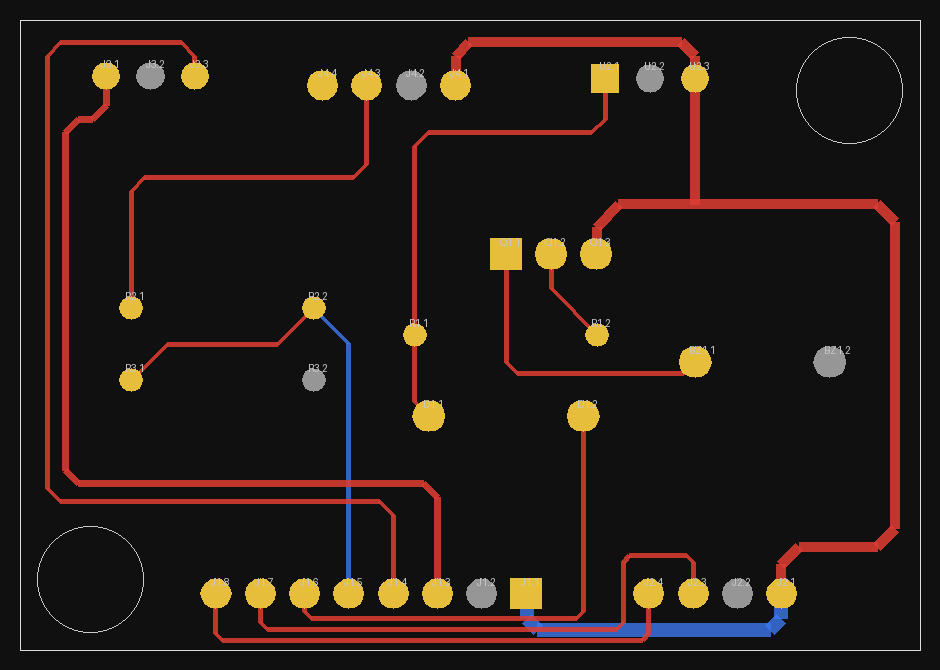
PCB design/scripts/station/data/route_preview.png
