ZAN-Tech-bd/WRO_Rizwanul-Rafeeul-Luban/exports/WRO_HUB_ORDER_BOM_20261027.csv

No. | Quantity | Comment | Designator | Footprint | Value | Manufacturer Part | Manufacturer | Supplier Part | Supplier
1 | 1 | buzzer-12X9 | BZ1 | BUZ-TH_BD12.0-P7.60-D0.6-FD |  | buzzer-12X9 |  | C9900016920 | LCSC
2 | 8 | 100nF | C1,C3,C4,C5,C6,C7,C8,C9 | CAP-TH_L4.0-W2.5-P5.00-D1.0 | 100nF | FG28X7R1H104KNT06 | TDK | C342794 | LCSC
3 | 1 | 470uF | C2 | CAP-TH_BD8.0-P3.50-D0.6-FD | 470uF | 16ZLH470MEFC8X11.5 | Rubycon(红宝石) | C109066 | LCSC
4 | 1 | 1N4148TR | D1 | DO-35_BD2.0-L4.2-P8.20-D0.5-RD |  | 1N4148TR | VISHAY(威世) | C84412 | LCSC
5 | 2 | XT60UPB-M | J1,J2 | CONN-TH_XT60UPB-M |  | XT60UPB-M |  | C2918078 | LCSC
6 | 1 | KCD4-203-B | J3 | CONN-TH-6P-P3.96_B6P-VH-BL-LF-SN |  | KCD4-203-B | User-supplied | Not applicable | User-supplied
7 | 1 | XT60UPB-F | J4 | CONN-TH_XT60UPB-F |  | XT60UPB-F |  | C9900007500 | LCSC
8 | 1 | XT30UPB-M | J5 | CONN-TH_XT30UPB-M |  | XT30UPB-M | AMASS(艾迈斯) | C428721 | LCSC
9 | 8 | B8B-XH-A(LF)(SN) | J10,J11,J12,J13,J14,J15,J16,J17 | CONN-TH_B8B-XH-A-LF-SN |  | B8B-XH-A(LF)(SN) | JST | C157972 | LCSC
10 | 1 | B4B-XH-A(LF)(SN) | J18 | CONN-TH_B4B-XH-A-LF-SN |  | B4B-XH-A(LF)(SN) | JST | C144395 | LCSC
11 | 5 | B3B-XH-A(LF)(SN) | J20,J21,J22,J23,J24 | CONN-TH_3P-P2.50_A2501WV2-3P |  | B3B-XH-A(LF)(SN) | JST | C144394 | LCSC
12 | 2 | B2B-XH-A-BK(LF)(SN) | J25,J26 | CONN-TH_2P-P2.50_JST_B2B-XH-A-M |  | B2B-XH-A-BK(LF)(SN) | JST | C378939 | LCSC
13 | 3 | 5MM LED W-BLUE | LED1,LED2,LED3 | LED-TH_BD5.6-P2.54-FD |  | 5MM LED W-BLUE |  | C9900102778 | LCSC
14 | 1 | SS8050-TO-92 | Q1 | TO-92-3_L5.1-W4.1-P1.27-L-1 |  | SS8050-TO-92 | DDF(鼎德丰) | C50229519 | LCSC
15 | 2 | 2.2kΩ | R1,R2 | RES-TH_BD2.4-L6.3-P10.30-D0.6 | 2.2kΩ | MFR-25FBF52-2K2 | YAGEO(国巨) | C3454390 | LCSC
16 | 14 | 1kΩ | R3,R11,R13,R31,R32,R33,R34,R35,R36,R37,R51,R52,R53,R54 | RES-TH_BD2.4-L6.3-P10.30-D0.6 | 1kΩ | MFR-25FBF52-1K | YAGEO(国巨) | C1364484 | LCSC
17 | 7 | 10kΩ | R4,R5,R12,R41,R42,R43,R44 | RES-TH_BD2.4-L6.3-P10.30-D0.6 | 10kΩ | MFR-25FBF52-10K | YAGEO(国巨) | C1519255 | LCSC
18 | 1 | 330Ω | R6 | RES-TH_BD2.4-L6.3-P10.30-D0.6 | 330Ω | MFR-25FBF52-330R | YAGEO(国巨) | C1369900 | LCSC
19 | 11 | 220Ω | R7,R8,R9,R10,R61,R62,R63,R64,R65,R66,R67 | RES-TH_BD2.4-L6.3-P10.30-D0.6 | 220Ω | MFR-25FBF52-220R | YAGEO(国巨) | C3537012 | LCSC
20 | 2 | 4.7kΩ | R15,R16 | RES-TH_BD2.4-L6.3-P10.30-D0.6 | 4.7kΩ | MFR-25FBF52-4K7 | YAGEO(国巨) | C1371435 | LCSC
21 | 2 | PM254V-11-22-H85 | U1A,U1B | HDR-TH_22P-P2.54-V-F |  | PM254V-11-22-H85 | XFCN(兴飞) | C46595983 | LCSC
22 | 1 | SN74HCT125N | U2 | PDIP-14_L19.3-W6.4-P2.54-LS7.6-BL |  | SN74HCT125N | TI(德州仪器) | C154102 | LCSC
23 | 1 | PM254V-11-06-H85 | U6 | HDR-TH_6P-P2.54-V-F |  | PM254V-11-06-H85 | XFCN(兴飞) | C2832269 | LCSC
