ZAN-Tech-bd/WRO_Rizwanul-Rafeeul-Luban/PCB design/Robot/fabrication/20261028-final/WRO_ROBOT_RAW_BOM_20261028.csv

No. | Quantity | Comment | Designator | Footprint | Value | Manufacturer Part | Manufacturer | Supplier Part | Supplier
1 | 2 | 470uF | C3,C5 | CAP-TH_BD8.0-P3.50-D0.6-FD | 470uF | 16ZLH470MEFC8X11.5 | Rubycon(红宝石) | C109066 | LCSC
2 | 8 | 100nF | C4,C6,C8,C10,C11,C12,C13,C14 | CAP-TH_L4.0-W2.5-P5.00-D1.0 | 100nF | FG28X7R1H104KNT06 | TDK | C342794 | LCSC
3 | 1 | 10uF | C7 | CAP-TH_BD5.0-P2.00-D0.8-FD | 10uF | 01EC1809SHC10UF50V | KNSCHA(科尼盛) | C503219 | LCSC
4 | 1 | 1000uF | C9 | CAP-TH_BD13.0-P5.00-D0.6-FD | 1000uF | 35V1000uF CD110 | HRK(鸿瑞凯电子) | C2960416 | LCSC
5 | 2 | 1N4007-T | D1,D2 | DO-41_BD2.4-L4.7-P8.70-D0.9-RD |  | 1N4007-T | DIODES(美台) | C108355 | LCSC
6 | 1 | XT60UPB-M | J1 | CONN-TH_XT60UPB-M |  | XT60UPB-M |  | C2918078 | LCSC
7 | 2 | XT30UPB-F30.G.Y | J2,J3 | CONN-TH_XT30UPB-F |  | XT30UPB-F30.G.Y | AMASS(艾迈斯) | C108769 | LCSC
8 | 1 | XT30UPB-M | J4 | CONN-TH_XT30UPB-M |  | XT30UPB-M | AMASS(艾迈斯) | C428721 | LCSC
9 | 1 | B2P-VH（SMT临时启用） | J5 | CONN-TH_P3.96_B2P-VH |  | B2P-VH（SMT临时启用） | JST | C485345 | LCSC
10 | 1 | B8B-XH-A(LF)(SN) | J6 | CONN-TH_B8B-XH-A-LF-SN |  | B8B-XH-A(LF)(SN) | JST | C157972 | LCSC
11 | 1 | B7B-XH-A(LF)(SN) | J7 | CONN-TH_7P-P2.50_B7B-XH-A-LF-SN |  | B7B-XH-A(LF)(SN) | JST | C144398 | LCSC
12 | 3 | B3B-XH-A(LF)(SN) | J8,J11,J15 | CONN-TH_3P-P2.50_A2501WV2-3P |  | B3B-XH-A(LF)(SN) | JST | C144394 | LCSC
13 | 2 | B4B-XH-A(LF)(SN) | J9,J10 | CONN-TH_B4B-XH-A-LF-SN |  | B4B-XH-A(LF)(SN) | JST | C144395 | LCSC
14 | 2 | B2B-XH-A-BK(LF)(SN) | J12,J13 | CONN-TH_2P-P2.50_JST_B2B-XH-A-M |  | B2B-XH-A-BK(LF)(SN) | JST | C378939 | LCSC
15 | 1 | PZ254V-11-03P | JP1 | HDR-TH_3P-P2.54-V-M |  | PZ254V-11-03P | XFCN(兴飞) | C492402 | LCSC
16 | 2 | 5MM LED W-BLUE | LED1,LED2 | LED-TH_BD5.6-P2.54-FD |  | 5MM LED W-BLUE |  | C9900102778 | LCSC
17 | 6 | 10kΩ | R2,R3,R12,R18,R20,R22 | RES-TH_BD2.4-L6.3-P10.30-D0.6 | 10kΩ | MFR-25FBF52-10K | YAGEO(国巨) | C1519255 | LCSC
18 | 3 | 47Ω | R4,R5,R6 | RES-TH_BD2.4-L6.3-P10.30-D0.6 | 47Ω | MFR-25FBF52-47R | YAGEO(国巨) | C3402507 | LCSC
19 | 11 | 1kΩ | R7,R8,R9,R10,R11,R16,R17,R19,R21,R23,R27 | RES-TH_BD2.4-L6.3-P10.30-D0.6 | 1kΩ | MFR-25FBF52-1K | YAGEO(国巨) | C1364484 | LCSC
20 | 2 | 20kΩ | R13,R25 | RES-TH_BD2.4-L6.3-P10.30-D0.6 | 20kΩ | MFR-25FBF52-20K | YAGEO(国巨) | C1364283 | LCSC
21 | 2 | 4.7kΩ | R14,R15 | RES-TH_BD2.4-L6.3-P10.30-D0.6 | 4.7kΩ | MFR-25FBF52-4K7 | YAGEO(国巨) | C1371435 | LCSC
22 | 1 | 100kΩ | R24 | RES-TH_BD2.4-L6.3-P10.30-D0.6 | 100kΩ | MFR-25FBF52-100K | YAGEO(国巨) | C1364475 | LCSC
23 | 1 | 2.2kΩ | R26 | RES-TH_BD2.4-L6.3-P10.30-D0.6 | 2.2kΩ | MFR-25FBF52-2K2 | YAGEO(国巨) | C3454390 | LCSC
24 | 2 | K2-1102DP-J4SW-04 | SW1,SW2 | KEY-TH_4P-L6.0-W6.0-P4.50-LS6.5 |  | K2-1102DP-J4SW-04 | 韩国韩荣 | C136680 | LCSC
25 | 2 | PM254V-11-22-H85 | U1A,U1B | HDR-TH_22P-P2.54-V-F |  | PM254V-11-22-H85 | XFCN(兴飞) | C46595983 | LCSC
26 | 2 | PM254V-11-08-H85 | U2A,U2B | HDR-TH_8P-P2.54-V-F |  | PM254V-11-08-H85 | XFCN(兴飞) | C46595973 | LCSC
27 | 2 | PM254V-11-04-H85 | U3,U4 | HDR-TH_4P-P2.54-V-F |  | PM254V-11-04-H85 | XFCN(兴飞) | C541851 | LCSC
