ZAN-Tech-bd/WRO_Rizwanul-Rafeeul-Luban/PCB design/station/fabrication/20261028-final/STATION_RAW_BOM_20261028.csv

No. | Quantity | Comment | Designator | Footprint | Value | Manufacturer Part | Manufacturer | Supplier Part | Supplier
1 | 1 | buzzer-12X9 | BZ1 | BUZ-TH_BD12.0-P7.60-D0.6-FD |  | buzzer-12X9 |  | C9900016920 | LCSC
2 | 1 | 1N5819-T | D1 | DO-41_BD2.4-L4.7-P8.70-D0.9-RD |  | 1N5819-T | DIODES(美台) | C526214 | LCSC
3 | 1 | B8B-XH-A(LF)(SN) | J1 | CONN-TH_B8B-XH-A-LF-SN |  | B8B-XH-A(LF)(SN) | JST | C157972 | LCSC
4 | 2 | B4B-XH-A(LF)(SN) | J2,J4 | CONN-TH_B4B-XH-A-LF-SN |  | B4B-XH-A(LF)(SN) | JST | C144395 | LCSC
5 | 1 | B3B-XH-A(LF)(SN) | J3 | CONN-TH_3P-P2.50_A2501WV2-3P |  | B3B-XH-A(LF)(SN) | JST | C144394 | LCSC
6 | 1 | BC557B-TA | Q1 | TO-92-3_L4.8-W3.7-P2.54-L |  | BC557B-TA | CJ(江苏长电/长晶) | C2093 | LCSC
7 | 1 | 1kΩ | R1 | RES-TH_BD2.4-L6.3-P10.30-D0.6 | 1kΩ | MFR-25FBF52-1K | YAGEO(国巨) | C1364484 | LCSC
8 | 1 | 68kΩ | R2 | RES-TH_BD2.4-L6.3-P10.30-D0.6 | 68kΩ | RN1/2WS68KΩFT/BA1 | Tyohm(幸亚电阻) | C385541 | LCSC
9 | 1 | 100kΩ | R3 | RES-TH_BD2.4-L6.3-P10.30-D0.6 | 100kΩ | MFR-25FBF52-100K | YAGEO(国巨) | C1364475 | LCSC
10 | 1 | PM254V-11-03-H85 | U2 | HDR-TH_3P-P2.54-V-F |  | PM254V-11-03-H85 | XFCN(兴飞) | C541850 | LCSC
