ZAN-Tech-bd/WRO_Rizwanul-Rafeeul-Luban/PCB design/scripts/hub/route/data/parts_map.png

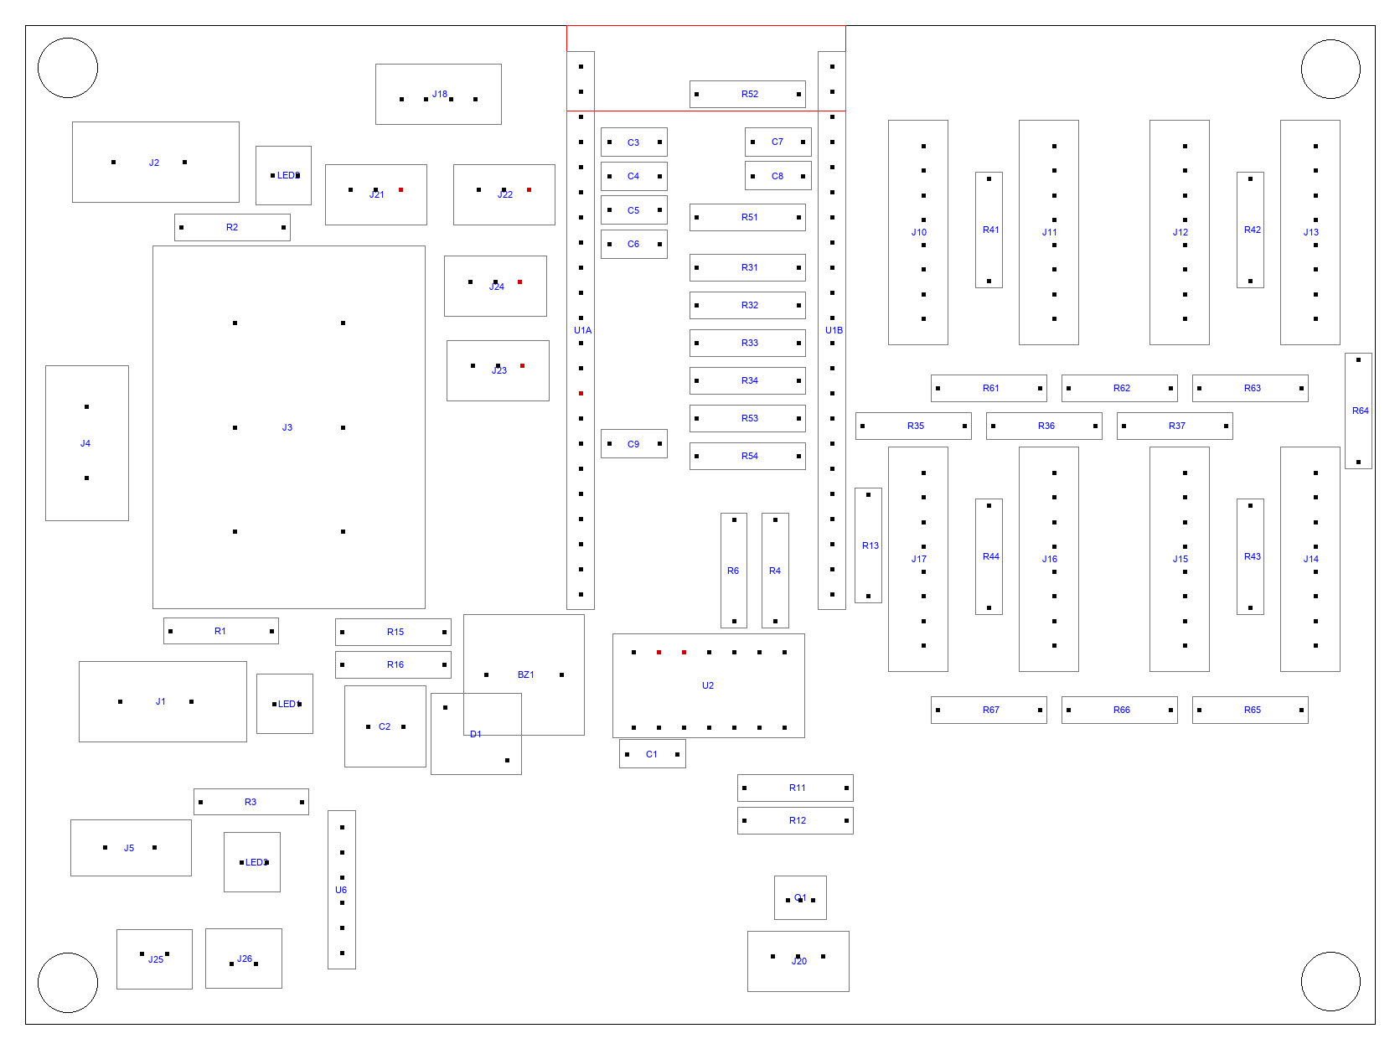
PCB design/scripts/hub/route/data/parts_map.png
