ZAN-Tech-bd/WRO_Rizwanul-Rafeeul-Luban/PCB design/hub/fabrication/20261028-after-user-edits/REVIEW.md

# Independent read-only package review

Reviewer task: `01a17ea0-72af-7127-b53a-53f4f6f2d3c8`. Review covered the saved native archives,
manufacturing ZIP, preservation and acceptance code, current schematic membership evidence and
release documentation. No PCB, library, rule, git state or order was modified by the reviewer.

## Assessment

**Accept as a two-layer, 1 oz prototype-geometry fabrication-review package.** Not unconditional
order approval or hardware qualification. The synchronization finding and physical qualification
gates remain disclosed in the [package README](README.md) and [full review](../../RELEASE-2026-10-28.md).

Independent read-only inspection confirmed:

- 86-document preservation result and the two body-identical track-ID substitutions.
- 2,331 GND fill pieces with **no floating fill-only islands**.
- Every current named schematic/native/live pin membership matches (256 pins).
- Correct orientation and geometry of all six actual plated slots.
- Correct Q1 1.114999 × 1.599999 mm apertures at all three pads on **both copper layers**.
- Packaged project identity, sealed-export equivalence and checksums; documentation links resolve.

## Important verification gaps fixed before final handoff

1. The older slot checker accepted a midpoint/diameter/length match without verifying orientation or
   one-to-one assignment. A new regression rejected a 90° rotated slot and reuse of one actual slot;
   both were observed failing before implementation. The current publisher matches complete capsule
   geometry bijectively against transformed native holes. It passes on the unchanged manufacturing ZIP.
2. The older connectivity report excluded fill-only islands from its disconnected-item list. A new
   counterexample was observed being incorrectly accepted. The acceptance gate now counts every fill
   outside the main GND component and rejects any such fill. Current output passes with zero floating pieces.

These are **acceptance-tool fixes**, not corrections to a defective current PCB. No design or Gerber
geometry changed during the fix pass. The Gerber SHA-256 remains
`635b4ea0df55e7bbf30bc4c5ff9775a5dbbc340205a2483ae0ec071df1698243`.

## Deferred minor automation improvements

- Compare document-header fields with a narrow save-time/version allowlist. The existing gate checks
  document identities and record bodies; independent inspection found only expected PCB save header changes.
- Automate proving that Q1's aperture is used at each pad on both faces, rather than only checking its
  presence in the top-copper text. Independent inspection already verified the actual current flashes
  on both faces, so this is a future checker improvement, not a current geometry hold.

## Not qualified by this review

The exact ECO synchronization cause, real switch fit/support/contact timing, transistor lead order,
module underside clearance, RF performance and ≈8 A drop/thermal behavior cannot be qualified from these
artifacts. The raw library aliases are disclosed; the BOM is not approved automated PCBA input.
