ZAN-Tech-bd/WRO_Rizwanul-Rafeeul-Luban/diagrams/02_board_wiring_map.png

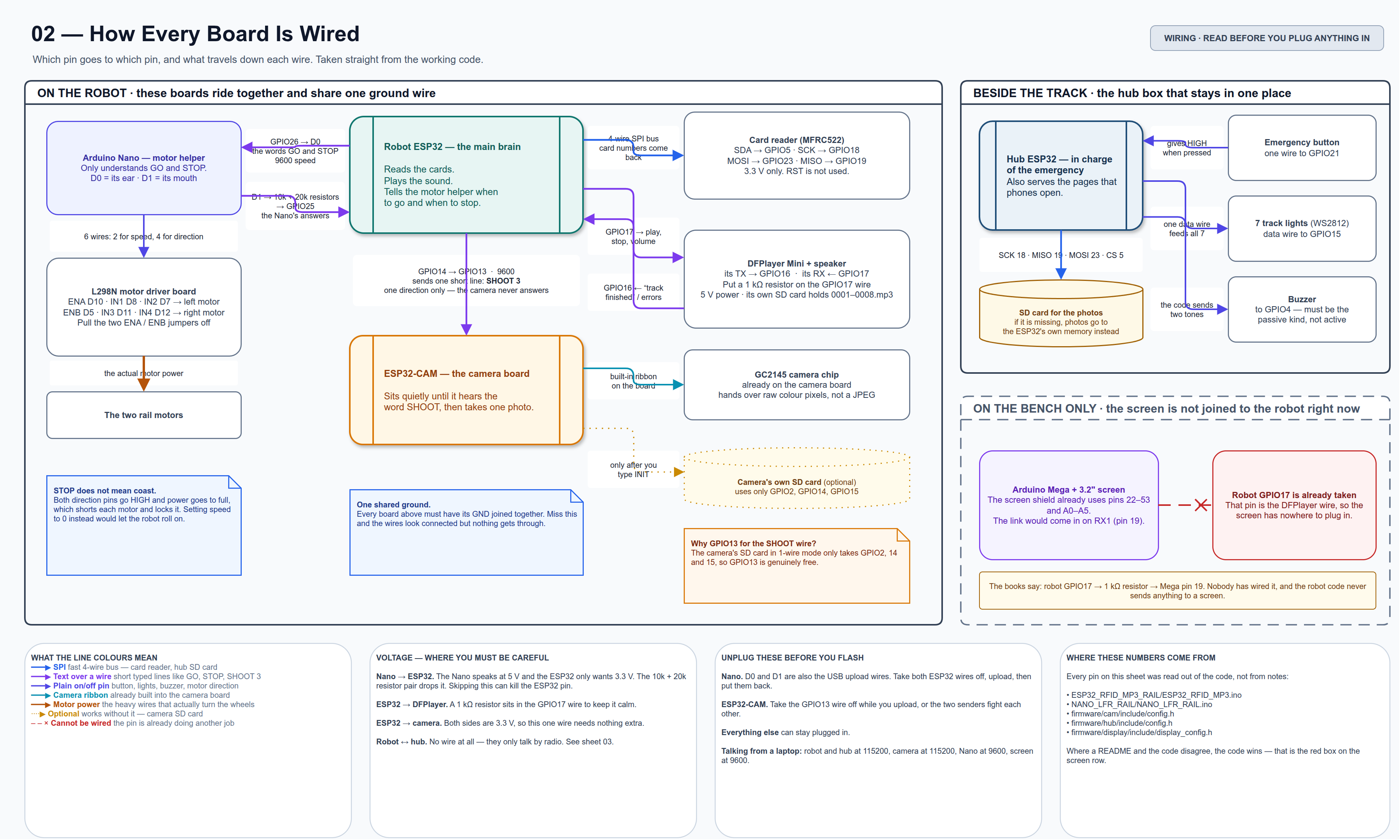
diagrams/02_board_wiring_map.png
