ZAN-Tech-bd/WRO_Rizwanul-Rafeeul-Luban/PCB design/Robot/robot_wiring diagram.png

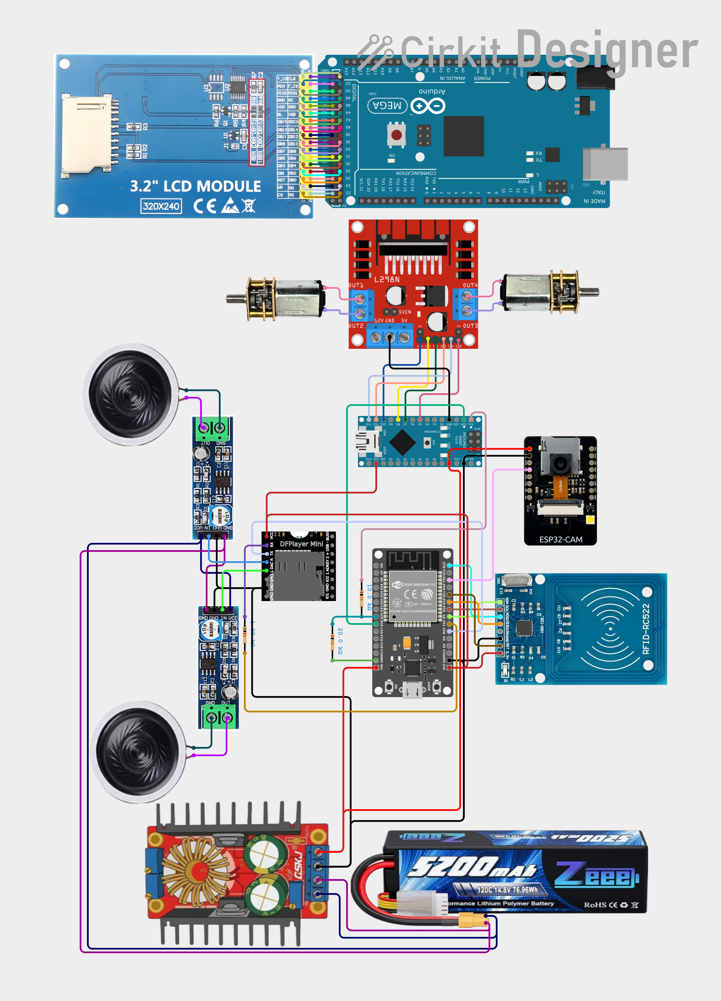
PCB design/Robot/robot_wiring diagram.png
