ZAN-Tech-bd/WRO_Rizwanul-Rafeeul-Luban/PCB design/scripts/station/data/manual_review_20261026/data/fill_preview.png

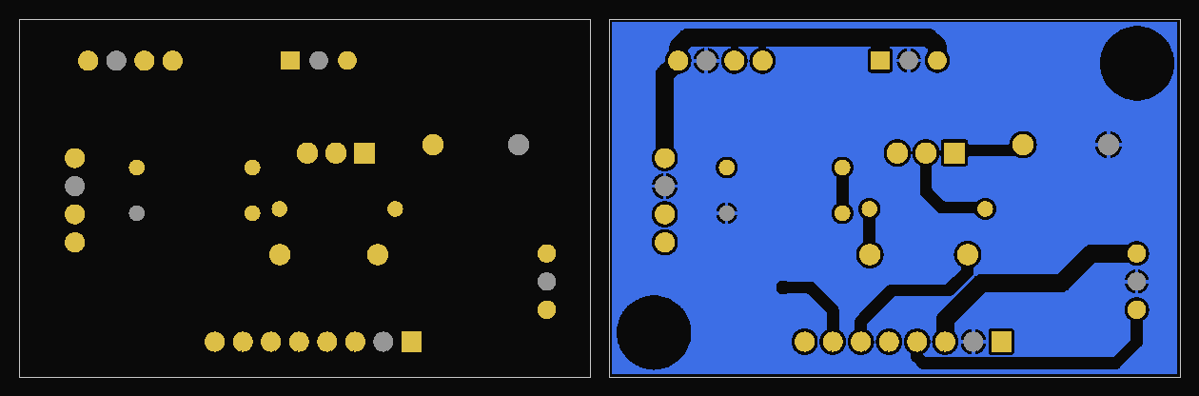
PCB design/scripts/station/data/manual_review_20261026/data/fill_preview.png
