ZAN-Tech-bd/WRO_Rizwanul-Rafeeul-Luban/PCB design/scripts/station/data/manual_review_20261026/editor_after_gnd.png

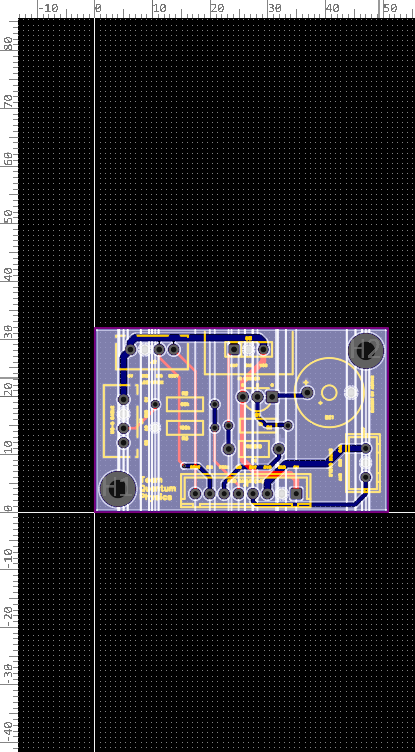
PCB design/scripts/station/data/manual_review_20261026/editor_after_gnd.png
