ZAN-Tech-bd/WRO_Rizwanul-Rafeeul-Luban/PCB design/hub/SYNC-FIX-2026-10-28.md

# Hub — Netlist Error resolved after silkscreen-image addition

## Confirmed cause and fix

The DRC Netlist Error was **25 stale J3 descriptive properties on the PCB**, not an electrical,
routing, footprint or image error. The schematic already held the corrected KCD4 values; the PCB
still had older row-spacing/pitch, supplier, material, dimensional and rating metadata.

The user opened the Import Changes comparison without applying it. The agent read the complete
dialog and verified all 25 entries were **Update Property / J3**, with no footprint, pad, route,
net, placement or image changes. A complete project backup was made before applying anything.
The user then unchecked **Also update track's net**, applied the reviewed properties and saved.

**Fresh strict PCB DRC: empty. Fresh schematic ERC: true, detailed findings empty.** The previous
generic synchronization finding is now resolved; older review reports describing it are historical.

## Saved-project proof

Before:
[WRO_HUB_REPAIRED_before_sync_fix_with_image_20261028-0222.epro2](WRO_HUB_REPAIRED_before_sync_fix_with_image_20261028-0222.epro2)

After:
[WRO_HUB_REPAIRED_after_sync_fix_with_image_20261028-0225.epro2](WRO_HUB_REPAIRED_after_sync_fix_with_image_20261028-0225.epro2)

The entire saved-project comparison has **exactly one changed native record**: J3's PCB COMPONENT
attributes. All25 changed fields match the reviewed list and the current schematic values.

Everything else is byte-identical at the native-record-body level, including:

- J3's position, rotation, six custom plated slots, footprint binding and all six pad-net assignments.
- Every other component, all tracks/vias/pad nets, the 2,331 GND fills and schematic/library records.
- The user's top-silkscreen image object and its embedded image resources.

The new copper, drill, outline and solder-mask Gerbers also match the earlier output after harmless
aperture-ID renumbering, unused aperture definitions and timestamp comments are normalized. This
comparison retains all actual used aperture geometry, drawing coordinates, polarity and macro data.

The verification script is [verify_j3_sync_20261028.py](../scripts/hub/verify_j3_sync_20261028.py).
No unsafe device-library operation, DRC-rule suppression, copper change or image conversion was used.
Final Hub suite:55tests,42passed,13explicit-fixture historical cases skipped. The new Gerber
comparison regression was observed failing first, then passing; the full suite is green.

## Current standard Gerber and image warning

- [New standard Gerber ZIP](fabrication/20261028-sync-fixed/WRO_HUB_GERBER_20261028_SYNC_FIXED.zip)
- [Matching complete project](fabrication/20261028-sync-fixed/WRO_HUB_PROJECT_20261028_SYNC_FIXED.epro2)
- [Verification report](fabrication/20261028-sync-fixed/SYNC-VERIFICATION.json)
- [Package instructions](fabrication/20261028-sync-fixed/README.md)

**The raster image is preserved in the project, but is not emitted as ordinary monochrome Gerber
silkscreen geometry in this export.** A read-only diagnostic exported only Image objects on layer3;
its GTO contains no drawable coordinates, flashes or regions. This separates preservation in the
editable project from inclusion in the fabrication output.

Do not order expecting the raster artwork to print from this standard ZIP. It needs a deliberate
monochrome/vector conversion or a verified supported color-silkscreen fabrication workflow. Neither
was authorized or performed during this DRC fix. Existing vector text/graphics are in the standard
Gerber; user artwork conversion may need a further visual/DFM review.

The raw BOM's J3 identity is KCD4-203-B; supplier fields now match the schematic rather than the old
placeholder supplier values. Underlying library footprint aliases and Q1's SS8050-versus-approved-
2N2222A alias still require the manual-assembly caveats in the prior geometry review. Hardware switch
fit/support/contact sequence, Q1 lead order and full-load thermal/drop qualification remain open.

## Reusable lesson

A generic Netlist Error can be caused entirely by descriptive attributes. Establish the exact ECO
differences first; never infer the cause merely because the pin map matches. A completely reviewed,
metadata-only ECO can be applied safely with full backups and before/after preservation checks.
That is different from blindly applying an import or standardizing a custom footprint back to a
catalog device. Similarly, a visible raster image in the PCB editor is not evidence that a normal
silkscreen Gerber contains it. Inspect the actual output.
