ZAN-Tech-bd/WRO_Rizwanul-Rafeeul-Luban/ESP32 CAM.pdf

# ESP32 Upload Issue

This is a copy of a shared ChatGPT conversation

## Today 12:54 AM

Sketch uses 1072537 bytes (34%) of program storage space. Maximum is 3145728 bytes.

## Global variables use 69456 bytes (21%) of dynamic memory, leaving 258224 bytes for local

variables. Maximum is 327680 bytes.

## esptool v5.3.0 Serial port /dev/cu.usbserial-110: Connecting |

A fatal error occurred: Failed to connect to ESP32: No serial data received.

## For troubleshooting steps visit: https://docs.espressif.com/projects/esptool/en/latest/troubleshooting.html Failed uploading: uploading error: exit status 2

### Show moreShow less

তোমার code compile ঠিকমতো হয়েছে। সমস্যা code-এ না—ESP32 upload/boot mode-এ ঢুকছে না অথবা serial

## communication হচ্ছে না। Error:

Failed to connect to ESP32: No serial data received.

মানে Mac /dev/cu.usbserial-110 port পাচ্ছে, কিন্তু ESP32 থেকে response পাচ্ছে না।

প্রথমে এই methodটা করো

## যদি তোমারটা সাধারণ ESP32-WROOM-32 DevKit হয়:

## 1. Arduino IDE → Tools → Board → ESP32 Arduino → ESP32 Dev Module

### 2. Tools → Port → /dev/cu.usbserial-110

## 3. Upload Speed → 115200 4. Upload (→) চাপো।

### 5. নিচে যখন দেখাবে:

Connecting........

## তখন ESP32-এর BOOT button চেপে ধরে রাখো। 6. BOOT ধরে রেখেই EN/RESET button একবার press করে ছেড়ে দাও। 7. BOOT এখনও ধরে রাখো। 8. Upload শুরু হয়ে Writing at... / percentage দেখালে BOOT ছেড়ে দাও।

## সঠিক হলে এরকম আসবে:

Connecting...
Chip is ESP32...
Printed using ChatGPT to PDF, (https://pdfcrowd.com/chatgpt-to-pdf/?ref=chatgpt) powered by PDFCrowd HTML to PDF API. (https://pdfcrowd.com/api/html-to-pdf-api/?ref=chatgpt) | 1/41

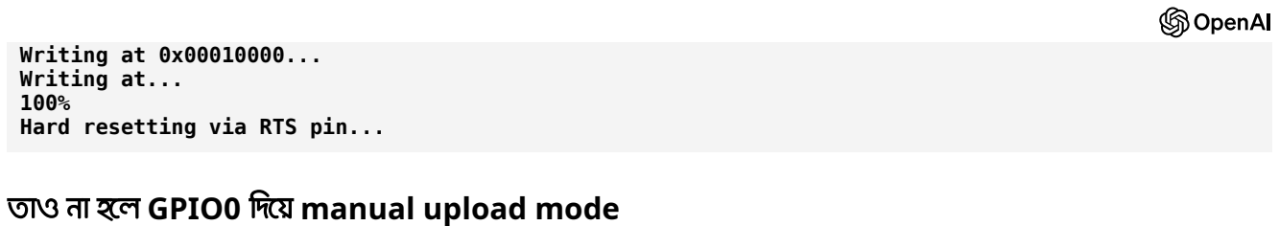
[picture p48: figure]
Writing at 0x00010000... Writing at... 100% Hard resetting via RTS pin...

# তা ও না হলে GPIO0 দি য়ে manual upload mode

## ESP32 power off/USB খুলে:

ESP32
GPIO0 -------- GND

## তারপর USB connect করো এবং Upload দাও। অর্থা ৎ upload-এর সময়:

GPIO0 = GND
│
└── ESP32 Download Mode

## Upload শেষ হলে GPIO0–GND connection খুলে EN/RESET চাপবে।

# যদি ESP32-CAM হয়

## ESP32-CAM-এর ক্ষেত্রে connection আলা দা:

USB-TTL / Programmer ESP32-CAM ----------------------------------
5V | → 5V
GND | → GND
TX | → U0R
RX | → U0T

GPIO0 ---------------- GND

খেয়াল রাখবে:

TX → RX
RX → TX

## তারপর GPIO0→GND রেখে reset দিয়ে upload করবে। Upload শেষ হলে GPIO0→GND খুলে reset দেবে।

একটা গুরুত্বপূর্ণ বিষয়: তোমার log দেখে USB serial adapter detect হচ্ছে, তাই driver/port পুরোপুরি missing মনে হচ্ছে না। এখন সবচেয়ে সম্ভাব্য কারণ হলো ESP32 download mode-এ না যাওয়া, TX/RX wiring সমস্যা (যদি external

## programmer ব্যবহার করো), অথবা power সমস্যা। Espressif-এর troubleshooting guide: ESP32 esptool troubleshooting

তুমি যদি ESP32-WROOM-32 board-এর একটা clear ছবি দাও এবং বলো USB cable দিয়ে direct নাকি Arduino

## UNO/USB-TTL দিয়ে upload করছ, আমি তোমাকে exact pin-to-pin connection দেখিয়ে দেব।

## ESP32-CAM-MB Type-C Download Module for ESP32 CAM modiul ta kine aneci

হ্যাঁ, তাহলে কাজটা অনেক সহজ। ESP32-CAM-MB Type-C Download Module থাকলে Arduino UNO বা আলাদা FTDI/USB-TTL লাগবে না। এই board-এ USB-to-Serial converter built-in থাকে এবং ESP32-CAM সরাসরি বসানো যায়।

Printed using ChatGPT to PDF, (https://pdfcrowd.com/chatgpt-to-pdf/?ref=chatgpt) powered by PDFCrowd HTML to PDF API. (https://pdfcrowd.com/api/html-to-pdf-api/?ref=chatgpt) | 2/41

## এখন এভা বে করো

## ESP32-CAM-টা CAM-MB board-এর socket-এ ঠিক orientation-এ বসাও। তারপর:

MacBook
│
│ USB Type-C cable
▼
ESP32-CAM-MB
│
▼
ESP32-CAM

## Arduino IDE-তে:

Tools → Board → ESP32 Arduino → AI Thinker ESP32-CAM

Tools → Port
→ /dev/cu.usbserial-110

Upload Speed
→ 115200

তারপর Upload চাপো।

## যদি আবার:

Connecting |
Failed to connect to ESP32

আসে, তাহলে ESP32-CAM-MB-এর IO0/BOOT/Download button থাকলে সেটা চেপে ধরে RST একবার press করে ছেড়ে

## দাও, তারপর BOOT/IO0 ছাড়ো। এই sequence ESP32-CAM-কে download mode-এ ঢোকায়।

গুরুত্বপূর্ণ

তোমার আগের error অনুযায়ী Mac ইতিমধ্যে :

Serial port /dev/cu.usbserial-110

## detect করছে। তাই নতুন CAM-MB লাগানোর পর Port আবার check করবে—port নাম বদলে যেতে পারে। আর অবশ্যই data-capable Type-C cable ব্যবহার করবে; শুধু charging cable হলে upload হবে না।

এখন তোমার ESP32-CAM + নতুন ESP32-CAM-MB একসাথে লাগানো অবস্থায় একটা clear ছবি দাও। আমি দেখে বলে দিতে পারব

## orientation ঠিক আছে কিনা এবং কোন button কখন চাপতে হবে।

Robotics BD Store+1 (https://store.roboticsbd.com/internet-of-things-iot/3602-esp32-cam-mb-type-c-download-module-for-esp32-cam-robotics-bangladesh.html)

Manuals++1 (https://manuals.plus/ja/asin/B0CMTVFCYD?utm_source=chatgpt.com)

Sketch uses 1072537 bytes (34%) of program storage space. Maximum is 3145728 bytes.

## Global variables use 69456 bytes (21%) of dynamic memory, leaving 258224 bytes for local

variables. Maximum is 327680 bytes.

## esptool v5.3.0 Serial port /dev/cu.usbserial-110: Connecting |

Printed using ChatGPT to PDF, (https://pdfcrowd.com/chatgpt-to-pdf/?ref=chatgpt) powered by PDFCrowd HTML to PDF API. (https://pdfcrowd.com/api/html-to-pdf-api/?ref=chatgpt) | 3/41

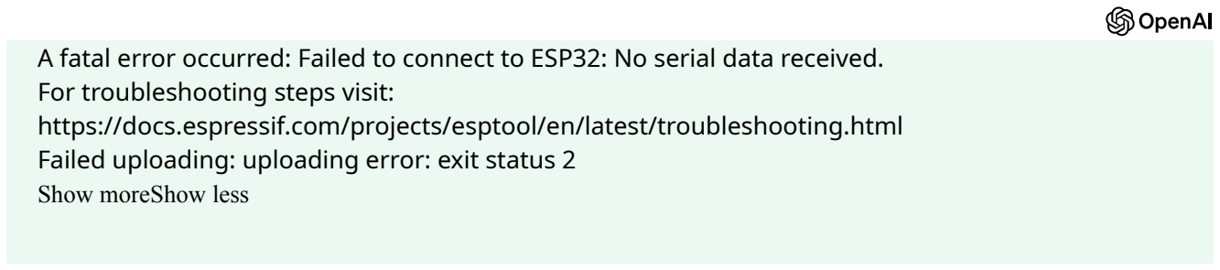
[picture p49: figure]
For troubleshooting steps visit:; Show moreShow less

A fatal error occurred: Failed to connect to ESP32: No serial data received.

## https://docs.espressif.com/projects/esptool/en/latest/troubleshooting.html Failed uploading: uploading error: exit status 2

হ্যাঁ—এখনও একই সমস্যা। Code compile হচ্ছে, port-ও detect হচ্ছে, কিন্তু ESP32-CAM download/flash mode-এ

## ঢুকছে না অথবা CAM-MB ↔ ESP32-CAM serial connection হচ্ছে না। ESP32-CAM-MB থাকলে আগে এই exact procedure করো।

# ১. Arduino IDE settings

Board: AI Thinker ESP32-CAM Port: /dev/cu.usbserial-110 Upload Speed: 115200
Flash Frequency: 40MHz
Flash Mode: QIO
Partition Scheme: Huge APP (3MB No OTA/1MB SPIFFS)

# ২. Upload-এর সময় এই sequence

## ESP32-CAM-MB Type-C দিয়ে Mac-এ connected রাখো। Arduino IDE-তে Upload চাপো।

## যখন:

Connecting |

## দেখাবে, তখন ESP32-CAM-এর RST button একবার চাপো। যদি না হয়, manual flash mode try করো :

IO0 → GND

## তারপর:

## 1. IO0 এবং GND short করো 2. RST একবার press করো 3. Arduino IDE → Upload

### 4. Upload শেষ হওয়া পর্যন্তর্য IO0→GND রাখো

## 5. Upload successful হলে IO0→GND খুলে ফেলো

### 6. আবার RST চাপো

## Successful হলে এরকম আসবে:

Connecting....
Chip is ESP32...
Writing at 0x00001000...
Writing at 0x00010000...
Printed using ChatGPT to PDF, (https://pdfcrowd.com/chatgpt-to-pdf/?ref=chatgpt) powered by PDFCrowd HTML to PDF API. (https://pdfcrowd.com/api/html-to-pdf-api/?ref=chatgpt) | 4/41

## Arduino IDE → Tools → Serial Monitor খোলো। Baud rate:

115200

## তারপর ESP32-CAM-এর RST button চাপো। দেখো Serial Monitor-এ কিছু আসে কিনা, যেমন:

rst:0x1 (POWERON_RESET)
boot:0x13 (SPI_FAST_FLASH_BOOT)

## অথবা

waiting for download

যদি RST চাপার পর Serial Monitor একদম blank থাকে, তাহলে সমস্যাটা code/Arduino IDE-এর হওয়ার সম্ভাবনা কম। তখন

সম্ভাব্য কারণ:

## ESP32-CAM CAM-MB-তে উল্টো/ভুলভাবে বসানো ESP32-CAM board faulty CAM-MB board faulty socket/pin contact হচ্ছে না ESP32-CAM power পাচ্ছে না USB cable/USB serial communication সমস্যা

Espressif-ও No serial data received-কে মূলত serial communication না পাওয়ার সমস্যা হিসেবে ব্যাখ্যা করে। Espressif esptool troubleshooting (https://docs.espressif.com/projects/esptool/en/latest/troubleshooting.html?utm_source=chatgpt.com)
এখন সবচেয়ে useful কাজ: ESP32-CAM-টা CAM-MB module-এ লাগানো অবস্থায় উপর থেকে একটা clear photo পাঠাও, যেন ESP32-CAM, CAM-MB, Type-C port এবং pins দেখা যায়। আমি ছবিতে দেখে connection/orientation ঠিক আছে কিনা

বলে দিতে পারব।

Printed using ChatGPT to PDF, (https://pdfcrowd.com/chatgpt-to-pdf/?ref=chatgpt) powered by PDFCrowd HTML to PDF API. (https://pdfcrowd.com/api/html-to-pdf-api/?ref=chatgpt) | 5/41

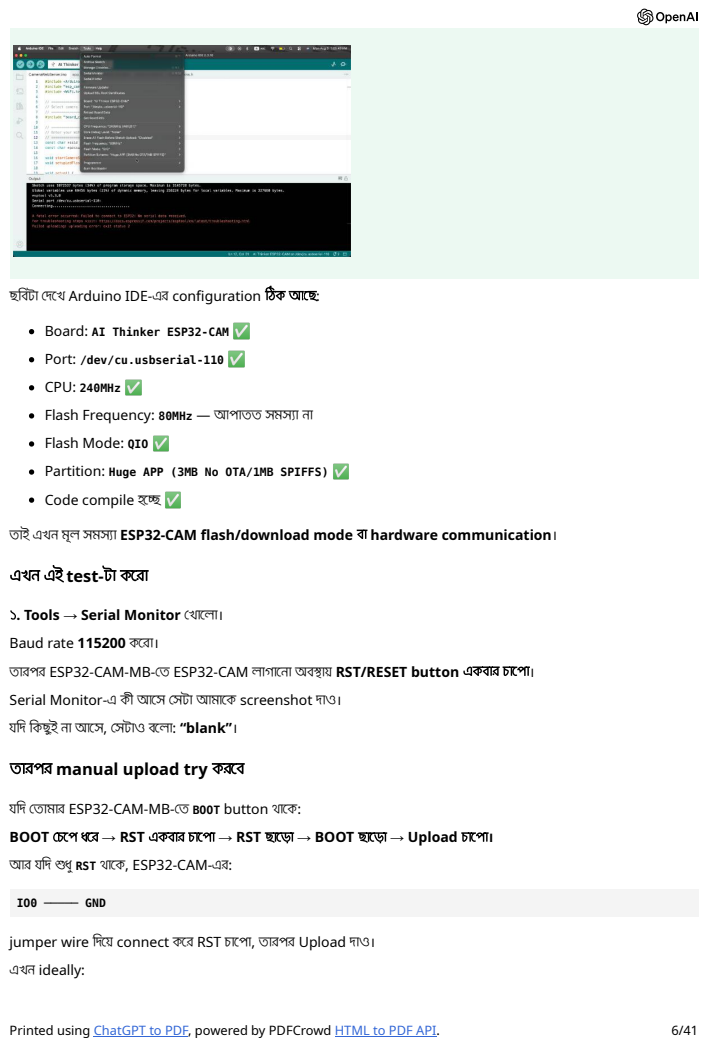
[picture p50: page 6]
Printed using ChatGPT to PDF, powered by PDFCrowd HTML to PDF API.

ছবিটা দেখে Arduino IDE-এর configuration ঠিক আছে:

Board: AI Thinker ESP32-CAM ✅

Port: /dev/cu.usbserial-110 ✅

CPU: 240MHz ✅
Flash Frequency: 80MHz — আপাতত সমস্যা না
Flash Mode: QIO ✅

Partition: Huge APP (3MB No OTA/1MB SPIFFS) ✅
Code compile হচ্ছে ✅
তাই এখন মূল সমস্যা ESP32-CAM flash/download mode বা hardware communication।
এখন এই test-টা করো

১. Tools → Serial Monitor খোলো।
Baud rate 115200 করো।
তারপর ESP32-CAM-MB-তে ESP32-CAM লাগানো অবস্থায় RST/RESET button একবার চাপো।
Serial Monitor-এ কী আসে সেটা আমাকে screenshot দাও।
যদি কিছুই না আসে, সেটাও বলো: “blank”।
তা রপর manual upload try করবে

যদি তোমার ESP32-CAM-MB-তে BOOT button থাকে:
BOOT চেপে ধরে → RST একবার চাপো → RST ছাড়ো → BOOT ছাড়ো → Upload চাপো।
আর যদি শুধু RST থাকে, ESP32-CAM-এর:

IO0 ───── GND
jumper wire দিয়ে connect করে RST চাপো, তারপর Upload দাও।
এখন ideally:

## আসা উচিত।

একটা জিনিস এখন সবচেয়ে দরকার: ESP32-CAM-টা ESP32-CAM-MB Type-C module-এর উপর লাগানো অবস্থার একটা ছবি পাঠাও। Arduino IDE-এর আর screenshot দরকার নেই। Board-এর দুই পাশের pin এবং Type-C connector দেখা গেলে আমি

## orientation/wiring-এ সমস্যা আছে কি না দেখে বলতে পারব।

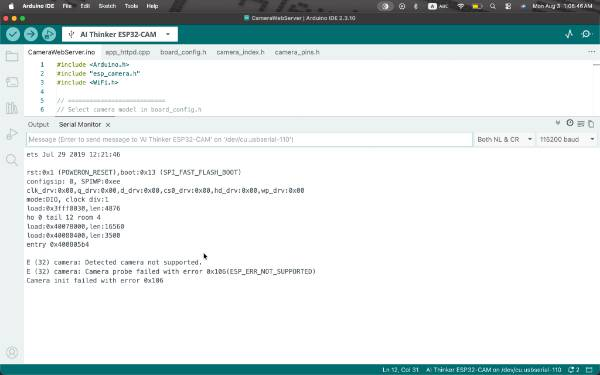
[picture p51: figure]

এটা খুব useful result। এখন বোঝা যাচ্ছে ESP32-CAM board alive এবং Serial communication কাজ করছে। 🎉

## Screenshot-এ:

rst:0x1 (POWERON_RESET)
boot:0x13 (SPI_FAST_FLASH_BOOT)

## মানে ESP32 ঠিকমতো boot করছে। কিন্তু এখন error:

E (32) camera: Detected camera not supported.
E (32) camera: Camera probe failed with error 0x106 (ESP_ERR_NOT_SUPPORTED)
Camera init failed with error 0x106

এটা আগের upload error-এর থেকে আলাদা সমস্যা। এখন ESP32 camera module-কে ঠিকমতো detect করতে পারছে না।

# প্রথমে camera ribbon cable check করো

USB খুলে power off করো। ESP32-CAM-এর camera ribbon cable connector থেকে carefully খুলে আবার ভালোভাবে

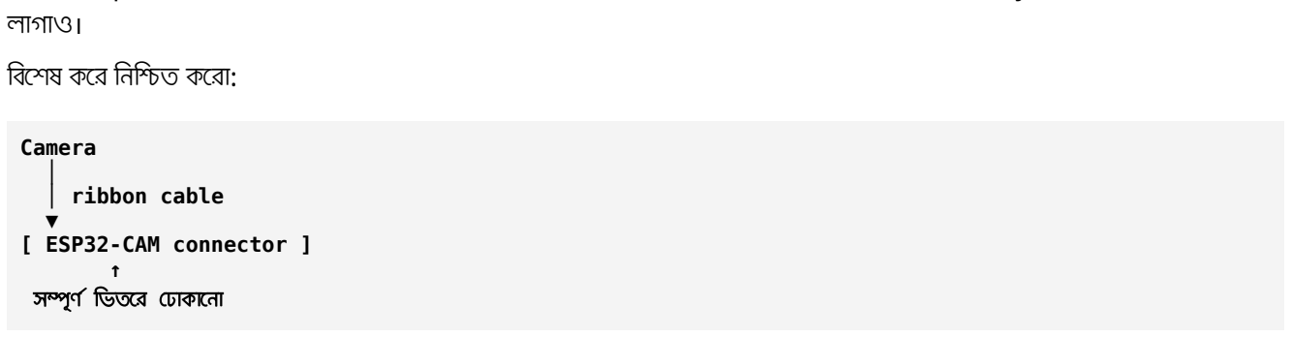
[picture p52: figure]
Camera │ │ ribbon cable ▼ [ ESP32-CAM connector ] ↑

## Ribbon cable একটু loose হলেও ঠিক এই ধরনের:

Printed using ChatGPT to PDF, (https://pdfcrowd.com/chatgpt-to-pdf/?ref=chatgpt) powered by PDFCrowd HTML to PDF API. (https://pdfcrowd.com/api/html-to-pdf-api/?ref=chatgpt) | 7/41

### তা রপর board_config.h check করো

## তোমার screenshot-এ board_config.h tab আছে।

সেটা open করো এবং camera model section খুঁজেখুঁ বের করো। সেখানে AI Thinker model selected থাকতে হবে।

## নতুন CameraWebServer example-এ সাধারণত এরকম configuration থাকবে:

C++
#define CAMERA_MODEL_AI_THINKER

## অন্য camera model যেন simultaneously enabled না থাকে। যেমন AI Thinker ESP32-CAM হলে চাই:

C++
#define CAMERA_MODEL_AI_THINKER

## তারপর আবার upload করতে হবে।

কি ন্তু একটা গুরুত্বপূর্ণ বি ষয়

## তোমার Serial Monitor দেখে বোঝা যাচ্ছে ESP32 এখন:

SPI_FAST_FLASH_BOOT

## mode-এ যাচ্ছে, অর্থা ৎ normal run mode। Upload করতে হলে boot log-এ download mode দরকার। তাই আগের:

Failed to connect to ESP32

সমস্যাটা এখনও আলাদাভাবে থাকতে পারে।

## ESP32-CAM-MB দিয়ে upload করার সময় দরকার হলে:

IO0 → GND
↓
Press RST
↓
Upload

## Successful connection হলে:

Connecting...
Chip is ESP32...

## আসবে।

Printed using ChatGPT to PDF, (https://pdfcrowd.com/chatgpt-to-pdf/?ref=chatgpt) powered by PDFCrowd HTML to PDF API. (https://pdfcrowd.com/api/html-to-pdf-api/?ref=chatgpt) | 8/41

এখন board_config.h tab-এ click করে screenshot পাঠাও। সেটা দেখলে তোমার CameraWebServer code-এ সঠিক

## camera model selected আছে কি না আমি সরাসরি বলে দিতে পারব।

## eita esp32s cam

বুঝলাম—তোমারটা ESP32S-CAM। এখানে একটা গুরুত্বপূর্ণ বিষয় হলো: Arduino IDE-তে AI Thinker ESP32-CAM board নির্বা চন করা অনেক ESP32S-CAM-এর ক্ষেত্রে ও ঠিক, কিন্তু camera model/pin configuration অবশ্যই তোমার module-এর

## camera hardware-এর সঙ্গে match করতে হবে।

তোমার Serial Monitor-এর এই অংশটা গুরুত্বপূর্ণ:র্ণ

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

এর মানে ESP32 নিজে চলছে এবং serial connection-ও চলছে, কিন্তু camera sensor detect হচ্ছে না/unsupported

## sensor detect হচ্ছে।

প্রথমে camera-র ছোট sensor board-এর গায়ে কী লেখা আছে দেখো। সাধারণ ESP32S-CAM-এ OV2640 থাকার কথা। যদি
OV2640 লেখা থাকে, তাহলে CameraWebServer example-এ board_config.h খুলে CAMERA_MODEL_AI_THINKER selected

রাখো:

C++
#define CAMERA_MODEL_AI_THINKER

## অন্য camera model define করা থাকলে সেটা comment করে দাও।

তারপর camera ribbon cable খুলে আবার শক্ত করে বসাও। Power/USB disconnect করে এটা করবে। Ribbon cable
উল্টো, loose বা পুরোপুরি socket-এর মধ্যে না ঢুকলে Camera probe failed আসতে পারে।
আর তোমার আগের upload সমস্যাটাও আমরা এখন narrow down করতে পেরেছি: Serial Monitor output আসছে মানে ESP32S-CAM এবং CAM-MB-এর serial path কাজ করছে। Upload-এর সময় শুধু board-টাকে download mode-এ নিতে হবে।
ESP32S-CAM board + camera-টার একটা clear ছবি পাঠাও, বিশেষ করে camera sensor-এর লেখা এবং ESP32S-CAM-
এর সামনের দিক। আমি দেখে তোমার exact camera model এবং কোন #define CAMERA_MODEL_... ব্যবহার করতে হবে বলে দেব।

## camera rebon a GC2145 lekha

## হ্যাঁ—এটাই আসল clue। তোমার camera OV2640 না, GC2145। ভালো খবর হলো, Espressif-এর বর্তমান esp32-camera driver-এ GC2145 support আছে।

কিন্তু GC2145-এর একটা গুরুত্বপূর্ণ পার্থক্য র্থ আছে: এটা native JPEG output support করে না। তাই standard CameraWebServer example-এর PIXFORMAT_JPEG configuration GC2145-এর জন্য সমস্যা করতে পারে। Driver নিজেও

## unsupported JPEG format হলে error দেয়।

তবে তোমার বর্তমান error:

Detected camera not supported.
Camera probe failed with error 0x106

## আরও আগে হচ্ছে—sensor detection stage-এ। অর্থা ৎ প্রথমে GC2145 detect করাতে হবে।

GitHub+1

GitHub (https://github.com/espressif/esp32-camera/blob/master/driver/esp_camera.c?utm_source=chatgpt.com)

Printed using ChatGPT to PDF, (https://pdfcrowd.com/chatgpt-to-pdf/?ref=chatgpt) powered by PDFCrowd HTML to PDF API. (https://pdfcrowd.com/api/html-to-pdf-api/?ref=chatgpt) | 9/41

প্রথমে board_config.h-এ:

C++
#define CAMERA_MODEL_AI_THINKER

রাখো, কারণ এটা মূলত ESP32-CAM board-এর GPIO pin mapping ঠিক করবে। Camera sensor GC2145 হওয়ায় এরপর

## code-এ JPEG-এর বদলে:

C++
config.pixel_format = PIXFORMAT_RGB565;

ব্যবহার করা লাগতে পারে।
GC2145 নিয়ে কাজ করা একটি community example-এও PIXFORMAT_RGB565, কম XCLK এবং ছোট frame size ব্যবহার করে

## সফল হওয়ার কথা বলা হয়েছে।

আমার মনে হয় standard CameraWebServer code modify করতে করতে ঝামেলা করার চেয়ে তোমার ESP32S-CAM +

## GC2145-এর জন্য একদম নতুন test code দিয়ে শুরু করা ভালো।

চাইলে আমি এখন তোমাকে GC2145 detect → ছবি capture → Serial Monitor-এ camera OK দেখাবে এমন minimum

## test code দিতে পারি; সেটা কাজ করলে তারপর Wi-Fi Web Server live camera code বানাব।

Reddit (https://www.reddit.com/r/esp32/comments/1ic6d8g?utm_source=chatgpt.com)

## ok daw

ঠিক আছে। প্রথমে GC2145 camera sensor detect হচ্ছে কি না সেটা test করি। যেহেতু তোমার board ESP32S-CAM এবং

## camera ribbon-এ GC2145 লেখা, নিচের minimal code upload করো ।

# GC2145 Camera Test Code

## Arduino IDE-তে নতুন sketch খুলে পুরো codeটা paste করো:

C++
#include "esp_camera.h"

// ========================================== // ESP32S-CAM / AI Thinker style PIN mapping // ==========================================

#define PWDN_GPIO_NUM | 32

#define RESET_GPIO_NUM | -1

#define XCLK_GPIO_NUM | 0

#define SIOD_GPIO_NUM | 26

#define SIOC_GPIO_NUM | 27

#define Y9_GPIO_NUM | 35

#define Y8_GPIO_NUM | 34

#define Y7_GPIO_NUM | 39

#define Y6_GPIO_NUM | 36

#define Y5_GPIO_NUM | 21

#define Y4_GPIO_NUM | 19

#define Y3_GPIO_NUM | 18

#define Y2_GPIO_NUM | 5

#define VSYNC_GPIO_NUM | 25

#define HREF_GPIO_NUM | 23

#define PCLK_GPIO_NUM | 22

void setup() {
Printed using ChatGPT to PDF, (https://pdfcrowd.com/chatgpt-to-pdf/?ref=chatgpt) powered by PDFCrowd HTML to PDF API. (https://pdfcrowd.com/api/html-to-pdf-api/?ref=chatgpt) | 10/41

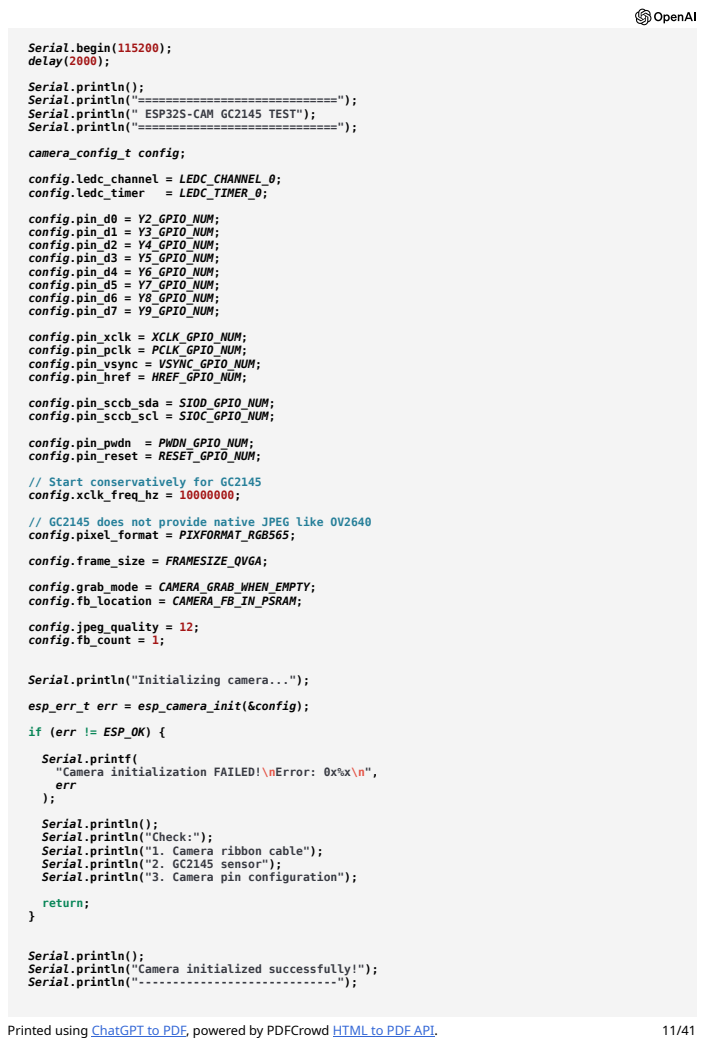
[picture p53: page 11]
Serial.begin(115200); delay(2000);; camera_config_t config;; config.ledc_channel = LEDC_CHANNEL_0;; config.ledc_timer; = LEDC_TIMER_0;; config.pin_d0 = Y2_GPIO_NUM; config.pin_d1 = Y3_GPIO_NUM; config.pin_d2 = Y4_GPIO_NUM; config.pin_d3 = Y5_GPIO_NUM; config.pin_d4 = Y6_GPIO_NUM; config.pin_d5 = Y7_GPIO_NUM; config.pin_d6 = Y8_GPIO_NUM; config.pin_d7 = Y9_GPIO_NUM;; config.pin_xclk = XCLK_GPIO_NUM; config.pin_pclk = PCLK_GPIO_NUM; config.pin_vsync = VSYNC_GPIO_NUM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

Serial.println();
Serial.println("=============================");
Serial.println(" ESP32S-CAM GC2145 TEST");

// Start conservatively for GC2145
config.xclk_freq_hz = 10000000;

// GC2145 does not provide native JPEG like OV2640
config.pixel_format = PIXFORMAT_RGB565;

Serial.println("Initializing camera...");

Serial.printf(
"Camera initialization FAILED!\nError: 0x%x\n",
err

Serial.println("Check:");
Serial.println("1. Camera ribbon cable");
Serial.println("2. GC2145 sensor");
Serial.println("3. Camera pin configuration");

Serial.println("Camera initialized successfully!");
Serial.println("-----------------------------");

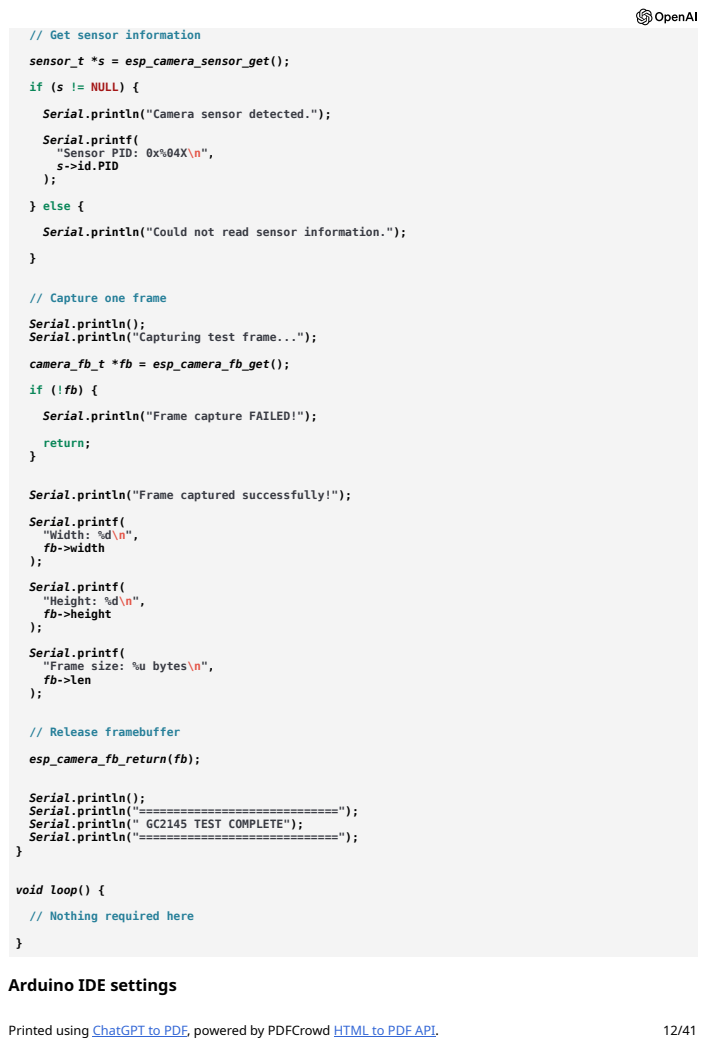
[picture p54: page 12]
sensor_t *s = esp_camera_sensor_get();; if (s != NULL) {; Serial.printf( "Sensor PID: 0x%04X\n", s->id.PID; } else {; camera_fb_t *fb = esp_camera_fb_get();; return;; Serial.printf( "Width: %d\n", fb->width; Serial.printf( "Height: %d\n", fb->height; // Release framebuffer; esp_camera_fb_return(fb);; void loop() {; Printed using ChatGPT to PDF, powered by PDFCrowd HTML to PDF API.

// Get sensor information

Serial.println("Camera sensor detected.");

Serial.println("Could not read sensor information.");

// Capture one frame

Serial.println();
Serial.println("Capturing test frame...");

Serial.println("Frame capture FAILED!");

Serial.println("Frame captured successfully!");

Serial.printf(
"Frame size: %u bytes\n",
fb->len

Serial.println("=============================");
Serial.println(" GC2145 TEST COMPLETE");

// Nothing required here

Arduino IDE settings

তোমার বর্তমান settings মোটামুটি ঠিক আছে। রাখো:

Board: AI Thinker ESP32-CAM
Port: /dev/cu.usbserial-110

CPU Frequency: 240MHz
Flash Mode: QIO
Partition Scheme: Huge APP

## Upload speed যদি option পাও:

115200

দাও।

# Upload করা র পরে

## Upload successful হলে Serial Monitor → 115200 baud করো এবং RST চাপো।

কাজ করলে এমন কিছু পাওয়ার কথা:

============================= ESP32S-CAM GC2145 TEST
=============================

Initializing camera...

Camera initialized successfully! -----------------------------Camera sensor detected.
Sensor PID: 0x....

Capturing test frame...

Frame captured successfully! Width: 320
Height: 240
Frame size: .... bytes

============================= GC2145 TEST COMPLETE
=============================

## যদি আবার:

Detected camera not supported
Camera probe failed with error 0x106

আসে, Serial Monitor-এর পুরো output screenshot পাঠাও। তখন আমরা driver version এবং GC2145 detection check করব—কারণ ওই অবস্থায় শুধু code পরিবর্তন না করে তোমার installed ESP32 Arduino core-এর esp32-camera

## version-ও দেখা দরকার।

আর যদি Camera initialized successfully! আসে, তাহলে পরের ধাপে তোমার GC2145-এর জন্য Wi-Fi Camera Web

## Server বানিয়ে দেব, যাতে Mac/phone browser থেকে camera image দেখা যায়।

Printed using ChatGPT to PDF, (https://pdfcrowd.com/chatgpt-to-pdf/?ref=chatgpt) powered by PDFCrowd HTML to PDF API. (https://pdfcrowd.com/api/html-to-pdf-api/?ref=chatgpt) | 13/41

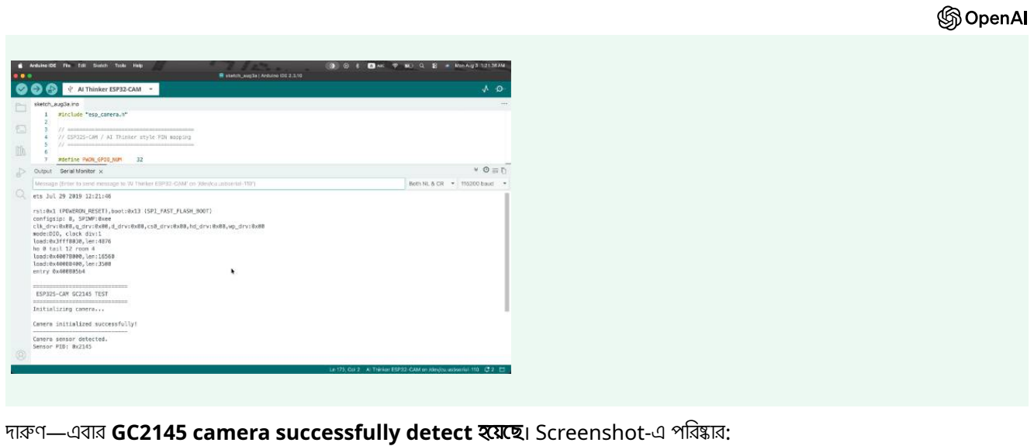
[picture p55: figure]

## দারুণ—এবার GC2145 camera successfully detect হয়েছে। Screenshot-এ পরিষ্কার:

ESP32S-CAM GC2145 TEST
Initializing camera...

Camera initialized successfully!

Camera sensor detected.
Sensor PID: 0x2145

PID: 0x2145 নিশ্চিত করছে sensor হচ্ছে GC2145। অর্থা ৎ ESP32S-CAM, camera ribbon connection, pin mapping

## এবং camera driver—সব কাজ করছে। ✅

এখন next step হলো Wi-Fi Camera Web Server বানানো, যাতে ESP32S-CAM Wi-Fi-তে connect হয়ে IP address দেয়

## এবং তুমি Mac/phone browser থেকে camera দেখতে পারো।

তোমার GC2145 native JPEG camera না হওয়ায় standard CameraWebServer example সরাসরি ব্যবহার না করে GC2145-

## compatible web server code করা ভালো।

চাইলে আমি এখন তোমাকে complete code দিতে পারি, যেখানে:

## ESP32S-CAM + GC2145 → Wi-Fi → IP Address → Browser → Camera View এবং চাইলে ESP32 নিজেই hotspot তৈরি করবে, তাই router/internet-ও লাগবে না।

## ok daw

অবশ্যই। যেহেতু তোমার GC2145 এখন successfully detect হচ্ছে (PID: 0x2145), এবার ESP32S-CAM নিজেই Wi-Fi hotspot তৈরি করবে। Phone/Mac সেই Wi-Fi-তে connect করে browser থেকে camera image দেখতে পারবে।

## GC2145 native JPEG দেয় না, তাই আমরা RGB565 capture করে ESP32-তেই JPEG-এ convert করব।

# ESP32S-CAM + GC2145 Wi-Fi Camera Server

## পুরো আগের code delete করে এটা paste করো:

C++
#include <WiFi.h>

#include <WebServer.h>

#include "esp_camera.h"

#include "img_converters.h"

Printed using ChatGPT to PDF, (https://pdfcrowd.com/chatgpt-to-pdf/?ref=chatgpt) powered by PDFCrowd HTML to PDF API. (https://pdfcrowd.com/api/html-to-pdf-api/?ref=chatgpt) | 14/41

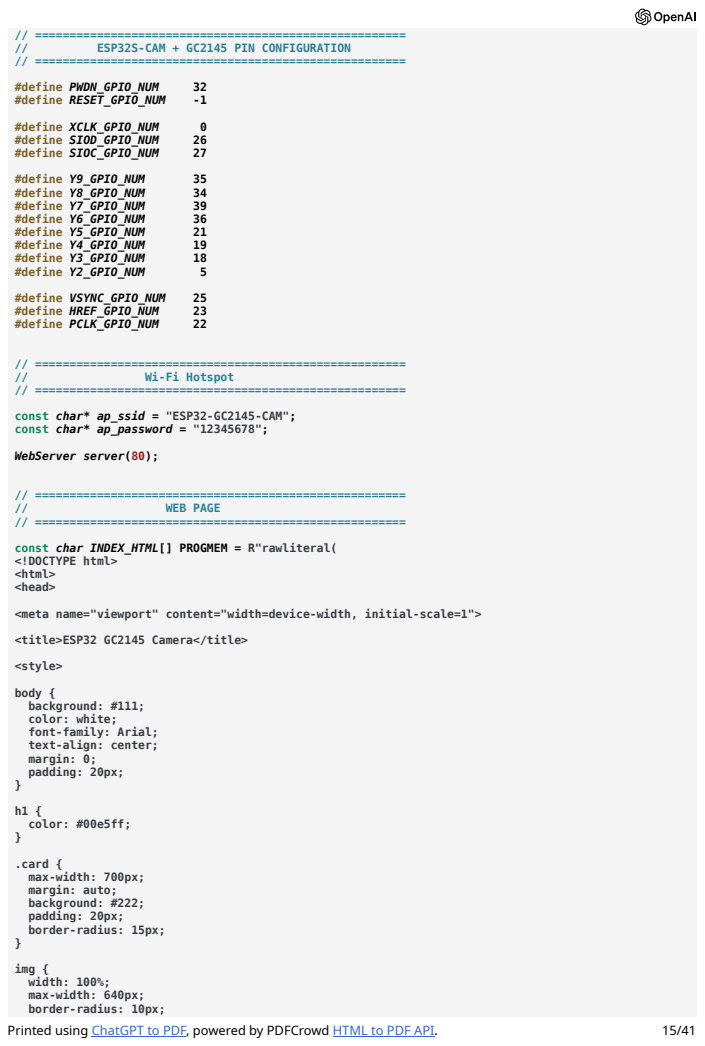
[picture p56: page 15]
ESP32S-CAM + GC2145 PIN CONFIGURATION; #define PWDN_GPIO_NUM; #define RESET_GPIO_NUM; #define XCLK_GPIO_NUM; #define SIOD_GPIO_NUM; #define SIOC_GPIO_NUM; #define Y9_GPIO_NUM; #define Y8_GPIO_NUM; #define Y7_GPIO_NUM; #define Y6_GPIO_NUM; #define Y5_GPIO_NUM; #define Y4_GPIO_NUM; #define Y3_GPIO_NUM; #define Y2_GPIO_NUM; #define VSYNC_GPIO_NUM; #define HREF_GPIO_NUM; #define PCLK_GPIO_NUM; Wi-Fi Hotspot; WebServer server(80);; WEB PAGE; <style>; h1 { color: #00e5ff;; .card { max-width: 700px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

const char* ap_ssid = "ESP32-GC2145-CAM";
const char* ap_password = "12345678";

const char INDEX_HTML[] PROGMEM = R"rawliteral(
<!DOCTYPE html>
<html>
<head>

<meta name="viewport" content="width=device-width, initial-scale=1">

<title>ESP32 GC2145 Camera</title>

body {
background: #111;
color: white;
font-family: Arial;
text-align: center;
margin: 0;
padding: 20px;

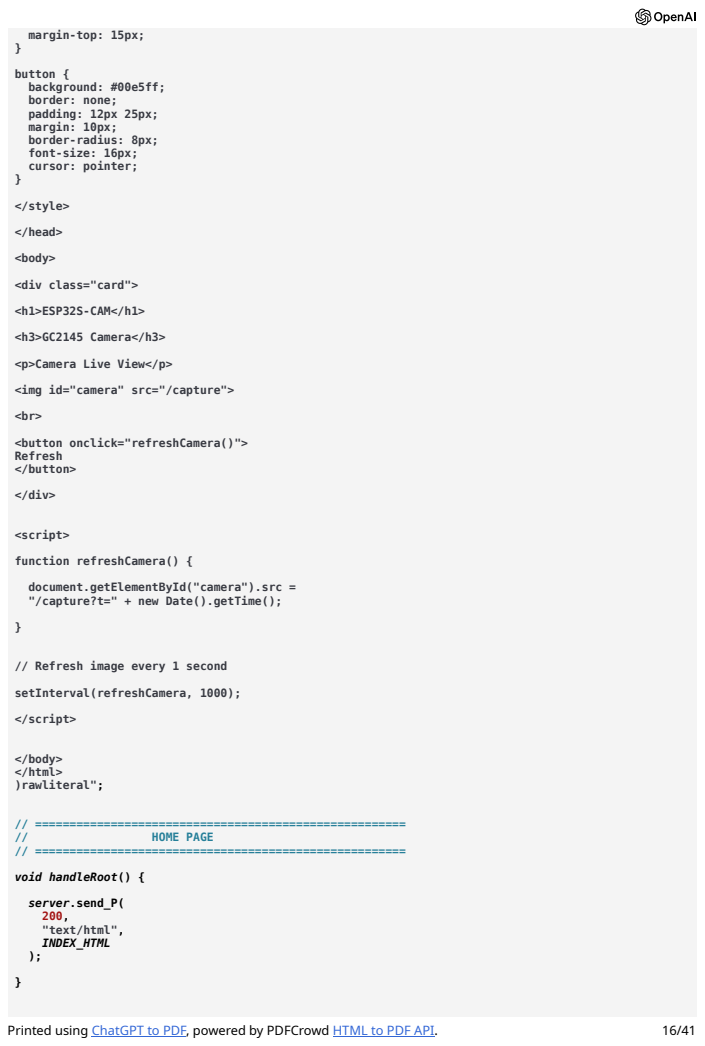
[picture p57: page 16]
margin-top: 15px;; button { background: #00e5ff; border: none; padding: 12px 25px; margin: 10px; border-radius: 8px; font-size: 16px; cursor: pointer;; </style>; </head>; <body>; <h1>ESP32S-CAM</h1>; <h3>GC2145 Camera</h3>; </div>; <script>; function refreshCamera() {; setInterval(refreshCamera, 1000);; </script>; </body> </html> )rawliteral";; HOME PAGE; void handleRoot() {; server.send_P( 200, "text/html", INDEX_HTML; Printed using ChatGPT to PDF, powered by PDFCrowd HTML to PDF API.

<div class="card">

<p>Camera Live View</p>

<img id="camera" src="/capture">

<button onclick="refreshCamera()">
Refresh
</button>

document.getElementById("camera").src =
"/capture?t=" + new Date().getTime();

// Refresh image every 1 second

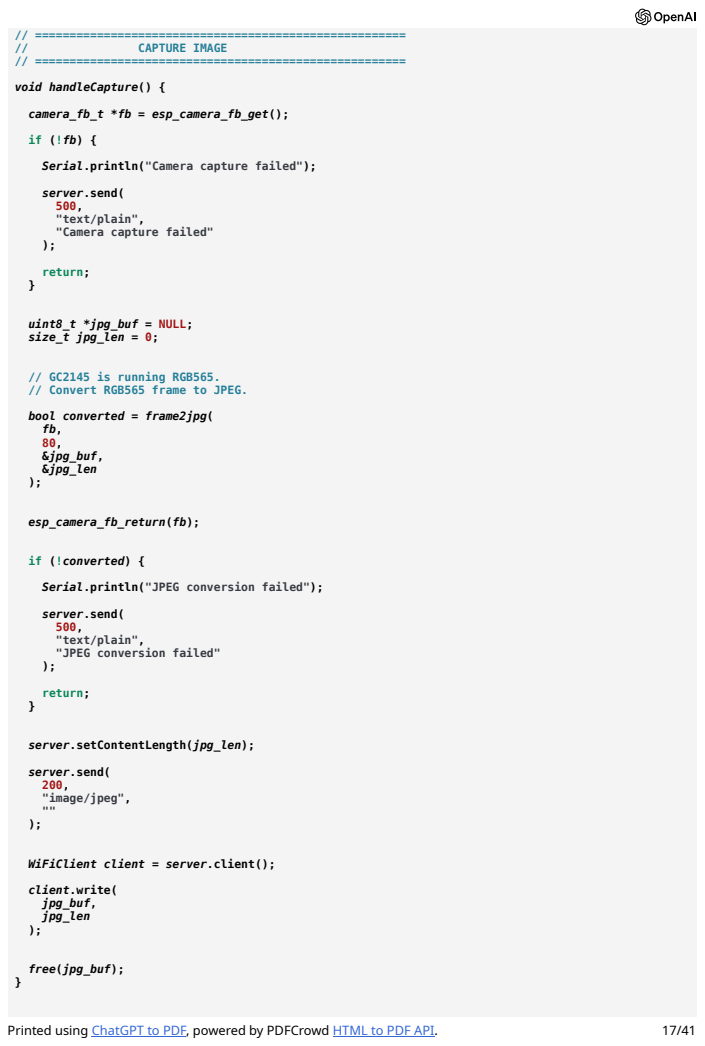
[picture p58: page 17]
CAPTURE IMAGE; void handleCapture() {; camera_fb_t *fb = esp_camera_fb_get();; server.send( 500, "text/plain", "Camera capture failed"; return;; uint8_t *jpg_buf = NULL; size_t jpg_len = 0;; bool converted = frame2jpg( fb, 80, &jpg_buf, &jpg_len; esp_camera_fb_return(fb);; if (!converted) {; server.send( 500, "text/plain", "JPEG conversion failed"; server.setContentLength(jpg_len);; server.send( 200, "image/jpeg", ""; client.write( jpg_buf, jpg_len );; free(jpg_buf);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

Serial.println("Camera capture failed");

// GC2145 is running RGB565.
// Convert RGB565 frame to JPEG.

Serial.println("JPEG conversion failed");

WiFiClient client = server.client();

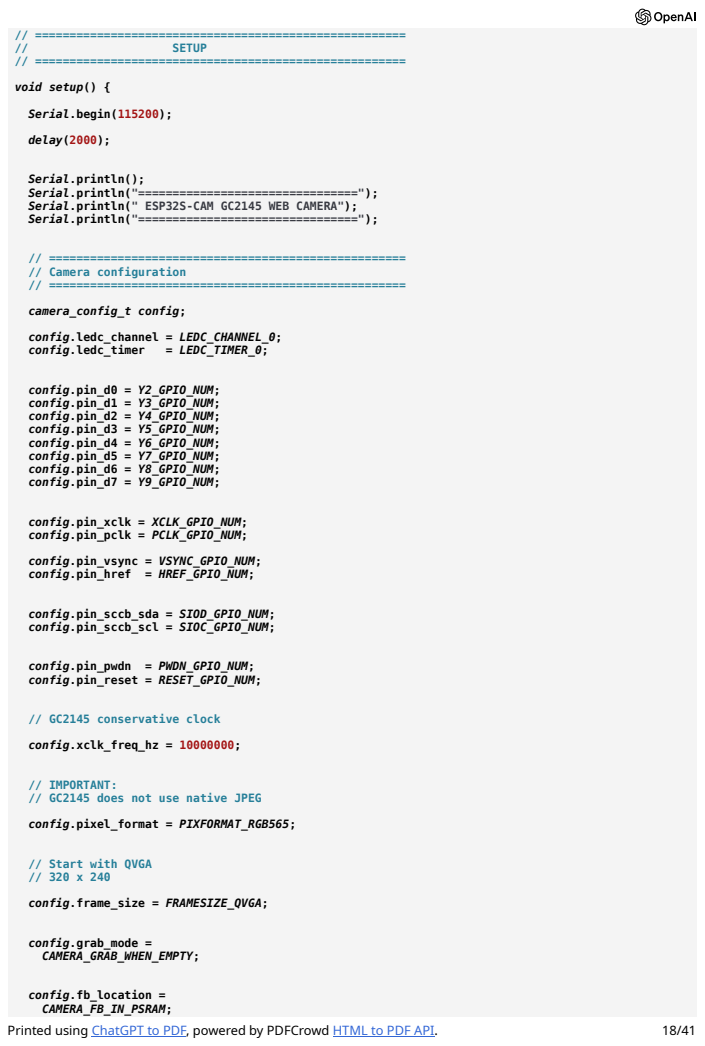
[picture p59: page 18]
SETUP; void setup() {; Serial.begin(115200);; delay(2000);; // ==================================================== // Camera configuration // ====================================================; camera_config_t config;; config.ledc_channel = LEDC_CHANNEL_0;; config.ledc_timer; = LEDC_TIMER_0;; config.pin_d0 = Y2_GPIO_NUM; config.pin_d1 = Y3_GPIO_NUM; config.pin_d2 = Y4_GPIO_NUM; config.pin_d3 = Y5_GPIO_NUM; config.pin_d4 = Y6_GPIO_NUM; config.pin_d5 = Y7_GPIO_NUM; config.pin_d6 = Y8_GPIO_NUM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

Serial.println();
Serial.println("================================");
Serial.println(" ESP32S-CAM GC2145 WEB CAMERA");

// IMPORTANT:
// GC2145 does not use native JPEG

// Start with QVGA

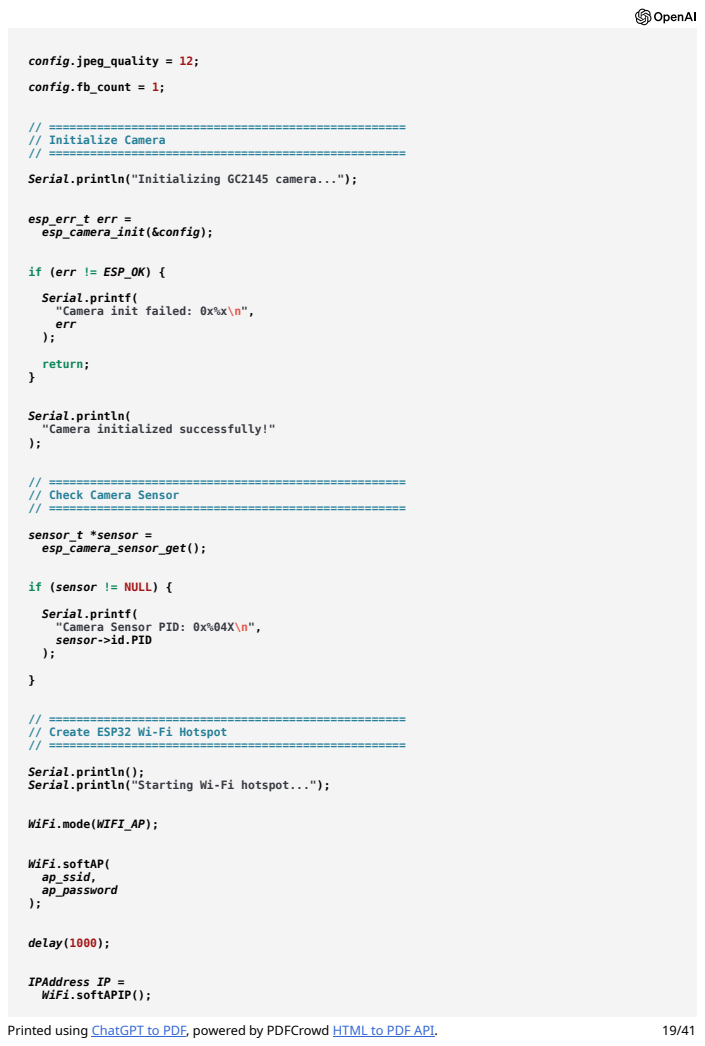
[picture p60: page 19]
config.jpeg_quality = 12;; config.fb_count = 1;; // ==================================================== // Initialize Camera // ====================================================; esp_err_t err = esp_camera_init(&config);; if (err != ESP_OK) {; return;; // ==================================================== // Check Camera Sensor // ====================================================; sensor_t *sensor = esp_camera_sensor_get();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

Serial.println("Initializing GC2145 camera...");

Serial.printf(
"Camera init failed: 0x%x\n",
err

Serial.println(
"Camera initialized successfully!"

if (sensor != NULL) {

"Camera Sensor PID: 0x%04X\n",
sensor->id.PID

Serial.println();
Serial.println("Starting Wi-Fi hotspot...");

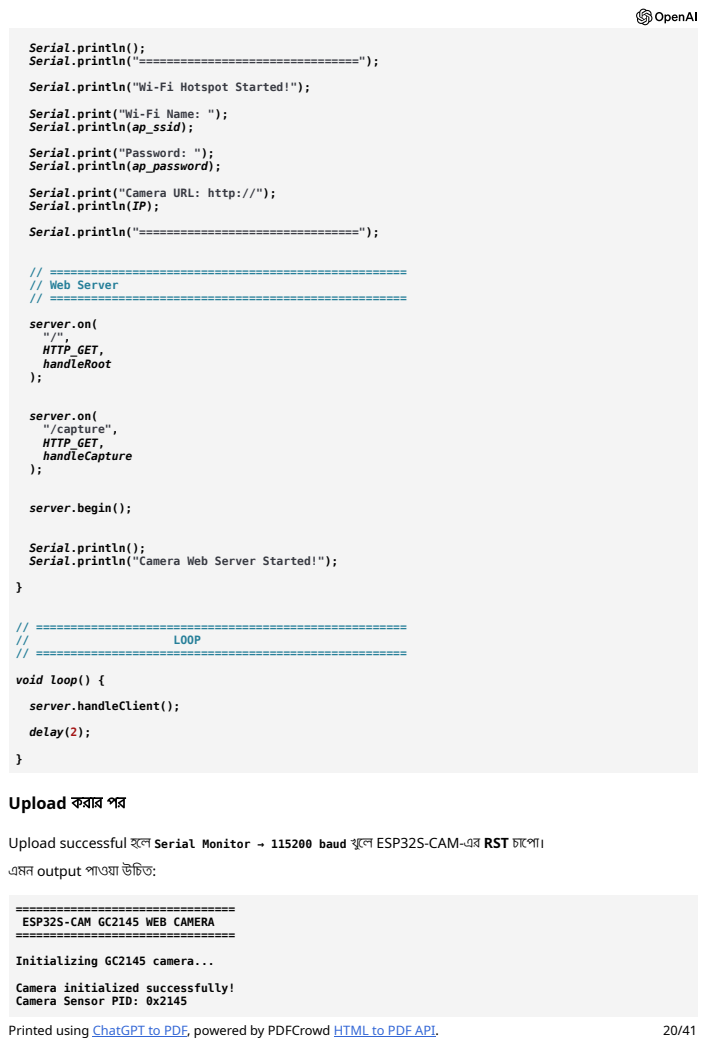
[picture p61: page 20]
Serial.println(); Serial.println("================================");; Serial.println("================================");; // ==================================================== // Web Server // ====================================================; server.on( "/", HTTP_GET, handleRoot; server.on( "/capture", HTTP_GET, handleCapture; server.begin();; LOOP; void loop() {; server.handleClient();; delay(2);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

Serial.println("Wi-Fi Hotspot Started!");

Serial.print("Wi-Fi Name: ");
Serial.println(ap_ssid);

Serial.print("Password: ");
Serial.println(ap_password);

Serial.print("Camera URL: http://");
Serial.println(IP);

Serial.println();
Serial.println("Camera Web Server Started!");

Upload করা র পর

Upload successful হলে Serial Monitor → 115200 baud খুলে ESP32S-CAM-এর RST চাপো।
এমন output পাওয়া উচিত:

Camera initialized successfully!
Camera Sensor PID: 0x2145

Starting Wi-Fi hotspot...

================================ Wi-Fi Hotspot Started!
Wi-Fi Name: ESP32-GC2145-CAM Password: 12345678
Camera URL: http://192.168.4.1================================

Camera Web Server Started!

## তারপর phone/Mac-এর Wi-Fi থেকে:

ESP32-GC2145-CAM

## connect করো। Password:

12345678

তারপর browser-এ http://192.168.4.1 লিখে ঢুকবে।

## এটা internet ছাড়াই হবে:

ESP32S-CAM
│
│ creates Wi-Fi
▼
ESP32-GC2145-CAM
│
│ Wi-Fi
▼
Phone / Mac
│
▼
192.168.4.1
│
▼
GC2145 Camera View

প্রথম test-এ QVGA (320×240) রেখেছি। কারণ GC2145 থেকে RGB565 frame নিয়ে ESP32-কে JPEG conversion করতে

## হচ্ছে; সরাসরি high resolution দিয়ে শুরু করলে memory/performance সমস্যা হতে পারে।

Code upload করে Serial Monitor-এর output পাঠাও। PID: 0x2145 এবং Camera Web Server Started! এলে তারপর

## আমরা actual live stream (MJPEG) এবং resolution/quality controls যোগ করতে পারি।

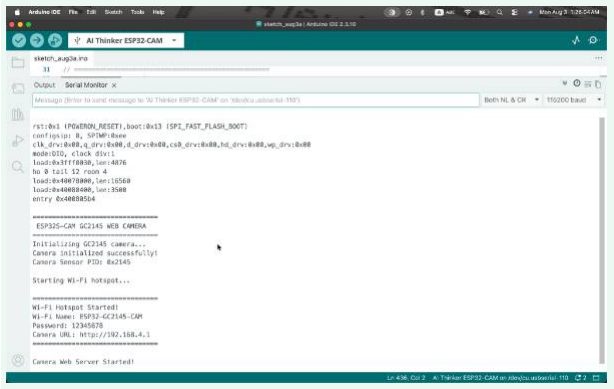
[picture p62: figure]

Printed using ChatGPT to PDF, (https://pdfcrowd.com/chatgpt-to-pdf/?ref=chatgpt) powered by PDFCrowd HTML to PDF API. (https://pdfcrowd.com/api/html-to-pdf-api/?ref=chatgpt) | 21/41

## Perfect! 🎉 Screenshot অনুযায়ী পুরো system এখন ঠিকমতো চলছে।

Camera initialized successfully! ✅
Camera Sensor PID: 0x2145 | ✅
Wi-Fi Hotspot Started! | ✅
Wi-Fi Name: ESP32-GC2145-CAM Password: 12345678

Camera URL: http://192.168.4.1

Camera Web Server Started! ✅

এখন ESP32 থেকে USB খুলবে না। এরপর:

## 1. Phone/Mac-এর Wi-Fi Settings খোলো।

### 2. ESP32-GC2145-CAM-এ connect করো।

## 3. Password দাও: 12345678

4. “No Internet Connection” দেখালে চি ন্তার কিছু নেই—ESP32 নিজেই local Wi-Fi network বানিয়েছে।

## 5. Safari/Chrome খুলে address bar-এ http://192.168.4.1 লিখে Enter দাও।

## তখন camera page আসার কথা এবং প্রতি ১ সেকেন্ডে নতুন image refresh হবে।

এখন 192.168.4.1 open করে কী দেখাচ্ছে তার screenshot পাঠাও। যদি image না আসে/ভাঙা image icon আসে, তাহলে

## /capture JPEG conversion অংশটা আমরা ঠিক করব।

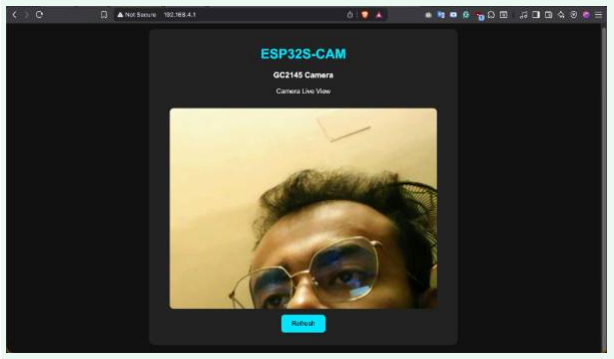
[picture p63: figure]

## Yes! 🎉 এটা এখন পুরোপুরি কাজ করছে।

## Screenshot থেকে দেখা যাচ্ছে:

192.168.4.1 web server চলছে ✅

## GC2145 image capture করছে ✅ RGB565 → JPEG conversion কাজ করছে ✅ Browser image receive করছে ✅ ESP32 hotspot কাজ করছে ✅ Auto-refresh system-ও চলছে ✅

তবে এটা এখন technically live video stream না—প্রতি ১ সেকেন্ডে নতুন ছবি /capture থেকে load হচ্ছে।

Printed using ChatGPT to PDF, (https://pdfcrowd.com/chatgpt-to-pdf/?ref=chatgpt) powered by PDFCrowd HTML to PDF API. (https://pdfcrowd.com/api/html-to-pdf-api/?ref=chatgpt) | 22/41

## পরের ধাপে আমরা এটাকে proper live camera করতে পারি:

GC2145
↓
RGB565 Capture
↓
JPEG Conversion
↓
MJPEG Stream
↓
Wi-Fi
↓
Browser
↓
LIVE VIDEO 📹

## সাথে web page-এ Live Stream / Stop Stream / Capture Photo / Resolution / Image Quality / Brightness / Contrast / Flip / Mirror control-ও দিতে পারি।

তোমার বর্তমান setup stable হওয়ায় আমি পরের code-টা এই working configuration-এর উপরেই বানাব, যাতে GC2145 PID

## 0x2145 support নষ্ট না হয়।

## ok do it

চলো, এবার তোমার working ESP32S-CAM + GC2145 setup-কে proper camera dashboard বানাই। নিচের code-এ থাকবে MJPEG Live Stream, Stop/Start, Capture Photo, resolution, JPEG quality, brightness, contrast,
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
