ZAN-Tech-bd/WRO_Rizwanul-Rafeeul-Luban/(list of files, drawings)

Other design files:
ESP32_RFID_MP3_RAIL/arduino_libraries/RFID_MFRC522v2/doc/fritzing/Arduino-Uno-r3-with-RFID-RC522.fzz
PCB design/scripts/hub/data/final_review_20261027/schematic_before.json
PCB design/scripts/hub/data/pcb_inventory_unplaced.json
PCB design/scripts/hub/data/pcb_inventory_v04_import.json
PCB design/scripts/hub/data/sb_removal_20261026/schematic_deletion.json
PCB design/scripts/hub/data/sb_removal_20261026/schematic_stub_manifest.json
PCB design/scripts/hub/data/sch_check_v04.json
PCB design/scripts/hub/data/sch_check_xt.json
PCB design/scripts/hub/data/sch_live_v03.json
PCB design/scripts/robot/data/pcb_inventory_import.json
PCB design/scripts/robot/data/pcb_inventory_now.json
PCB design/scripts/robot/data/pcb_inventory_placed.json
PCB design/scripts/robot/data/pcb_inventory_placed_v04.json
PCB design/scripts/robot/data/pcb_inventory_placed_v05.json
PCB design/scripts/robot/data/pcb_inventory_v05_import.json
PCB design/scripts/robot/data/pcb_inventory_v06_placed.json
PCB design/scripts/robot/data/sch_check_v04.json
PCB design/scripts/robot/data/sch_check_v05.json
PCB design/scripts/robot/data/sch_check_v06.json
PCB design/scripts/station/data/pcb_inventory_import.json
PCB design/scripts/station/data/pcb_inventory_placed.json
PCB design/scripts/station/data/pcb_inventory_redesign_20261026.json
PCB design/scripts/station/data/pcb_inventory_v04_import.json
PCB design/scripts/station/data/sch_check_v03.json
PCB design/scripts/station/data/sch_check_v04.json
