ZAN-Tech-bd/WRO_Rizwanul-Rafeeul-Luban/(commit log)

2026-07-31 Initial commit: Smart Museum Guidance System (WRO 2025 Future Innovators)
    Adds firmware (hub, robot, camera, emergency, health nodes over ESP-NOW), offline webapp (admin + visitor portals), QR generation tooling, build/plan docs, and WRO 2025 rulebooks.
2026-08-04 Add audio, display, sdcard & cam firmware modules; hub PhotoStore + web assets
    Firmware:
    - New modules: audio (DFPlayer), display (robot face), sdcard, cam config
    - Hub: PhotoStore (LittleFS photo capture/storage), updated MuseumState & config
    - CAM: config + refactored main loop
    Web assets:
    - Hub data: admin/visitor/index HTML, CSS, and JS (data/hub/qr) + jsQR vendor
    - Webapp: refreshed admin/index HTML, CSS, and JS
    Tooling:
    - DFPlayer audio track generator + 14 generated MP3 tracks with SHA256/TRACK_MAP
    - tools/generate_qr.py supporting libraries
    Docs & planning:
    - BUILD_PLAN, task_plan, findings, progress, CLAUDE_RECOMMENDATIONS
    - Vendored SmilingRobotFace display reference (with PROVE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
    [TRACK_MAP.csv]
2026-08-06 Add robot-esp/robot-nano firmware, wiring plans, and RobotUartProtocol
    - Add ESP32 line-follower robot firmware (ESP32_LFR)
    - Add robot-esp and robot-nano PlatformIO environments with UART protocol
    - Add RobotUartProtocol.h shared header
    - Add hub-sensor, robot, and robot-nano-esp wiring plans
    - Update progress, findings, and task tracking docs
2026-08-07 Add ESP32 MP3/RFID-MP3 and NANO LFR sketches; update planning docs
    - ESP32_MP3_LFR: DFPlayer-based audio line-follower sketch
    - ESP32_RFID_MP3: RFID-triggered MP3 playback sketch + README
    - NANO_LFR: Arduino Nano line-follower sketch
    - findings.md, progress.md, task_plan.md: latest status notes
2026-08-08 ESP32_RFID_MP3: map RFID cards to DFPlayer tracks 2-8 (reserve 0001.mp3 for tour start)
2026-08-08 Add ESP32_RFID_MP3_LFR module; update RFID sketch, README, and NANO LFR
    - ESP32_RFID_MP3_LFR: new combined RFID + MP3 line-follower sketch (ino + platformio.ini + README)
    - ESP32_RFID_MP3: sketch/README refinements
    - NANO_LFR: sketch updates
2026-08-09 LFR: dead-band floor, live tuning over UART, ESP32 tuner page
    The line follower stalled on every turn because tuned speeds were
    percent-scaled into the motors' dead band: PWM -> wheel RPM is flat zero
    below the start threshold, so a commanded inner wheel of 27 (6 on sharp
    turns) was executed as 0.
    Nano:
    - apply a min_drive floor to every non-zero wheel command
    - steer from the outer sensors instead of the weighted centroid, so a
    corner lighting four sensors no longer averages back to "centred"
    - sharp turns reverse the inner wheel; 4-wheel skid steer cannot rotate
    on a merely-slower inner wheel
    - make search/junction inner sides tunable rather than a hardcoded
    counter-rotation, which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
2026-08-09 LFR: rail-test mode for drivetrain characterisation
    The chassis cannot rotate in place, so the track is being rebuilt with
    curves instead. Before that, the drivetrain needs measuring directly
    rather than inferring it from line-following misbehaviour.
    Nano: MAN mode drives each side at a fixed PWM (ML/MR) with the sensors
    read but ignored. Deliberately bypasses the min_drive floor -- a
    characterisation rig must report what was asked for, not a corrected
    value. STOP/START leave manual mode.
    ESP32: /rail page with per-side PWM, +/-1 and +/-5 steps, and a
    MATCH L=R button. Setting ML != MR makes the robot trace a circle, so
    the minimum curve radius can be measured directly instead of guessed.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
2026-08-10 Add RFID rail audio stop and resume control
2026-08-10 Add rail camera trigger and field console
2026-08-13 Add OTA hub firmware, LED test, diagrams, and rail control updates
    - Add firmware/hub-ota: BLE OTA hub with sensors, photo store, admin/visitor UI
    - Add firmware/ledtest: WS2812 LED test harness
    - Add diagrams/: system architecture, wiring, sequences, states (drawio + png)
    - Add ESP32_RFID_MP3_RAIL: control page, EspNow/MuseumProtocol headers
    - Update firmware/hub: admin UI, config, hub JS/data, photo handling
    - Sync webapp UI with hub admin/data/hub JS
    - Add PSEUDOCODE.md, ACTUAL ONE.md, update findings/progress/task_plan
    - Move EspNowCompat.h into firmware/common
    [partitions.csv]
2026-08-16 Fix nested repo, prune iteration sketches, ship final codebase
    - Un-nest vendored RFID_MFRC522v2 library (remove its .git, also under .pio/libdeps) so VS Code checkpoints work again; library files are now tracked as plain vendored sources
    - Add bundled Arduino IDE libraries, sketch bundle and INSTALL notes for ESP32_RFID_MP3_RAIL
    - Remove superseded build-process projects: NANO_LFR, ESP32_LFR, NANO_RAIL, ESP32_MP3_LFR, ESP32_RFID_MONITOR, ESP32_RFID_MP3, ESP32_RFID_MP3_LFR, Emergency_Switch, firmware/{audio,emergency,health,hub-ota,ledtest,robot,robot-esp,robot-nano,sdcard}
    - Keep final codebase: firmware/{hub,cam,display,common}, ESP32_RFID_MP3_RAIL, NANO_LFR_RAIL + all documentation, webap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
    [Arduino-Uno-r3-with-RFID-RC522.fzz, partitions.csv]
2026-11-01 Add PCB design workspace, JLCPCB exports, EasyEDA bridge tooling
    - Station + hub PCB scripts, specs, wiring plans, and EasyEDA Pro project files, kept as-is
    - Fabrication exports: hub gerber/BOM 20261027, station final package 20261028
    - tools/easyeda-bridge helper CLI, JLCPCB workflow plan; ignore local tool state (.playwright-mcp/, .roo/)
    [Drill_PTH_Through.DRL, Drill_PTH_Through_Via.DRL, Gerber_BoardOutlineLayer.GKO, Gerber_BottomLayer.GBL, Gerber_BottomSilkscreenLayer.GBO, Gerber_BottomSolderMaskLayer.GBS, Gerber_TopLayer.GTL, Gerber_TopSilkscreenLayer.GTO]
